asm17-moving-agent/cleany/docs/presentation-design/references/reference-03-blue-ir-layouts.png

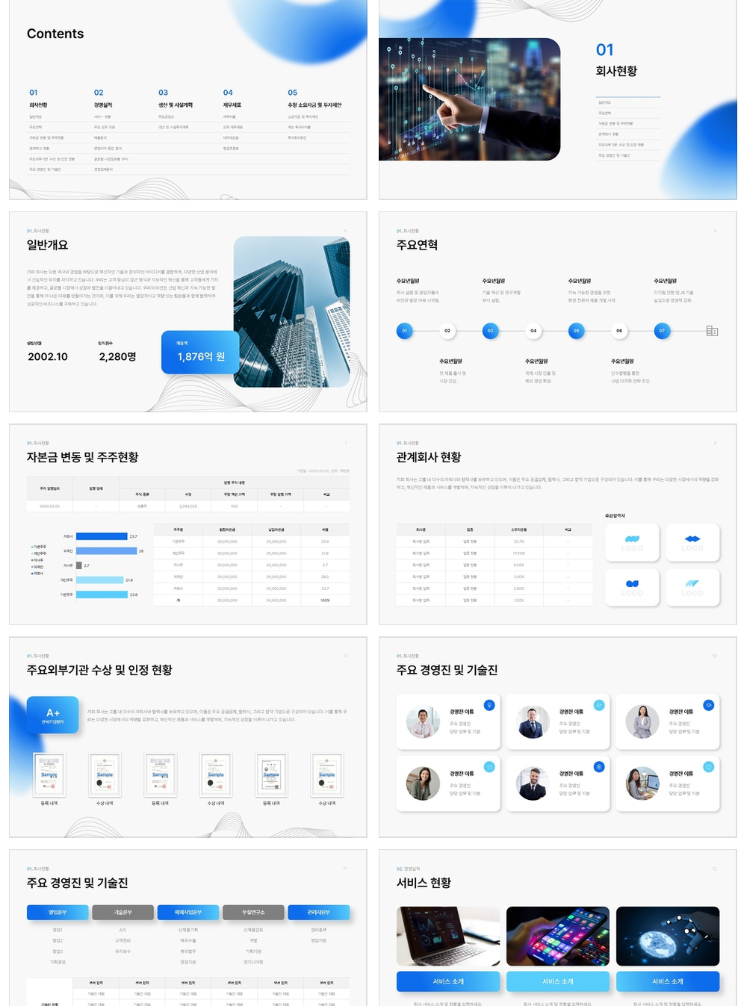
docs/presentation-design/references/reference-03-blue-ir-layouts.png
