asm17-moving-agent/cleany/docs/presentation-design/references/reference-01-blue-editorial.jpg

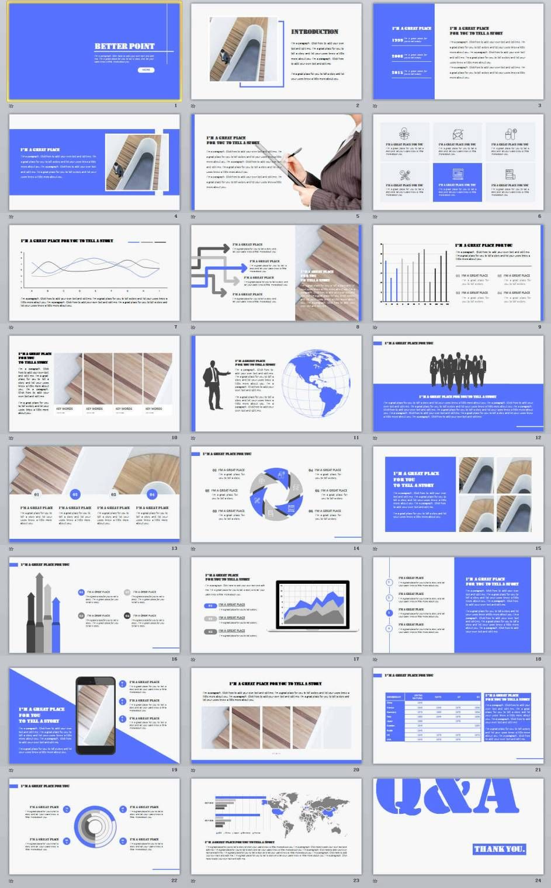
docs/presentation-design/references/reference-01-blue-editorial.jpg
