asm17-moving-agent/cleany/motor_controller/README.md

# ESP32-S3 motor and IMU hardware tests

The normal PlatformIO firmware entry point is `src/main.cpp`. Hardware checks
are independent Unity applications under `test/`, so a test runs only when it
is explicitly selected with `pio test`.

The PlatformIO environment targets the ESP32-S3-DevKitC-1-N32R16V with 32 MB
octal flash and 16 MB octal PSRAM. Firmware and hardware tests use ESP-IDF;
the Arduino framework is not required.

The environment uses PlatformIO's official `esp32-s3-devkitc-1` board
template. `platformio.ini` and `sdkconfig.defaults` supply the N32R16V memory
overrides. The `dout` image-header mode is intentional: the ESP32-S3
bootloader switches the detected octal flash to OPI mode.

## Motor web interface

The normal firmware creates the `Cleany` Wi-Fi access point with password
`ASM_2026`. Connect to it and open `http://192.168.4.1/`. The left side of the
page has press-and-hold controls for forward, backward, left, right, clockwise,
and counterclockwise motion using X-configuration mecanum mixing. It also has
signed PWM controls for each motor. The right side graphs live quadrature
counts from encoders 1–4. The board layout is:

```text
          FRONT
    M1 FL       M2 FR
    M4 RL       M3 RR
```

Motor numbering proceeds clockwise from M1 at front-left. M1 and M4 direction
polarity is inverted in firmware to match the installed wheel orientation;
M2 and M3 use normal polarity. Encoder polarity is calibrated separately so
positive measured velocity matches a positive logical wheel command. Verify
all wheel directions and measured velocity signs with the robot lifted before
driving it. Each active motor must receive the browser's 250 ms heartbeat and
is stopped by the firmware after 750 ms without a command.
Motor commands pass through a 5 ms, 1%-per-tick slew-rate limiter, taking about
500 ms from 0 to 100%. This limiter is applied to the final PI-controlled PWM
output, so feedback correction cannot bypass the motor-protection rate limit.
A direction change ramps to zero and waits until
encoder feedback remains below 0.5 rad/s for 50 ms before changing `DIR`.
Releasing a drive button uses this controlled stop. The `STOP ALL` button,
command watchdog, and Wi-Fi disconnect retain an immediate electrical brake for
fail-safe operation. GPIO assignments come from [`PINMAP.md`](PINMAP.md).

Each ramped percentage command is mapped to a target output-shaft velocity,
where 100% currently means 10 rad/s. A per-wheel feed-forward plus PI loop
uses an 11 rad/s measured no-load feed-forward scale and encoder feedback to
produce the applied PWM percentage. The initial
controller values (`Kp=6`, `Ki=6`) are hardware response-calibrated baseline
gains, not a substitute for loaded-floor validation. Verify encoder polarity
with the robot lifted before loaded driving.

The web debug panel displays a selectable motor's requested, rate-limited, and
measured velocity response over the latest 20 seconds. Its table also shows
encoder counts, tracking error, final PWM, and controller state for every
motor.
The same values are available from `/api/status` as `encoders`, `target`,
`applied`, `target_rad_s`, `commanded_rad_s`, `omega_rad_s`, and
`reverse_waiting`. Velocity conversion uses 3172 quadrature counts per output
revolution (13 PPR, 4x decoding, 61:1 reduction).

## USB serial control and calibration

The USB Serial/JTAG port provides motor control and telemetry without changing
the host's network connection. The COBS-framed, CRC-protected binary Jetson
interface, including wheel telemetry and the reserved MPU6050 frame, is specified in
[`SERIAL_PROTOCOL.md`](SERIAL_PROTOCOL.md). The following newline-terminated
commands remain available for manual commissioning only:

```text
HELP
STATUS
MOTOR <1-4> <-100..100 percent>
VELOCITY <1-4> <-10..10 rad/s>
MOVE <1-4> <-10..10 rad/s> <0.5..6 rad>
MOVE ALL <-10..10 rad/s> <0.5..6 rad>
TRACE <1-4> <20..1000 ms>
TRACE ALL <50..1000 ms>
TRACE STOP
STOP
```

`MOVE` is intended for response calibration. `MOVE ALL` drives all wheels in
the same logical direction to avoid the wheel slip caused by running one wheel
against three stationary wheels. Each wheel commands an immediate electrical
stop at its encoder threshold or after five seconds. Firmware places that
threshold 0.25 rad before the requested limit to reserve room for control-loop
and mechanical stopping latency; physical coasting still depends on load and
surface and is not a position-control guarantee. `TRACE` emits CSV-like
`CLEANY_TRACE` records containing timestamp, motor, encoder count, requested
velocity, rate-limited velocity, measured velocity, PWM, and bounded-move
state. `STOP` remains an immediate stop.

Firmware boots in manual commissioning mode. A binary frame's leading NUL byte
switches the serial receiver into binary mode until reboot, preventing binary
payload bytes from being misinterpreted as manual commands.

Build and upload the non-test firmware with PlatformIO isolated by `uv`:

```bash
uvx --with pip --from platformio pio run -d motor_controller
uvx --with pip --from platformio pio run -d motor_controller --target upload \
  --upload-port /dev/serial/by-id/usb-Espressif_USB_JTAG_serial_debug_unit_90:E5:B1:D5:3F:34-if00
uvx --with pip --from platformio pio device monitor -d motor_controller \
  --port /dev/serial/by-id/usb-Espressif_USB_JTAG_serial_debug_unit_90:E5:B1:D5:3F:34-if00 \
  --baud 115200
```

## Editor tooling

Generate the clangd compilation database after dependencies or build flags
change:

```bash
pio run -e esp32-s3-devkitc-1-n32r16v -t compiledb
```

The project-local `.clangd` configuration and compilation database provide
ESP32-S3 completion and diagnostics without editor-specific configuration.

Run the host-side command-filter check without attached hardware:

```bash
c++ -std=c++17 -Wall -Wextra -Werror -pedantic \
  -Imotor_controller/src \
  motor_controller/tests/motor_command_filter_test.cpp \
  -o /tmp/motor_command_filter_test &&
  /tmp/motor_command_filter_test
```

Run the host-side velocity-controller check:

```bash
c++ -std=c++17 -Wall -Wextra -Werror -pedantic \
  -Imotor_controller/src \
  motor_controller/tests/wheel_velocity_controller_test.cpp \
  -o /tmp/wheel_velocity_controller_test &&
  /tmp/wheel_velocity_controller_test
```

Run the host-side binary protocol codec check:

```bash
c++ -std=c++17 -Wall -Wextra -Werror -pedantic \
  -Imotor_controller/src \
  motor_controller/tests/serial_protocol_test.cpp \
  -o /tmp/serial_protocol_test &&
  /tmp/serial_protocol_test
```

## Hardware tests

Run both suites in sequence with PlatformIO port auto-detection:

```bash
uvx --with pip --from platformio pio test -d motor_controller \
  -e esp32-s3-devkitc-1-n32r16v
```

If the board was left disconnected by an older test build, perform the
BOOT/RESET upload sequence once before running this command. Test builds from
this project keep the USB Serial/JTAG console active between suites, so
subsequent uploads should not require that sequence.

Set the connected board port once:

```bash
CLEANY_ESP_PORT=/dev/serial/by-id/usb-Espressif_USB_JTAG_serial_debug_unit_90:E5:B1:D5:3F:34-if00
```

Run only the motor test:

```bash
uvx --with pip --from platformio pio test -d motor_controller \
  -e esp32-s3-devkitc-1-n32r16v -f test_motor \
  --upload-port "$CLEANY_ESP_PORT" --test-port "$CLEANY_ESP_PORT"
```

The motor test uses encoder A on GPIO4, encoder B on GPIO3, direction on
GPIO10, and PWM on GPIO11. It ramps to 50% duty, runs for at most three
seconds, and ramps down before reporting whether 793 encoder counts were
reached. The motor supply, driver, encoder, and development board must share
ground.

Run only the MPU6050 test:

```bash
uvx --with pip --from platformio pio test -d motor_controller \
  -e esp32-s3-devkitc-1-n32r16v -f test_imu \
  --upload-port "$CLEANY_ESP_PORT" --test-port "$CLEANY_ESP_PORT"
```

Connect MPU6050 VCC to 3V3, GND to GND, SDA to GPIO8, and SCL to GPIO9. The
test accepts address `0x68` or `0x69`, checks `WHO_AM_I`, wakes the device,
and reads a complete accelerometer, temperature, and gyroscope frame.

The project-local `test/unity_config.h` leaves the ESP-IDF USB Serial/JTAG
console active after `UNITY_END()`. This allows PlatformIO to upload the next
test suite without another manual BOOT/RESET sequence.

## KiCad symbol and footprint

The KiCad project is
[`pcb/motor_controller.kicad_pro`](pcb/motor_controller.kicad_pro). Its
project-local library tables register Espressif's official
ESP32-S3-DevKitC symbol and footprint as
`PCM_Espressif:ESP32-S3-DevKitC`. The vendored source revision, mechanical
drawing used for verification, and license are recorded in
[`libraries/README.md`](libraries/README.md).
