asm17-moving-agent/cleany/configs/robot/README.md

# robot configs

로봇, 센서, frame, workspace, safety limit 관련 설정을 둔다.

## 메카넘 base

- `base_hardware.yaml`: 사용자 확인 geometry는 휠 직경 127 mm, 앞뒤 휠 중심 간
  350 mm, 좌우 휠 중심 간 610 mm다. 바퀴를 띄운 초기 시험용으로 x/y 입력 상한
  0.5 m/s, yaw 1 rad/s, 휠 10 rad/s와 `cmd_vel` timeout 0.3초를 사용한다.
  입력 축별 상한과 휠 상한은 각각 지정된 값이다.
  휠 비율 scaling으로 복합 명령에서도 각 휠 상한을 지킨다.
  바닥 주행에는 하중과 정지 성능을 검증한 별도 제한값을 사용한다.
- `base_synthetic.yaml`: 장치 없는 mock 테스트용 합성 profile. `mock:=true`에서만
  사용하며 실물 설정의 기본값으로 복사하지 않는다.

두 profile 원본은 `cleany_base_driver` package share에 설치된다. 같은 geometry를
driver 역기구학과 wheel odometry에 전달한다. 필드, launch와 검증 방법은
[`cleany_base_driver` README](../../ros2_ws/src/cleany_base_driver/README.md)를 따른다.
