asm17-moving-agent/cleany/ros2_ws/src/cleany_moveit_config/README.md

# cleany_moveit_config

MoveIt 2 configuration shared by Cleany's left and right arms. The package
uses the authoritative URDF from `cleany_description`; it does not copy robot
geometry, link names, joint names, or hard limits.

The description now includes the CAD chassis, battery proxy, and wheel
collision geometry. The real-backend expansion disables head and movable
wheel joints (`include_head_camera:=false include_wheel_joints:=false`),
retaining wheel geometry while preserving the 12-joint arm/gripper state
contract. Arm anchors follow the CAD dimensions; named poses and external
collision scenes must be revalidated for the new geometry.

## Planning contract

| Group | Chain | Controller |
|---|---|---|
| `left_arm` | `base_link` -> `left_gripper_frame` | `left_arm_controller` |
| `right_arm` | `base_link` -> `right_gripper_frame` | `right_arm_controller` |
| `left_grasp_arm` | `base_link` -> `left_grasp_tcp` | plan-only |
| `right_grasp_arm` | `base_link` -> `right_grasp_tcp` | plan-only |

Each group contains only its five arm joints. Gripper joints and the mobile
base are not planning-group joints. Both groups use
`kdl_kinematics_plugin/KDLKinematicsPlugin` with `position_only_ik: true`, so
the target position and the complete arm seed determine the resolved joint
configuration; target orientation is not constrained by IK.

Grasp groups share the same five active joints as their corresponding arm
group and extend the chain only through the fixed `*_grasp_tcp_joint`.

The named states `left_home` and `right_home` set all five corresponding arm
joints to `0.0 rad`. The SRDF collision matrix disables only direct
parent/child pairs. Non-adjacent arm/base pairs and all left/right cross-arm
pairs remain collision checked.

The production controller contract is:

```text
/left_arm_controller/follow_joint_trajectory
/right_arm_controller/follow_joint_trajectory
```

Both actions use `control_msgs/action/FollowJointTrajectory`. An active robot
backend must also publish all arm and gripper state on `/joint_states`.

## Fixed hand-eye collision scene

The fixed calibration table, target stand, and ChArUco backing are defined in
`config/handeye_collision_objects.yaml` using the
`cleany.moveit_collision_objects/v1` schema. Every box has a full-extent
dimension and an explicit `primitive_pose` in `base_link`; no unused
top-level `CollisionObject.pose` is assumed.

After `move_group` is running, apply the scene once with:

```bash
ros2 launch cleany_moveit_config handeye_collision_scene.launch.py
```

The applier calls `/apply_planning_scene` and exits only after MoveIt accepts
all three object IDs: `handeye_table`, `handeye_target_stand`, and
`charuco_target`. The generic `move_group.launch.py` does not inject these
hand-eye-only objects automatically.

The RGB-D pick demo table is separately defined in
`config/pick_demo_collision_objects.yaml`, with the same full size and pose as
`rgbd_pick_demo.xml.in`. Box/can targets are registered dynamically by the
reachable-grasp action instead of this fixed scene.

## Launch

Start only `move_group` against an already active robot backend and
`robot_state_publisher`:

```bash
ros2 launch cleany_moveit_config move_group.launch.py use_sim_time:=false
```

Start the self-contained `ros2_control` mock backend, both trajectory
controllers, `robot_state_publisher`, `move_group`, and optionally RViz:

```bash
ros2 launch cleany_moveit_config mock_planning.launch.py use_rviz:=true
```

The mock backend is a planning/configuration test fixture only. It is not the
MuJoCo calibration backend and must not be used as a physical robot driver.

## Verification

Build and run this package's tests in the native ROS 2 Humble environment:

```bash
source /opt/ros/humble/setup.bash
cd ros2_ws
colcon build --symlink-install --packages-up-to cleany_moveit_config
source install/setup.bash
colcon test --packages-select cleany_moveit_config
colcon test-result --verbose
```

The static contract test checks the SRDF chains and homes, conservative
self-collision policy, position-only KDL settings, URDF limit parity, and
controller joint ownership. It also checks collision geometry/message parity.
The runtime smoke tests launch the headless mock
stack, verifies the all-zero state is collision-free, resolves position-only
IK for each side, confirms orientation does not change the same seeded IK
request, plans/executes each resolved joint goal through its side-specific
controller, and query MoveIt after applying the fixed hand-eye world objects.
