asm17-moving-agent/cleany/docs/EVIDENCE.md

# 실행 원본 색인

현행 사용법은 [실행](RUNNING.md), [테스트](TESTING.md), [연동](INTEGRATION.md) 가이드를 따릅니다. 실행 원본의 기본 데이터 루트는 `../cleany-data`이며 `CLEANY_DATA_ROOT`로 변경합니다. Clone에 포함되지 않은 외부 fixture, asset은 별도로 전달받고 hash를 확인합니다.

과거 pass 수, RTF, 결과는 기록 당시 버전의 근거입니다. 현재 버전의 검증 결과는 새 실행으로 확보합니다.

## 운영 UI 제안과 승인 흐름 PR 검증 (2026-11-11)

`aab901be`를 Jetson Ubuntu 22.04 ARM64, ROS 2 Humble의 격리 설치에서 검증했다.
`make test-operator-workflow`는 ROS opt-in을 켠 합성 관측, 가짜 Action과 Service로
228개를 통과했다. 실행기 lifecycle과 런타임 도구 102개도 통과했고 관련 ROS 패키지
6개를 별도 경로에 빌드했다. macOS에서 같은 프런트엔드의 TypeScript 검사와
Vite 빌드, Playwright 운영 흐름 10개가 통과했다.

초기 구형 설치의 메시지 및 native BT 모듈 누락은 새 interfaces와 BT 설치로 해결했다.
추가한 legacy 수동 런타임 helper의 즉시 로딩 때문에 함수만 복사하는 fixture가 실패한
문제는 수동 런타임 종료 시에만 로딩하도록 수정했다. 최종 검사는 위 결과다.
실물 모터와 카메라, Gemini API는 사용하지 않았다. UI 그림은 합성 제안 데이터를
실제 UI에 표시한 화면이며 실물 수거 성공 근거와 구분한다.
원본 로그와 최종 commit은 `/home/cleany/cleany-data/reports/pr-publication-20261111/`에 보관한다.

### PR 78 공통 CI 오류 수정 검증 (2026-11-12)

`9f18b332`에 이 변경의 Pillow 호환 코드와 BT CTest 300초 제한을 적용했다.
CI에서 Pillow 9.0.1의 `Image.Resampling` 부재로 증거 이미지 생성이 실패했고,
BT 전체 수트는 기본 60초 제한에 걸렸다. 개별 Action 응답과 종료 제한은 유지했다.
Jetson Ubuntu 22.04 ARM64, Humble, Python 3.10, pytest 6.2.5와 Pillow 9.0.1에서
관련 7개 패키지의 colcon 검사 3,813 reported tests가 실패 없이 끝났다(skip 46).
BT 785개는 약 94초에 통과했다. 별도 ROS opt-in 운영 흐름 검사는 228개가 통과했다.
macOS의 타입 검사와 웹 빌드, Playwright 46개도 통과했고 외부 서버 검사 3개는 제외했다.
입력은 저장소 설정, 합성 관측과 가짜 ROS 서버다. 실물 구동은 하지 않았다.
로컬 BehaviorTree.CPP 4.10.0과 CI의 4.9.1, ARM64와 amd64 환경 차이는 남아 있다.
환경, 소스 패치, 초기 빌드 실패와 최종 로그, JUnit 원본은
`/home/cleany/cleany-data/reports/pr78-local-validation-20261112/`에 보관한다.
웹 검사 원본은 `/Users/hyeon/.codex/reports/cleany-pr78-local-20261112/`에 있다.

## PR 65 Feetech 패키지 통합 검증 (2026-11-05)

PR 65의 `4427480d`에 Feetech 라이브러리를 `cleany_robot_interface`로 옮긴
패치를 적용했다. Ubuntu 22.04 ARM64 컨테이너에서 ROS 2 Humble,
ros2_control 2.54.3, MoveIt 2.5.10과 Feetech SDK 1.0.0으로 검사했다.

`make build-jetson-control`로 5개 패키지를 빌드했다. 새 설치에서 기존 플러그인
ID 등록, Python 실행 파일 6개, 설정 2개와 launch 인자 조회 3개를 확인했다.
패키지의 C++ 드라이버 검사 11개와 Python 검사 118개, 실물 프로파일과 호스트
도구를 포함한 `make test-jetson-control` 검사 178개가 통과했다. 검사에는
저장소의 합성 프로파일과 가짜 버스를 사용했다.
`make test-jetson-controller`는 설치된 C++ 플러그인과 ROS 컨트롤러를
가상 시리얼에 연결해 21개 검사를 통과했다. 실물 모터는 연결하지 않았다.

초기 환경에서 MoveIt perception, `fuser`와 Pillow가 누락되어 설치했고,
컨테이너의 메모리 한도로 중단된 병렬 빌드는 순차 실행으로 완료했다.
패치, 환경, 로그와 JUnit 원본은
`CLEANY_DATA_ROOT/reports/pr65-feetech-library/`에 보관한다.

## PR 65 main 충돌 해소 검증 (2026-11-02)

기존 #65 `db4ebed`에 main `c50c440`을 병합했다. `.gitignore`와 보정, 개발환경,
실행, ROS 색인 문서 4개의 충돌에서 실물 제어와 디스플레이, ToF 내용을 유지했다.
`/output/` 규칙이 디스플레이 산출물도 포함하므로 중복된 하위 경로 규칙은 제거했다.
main 대비 기능 변경 81개 파일과 Makefile 추가 명령은 기존 #65와 동일하다.

macOS Python 3.12의 별도 venv에서 가짜 버스와 합성 설정으로 제어 및 호스트 도구
107개, 상위 상태와 복구 52개, ToF core 91개 검사가 통과했다. CI 도구 9개도
통과했으며 제어 및 호스트 도구 107개에 포함된 검사다. 최초 누락된 Python 의존성은
검증 venv에 설치했다. SDK 가상 시리얼 1개는 macOS PTY의 1 Mbps ioctl이 지원되지
않아 실패했으며, 해당 검사를 제외한 로컬 재실행 결과를 위에 기록했다. 테스트는 유지했다.
Jetson 이름 해석이 되지 않아 native ROS 빌드, C++와 ROS 연결 검사는 재실행하지 않았다.
충돌 표식, 문서 링크, output 제외와 기능 변경 보존을 별도로 확인했다.
원본 로그와 병합 검사는 `/Users/hyeon/workspace/cleany-data/reports/pr65-main-20261102/`에 보관한다.

### 하드웨어 매핑 병합 후 재검증

main에 #70이 추가된 뒤 `102a63e`에서 main `32d2d9e`를 반영했다. 개발환경,
실행과 ROS 색인 문서 3개의 충돌은 양쪽 절을 모두 유지해 해결했다.

직전 GitHub CI run `41376624141`은 Feetech SDK 1.0.0 설치에는 성공했지만
rosdep이 `feetech-servo-sdk==1.0.0`의 설치 완료를 인식하지 못해 의존성 이미지
단계에서 실패했다. `102a63e`에 이 절과 함께 반영한 수정은 rosdep에 패키지
이름을 지정하고 CI constraints로 버전 1.0.0을 유지한다. macOS Python 3.12,
rosdep 0.27.0과 실제 설치된 SDK로 기존 규칙의 감지 실패와 수정 후 성공을
재현했으며, constraints를 적용한 pip dry-run도 같은 버전을 확인했다.

합성 입력과 가짜 transport를 사용한 매핑과 조종 Python 검사 60개, Node 입력
검사 17개와 `make test-ci-tools` 9개가 통과했다. Make의 login shell이 macOS
시스템 Python을 선택해 pytest를 찾지 못한 뒤, 동일 Python 검사 목록을 venv에서
직접 실행했다. Linux `/proc` 기반 PID 재사용 검사는 macOS에서 실패했으며,
해당 1개를 제외한 재실행 결과가 60개다. 검사 코드는 변경하지 않았다.
Jetson 이름 해석 실패와 로컬 Docker daemon 부재로 native ROS 빌드와 전체
workspace 검사는 재실행하지 않았다. CI 결과와 실물 동작 검증은 별도다.

원본 실패, 재실행 로그와 rosdep 감지 결과는
`/Users/hyeon/workspace/cleany-data/reports/pr65-main-20261102/recheck/`에 보관한다.

## CI snapshot 접속 장애 우회 검증 (2026-11-11)

PR 77, 78, 79의 CI는 Ubuntu snapshot의 DNS 또는 연결 timeout 때문에
의존성 이미지 생성 단계에서 실패했다. PR 77과 78은 재실행도 같은 결과였다.
소스 빌드와 테스트는 시작하지 못했다.

정상 실행 `a6b46068`의 CI run `42764509711`에서 사용한 GHCR 이미지를 digest로
고정하고 현재 설치 설정의 fingerprint와 비교한다. 설치 스크립트, 저장소 snapshot,
Python 버전 및 rosdep 규칙이 같아야 후보로 선택한다. 현재 manifest의 설치 의존성과
현재 버전 검사까지 후보 안에서 통과해야 재사용한다. 후보가 없거나 조건이 다르면
기존 snapshot 기반 이미지 생성을 수행한다. 전체 응용 빌드와 테스트는 생략하지 않는다.

macOS의 `make test-ci-tools` 31개가 통과했다. 가짜 Docker로 동일 key 적중,
검증 후 재사용, 의존성 불일치와 실제 빌드 실패의 전파를 확인했다.
설치 설정 fingerprint는 위 정상 실행 commit과 같음을 별도로 확인했다.
실제 이미지 재사용과 workspace 검사는 수정 commit의 GitHub PR checks에서 확인한다.
로그, 원본 실패와 commit 식별자는
`/Users/hyeon/.codex/reports/cleany-ci-fix-20261111/`에 보관한다.

## 과거 생성 보고서 보관

날짜별 MuJoCo 성능, 수거 시험 보고서와 SCRUM-486 검증 JSON은
`CLEANY_DATA_ROOT/reports/evidence/` 아래 원래 상대 경로로 보관합니다.
새 실행 산출물은 Git에서 제외하고 commit, 환경, 입력, 실패와 원본 위치를 남깁니다.

## 운영 UI와 승인 흐름 E 분리 검증 (2026-10-31)

원격 PR 68 `167292ef`에 원본 `94c0fcd`의 운영 UI, 제안과 승인, 대상 재확인,
상태와 로그 변경을 미커밋 패치로 분리했다. 기존 분류 사유 계약을 재확인 응답에 유지했다.
독립 IO 계측기, TCP와 LeRobot 도구는 포함하지 않았다.

Jetson Ubuntu 22.04 ARM64와 ROS 2 Humble에서 별도 경로로 변경 패키지 4개를
빌드했다. #68의 설치 환경을 underlay로 사용했으며 변경 모듈, FK 재사용 모듈과
설치된 웹 자산의 source hash가 일치했다. 합성 ROS, 가짜 모션 포트와 테스트 프로필로
운영 UI, Logger와 재확인 검사 225개, 기존 인식과 수거 회귀 4,013개가 통과했다.
두 묶음에는 재확인 검사 19개가 겹친다. RealSense 장치 검사 1개는 실행 조건 미지정으로 제외했다.

macOS, Node 26.5.0, pnpm 11.25.0에서 고정 lockfile로 웹을 빌드하고 Playwright
1.63.0 Chromium fixture 검사 45개를 통과했다. 실제 Monitor, 리소스 서버와 Gazebo
연결 검사 3개는 입력 서버를 준비하지 않아 제외했다. 데스크톱, 좁은 화면과 라이트,
다크 화면을 확인했다. 실물 모터, 실제 인식 모델과 전체 workspace 검사는 실행하지 않았다.

첫 검사는 새 RevalidateTarget 빌드 전 import, 합동 pytest의 fixture 검색 경로,
Jetson에 없는 dwb_msgs와 로컬 Chromium 때문에 실패했다. 새 인터페이스를 빌드하고
Make의 fixture 경로를 보완했다. dwb_msgs와 nav_2d_msgs는 ROS 공식 deb를 검증 전용
경로에 풀었고 Playwright browser를 설치한 뒤 다시 통과했다. 시스템 ROS는 변경하지 않았다.

현재 #68 기준 패치와 선행 PR을 포함한 main 기준 패치를 임시 index에 적용해 충돌이
없음을 확인했다. 원본 작업 트리, output 448개와 기존 C, D 작업 트리는 hash와
Git 상태 비교로 보존을 확인했다. 실행 명령, 초기 실패와 최종 JUnit, 소스 패치,
설치 확인, 병합 검사와 화면 근거는
`/home/cleany/cleany-data/reports/pr-e-operator-20261031/`에 보관한다.

## 실물 수거 실행과 복귀와 복구 D 분리 검증 (2026-10-31)

PR 67 `76039e2`에 원본 `94c0fcd`의 수거 실행, 팔 복귀와 복구 변경을
미커밋 패치로 분리했다. Jetson Ubuntu 22.04 ARM64, ROS 2 Humble과 MoveIt 2.5.9에서
별도 build/install/log 경로와 C 검증의 테스트 venv를 사용했다.
입력은 저장소 모델, 테스트 프로필, 합성 ROS 상태와 가짜 모션 포트다.

14개 패키지의 새 빌드, Python 4,091개와 vision 실행 연결 35개 검사가 통과했다.
실제 BehaviorTree.CPP runner와 가짜 ROS Action/Service를 연결해 취소, 종료,
통신 fault, 팔 복귀와 복구 차단을 확인했다. launch 인자 2개와 새 인터페이스 4개의
설치를 확인했고, `collection_pipeline`의 설정 검사에서는 모션을 요청하지 않았다.
RealSense 장치 검사 1개는 실행 조건을 지정하지 않아 제외했다.
실물 모터, 카메라, Gemini API와 전체 수거 시나리오, 전체 workspace 검사는 실행하지 않았다.
GPU 구현은 변경하지 않았고 실제 CUDA 검사를 반복하지 않았다.

첫 빌드에서 BehaviorTree.CPP 경로가 누락되어 실패했다. 이미 설치된 4.10.0의
CMake와 라이브러리 경로를 해당 검증 환경에 지정한 뒤 새 경로에서 다시 빌드했다.
첫 전체 검사에서는 제거한 복귀 보정 설정과 구형 clamp API를 참조하던 9개가 실패했다.
구형 전용 검사를 정리하고 기존 관절 범위와 역재생 회귀 검사를 유지했다.
관련 647개 집중 검사와 전체 검사를 다시 통과했다.

소스 패치, 실행 명령과 환경, 초기 실패와 최종 JUnit, 설치 확인,
#67 및 main 가상 병합과 원본과 output 보존 비교는
`/home/cleany/cleany-data/reports/pr-d-collection-20261031/`에 보관한다.
원본 브랜치와 작업 트리, output 197개 파일과 C 작업 트리는 변경하지 않았다.

### D 미사용 옵션과 중복 검사 정리 검증 (2026-10-31)

동일한 PR 67 `76039e2` 기준의 D 미커밋 패치에서 사용하지 않는 추가 하강 검색
옵션과 상태값을 제거했다. 높이 검색의 전체 궤적 복사를 없애고, 복귀 경로 검증이
동일한 궤적을 반환할 때 시간 계산 결과를 재사용한다. 장면 검증은 생략하지 않는다.
후속 테스트 정리에서는 중복 replay 환경과 설정 조합을 줄이고 공통 fixture를
재사용해 테스트 936줄을 줄였다. 복귀 준비 정리 검사는 기존 복귀 파일로 옮겼다.
실행 코드와 충돌, 취소, 증거 확인, 복귀 실패 및 복구 차단 검사는 유지했다.

같은 Jetson의 ROS 2 Humble 환경에서 `make test-collection-execution`의 관련 검사
1,943개와 `make test-collection-regression`의 전체 모션 및 수거 회귀
3,986개가 통과했다. 두 결과의 검사는 중복되므로 합산하지 않는다.
RealSense 검사 1개는 장치 실행 조건 미지정으로 제외했다. 테스트 통합의 첫 실행에서
보조 함수에 위치와 키워드 인자를 중복 전달한 2개가 실패했고, 호출 계약을 맞춘 뒤
집중 검사와 위 두 검사를 통과했다. 인터페이스와 빌드 설정은 바뀌지 않아 앞 절의
14개 패키지 빌드를 사용했다. 실제 모터, 카메라, Gemini API와 전체 workspace 검사는
실행하지 않았다.

앞선 구현 최적화 검증에서는 합성 복귀 경로의 시간 계산이 3회에서 2회로 줄고,
장면 검증은 1회로 같았다. 높이 검색은 150개 합성 입력에서 기존과 같은 절단 시점을
반환했다. 초기 overlay import 실패와 수정 후 결과는
`/home/cleany/cleany-data/reports/pr-d-cleanup-20261031/`에 보관한다.
후속 테스트 정리의 소스 패치, 제거 항목과 유지 검사 대응표, 실행 환경, 초기 실패,
최종 JUnit과 원본 및 output 보존 비교는
`/home/cleany/cleany-data/reports/pr-d-test-trim-20261031/`에 보관한다.

### D 실측 FK 재사용 검증 (2026-10-31)

PR 68의 `926ef20`에 실측 FK 재사용 변경만 추가했다. Jetson Ubuntu 22.04 ARM64,
ROS 2 Humble에서 별도 작업 트리와 build/install/log 경로를 사용했다.
입력은 합성 관절 상태, 가짜 FK 응답과 기존 수거 실행 fixture다.
새 검사는 파일 하나의 8개 사례로 모았으며 동일 상태의 재사용, 관절과 모델 및 통신 복구에
따른 무효화, 링크 의존관계, 최신 상태 감시와 실패 응답 처리를 확인했다.

집중 검사 8개와 `make test-collection-execution` 1,951개가 통과했다.
집중 검사는 후자에 포함되므로 합산하지 않는다. 기존 D 의존 패키지 설치를 underlay로
사용해 `make build`로 `cleany_skill_executor` 한 패키지만 새로 빌드했고,
설치 환경의 두 변경 모듈이
검증 소스와 같은 hash임을 확인했다. 설치 확인의 첫 경로 검사는 `--symlink-install`의
build 경로를 허용하지 않아 실패했으며, 격리된 build 경로까지 확인하도록 고쳐 통과했다.
코드 검사와 빌드는 첫 실행에 통과했다. 실물 동작, 전체 workspace와 성능 재측정은 하지 않았다.

기준 commit, 소스 패치와 hash, 실행 환경과 명령, JUnit, 설치 확인과 기존 작업 트리 보존
결과는 `/home/cleany/cleany-data/reports/pr68-fk-reuse-20261031/`에 보관한다.

### #67 반영 후 수거 실행 검증 (2026-11-05)

`8436eac6`에서 #67 `8bd3273a`를 반영하고 실행과 ROS 색인 문서의 충돌을
해결했다. 같은 Jetson Ubuntu 22.04 ARM64와 ROS 2 Humble의 격리 경로에서
14개 패키지를 증분 빌드했다. 새로 생성한 ROS 메시지의 계약 검사 18개와
합성 상태, 가짜 모션 포트를 사용한 수거, 복귀, 복구 검사 1,951개가 통과했다.
실패와 제외는 없었다. 실물 모터는 사용하지 않았다. 로그와 JUnit은 데이터
루트의 `reports/pr67-68-sync-20261105.dhC9bX/`에 보관한다.

## 실물 파지 계획과 실행 C 분리 검증 (2026-10-30)

`94c0fcd`의 실물 계획과 실행 기반을 `bfe0f89`에 미커밋 패치로 분리했다.
기준은 PR 66 `504b0c6`과 최신 PR 65 `db4ebed`의 병합이다.
Jetson Ubuntu 22.04 ARM64, ROS 2 Humble, MoveIt 2.5.9와 격리된 빌드 경로를 사용했다.
호스트 기하 검사는 별도 venv의 trimesh 4.5.3, SciPy 1.13.1로 실행했다.

13개 패키지 빌드, Python 2725개, C++ 83개, 기존 MoveIt 회귀 36개,
추가 MoveIt 런타임 7개와 가상 시리얼 controller 24개가 통과했다.
모션 컨테이너의 5개 패키지 준비와 입력 hash 확인, 실제 CUDA 검사 9개도 통과했다.
입력은 저장소 모델, 합성 장면과 가짜 추론 및 시리얼이다.
실물 카메라 검사 1개는 장치 실행 조건을 지정하지 않아 제외했다.
실제 모터, Gemini API와 전체 수거 흐름 및 전체 workspace는 검증하지 않았다.

최초 실행의 누락 의존성과 테스트 import 경로를 보완하고 후속 수거 흐름용 검사를 제외했다.
설정 변경 전의 테스트 기대값을 갱신했으며, ROS 로그 설정과 디버그 backtrace에 영향을
받던 경고 검사를 수정했다. 재시작으로 중단된 실행은 결과에 포함하지 않고 다시 실행했다.
중복 core 검사 18개 사례와 MoveIt 가짜 서비스 구현을 통합했고 기존 충돌 회귀 검사는 유지했다.

소스 패치, 입력 hash, 실행 명령, 초기 실패와 최종 JUnit, 병합 및 보존 비교는
`/home/cleany/cleany-data/reports/pr-c-motion-20261029T235707Z/`에 보관한다.
원본 작업 트리와 output 197개 파일, 기존 PR 66 작업 트리는 보존했다.

### C 미사용 구현 정리 검증 (2026-10-31)

동일한 `bfe0f89` 기준의 C 미커밋 소스에서 호출되지 않는 복귀 준비 캐시,
높이 보정과 역방향 경로 검색, 실험용 GPU 배치 경로 계획을 제거했다.
하이브리드 IK의 이전 비교용 재시도 옵션과 미사용 보조 함수, import도 정리했다.
삭제한 기능의 전용 검사를 제거하고 Cartesian 끝점 검사와 비동기 읽기 정리 검사는
기존 검사 파일로 옮겼다. 현행 파지 방향, 궤적 범위와 속도 검사는 유지했다.

같은 Jetson의 격리된 빌드와 테스트 venv에서 13개 패키지 재빌드,
Python 2,603개와 실제 CUDA 11개가 통과했다. RealSense 장치 검사 1개는 제외했다.
CUDA 검사는 FK/IK, 경로, mast 충돌과 양팔의 grasp/aim 예열 버퍼 재사용을 확인한다.
입력은 저장소 모델과 합성 상태이며 실물 모터와 Gemini API는 실행하지 않았다.
C++ 구현과 ROS 메시지 정의는 이번 정리에서 바뀌지 않았고 해당 검사는 위 분리 검증을 따른다.

최초 집중 검사에서는 제거한 기능의 전용 테스트 누락과 수정한 fixture의 속도 값 때문에
4개가 실패했다. 전용 검사와 fixture를 정리한 후 집중 검사와 전체 검사를 다시 통과했다.
정리 전후 소스 패치, 테스트 명령과 JUnit, 원본과 output 보존 비교는
`/home/cleany/cleany-data/reports/pr-c-cleanup-20261031/`에 보관한다.

### #66 반영 후 모션 기반 검증 (2026-11-05)

`6e0029dc`에서 #66 `e9d15a5e`를 반영하고 중복된 `controller_manager_msgs`
실행 의존성을 일반 의존성 선언 하나로 통합했다. Jetson Ubuntu 22.04 ARM64와
ROS 2 Humble의 별도 빌드 경로에서 13개 패키지를 빌드했다. 합성 입력과 가짜
서비스로 Python 검사 2,623개가 통과했고 RealSense 실물 검사 1개를 제외했다.
충돌과 직접 관련된 검사 45개는 이 수에 포함된다. 네이티브 검사 4개 패키지의
colcon 집계는 94개, 오류와 실패는 0개다. 실물 모터는 사용하지 않았다.
로그와 JUnit은 데이터 루트의 `reports/pr67-68-sync-20261105.dhC9bX/`에 보관한다.

## Jetson 제어 기반 분리 검증

`3dea85d`에 미커밋 정리 패치를 적용한 소스를 Ubuntu 22.04 ARM64,
ROS 2 Humble과 MoveIt 2.5.9에서 별도 빌드 경로로 검사했다.
`make build-jetson-control`은 6개 패키지 빌드, `make test-jetson-control`은
163개 검사를 통과했다. 실패와 skip은 없었다. 입력은 저장소의 고정 보정,
합성 상태와 가상 시리얼이며 실물 장치를 열지 않았다.
환경, 입력 소스를 식별하는 `changes.patch`, 로그와 JUnit 원본은
`/home/cleany/cleany-data/reports/pr-a-trim-20261029T185419Z/`에 보관한다.

### PR 65 미사용 설정 정리 검증 (2026-10-30)

갱신된 PR 64를 병합한 `197de90`에 이 절과 함께 반영한 정리 패치를 적용했다.
TCP와 중복 손목 보정 3개, 기본 Xacro가 사용하지 않는 미리보기 인자와
matplotlib 의존성을 제거했다. 기존 미리보기와 새 미리보기의 URDF hash는 같다.
Jetson Ubuntu 22.04 ARM64, Humble과 MoveIt 2.5.9의 새 경로에 6개 패키지를
빌드했고 삭제한 설정의 부재와 설치된 설정, launch 5개의 소스 일치를 확인했다.

`make test-jetson-control` 163개, `make test-jetson-controller` 21개와 C++ 드라이버
11개가 통과했다. 기존 제어 검사는 모두 유지했으며 실패와 skip은 없다.
가상 시리얼과 합성 입력만 사용했고 실물 모터와 전체 workspace 검사는 실행하지 않았다.
기존 Xacro 경고와 C++ 테스트의 write 반환값 경고는 유지된다.
소스 패치, 환경, 로그, JUnit과 설치 및 URDF 비교 근거는
`/home/cleany/cleany-data/reports/pr64-65-cleanup-20261029T233007Z/pr65/`에 보관한다.

## Nav2 복구 자료의 저장소 외부 보관

PR #73의 복구 자료 `recovered/nav2/`는 구현 코드와 분리해 데이터 루트의
`archives/pr73-recovery-cleanup-20261102-c978e838/recovered/nav2/`로 옮겼다.
이동 전 Git 기준은 `c978e838e9f9cca8afb1bb386fa7c960c47bfdb4`이며, 원본 출처와
검증 기록은 보관 디렉터리의 `README.md`, `INDEX.json`, `provenance/`에 있다.
활성 MPPI 구현과 설정은 `ros2_ws/src/cleany_navigation/`에 유지한다.

## PR #73 snapshot 다운로드 지연

`25b8eca28ad7f493087d68464385414203715a32`의
[CI 41379752233](https://github.com/asm17-moving-agent/cleany/actions/runs/41379752233)은
Ubuntu snapshot의 반복된 HTTP 502와 503으로 이미지 생성에서 33분 이상 경과해 중단했다.
코드 빌드와 테스트는 시작하지 않았다. 의존성 명령 재시도뿐 아니라 APT의 파일별 재시도가 누적됐다.
원본은 데이터 루트의 `reports/ci-dependency-pinning-20261102/pr73-ci-41379752233.log`다.

서명이 검증된 snapshot index의 SHA256과 크기를 유지하면서 동일 pool 파일을 archive 미러에서
먼저 받는 다운로드 도구를 추가했다. SHA256 또는 크기가 다르면 cache에 넣지 않으며 snapshot으로
돌아간다. 미러 index를 읽거나 버전을 변경하지 않는다. 설치 명령 다운로드 5분과 이미지 생성
15분 상한을 추가하고 APT 자체 재시도 1회, 명령 실행 최대 2회로 줄였다.
다운로드 도구와 기존 CI 도구의 자동 검사 24건이 통과했다. 고정 amd64 컨테이너에서
이전 실패 패키지 `libxrandr-dev`, `mesa-vulkan-drivers`, `python3-pip-whl`,
`python3-setuptools-whl`을 미러 다운로드와 SHA256 검증으로 재설치했다.
이후 버전 검사에서 Python 36개와 공통 ROS 311개가 계속 일치했다.
설치 로그는 같은 데이터 루트의 `pr73-combined/pr73-mirror-install.log`다.

## PR #73 통합 빌드의 병렬 제한과 MPPI 계약 검사

2026-11-02에 PR head `25b8eca28ad7f493087d68464385414203715a32`와 아래 수정 내용을
고정 의존성 amd64 이미지 `61625b7ef43b330932899ca41fa455e0570962dbc1549dba6ae221a583b160d0`에서 검증했다.
컨테이너는 CPU 3개 분량과 메모리 8 GiB로 제한했다. 첫 빌드에서는 colcon이
`CMAKE_BUILD_PARALLEL_LEVEL=2`에도 `-j12 -l12`를 주입해 MPPI 컴파일러 5개가 OOM으로 종료됐다.
`MAKEFLAGS=-j2 -l2`를 함께 전달한 뒤 28개 패키지가 빌드됐고 추가 OOM은 없었다.

통합 검사에서 이전 GoalDirectedController와 배포판 MPPI를 기대하던 assertion 6건이 실패했다.
기대 플러그인을 현재 Cleany MPPI로 갱신하고 Omni, 횡이동, footprint 비용과 Smac Lattice 조건을 확인했다.
검사를 제거하거나 제어 설정을 완화하지 않았다. 관련 검사 22건과 전체 2820 reported tests가
통과했다(errors/failures 0, 기존 skip 32). 별도 Nav2 synthetic ROS 실행 검사 3건,
Gazebo 센서/TF 실행 검사 1건과 motor core 검사도 통과했다.
실제 로봇 검증은 수행하지 않았다.

원본 로그는 데이터 루트의 `reports/ci-dependency-pinning-20261102/pr73-combined/`에 보관한다.

## CI 의존성의 Jetson 버전 기준

PR #73의 `20dae9af760e3212fbec8c0b5476ab73ff928d90`에서 실행한
[CI 41377740118](https://github.com/asm17-moving-agent/cleany/actions/runs/41377740118)은
이미지 생성 중 Ubuntu snapshot 서버가 패키지 4개에 HTTP 502를 반환해 실패했다.
`ros-humble-mujoco-ros2-control` 설치 단계에서 중단됐으며 코드 빌드와 테스트에는 도달하지 않았다.
고정 snapshot과 Python constraints를 유지한 채 APT 다운로드 재시도 및 의존성 준비 명령의 제한된 재시도를 추가했다.
원본은 데이터 루트의 `reports/ci-dependency-pinning-20261102/pr73-ci-41377740118-failed.log`다.

2026-11-02에 `jetson-orin`의 Ubuntu 22.04 arm64 system Python과 `dpkg-query -W`를 읽었다.
최종 검증 기준은 `c50c440540a7c5c4c0736635d9d122b4736b2a47`이며 변경은 `feat/ci-dependency-pinning` 작업 트리에서 검증했다.
실물의 패키지 설치와 설정은 변경하지 않았다.

ROS `2026-08-07` snapshot의 amd64와 arm64 package index 모두 Jetson의 ROS 패키지 388개와 upstream 버전이 일치했다.
아키텍처별 Debian 빌드 시각은 비교에서 제외했다. MuJoCo `3.11.0`과 google-genai `2.18.0`의 Python 의존성 36개를 조회해 constraints로 보존했다.
Ubuntu 저장소는 `20260807T000000Z` snapshot으로 고정했다. 이는 Jetson 전체 OS 패키지나 JetPack의 동일성을 뜻하지 않는다.

로컬 arm64 이미지 생성은 해당 ROS snapshot에 `ros-humble-ros-gz-sim`이 없어 실패했다.
같은 snapshot의 amd64에는 `0.244.25-1jammy.20260726.122251`이 있어 실제 CI와 같은 amd64에서 검증한다.
첫 amd64 생성은 베이스에 남은 TF2 `0.25.20` 등과 Jetson의 `0.25.22` 차이를 버전 검사에서 감지해 실패했다.
`rosdep install`이 이미 설치된 패키지를 갱신하지 않아, workspace 설치 전에 베이스 ROS 패키지를 snapshot으로 동기화하도록 수정했다.
재생성은 저장소의 SHA256과 대조한 APT 파일 캐시를 사용하며 workspace 빌드와 테스트 결과는 재사용하지 않는다.
첫 workspace 빌드는 BT.CPP `4.9.1`의 CMake export가 `lib/`에서 라이브러리를 찾지만 실제 파일은 `lib/x86_64-linux-gnu/`에 있어 실패했다.
같은 바이너리에 대한 호환 링크를 추가한 뒤 `cleany_manipulation_bt` 단독 빌드를 통과했다.
최종 검증은 amd64 Ubuntu 22.04, Python 3.10.12 컨테이너에서 새 workspace 빌드 디렉터리와 앞선 시도의 컴파일 캐시를 사용했다. 모든 테스트는 다시 실행했다.

초기 `326c237c` 기준의 24개 패키지 빌드와 2,561개 검사도 통과했다.
검증 도중 병합된 ToF와 Supervisor를 포함하도록 `c50c4405`에 동기화한 뒤 아래 전체 검사를 다시 실행했다.

| 검사 | 결과 |
|---|---|
| 의존성 이미지 생성과 버전 검사 | Python 36개, 공통 ROS 311개 일치 |
| `make test-ci-tools` | 13개 통과 |
| `make test`: 전체 빌드 | 27개 패키지 통과 |
| `make test`: workspace 검사 | 2,720개, 오류와 실패 0개, skip 32개 |
| `make test-motor-core` | 통과 |
| 합성 Navigation runtime | 3개 통과 |
| Gazebo sensor/TF runtime | 1개 통과 |

설치 버전, 이미지 ID와 dependency key는 원본의 `amd64-current/image.json`, `amd64-current/dpkg-packages.txt`, `amd64-current/pip-packages.txt`에 남겼다.

원본 Jetson 환경, package index, 이미지 빌드와 검사 로그는 데이터 루트의
`reports/ci-dependency-pinning-20261102/`에 보관한다.

## Jetson 실물 마운트와 카메라 보정

2026-10-21에 `jetson-orin:/home/cleany/cleany`의
`52e44abe89b7103bd832f3cbf806a121c37cb82c`와 미커밋 작업 내용을 읽어 선별했다.
프로파일은 [jetson_20261009](../ros2_ws/src/cleany_description/config/calibration/jetson_20261009/)
아래에 보존한다. [provenance.json](../ros2_ws/src/cleany_description/config/calibration/jetson_20261009/provenance.json)은
보정 원본, 사용한 내부 보정, 과거 검증 보고서의 경로와 SHA-256을 기록한다.
검증 지표와 실패 또는 미검증 조건은 각 extrinsics YAML과 [캘리브레이션 가이드](CALIBRATION.md)에 있다.
보고서 원본과 이미지 데이터셋은 Jetson의 기록된 위치에 남아 있다.

[mount.png](assets/physical-calibration/mount.png)는 사용자가 제공한 형상 렌더다.
`/Users/hyeon/Downloads/Jetson/mount.png`에서 원본 그대로 복사해 이전 PR 이미지를
교체했다. SHA-256은 `c36c8aff0047bbe3dd34ec6904da879269c4221d2dd68f64d0363cce8d5d9d8b`다.
실물 제어와 calibration 재수행의 증거로 사용하지 않는다.

### 2026-10-21 적용 검증

검증 코드는 `19f3882918f660fe580fe7f7fac0d8869d0a6331`이다.
Jetson Ubuntu 22.04, ROS 2 Humble, Python 3.10.12, MuJoCo 3.11.0의 별도
`/tmp/cleany-calibration-pr-20261021` workspace에서 실행했다.
`cleany_description`의 Git 추적 파일 100개가 해당 commit과 동일한지 hash로 확인했다.
빌드 대상은 description과 인접 MoveIt config 두 패키지이며 전체 workspace 검증은 아니다.

| 검사 | 결과 |
|---|---|
| 루트 `make build`, 별도 `CLEANY_BUILD_ROOT` | 두 패키지 빌드 통과 |
| `colcon test`: description 모델 정합성 | 46개 통과 |
| `colcon test`: 카메라 보정 프로파일 | 10개 통과 |
| MoveIt 설정과 collision 계약 | 18개 통과 |
| 기본 description launch | 명목 헤드 TF, 손목 보정 TF 미발행 확인 |
| `jetson_20261009` description launch | 보정된 헤드와 양손목 TF, RGB alias 5개 확인 |
| MoveIt mock 실행 | Pilz LIN plan-only 결과가 `ABORTED`여서 1개 실패 |

마지막 실패는 수정 전 `main`의 `d5a640a556d473b2a0af59932974b3b3b0aa4732`를
별도 workspace로 빌드해 동일 환경에서 재현했다.
`test_per_arm_position_ik_plan_and_execute`의 `_assert_pilz_lin_is_cartesian`에서
`status == 6`으로 실패하며 기대값은 `STATUS_SUCCEEDED == 4`이다.
이번 변경에서 실행기를 수정하거나 해당 검사를 생략하지 않았다.
Description launch 검사는 localhost 전용 ROS domain 212와 213에서 수행했고
실물 장치 명령은 전송하지 않았다.

원본 로그와 JUnit은 데이터 루트의
`reports/physical-calibration-20261021/`에 보관한다.
Jetson 원본 출력은 `/tmp/cleany-calibration-pr-20261021-output/`,
비교 기준 출력은 `/tmp/cleany-calibration-main-baseline-output/`이다.

### 2026-10-21 시뮬레이터 정합성 재검증

검증 코드는 `e5b26da2e077007003999d1abedb3b67447f6cba`다.
같은 Jetson 환경에서 `make build`로 두 패키지를 다시 빌드하고,
description의 모델 정합성 46개와 보정 프로파일 10개를 통과했다.
검사한 description 추적 파일 100개는 로컬 코드와 SHA-256이 일치한다.
두 URDF 모두 Jetson 모델의 마스트 간격 `0.05`를 유지하며,
`0.08`을 요청하면 오류로 거부하는 회귀 검사를 포함한다.

Gazebo의 `test_cad_frame.py` 6개도 통과했다. SDFormat 12.9.0과 스키마는
공식 ROS APT 패키지를 별도 `/tmp` 경로에 풀어 사용했다.
실제 URDF→SDF 변환 결과에서 RGB와 depth 센서의 위치 및 방향이
변경된 헤드 장착 형상과 TF metadata에 일치하는지 확인했다.
이 검증은 모델 변환 검사이며 Gazebo 동적 실행이나 실물 구동 검증은 아니다.
원본 로그와 JUnit은 데이터 루트의 `reports/pr58-fix-20261021/`에 보관한다.

### 2026-10-21 v8 손목 마운트 반영 검증

검증 코드는 `b6d52578f8e18f9a082cbb43cb2e56f6d8ebd902`다. Jetson의 같은
HEAD와 최신 미커밋 작업에서 v8 마운트만 선별했다. 메시 16개, 형상 JSON,
독립 MJCF와 xacro는 원본 바이트와 일치한다. 실제 보정 YAML 두 개도 이전
수집본과 동일하며, 이번에 hand-eye 보정을 다시 수행하지 않았다.

Ubuntu 22.04 / ROS 2 Humble / Python 3.10.12 / MuJoCo 3.11.0에서 별도
`/tmp/cleany-pr58-wrist-20261021` 사본과 `/tmp/cleany-pr58-wrist-output` 빌드
경로를 사용했다. Description 파일 121개가 로컬 코드와 SHA-256으로 일치한다.
루트 `make build`로 description과 MoveIt config 빌드를 통과했고,
`colcon test`에서 모델 정합성 46개, 보정 프로파일 10개, 마운트 자산 검사 1개,
MoveIt 설정 및 collision 계약 18개가 통과했다. 검사에는 좌우 30개 충돌
primitive의 배치와 크기, m/mm 단위, 실측 기준 치수와 원본 hash를 포함한다.

MoveIt mock 실행 1개는 앞서 `main`에서도 재현한 동일 Pilz LIN 단계에서
`ABORTED`로 실패했다. 이번 검사의 전체 colcon 결과는 이 실패를 포함한다.
새 마운트의 실물 간섭 여유, 카메라 정확도와 로봇 동작은 검증하지 않았다.
원본 로그, JUnit과 파일 manifest는 데이터 루트의
`reports/pr58-wrist-20261021/`에 보관한다.

### PR 58 카메라 수정 후속 검증 (2026-10-22)

기준은 PR 58의 `f8ffd75f741b8da9087de87b01d4ad5ea968ea37`과
`fix/pr58-wrist-camera-pose`의 미커밋 변경이다. MuJoCo의 렌더링 카메라와
optical body/site, sorting 카메라 설정을 v8 마운트 등록 위치·방향에 맞췄다.
Gazebo 레거시 및 팔 포함 CAD 모델도 같은 등록을 사용한다. 손목 마운트의
시야 가림과 좌표계 회귀 검사를 패키지 테스트로 등록했다.

CI 최적화는 PR 61에서 관리하며, 이 변경은 workflow, Makefile과 CI 인프라를
수정하지 않는다. 기존 모델 검사의 xacro 캐시와 Base 검사 등록 변경도 포함하지
않는다. 재촬영은 `tools/validation/capture_cameras.py`를 명시 실행한다.

Ubuntu 22.04 arm64, ROS Humble에서 별도 `builds/pr58-camera-only/` 경로에
관련 6개 패키지를 빌드했다. 최초 선택 빌드는 설치되지 않은 Navigation의
package 환경 파일 때문에 실패했다. Navigation C++ 의존성은 기존과 같이
충족되지 않아 선택 빌드에서 제외하고 촬영에 필요한 Python 소스만 PYTHONPATH로
제공했다. 최초 pytest도 description overlay를 source하지 않아 실패했으며,
새 빌드 overlay를 적용한 최종 description 65개, Gazebo 손목 2개와 도구 9개가
통과했다. 전체 workspace 빌드와 주행 검증을 뜻하지 않는다.

Xvfb/GLX와 software rendering에서 MuJoCo 및 팔 포함 Gazebo CAD의 실제
head/양손목 카메라 촬영을 통과했다. Xvfb는 기존 `pr58-test-cleanup/xvfb-bin`
링크로 추출된 실행 파일을 사용했다. 이 수정은 최신 main `254ffc4`와 함께
임시 worktree에서 충돌 없이 적용됐으며, 원격 CI는 실행하지 않았다.
원본 실패·성공 로그, JUnit, 카메라 PNG와 JSON, 변경 manifest는 데이터 루트의
`reviews/pr58-camera-only/`에 있다. 앞선 전체 backend 검증 원본은
`reviews/pr58-all-backends/`, CI 통합 비교 원본은 `reviews/pr58-pr61-preserved/`에
별도로 보존한다.

| 데이터 루트 아래 경로 | 내용 |
|---|---|
| `fixtures/cad-fortress-command-hold/` | 과거 시나리오 입력 |
| `fixtures/cad-fortress-command-hold-portable/` | local mesh/texture를 고정한 별도 입력 |
| `runs/scenarios/<run-name>/` | 과거 시나리오 결과, journal, 로그 |
| `runs/historical/20261010/artifacts/` | 이전 실행 원본 |
| `reports/legacy-20261010/docs/` | 과거 검증, navigation 분석, ChatGPT 인수인계 사본 |
| `experiments/legacy-20261010/` | 과거 캠페인, SLAM 코드 사본 |
| `experiments/legacy-runtime-cleanup-b3ca816/manifest.json` | 레거시 코드의 commit/hash |
| `migrations/20261010-repository-cleanup/` | 이관 대응표, hash, 검증 로그 |
| `archives/legacy-20261010/scrum-426-scenarios-20261010/worktree.tar.zst` | 이전 scenario worktree |
| `presentation/legacy-20261010/` | 발표 참조, 원본 자료 |
| `builds/<worktree-name>/` | 해당 worktree의 colcon 출력 |
| `builds/ci-optimization-evidence/` | CI 실행 metadata와 원본 로그, 테스트 수집 비교, 종료 경쟁 재현 |
| `reports/documentation-reorganization-20261013/before/` | 이번 문서 개편 전 Markdown 사본 |
| `reports/documentation-reorganization-20261013/manifest.json` | 사본 source commit, dirty 상태, 각 파일 SHA-256 |

Logger 분리와 CLI의 초기 검증은 `CLEANY_DATA_ROOT/reports/evidence/reports/SCRUM-486/validation.json`를 따른다.
`a401f6f`의 Ubuntu 22.04 ARM64/Humble 검증에서는 합성 ROS와 웹 fixture로
Logger 55개, Monitor 80개, Mock 통합 225개(Gazebo 1개 제외), 웹 13개와 CLI 19건을 확인했다.
초기 rosdep 선언과 launch 기본값 누락 오류는 수정 후 재검증했다. 원본은
`ubuntu-vm:/home/ubuntu/Documents/cleany-data/runs/` 아래
`pr62-conflicts-20261023/`와 `pr62-launch-local-review-20261023/`에 보존한다.

`f5e26ab` 기준 Ubuntu 22.04 ARM64/Humble에서 관측 콜백을 300ms 늦춰 Navigation 검사의 기존 실패를 재현했다. 네 속도 토픽을 함께 기다리는 미커밋 수정 후 기본 조건과 지연 조건을 각각 3회 통과했고, 패키지 검사 188개도 오류와 실패 없이 통과했다.
원본과 소스 SHA-256은 `ubuntu-vm:/home/ubuntu/Documents/cleany-data/runs/pr62-navigation-20261024/verification.json`과 같은 경로의 로그에 보존한다.

## 재현, 보존

문서 개편 전 사본의 source commit은 `fbe5854`입니다. Commit, dirty 상태, SHA-256은 보관 manifest, 과거 경로 대응은 `relocation-manifest.json`에서 확인합니다. 원본의 절대 경로와 hash는 보존하고, fixture의 현재 위치와 profile-manifest의 과거 provenance를 구분합니다.

재현할 때는 기록된 commit의 별도 checkout과 해당 환경, 입력을 사용합니다. 다른 브랜치의 자료는 해당 버전의 근거로 취급하며, 제품 결정은 KB 검토, Decision 절차를 따릅니다.

## 인식과 파지 후보 B 분리 검증

A `e780be1`을 기준으로 통합 소스 `94c0fcd`에서 인식과 파지 후보 변경을 분리했다.
Ubuntu 22.04 ARM64, ROS 2 Humble, Python 3.10, pytest 8.4.2 환경에서
`make build-perception-candidates`로 3개 패키지, 기존 소비자 확인을 위한
`make build COLCON_BUILD_ARGS='--packages-up-to cleany_skill_executor --parallel-workers 2'`로
의존성을 포함한 10개 패키지를 별도 경로에 빌드했다. 소비자 빌드는 기존
MoveIt 2.5.9 dependency overlay를 사용했으며 통합 브랜치의 install을 사용하지 않았다.

`make test-perception-candidates`는 493개 통과, 명시 활성화하지 않은 RealSense
실물 검사 1개 skip이다. 기존 수거 소비자 검사 267개도 통과했다. 입력은 합성
RGB-D, 가짜 모델, 저장된 설정이며 실제 Gemini API, TensorRT/AnyGrasp GPU 추론,
카메라, 모터와 전체 수거 시나리오는 실행하지 않았다. launch 두 개의 인자 검사도 통과했다.
초기 분리 검사에서 누락된 의존성, 후속 기능 테스트와 float32 비교를 수정했고,
소비자 노드 생성 검사의 설치 누락은 위 빌드로 해결했다. 최종 검사 실패는 없다.

검증 소스 `changes.patch`, 환경, 실행 명령, 로그와 JUnit 원본은
`/home/cleany/cleany-data/reports/pr-b-perception-20261029T222340Z/`에 보관한다.

### YOLOE 설정 정리 검증 (2026-10-30)

`0830839`에 이 절과 함께 반영한 정리 패치를 적용했다. 이전 34종 설정,
미사용 nano lock과 선택 옵션, 사용되지 않는 IK 예열 설정을 제거했다.
같은 Jetson Humble 환경의 새 빌드 경로에서 `make build-perception-candidates`로
3개 패키지를 빌드하고, 설치된 설정 6개의 hash와 삭제한 설정의 부재를 확인했다.
`make test-perception-candidates`는 492개 통과, RealSense 실물 검사 1개 skip이다.
검사 수가 하나 줄어든 것은 nano 전용 검사를 제거했기 때문이다.
입력은 합성 데이터와 가짜 모델이며 실제 GPU 추론과 실물 장치는 실행하지 않았다.
실패는 없었다. 소스 패치, 환경, 로그, JUnit과 설치 확인 원본은
`/home/cleany/cleany-data/reports/pr-b-yoloe-cleanup-20261029T230830Z/`에 보관한다.

### 최신 제어 기반 반영 검증 (2026-11-05)

`c79ed45b`에서 #65 `4427480d`를 반영했다. TensorRT 엔진의 사전 로딩 결과를
인식 상태 발행에 반영하고, RGB-D 진단 서비스와 양쪽 인터페이스 검사를 유지했다.
Jetson Ubuntu 22.04 ARM64, ROS 2 Humble의 별도 경로에서 3개 패키지를 빌드했다.
합성 RGB-D와 가짜 모델을 사용한 `make test-perception-candidates`는 496개 통과,
실패 0개이며 카메라가 필요한 RealSense 검사 1개는 제외했다. 충돌과 직접 관련된
71개는 이 수에 포함된다. 로그와 JUnit은 데이터 루트의
`reports/pr66-merge-20261105.2aYSk4/`에 보관한다.

## Mission Mock 조작 통합

| 코드와 환경 | 입력과 결과 범위 | 원본 (`cleany-data/runs/` 아래) |
|---|---|---|
| `171ac80`, Ubuntu 22.04 ARM64, Humble/Fortress | 40초 공유 fixture, study-cafe seat-12, wait_for_next. Mission/Mock/Bridge ROS 208, Monitor 41, 웹 27 검사 통과. Gazebo 139.97초, 두 execution ID와 추가 빈 관측. 깨끗한 Nav2 재빌드는 삭제된 임시 dependency export 경로로 실패했으며 실행은 기존 설치 사용 | `code-review-20261020/verification.json`, `execution-evidence.json`, 로그와 DB |
| 위 코드의 문서 정리 | 링크, 명령과 소스 불변 검사. 최신 #54 병합 전 근거 | `docs-review-20261020/` |
| 이전 40초 fixture | 초기 시간 조정과 ExecuteOne 관측 자료 | `manipulation-timing-20261015-XwwCUn/`, `code-verification-20261015-NS9Nqz/` |

이 수치는 서로 겹치는 검사 묶음이며 합산하지 않는다. 현재 코드의 근거와 과거 실행을 구분한다.

### 최신 PR #54 병합 검증

`171ac80`과 PR #54 `65fdf06`의 병합 작업트리를 Ubuntu 22.04 ARM64, Humble/Fortress에서 검사했다. 원본은 `cleany-data/runs/merge-pr54-20261020/`에 보관한다. 최종 commit과 세부 결과는 해당 폴더의 `verification.json`을 기준으로 확인한다.

| 검사 | 입력과 결과 | 원본 |
|---|---|---|
| Mission과 Mock Action | 두 물체 fixture, ROS domain 193. 208 passed, Gazebo 1개는 별도 실행 | `ros-mock.log` |
| Monitor | ROS domain 194. Cartographer ROS 1개를 제외한 99 passed. 전체 실행의 해당 1개는 `cartographer_ros_msgs` 미설치로 import 실패 | `monitor-ros.log`, `monitor-ros-available.log` |
| 웹 fixture | 33 passed, 실제 Monitor가 필요한 3개는 별도 실행. TypeScript와 production build 통과 | `web-all.log`, `web-build.log` |
| Gazebo와 Mock 조작 | 새 통합 install, study-cafe seat-12, domain 195, wait_for_next. 138.51초에 SUCCESS. 서로 다른 execution ID 2개, 각 17개 세부 동작과 추가 빈 관측 확인. 두 DB 무결성 통과 | `gazebo.log`, `gazebo-evidence.json` |
| 실제 Monitor | FSM, 토픽 선택, 기록 재생, host resource와 Gazebo 지도 검사 통과. 실제 조작 화면과 ExecuteOne 상세도 확인 | `web-live.log`, `web-map.log` |
| 새 통합 build | 생성물 정리 후 16개 package와 Monitor 설치 build 통과 | `build-sim-clean.log`, `build-monitor-clean.log` |
| 계약과 문서 | 최신 #54 FSM, 청소 BT, journal과 보고 model 동일. 로컬 문서 링크 146개 확인 | `mission-core-invariants.json`, `docs-check.json` |

로컬 Nav2 cache의 CMake export가 예전 `/tmp` 추출 경로와 누락된 include 경로를 참조했다. 검증에서는 원래 prefix를 현재 cache에 연결하고 `CPLUS_INCLUDE_PATH`로 설치된 header root를 제공했다. 생성된 export 파일은 수정하지 않았다. 이 환경 보정은 새 VM의 의존성 설치를 대체하지 않으며 재부팅 후 임시 prefix를 다시 준비해야 할 수 있다. 상세 경로와 include 목록은 `nav2-environment.json`, `nav2-build-includes.json`에 남겼다.

### 병합 후 코드 검토

`a7317be` 이후 작업트리를 Ubuntu 22.04 ARM64, Humble/Fortress에서 검토했다. 원본은 `cleany-data/runs/quality-review-pr54-20261020-08o9nj4k/`에 보관하며 최종 소스 hash와 집계는 `verification.json`을 따른다.

| 검토 항목 | 반영 내용 |
|---|---|
| Action remap | Humble의 client와 server에서 이름을 명시적으로 해결하고 내부 CancelGoal 경로도 맞춤. 기본 주소와 사용자 주소에서 두 물체 실행 및 취소 검사 |
| 종료 중 DB 쓰기 | callback과 같은 잠금으로 DB를 닫고 종료 후 tick을 차단. 진행 기록을 ACTIVE로 보존하며 종료를 정지 증거로 만들지 않음 |
| 요청 검증 | 문자열이 아닌 ID와 bool 또는 소수 object ID를 core 수락 전에 거절 |
| 중복과 테스트 | 사용되지 않는 저장소 복구 함수와 미사용 import 제거. 복구 정책은 기존 ExecutionJournal에서 수행. 합성 검증 timeout 대기를 5초에서 2초로 축소 |
| 웹 검사 격리 | UI fixture의 기록 API를 명시하여 실제 로컬 Monitor에 의존하지 않도록 수정 |
| 계약과 문서 | 서버 wall 시각과 steady timeout 구분, 조회와 DB 저장 성공의 차이를 명시. FSM, 청소 BT, 보고 model과 ROS 타입 23종 유지. 웹과 서버의 정상 9단계, 17동작 일치 |

초기 `remap-before.log`와 `ids-before.log`에서 기존 실패를 확인했다. 첫 전체 ROS 실행은 종료 중 SQLite 쓰기와 닫기가 겹쳐 segfault로 중단됐고 `ros.log`에 보존했다. 종료 동기화 수정 후 해당 회귀 검사와 서버 검사 34개가 통과했다. 최종 전체 ROS 검사는 **216 passed, 1 skipped**이며 Gazebo 1개는 별도로 통과했다. 원본은 `ros-final.log`다. 문서 링크 146개와 Python 소스 31개의 syntax, Pyflakes를 확인했다.

Monitor는 99개, 웹 fixture는 33개가 통과했으며 변경한 UI fixture 6개도 다시 통과했다. Cartographer ROS 1개는 이전과 같이 `cartographer_ros_msgs`가 없어 제외했다. Gazebo는 142.52초에 두 execution ID의 수거와 각각 17동작, 추가 빈 관측을 확인했고 Mission DB와 서버 DB의 integrity_check가 모두 통과했다. 마지막 종료 잠금 수정은 별도 동시성 회귀 검사로 검증했다. 원본은 `monitor.log`, `web.log`, `ui-final.log`, `gazebo.log`, `gazebo-evidence.json`, `stage-contract.json`, `static-final.log`에 있다.

## System Supervisor와 Mission Runtime 통합

검증 코드는 `ad472e2`(main `d0afd48` 위 리베이스)다. Ubuntu 22.04.5 aarch64 Distrobox, ROS 2 Humble, Python 3.10.12에서 실행했다. 원본 로그, 지연 JSON과 `verification.json`은 데이터 루트의 `runs/supervision/20261023/`에 있다.

| 검사 | 입력과 결과 | 원본 |
|---|---|---|
| `make test-supervision-core` | 50 passed | `test-supervision-core.log` |
| `make test-supervision` | 69 passed. 실제 Supervisor, safety adapter, base driver와 MockMcu, `mission_runtime`(Nav2 backend, supervised), lifecycle 복구 owner. 센서, Nav2 action, lifecycle manager와 안전 하드웨어 Bool은 합성 | `test-supervision.log` |
| 같은 Supervisor 검사, 18개 CPU busy loop | 47 passed | `test-supervisor-under-cpu-load.log` |
| `make test-mission-core`, `test-base`, `test-navigation` | 77 passed와 17 skipped, 109개, 191개 통과 | 각 로그 |
| `make test-mission-mock` | 233 passed, 2 skipped, 1 failed. `test_process_kill_restart_reports_interruption_without_action_result`는 main `d0afd48`에서도 5회 중 3회 실패 | `test-mission-mock.log`, `flaky-process-kill-*.log` |
| Workspace colcon test, `cleany_manipulation_bt` 제외 | 2218개 중 실패 3. 위 flaky 1개와 이 문서의 기존 MoveIt mock planning `status == 6`(ctest와 xunit 두 번 집계) | `workspace-test-skip-bt.log` |
| `make test` | 이 환경에 `behaviortree_cpp` v4가 없어 `cleany_manipulation_bt` build에서 중단 | `make-test.log` |

Lease 승인과 상태 파일 기록 사이에 Supervisor가 종료되면 lease가 사라지는 결함을 부하 실행에서 발견해 승인 응답 전 기록하도록 수정했다. 수정 전 같은 부하에서 재시작 재확인 검사가 8회 중 4회 실패했고 수정 후 8회 모두 통과했다.

LiDAR 무효 scan 발행부터의 지연이며, 같은 host 한 process 안의 DDS loopback과 Runtime tick 10 Hz 기준이다. 실제 Nav2 controller 정지, 모터 감속과 다중 host 지연은 포함하지 않는다.

| 구간 (5회) | 중앙값 / 최대, 무부하 | 중앙값 / 최대, CPU 부하 |
|---|---|---|
| Lease 철회 | 42 / 46 ms | 24 / 53 ms |
| Nav2 goal cancel 수신 | 46 / 50 ms | 28 / 57 ms |
| Supervisor 정지 확인 (`MISSION_STOPPED`) | 96 / 112 ms | 121 / 201 ms |
| Supervisor 종료 → Nav2 cancel | 0.995 s (heartbeat timeout 1 s) | 0.994 s |

E-stop 회로, MCU 통신 차단 시 모터 정지, 실제 Nav2 lifecycle 복구, 실물 팔 controller, Jetson 다중 프로세스와 SROS2는 검증하지 않았다.

## CI 성능 검증 (2026-10-20)

기준은 Ubuntu 22.04 GitHub runner, ROS Humble의 [실행 39417986298](https://github.com/asm17-moving-agent/cleany/actions/runs/39417986298), commit `11d1ba8`입니다. 전체 job은 804초, workspace 의존성 설치 288초, 빌드와 테스트 279초, 별도 Navigation 빌드와 runtime 123초였습니다. 입력은 해당 commit의 전체 workspace 검사와 기존 motor, Navigation, Gazebo runtime 검사입니다.

| 실행 | Commit | Job 전체 | 결과 |
|---|---|---|---|
| 기존 기준 | `11d1ba8` | 13분 24초 | 통과 |
| [이미지 생성, 게시와 compiler cache 최초 준비](https://github.com/asm17-moving-agent/cleany/actions/runs/39426732345) | `d44b065` | 15분 5초 | 통과 |
| [이미지와 compiler cache 재사용](https://github.com/asm17-moving-agent/cleany/actions/runs/39429236181) | `45df20f` | 4분 37초 | 통과 |

재사용 실행은 기준보다 65.5% 짧았습니다. 이미지 pull 84초, cache 복원 2초, 전체 workspace 빌드와 테스트 90초, motor core 1초, Navigation runtime 30초, Gazebo runtime 46초가 포함됩니다. C++ 입력이 같은 상태에서 compiler cache는 264건 모두 적중했고 전체 빌드는 42.7초였습니다. Workspace 검사 집계는 1,882개, 실패 0개, 기존과 같은 skip 24개이며 CI 도구 9개, Navigation runtime 3개와 Gazebo runtime 1개도 통과했습니다. 베이스 검사를 직접 보고하도록 바꾸어 기존 중첩 래퍼가 집계하지 않던 검사도 XML에 포함됩니다.

5분 이내는 위 cache 적중 실행의 실측값입니다. 의존성 변경이나 주차 갱신으로 이미지를 다시 만들거나, C++ 변경으로 cache miss가 생기면 더 오래 걸릴 수 있습니다. 캐시가 없는 최초 실행도 전체 검사를 통과했습니다.

`1ab6d8a`의 [최초 실행](https://github.com/asm17-moving-agent/cleany/actions/runs/39424741384)은 기존 command guard SIGINT 종료 검사에서 메시지 변환 중 RuntimeError로 실패했습니다. `d44b065`에서 콜백 이후에 종료하도록 수정했습니다. 동일한 Humble 의존성 이미지의 Linux arm64 로컬 재현은 수정 전 10회 중 3회 실패, 수정 후 기존 검사 30회 연속 통과였습니다. 베이스 드라이버의 기능 검사 수집 ID 72개는 변경 전후 동일하며, 기존 모델 검사 함수 24개와 runtime 검사 파일을 유지했습니다.

`d5852af`의 [환경 확인 실패](https://github.com/asm17-moving-agent/cleany/actions/runs/39428868069)는 런타임 `ROS_HOME`이 이미지의 rosdep metadata 위치와 달라 발생했습니다. `45df20f`는 의존성 확인 명령에 이미지 생성 시의 `ROS_HOME`을 지정하며, 재설치 없이 실제 manifest의 의존성 충족 여부를 검사합니다.

원본은 데이터 루트의 `builds/ci-optimization-evidence/`에 보존합니다. `timing-comparison.json`, `baseline-39417986298.json`, `cold-*.json`, `cold-*.log`, `warm-*.json`, `warm-*.log`, `coverage-audit.json`, `base-*-collection.txt`, `shutdown-before.log`, `shutdown-after.log`에서 환경, 실패와 검사 범위를 확인합니다. `cold-artifacts/`, `warm-artifacts/`와 CI artifact는 test XML, apt/pip 버전과 compiler cache 통계를 보존합니다. Simulator와 합성 backend 검사이며 실물 로봇 검증을 뜻하지 않습니다.

## 실물 매핑 패키지 통합

기준은 원격 main `eb2c56a190ad9fbb52cb104ff55282e955a56fcb`, 통합 작업은
`feat/hardware-mapping-integration`이다. 변경 소스 hash는 로컬
`artifacts/mapping-probe-11/source-manifest.json`에 보존한다. 환경은 Ubuntu 22.04
Distrobox, ROS 2 Humble, Linux arm64이며 실물 USB는 열지 않았다.

| 검사 | 입력과 확인한 경계 | 원본 |
|---|---|---|
| 설치 빌드 | lockfile UI와 관련 패키지 20개 빌드 | `artifacts/mapping-probe-11/build.log` |
| 패키지 회귀 | 관련 ROS 검사, ordered permission과 odom reset, 기존 navigation/Logger 회귀 | 같은 디렉터리 `packages.log` |
| 순수 core와 JS | 세션 직렬화, 저장 실패, origin yaw, PID 재사용과 지연 저장 세대 분리, 누름/해제/복구 | `core.log` |
| 설치 launch | `/tmp`에서 실행, synthetic MCU와 합성 room scan, 단일 휠 publisher와 STOP 확인 | `verification.json`, `runtime.log` |
| 세션 저장 | 초기화 2회, 서로 다른 generation과 output, 두 지도/pbstream, Logger flush와 정상 종료 | `runtime/maps/`, `runtime/recordings/` |
| CDR 재생 | domain 175에서 원본 bag 재생, raw/filtered scan, 휠 상태/명령, joint state, odom, TF와 map 수신 | `replay-verification.json`, `replay-verification.log` |
| 종료 소유권 | 기록된 PID와 시작 시각을 대조해 남은 owned child 없음 확인 | `ownership-verification.json` |
| HTTP UI | 설치 자산, token/Origin 거절, 경로 이탈 차단과 CSP | `artifacts/integrated-ui/http-verification.json` |

초기 재현은 `mapping-probe-01`부터 `-10`에 보존했다. 같은 ROS domain을 사용한 검사 간섭,
Logger의 동적 구독 제거 중 InvalidHandle, 종료 래퍼의 신호 전달, symlink 설치 자산의
경로 검사, 수신이 없거나 관측용 주기가 적용된 bag 토픽 누락을 구분해 수정했다.
Logger는 구독별 callback group과 단일 executor로 retired handle이 제어 서비스를 막지 않게 하며,
매핑용 원본은 명시적으로 수신마다 기록한다. ROS 패키지 검사는 domain 174에서 순서대로 실행한다.

브라우저 연결 호스트가 없어 실제 화면 렌더링은 이번 실행에서 확인하지 못했다.
실물 장착 TF, 물리 정지 거리, 바닥 주행과 지도 품질은 이 합성 검사의 범위가 아니다.

의존성 점검에서는 Humble rosdep에 `sllidar_ros2`, `micro_ros_agent` 규칙이 없는 것을 확인했다.
실행 의존성은 manifest에 유지하고, 일반 설치/장치 없는 CI에서는 두 외부 source-build 의존성만
명시적으로 제외한다. CI의 조종 UI 빌드는 별도 Node 24 단계로 추가했다. 이 로컬 검사는 GitHub
Actions 실행이나 실물 드라이버 설치를 대신하지 않는다.

## 매핑과 조종 진단 검증 (2026-11-02)

후속 진단 변경의 commit과 파일 hash는
`artifacts/debug-diagnostics-02/source-manifest.json`에 기록한다. 환경은 로컬 Ubuntu 22.04
ROS 2 Humble container이며 synthetic MCU와 합성 room scan을 사용했다.

20개 패키지 빌드, Python core 61개와 조이스틱 17개, 관련 ROS 검사 428개가 통과했다.
RPC 거절, 동기 및 비동기 예외, 빈 응답, 동일 실패 반복 조회, 시작과 정리의 동시 실패,
진단 파일 저장 실패, 이벤트 큐 포화와 파일 회전은 core 검사로 확인했다.
원본 로그는 같은 artifact 디렉터리의 `build.log`, `core.log`, `packages.log`에서 확인한다.

설치 launch의 두 매핑 세션에서 지도와 pbstream, Logger bag 저장과 STOP 후 종료를 확인했다.
관리자 종료 후 ROS 상태 캐시가 unavailable로 전환됐고 조종 사건 JSON Lines가 남았다.
결과와 세션 경로는 `verification.json`, 종료 후 owned PID 확인은
`ownership-verification.json`에 보존한다. 실물 USB, 실제 주행과 화면 렌더링은 검증 범위에
포함하지 않았다. HTTP 자산 제공과 UI TypeScript 빌드는 확인했다.

## 2026-10-26 ToF와 System Supervisor 통합

기반은 `main`의 `eb2c56a1`과 `feat/system-supervisor`의 `e0d5001e`를 합친
`cbe09bed8cc139e86d85f91201458f4a61693df9`다. 검증 당시 ToF 구현은 이 commit 위의 미커밋 변경이었다.
원본과 설정 SHA256은 `CLEANY_DATA_ROOT/runs/tof-integration/source-manifest.sha256`에
보존한다. KB는 Supervisor 브랜치의 gitlink를 사용하며 내부 내용을 수정하지 않았다.

Ubuntu 22.04 arm64 Distrobox, ROS 2 Humble, Python 3.10에서 `make build-tof`,
`make test-tof-core`, `make test-tof`, `make build-navigation`, `make test-navigation`을
실행했다. 마지막 ToF 패키지 재검사를 반영한 colcon 결과는 207 tests, 오류/실패 0,
선택 시나리오 skip 15다. ToF 자체 34 tests에는 합성 ROS와 pseudo-terminal이 포함된다.
Navigation colcon 결과는 194 tests, 오류/실패/skip 0이다. 중복된 core 검사는 합산하지 않는다.

선택 Mission ROS 검사는 별도로 13 passed, WebSocket 의존성 누락 skip 1이었다.
이후 WebSocket 검사도 단독 통과했다. 최초 추가 실행은 Ubuntu의 websockets 9.1에서
handshake reset으로 실패했으며 Python 3.10 호환 버전인 10.4를 별도 `testdeps` 경로에
설치해 통과했다. 제품 Bridge 코드는 수정하지 않았다. 재현 시 이 경로를 PYTHONPATH에
앞세운다. Gazebo 물리 시나리오는 실행하지 않았다.

원본 결과는 `CLEANY_DATA_ROOT/builds/feat-tof-integration/build/*/pytest.xml`,
`build-navigation/cleany_navigation/test_results/`, `log/`와 `log-navigation/`에 있다.
별도 검사 요약은 `CLEANY_DATA_ROOT/runs/tof-integration/validation.json`에 있다.

공급 펌웨어의 `evidence/range-15hz-2min.jsonl`에서 초기 10Hz 28 frames를 제외한
15Hz 1,817 frames를 오프라인 파싱했다. 평균 유효 zone 33.7347, 기본 보호 coverage를
만족한 frame은 0이었다. 마지막 통계 수신 중 추가 frame도 포함하므로 공급 보고서의
120초 집계 1,816과 범위가 다르다. 원본 경로와 결과는 같은 runs 폴더의
`firmware-replay.json`에 남겼다. 이는 신규 장치 통신이나 실물 정지 검증이 아니다.
실물 commissioning과 한계는 [CALIBRATION](CALIBRATION.md#tof-근접-보호-commissioning)과
[ToF 계약](../ros2_ws/src/cleany_tof/docs/interfaces.md)을 따른다.

## 2026-10-26 ToF 미검출과 방향별 관측 근거

아래 결과는 `905f3d7b673f755a7a7bdbe87b731392558e322e` 위의 작업 트리에서 커밋 전에 검증한 기록이다.
센서는 단독 측정만 완료했고 로봇에 미장착이라는 사용자 정정을 반영했다. 원본 firmware와
실제 센서/모터 설정은 변경하지 않았다. 정책 계약은
[ToF reference](../ros2_ws/src/cleany_tof/docs/interfaces.md)를 따른다.

`range-15hz-2min.jsonl`(SHA256
`ec02366ab656431fed101f7bcc50ca5e9b67b045fc144a1ea4f5f8aaacdcb361`)에서
세션 이전 10Hz 28 frames를 제외한 15Hz 1,817 frames, 116,288 Zone samples를 분류했다.
정상 미검출(count=0/status=255)은 53,109, 품질 조건을 통과한 RANGE는 60,868,
UNRELIABLE은 2,311, NOT_UPDATED는 0 samples였다. 1,817 frames 모두 수신된 관측으로
유지되지만 주행 가능 판정은 아니다. 기존 전체 Zone 조건을 만족한 frame은 0이었다.
이 파일의 firmware-valid 거리 최댓값은 3.22m여서 약 3.5m 미검출의 별도 사용자 관찰을
검출 보장 거리나 자유 공간 하한으로 일반화하지 않았다.

원본의 시작 wrap status, 혼합 품질, 최장 valid 거리 frame 3개를
[test fixture](../ros2_ws/src/cleany_tof/test/data/standalone_frames.json)에 측정 필드 그대로
보존했다. 단독 측정에는 RGB-D의 동시 관측이나 실제 장착 coverage가 없다.
재생 도구는 `tools/validation/tof/replay.py`, 결과는
`CLEANY_DATA_ROOT/runs/tof-coverage/standalone-audit.json`이다. offline 도구의 도착 시각은
검사 재현을 위한 device clock이며 신규 USB 지연 측정으로 해석하지 않는다.

Ubuntu 22.04 arm64 Distrobox, ROS 2 Humble, Python 3.10의 기존 개발환경과 build cache에서
다음 검사를 실행했다. 중복 검사는 합산하지 않는다.

| 명령과 범위 | 결과 |
|---|---|
| `make test-tof-core` | 77 passed |
| `make build-tof`, `make test-tof`와 최종 ToF package 재검사 | 9 packages build; colcon 231 tests, errors/failures 0, 선택 Mission/Gazebo skip 15 |
| ToF package 자체 | 58 tests, errors/failures/skips 0 |
| Humble의 `make test-navigation` | 6 packages build; colcon 199 tests, errors/failures/skips 0 |
| `git diff --check` | 통과 |

기존 finite-depth 기하와 실제 depth coverage 발행 노드→ToF 소비자 연결을 합성 RGB-D,
TF와 odometry로 검사했다. 무효 pixel, stale/잘못된 model/명령 근거의 철회, 정상 미검출의
조건부 속도 제한, 품질 불량 정지, firmware event status=255의 sensor_ready 철회와
기존 lease/Action 취소 경계를 검사했다. 초기 연결 검사에서 test TF가 평가 시각보다
미래였던 fixture를 실제 관측 시각과 일치시켰다. observer 설정이 없는 launch 프로파일도
별도로 검사하여 구성 누락 경로를 수정했다. 검사 조건을 완화해 통과시키지 않았다.

원본 XML과 로그는 `CLEANY_DATA_ROOT/builds/feat-tof-integration/{build,build-navigation,log,log-navigation}`에,
이번 변경의 소스 SHA256과 요약은 `CLEANY_DATA_ROOT/runs/tof-coverage/`에 있다.
합성 근거와 임시 sensor/body geometry는 실물 중첩을 입증하지 않는다. 실제 Nav2 전환을
포함한 full-stack 주행, Gazebo 주행 시나리오, 장착 후 제동과 접근 정확도 검사는 수행하지
않았다. `calibrated=false`를 유지하며 장착 후 항목은
[CALIBRATION](CALIBRATION.md#tof-근접-보호-commissioning)에서 확인한다.

## 2026-10-26 ToF ROI 감지와 책상 접근 단순화

기준 commit은 `162f3788a74c3674d4e1bb1f93df0f3efad8666b`이며 아래는 그 위 작업 트리의
검증이다. 사용자 지시에 따라 정상 NO_RETURN을 장애물 미검출로 처리하고, ToF 전용
RGB-D sweep proof와 전체 Zone coverage 요구를 제거했다. 위 절의 proof 정책은 이전
실행 기록이며 현재 계약은 [ToF reference](../ros2_ws/src/cleany_tof/docs/interfaces.md)다.
기존 head-pan observer, Nav2/Collision Monitor, Mission/Supervisor와 모터 watchdog은
유지했다. 센서와 firmware를 새로 구동하거나 모터 명령을 보내지 않았다.

Ubuntu 22.04 arm64 `ros2-humble` Distrobox, ROS 2 Humble, Python 3.10과 기존 build cache에서
다음 명령을 실행했다. 순수 검사와 package 검사는 일부 중복되므로 합산하지 않는다.

| 명령/범위 | 결과 |
|---|---|
| `make test-tof-core` | 91 passed |
| `make test-tof` | 9 packages build, colcon 247 tests, errors/failures 0, 기존 opt-in Mission skip 15 |
| ToF package 자체 | 74 tests, errors/failures/skips 0 |
| Humble에서 `make test-navigation` | 6 packages build, colcon 198 tests, errors/failures/skips 0 |
| `git diff --check` | 통과 |

navigation의 colcon 198 집계에는 CTest 실행 단위 9개도 포함된다. 개별 pytest/gtest
189 cases와 별도의 독립 검사 수로 합산하지 않는다.

합성 입력으로 15Hz 인접/물리 cluster와 시간 확인, flash/고립/비인접 noise, 중복 frame,
입력 공백 reset, ROI 제외, 단일 비상 return, 거리/해제 hysteresis를 검사했다. ROS 검사에서는
실제 ToF 노드에 합성 frame/odom/lease를 넣어 정상 미검출의 proof 없는 주행 허용,
전부 불량/센서 장애/stale 정지, 일부 불량 Zone의 접근 수락, 평면 소실 abort, 기존
cancel/lease/정지 확인 경계를 검사했다. 드라이버 검사는 pseudo-terminal이며 실제 USB가
아니다. graph의 기존 안전 chain은 identity 대역이다. navigation launch 검사는 ToF on/off와
기존 observer on/off의 네 조합을 조립하며 실제 프로세스를 구동하지 않는다. 제거된 proof
전용 검사와 별개로 원래 finite-depth observer 회귀는 유지했다.

첫 순수 검사에서 ROI 제외 검사와 확인 검사에 같은 timestamp를 재사용한 fixture가
실패했다. 필터의 동일 frame 중복 방지를 유지하고 별도 시나리오 사이 fixture를 reset했다.
재검사 결과는 위 표와 같다. 선택 skip은 성공으로 처리하지 않았다.

기존 `range-15hz-2min.jsonl`을 offline audit로 다시 분류했다. 원본 SHA256은
`ec02366ab656431fed101f7bcc50ca5e9b67b045fc144a1ea4f5f8aaacdcb361`이며 10Hz 28 frames를
제외한 1817 frames에서 RANGE 60868, NO_RETURN 53109, UNRELIABLE 2311 samples였다.
이 재생은 새 USB latency 측정이나 로봇의 주행 허용률 검사가 아니다.

원본 XML은 `CLEANY_DATA_ROOT/builds/feat-tof-integration/{build,build-navigation}`에,
이번 audit와 작업 트리 manifest는 `CLEANY_DATA_ROOT/runs/tof-simplification/`에 보존한다.
센서는 아직 미장착이며 `calibrated=false`다. full-stack Nav2/ToF 또는 Gazebo 주행,
실물 검출/제동/접근 정확도 검사는 하지 않았다. 장착 후 ROI와 거리/시간 후보값 튜닝,
오탐/미탐, 실제 지연과 정지는 [CALIBRATION](CALIBRATION.md#tof-근접-보호-commissioning)의
별도 검증 대상이다. ToF와 다른 센서가 같은 장애물을 모두 미검출할 수 있다.

## 2026-11-02 voxel guard 10Hz 평가 설정

기준은 `162f3788a74c3674d4e1bb1f93df0f3efad8666b` 위의 미커밋 작업 트리다.
기존 ToF 단순화 변경을 보존하고, 여러 감지 경로를 함께 사용하는 구성에서 voxel
충돌 검사와 속도 출력의 기본 주기를 0.05초에서 0.10초로 바꿨다. 공통 navigation,
Gazebo YAML과 node fallback에 같은 값을 적용했다. 지도 갱신, Collision Monitor,
ToF 주기, timeout과 제동 궤적의 `step_s`는 그대로다. 개별 robot profile의 명시적
주기 override는 계속 우선한다.

Ubuntu 22.04 arm64 `ros2-humble` Distrobox와 기존 build cache에서 다음을 확인했다.

| 검사 | 결과 |
|---|---|
| Humble `make test-navigation` | 6 packages build, colcon 198 reported tests, errors/failures/skips 0 |
| Gazebo package와 의존성 build | `colcon build --packages-up-to cleany_gazebo_sim`, 8 packages 성공 |
| 실제 ToF selector/guard의 합성 10Hz 명령 입력 | 정상 구간 49개 출력 sample의 사유 CLEAR, 입력 중단 시 COMMAND_STALE와 zero 확인 |
| `git diff --check` | 통과 |

Gazebo package만 먼저 build한 시도는 해당 install tree의 cleany_base_odometry 누락으로
실패했다. packages-up-to로 의존성을 함께 build해 해결했다. navigation의 198 집계는
CTest 실행 단위 9개를 포함하므로 독립 case 수와 합산하지 않는다.

합성 연결은 별도 DDS domain에서 15Hz frame/odom과 10Hz identity 중계로 실행했다.
상류 명령의 관측 간격 평균은 0.1000초, 최대는 0.1049초였다. 실제 voxel 계산이나
Collision Monitor, Nav2 구동은 이 중계에 포함하지 않았다. 임시 script와 result.json은
`CLEANY_DATA_ROOT/runs/voxel-rate-10hz/`, build와 XML은 기존
`CLEANY_DATA_ROOT/builds/feat-tof-integration/{build-navigation,log-navigation}`에 있다.
실제 CPU 절감, 부하 중 worst-case 지연과 물리 정지 거리는 측정하지 않았다.

## 2026-11-02 ToF PR 검증의 상태 전환 동기화

`162f3788a74c3674d4e1bb1f93df0f3efad8666b` 위의 PR 준비 작업 트리에서 순수 검사
91개를 재실행해 통과했다. 첫 `make test-tof`는 정상 미검출 전환 검사에서 이전 속도
출력과 새 OBSTACLE_HOLD 사유를 비교해 실패했다. release_s 동안의 정상 정지 동작은
유지하고, 테스트가 CLEAR와 정상 출력, AVAILABLE 및 실제 64개 NO_RETURN 수신을 함께
기다리도록 수정했다. 기존 출력 임계값과 센서 상태 조건은 유지했다. 실제 하드웨어는
사용하지 않았다. 재검사 XML은 기존 `build/cleany_tof/pytest.xml`에 있다.

수정 후 make test-tof 재실행은 colcon 247 tests, errors/failures 0, 기존 선택 skip 15였으며
ToF package 74 tests는 errors/failures/skips 0이었다. navigation 198 reported tests와
합성 10Hz 연결 검사는 같은 소스의 앞선 실행 결과다.

## 2026-11-02 PR #71 rosdep 초기화 실패 수정

PR head `ea5adf40dad37c80aa5e4d1da98acbbe942f8769`의 CI run `41363593569`는 테스트 실행 전
의존성 이미지 생성에서 실패했다. cleany_safety_adapter, cleany_system_supervisor,
cleany_tof가 ament_python을 buildtool dependency로 선언해 rosdep이 해석하지 못했다.
세 선언만 제거하고 export의 ament_python build type, 실제 runtime/test 의존성과 CI의
의존성 검사는 유지했다. 기존 로컬 overlay의 package 빌드는 이 rosdep 오류를 검출하지 못했다.

Ubuntu 22.04 arm64 Humble Distrobox와 기존 build cache에서 make test-ci-tools 9건,
make test-tof의 9 packages build와 colcon 247 tests가 errors/failures 0으로 통과했다.
기존 opt-in skip은 15건이며 ToF package 74 tests는 errors/failures/skips 0이다.
공식 기본 rosdep source와 저장소의 ros2_ws/rosdep/cleany.yaml을 별도 ROS_HOME에 준비해
전체 workspace의 rosdep install --simulate --ignore-src --rosdistro humble도 통과했다.
로컬 기본 rosdep source가 초기화되지 않아 발생한 메타데이터 누락은 이 격리 설정으로
해결했으며 전역 설정을 바꾸지 않았다. 실제 CI 이미지는 원격 workflow에서 재검증한다.

로컬 rosdep 로그와 재현 script는 CLEANY_DATA_ROOT/runs/ci-pr71-fix/에, package XML은
기존 builds/feat-tof-integration/build에 있다. 실제 센서나 모터를 사용하지 않았다.

## MoveIt 충돌 메시 최적화와 MuJoCo 동등성 검사 (2026-10-24)

`main`의 `eb2c56a190ad9fbb52cb104ff55282e955a56fcb`에서 충돌 메시 최적화만
분리했다. 형상과 기본값은 Jetson에 적용한 로컬 `cffdddb`, 동등성 검사 수정은
`707538d`를 따른다. STL 17종과 manifest, 선택 옵션, 생성 도구와 검사를 포함한다.
MuJoCo 접촉용 MJCF, 관절, 시각 CAD와 MoveIt 자기 충돌 예외는 main을 유지한다.
cuRobo와 GPU 계산 및 미병합 physical launch의 변경은 포함하지 않는다.

Jetson Orin NX, Ubuntu 22.04, ROS 2 Humble, Python 3.10.12와 MuJoCo 3.11.0의
별도 main 사본에서 description 패키지를 빌드하고 설치 자산 18개의 hash를
소스와 비교했다. `make test-description-models`에 description의 나머지 검사와
기존 main의 MoveIt 설정, 시뮬레이션 충돌 예외 및 장면 검사를 추가해
122개가 모두 통과했다. 이때 검사한 26개 core 파일은 분리 변경과 동일하다.
NumPy/SciPy 호환 범위와 deprecated API 경고 2개는 남았다.

공통 URDF 기본값 때문에 Gazebo navigation에도 최적화 메시 10개가 전달된다.
이 변경은 Jetson과 같은 기본값을 유지하며, 별도 검토한 Gazebo 원본 형상 고정은
포함하지 않는다. 앞선 122개 검사는 Gazebo 변환 모듈을 실행하지 않는다.
Gazebo 시뮬레이션 실행과 실물 모터 동작을 검증한 결과는 아니다.

원본은 Jetson의 `/home/cleany/cleany-data/reports/collision-main-review-20261024/`에
있다. `main.tar.gz`, `candidate.json`, `installation.json`, `build.log`와
`models-and-main-contracts.log/.xml`에 입력 main, core 파일 hash, 환경과 결과를
보존했다. 해당 검토의 `candidate.patch`에는 별도로 제안한 Gazebo 원본 고정이
포함되어 있으므로 이 PR의 패치와 구분한다. Jetson 운영 적용 기록은
`/home/cleany/cleany-data/reports/collision-deployment-20261024/`에 있다.

### PR 64 최신 메시와 SolidFCL 검증 (2026-10-29)

기준 commit은 `5db7b12a34d2ba85c965d7d783039a947d456afa`이며, 이 절과 함께
반영한 변경을 Jetson의 별도 workspace에서 검사했다. 최신 STL 17종의 삼각형
합계는 4,686개에서 3,966개로 줄었다. 닫힌 볼록 조각 내부의 장애물을 검출하는
`cleany/SolidFCL`을 독립 패키지로 분리하고, 요청한 detector의 로드 실패 시
계획 서비스를 종료하는 검사를 추가했다. 시간 배정, cuRobo와 GPU 실행 변경은
포함하지 않는다.

환경은 Jetson Orin NX, Ubuntu 22.04, ROS 2 Humble, MoveIt 2.5.9와 해당 버전의
Pilz 및 MoveGroup overlay다. `reviews/pr64-20261029/`의 분리된 build/install을
사용했으며 운영 install은 참조하지 않았다. 검증한 소스 42개와 설치 STL
17종의 SHA-256이 로컬 PR 작업트리와 일치한다. 소스 목록은
`pr-source-hashes.json`, 설치 확인은 `pr-installation.json`에 있다.

| 검사 | 결과 |
|---|---|
| `make build`에 `COLCON_BUILD_ARGS="--packages-up-to cleany_moveit_config"` 지정 | description, collision, scene mapping, MoveIt config 4개 패키지 빌드 성공 |
| `make test-description-models` | 모델 동등성과 메시 형상 85개 통과 |
| SolidFCL gtest | 내부 장애물, 분리된 틈, ACM, 거리, OctoMap, attached object 및 링크 경계 상자 검사 6개 통과 |
| MoveIt 설정, 시뮬레이션 충돌 예외와 장면 계약 | 18개 통과 |
| 기존 Mock 계획/실행과 종료 검사 | 3개 통과 |
| 설치된 MoveIt 서비스 | 3개 통과: 내부 장애물 36개 검출, 같은 입력의 표면 FCL 누락 재현, 잘못된 detector 요청 시 종료 |

표의 최종 결과는 중복 없는 검사 115개이며 CTest 래퍼는 합산하지 않는다.
서비스 입력은 원본 CAD에서 충돌했던 자세와 장애물 36건의 고정 fixture다.
장애물 없는 상태의 유효성과 접촉 링크도 확인한다. Mock 실행은 가상
ros2_control 하드웨어를 사용했으며 실물 드라이버나 모터 명령을 사용하지 않았다.

처음 세 패키지만 선택한 빌드는 기존 scene mapping의 미설치로 실패해
`--packages-up-to cleany_moveit_config`로 의존 패키지를 함께 빌드했다.
전체 `make test`는 내비게이션 의존성 `dwb_msgs`가 없어 빌드 단계에서 중단됐다.
서비스 검사의 환경변수를 이어 붙인 실행은 `ROS_LOCALHOST_ONLY=0:1`이 되어
2개가 통신 대기로 실패했다. CMake의 `ENV`로 값을 지정한 뒤 해당 3개를
재실행해 통과했다. NumPy/SciPy 경고 2개는 유지된다. 전체 workspace,
Gazebo 동적 실행과 새 성능 비교를 완료한 결과로 해석하지 않는다.

운영 Jetson도 별도로 재확인했다. 로컬 `707538d` 및 Jetson `4f92bc0` 이후의
미커밋 작업에서 대상 소스 32개와 설치 메시 17종이 일치했고, 운영 install의
MoveIt 서비스가 내부 장애물 36개를 모두 검출했다. 양팔 계획은 각 5회, 총
10회 성공했다. 운영 라이브러리를 교체하지 않았으며 trajectory execution을
끄고 수행했다. 이 결과와 PR의 독립 패키지 검증을 구분한다.

원본은 `/home/cleany/cleany-data/reports/pr64-update-20261029/`에 보관한다.
`native/hash-verification.json`, `native/services.json`과 MoveIt 로그가 운영 확인,
`pr-build-*.log`, `pr-models.xml`, `pr-tests/`, `pr-service-final.log`가 PR 검증
근거다. 실패 로그는 `pr-build.log`, `pr-package-tests.log`와
`pr-service-env-failure.log/.xml`에 남겼다. 로컬 사본은
`/Users/hyeon/workspace/cleany/output/pr64-update-20261029/`에 있다.

### PR 64 미사용 경로 정리 검증 (2026-10-30)

`a84daa7`에 이 절과 함께 반영한 정리 패치를 Jetson Ubuntu 22.04 ARM64,
Humble과 MoveIt 2.5.9의 별도 경로에서 검사했다. 미사용 표면 단순화와 전용
검사 3개를 제거했다. 내부 장애물 36건의 자세를 공통 3개로 묶고 원본 입력과
기대 결과가 모두 같음을 확인했다. STL 17종의 hash, 삼각형 3,966개와 조각별
형상 검증 수치는 유지했다. 설치된 메시와 manifest 18개도 소스와 일치한다.

4개 패키지 빌드, 형상 82개, 충돌과 계획 설정 및 Mock 검사 30개가 통과했다.
`make test-moveit-collision`과 기존 Mock 계획, 종료 CTest를 실행했으며 실패와
skip은 없다. NumPy/SciPy 경고 2개는 유지된다. 가상 장애물과 Mock 하드웨어를
사용했고 실물 모터, 전체 workspace 및 Gazebo 동적 검사는 실행하지 않았다.
소스 패치, 환경, 로그, JUnit과 자산 보존 근거는
`/home/cleany/cleany-data/reports/pr64-65-cleanup-20261029T233007Z/pr64/`에 보관한다.

CI 수정 중 main의 c8461d66 병합으로 생긴 Makefile과 TESTING/EVIDENCE의 append 충돌은
양쪽 target과 기록을 모두 보존해 해소했다. 병합 후 CI 도구 9건, ToF 순수 91건과
navigation colcon 198 reported tests가 통과했고 전체 rosdep simulate도 재통과했다.
remote CI는 이 통합 tree에서 다시 실행한다.

## 2026-11-02 책상 접근 ROS 검사의 수신 준비 동기화

최신 main 통합 head d82edca4의 CI run 41369304125는 의존성 이미지 생성과 환경 검증을
통과했지만 전체 2720 reported tests 중 부분 품질 책상 접근 검사 1건에서 goal 거부로
실패했다(32 skipped). 같은 제어 코드는 직전 run 41367607054에서 전체 통과했다.
기존 검사는 publisher sequence 증가만 기다려 서버의 실제 입력 수신과 권한 준비를
보장하지 않았다. 검사에서 서버가 수신한 frame/odom의 나이가 source_timeout_s의
1/4 이내이고 해당 Mission lease가 유효한지 확인한 뒤 요청하도록 바꿨다. 부분 품질
시나리오는 실제 수신 관측에 UNRELIABLE 12개가 있는지도 요구한다. goal 수락, 전진,
cancel과 정지 assertion은 유지했고 운용 코드와 freshness/lease 한계는 변경하지 않았다.

Humble Distrobox의 2 CPU affinity에서 ROS graph 11건과 make test-tof의 colcon
247 reported tests가 통과했다(errors/failures 0, 기존 opt-in skip 15). ToF package 자체는
74건, skip 0이다. 실제 로봇을 사용하지 않았다.

다른 ROS graph 검사 종료 후 두 시나리오를 2 CPU affinity에서 순차 20회씩, 총 40회
반복해 통과했다. 재현 script와 로그는 CLEANY_DATA_ROOT/runs/ci-pr71-fix의
repeat_ready.py와 readiness-repeat.log다.

## 2026-11-02 FreeCAD 정적 기준 모델

`707538de9d28291c679fcfd954f5587368d5a460` 기반의 기존 미커밋 작업을 유지하며
`Cleany-final.FCStd`를 별도 정적 기준 모델로 반영했다. 원본은
`~/Downloads/Cleany-final.FCStd`이며 SHA-256은
`91c26ec2eb8d1227fe9a0a18ded1235fcde257d2ef94cf9d345d337511625ff0`이다.
macOS 26.6.2 arm64, Python 3.12.14, OCP 8.0.1.1.0, MuJoCo 3.17.0에서 확인했다.

| 검증 | 결과 |
|---|---|
| 원본 형상 | 308개 입체 부품, 화면 1개, 최종 입체 메시 934,253개 삼각형 |
| 자동 검사 | `make test-freecad-model GEOMETRY_PYTHON=/tmp/cleany-cad-comparison/venv/bin/python`: 16개 통과 |
| 독립 CAD 대조 | 삼각분할을 사용하지 않은 BREP 경계와 308개 부품 대조; 최대 차이 0.1694 mm |
| 재현성 | 별도 출력 디렉터리에서 다시 내보낸 모델·자산·manifest 315개 파일이 바이트 단위로 동일 |
| 파서와 정적 실행 | URDF 파서, Collada 텍스처 로드, MuJoCo 로드와 FK 통과; 구동 관절·actuator·추정 질량 없음 |
| 코드와 범위 | 추가 Python의 Ruff 검사와 `git diff --check` 통과; 기존 제어 URDF와 canonical MJCF 수정 없음 |
| ROS 빌드 | `make build BASE_EXEC= COLCON_BUILD_ARGS='--packages-select cleany_description'` 실패: `/opt/ros/humble/setup.bash` 없음. Docker daemon도 사용 불가 |

초기 변환에서 작은 면의 삼각분할 누락과 헤드 브래킷의 원점으로 튀는 정점을
발견했다. 각 원본 면의 해석적 경계로 확인하고 더 세밀하게 다시 삼각분할하여
수정했다. MuJoCo의 STL당 200,000개 삼각형 제한은 LiDAR 메시를 순서대로
분할하여 해결했으며, 원본 삼각형의 삭제나 단순화는 하지 않았다. 초기 검사에서
발견한 XML 공백 비교 오류도 수정한 뒤 전체 검사를 다시 통과했다.

검증 원본은 `$CLEANY_DATA_ROOT/runs/freecad-model-20261102/`의
`environment.json`, `tests.txt`, `independent-geometry-check.json`,
`reproducibility.json`, `preview.png`에 있다. 저장소의
[형상 manifest](../ros2_ws/src/cleany_description/config/geometry/freecad_final.json)는
입력과 부품 해시를 보존하고, [미확정 항목](../ros2_ws/src/cleany_description/docs/freecad-model.md)은
관절, 집게, TCP, 관성, 센서 보정과 실행 검증을 구분한다. ROS 실시간 launch,
RViz, 동적 파지와 주행, 실물 장착·보정은 검증하지 않았다. 배포, commit과 push는
수행하지 않았다.

## 2026-11-05 손목 카메라 실측 깊이 반영

`2178772352ea293d926b80849d0878c3c0a15ed3` 기반 작업 트리에서 원본
`Cleany-final.FCStd`와 사용자 확인 치수 A–B 9.5mm, A–C 26.7mm를 사용했다.
기준은 앞 유리 끝 A, PCB 뒤면 B, 마운트 최후단 C이며 광축 방향으로 잰다.
PCB와 체결 위치를 기준으로 렌즈 끝을 14.8mm 뒤로 옮기고 마운트 최후단을
1.2mm 뒤로 옮겼다. 양쪽의 렌즈, 유리, 마운트 6개 STL과 그 manifest만
바뀌었다. 다른 부품 레코드와 URDF 및 MJCF XML은 같은 바이트였다.
내보내기 도구가 `freecad_wrist_camera_depth.json`으로 같은 형상을 재생성한다.

비교 입력은 `freecad-head-servo-check-20261105/moveit-head-surfaces/`이며,
실측한 마운트는 틈과 끝면을 유지하는 표면 메시로 읽는다. 최종 MoveIt 메시
삼각형은 135,935개, 충돌 형상은 173개다. 양쪽 STL과 직렬화한 충돌 메시의
광축 치수를 대조했다. Jetson Orin ROS Humble localhost domain 230에서
기존 34개 자세의 엄격 검사 접촉 쌍이 모두 같았다. 엄격 검사 유효 자세는
0/34개이며 조립 접촉을 분리한 임시 시험 scene은 34/34개였다. 같은 scene의
외부 장애물 검사도 통과했다. 제품 접촉 허용 규칙에는 변경이 없다.

34개 자세에서 카메라 형상은 입구 공간을 침범하지 않았고, 접촉 패드 4개의
삼각형과 관절 변환은 동일했다. -25° 비교 자세의 양쪽 개구 폭은 12.0137mm다.
입구 점군 122점과 접촉 62건이 통과했다. 양쪽의 이전 렌즈 앞 위치는 빈 공간,
새 렌즈 앞과 마운트 뒤 표면은 접촉으로 판정해 6개 카메라 외부 장애물 검사가
통과했다. OctoMap 합성 입력의 해시가 같고, Jetson의 격리된 description
빌드와 Python 검사 61개가 통과했다. Python 실행에 VTK 경고 2개가 있었다.

입력, `verification-summary.json`, `assembly-results.json`, `camera-probes.log`,
`aperture.log`와 `wrist-camera-before-after.png`는
`cleany-data/runs/freecad-camera-depth-20261105/`에 있다. 커밋과 푸시는
수행하지 않았다.

## 2026-11-05 손목 카메라의 OctoMap 및 cuRobo 반영 검사

`2178772352ea293d926b80849d0878c3c0a15ed3` 기반 작업 트리에서
`freecad-head-servo-check-20261105/moveit-head-surfaces/`와 실측 A–B 9.5mm,
A–C 26.7mm를 반영한 `freecad-camera-depth-20261105/moveit-cache/`를 대조했다.
Jetson Orin에서 ROS Humble localhost domain 229와 230으로 격리하고
OctoMap 1.9.7, cuRobo 0.7.8과 CUDA 12.6을 사용했다.

OctoMap 10mm 격자에서 양쪽의 이전 렌즈 앞 위치는 실측 반영 후 합성 장애물
점으로 남아 점유됐다. 새 렌즈 앞과 마운트 뒤쪽 4점은 자체 필터가 제거했다.
-25° CAD 비교 자세의 양쪽 입구는 12.0137mm이고 패드 4개의 삼각형이 같다.
전후 모두 입구 점 90개를 유지하고 패드 점 32개를 제거했다. 입구 점만
입력하면 90개 모두 점유 셀에 들어갔다. 패드 점을 함께 입력하면 패드와
같은 셀에 속한 입구 점 24개는 전후 모두 자유 셀로 남았다. MoveIt 입구와
접촉면 장애물 검사 62건도 통과했다.

기존 cuRobo 캐시는 형상 해시 불일치로 거부됐다. 실측 MoveIt 캐시를 입력으로
새 mesh world를 생성했다. 삼각형은 136,959개이며 카메라 6개 부품의 충돌
삼각형과 기존 팁 GLB 8개의 내용이 보존됐다. Jetson GPU에서 카메라 6건,
저장 자세 표면 및 입체 2,572건, 열린 집게 184건이 통과했다.

초기 OctoMap 확인은 메시지 내부 frame을 읽어 실패했다. 외부 frame을 확인하고,
합성 점군 stamp를 TF 이력 안에 두자 변환 누락 없이 전후 검사를 통과했다.
검사 입력, 로그, OctoMap 응답, 캐시와 `verification-summary.json`은
`cleany-data/runs/freecad-camera-depth-octomap-curobo-20261105/`에 있다.
실물 점군, 운영 cuRobo 궤적 계획과 OctoMap 연동은 이 검사 범위에 포함되지 않는다.

## 2026-11-02 FreeCAD 관절축과 변화량 미리보기

동일한 `707538de9d28291c679fcfd954f5587368d5a460` 기반 작업과 원본 FCStd 해시를
사용했다. macOS 26.6.2 arm64, Python 3.12.14, OCP 8.0.1.1.0과 MuJoCo 3.17.0에서
원통면을 직접 읽어 양팔 10축, 헤드 2축, 바퀴 4축을 추출했다. 각 축은 서보와
구동 혼의 공통 중심선이며 지지 혼이 있는 경우 함께 대조했다. 16개 모두 지지되는
후보가 하나였고 최대 중심선 거리는 0.00003375 mm, 최대 축 방향 차이는
0.000003674 rad였다. 이는 CAD 내부 정합성 수치이며 실물 오차가 아니다.

좌우 PincOpen 구동축도 추출했지만 캠·링크의 연동과 개구 곡선은 확정하지 않았다.
미리보기의 `cad_delta_*`는 저장된 자세 대비 변화량이며, 물리 영점과 encoder
대응, 운용 제한은 null로 남겼다. 기존 제어 관절과 actuator는 변경하지 않았다.

`make test-freecad-model GEOMETRY_PYTHON=/tmp/cleany-cad-comparison/venv/bin/python`의
24개 검사를 통과했다. 원본 자세 재현, 6개 임의 변화량 벡터의 독립 URDF FK,
MuJoCo mocap과 실제 메시 배치, 집게의 강체 유지와 모호한 축의 거부를 검사했다.
새 URDF는 별도 파서로 17개 링크와 16개 변화량 관절을 읽었다. 분리된 출력 경로에서
재생성한 manifest, URDF와 MJCF는 바이트 단위로 동일했다. Ruff와
`git diff --check`도 통과했다.

표시용 입력은 양팔 yaw ±15°, head pan +15°, 양팔 elbow ±10°이며 24프레임 GIF를
생성했다. 각도는 검증용 입력이고 실제 가동 범위나 안전한 자세를 뜻하지 않는다.
원본은 `$CLEANY_DATA_ROOT/runs/freecad-kinematics-20261102/`의 `verification.json`,
`tests.txt`, `motion.gif`, `motion.png`, `motion.json`에 보존했다.
[축 근거와 미확정 항목](../ros2_ws/src/cleany_description/docs/freecad-kinematics.md)에
링크 구조, 부품 소유와 사용 제한을 정리했다.

ROS 패키지 빌드는 `/opt/ros/humble/setup.bash`가 없어 시작하지 못했다.
`ros-build.txt`에 실패를 보존했다. ROS launch, RViz, 물리 시뮬레이션과 실물
동작은 미검증이며 모터 명령, 배포, commit과 push는 수행하지 않았다.

## 2026-11-02 FreeCAD 집게 핀 연동

같은 `707538de9d28291c679fcfd954f5587368d5a460` 기반 작업과 FCStd 원본을 사용해
PincOpen 캠·로드의 공통 원통축을 분석했다. 환경은 macOS 26.6.2 arm64,
Python 3.12.14, OCP 8.0.1.1.0, NumPy 2.5.4, MuJoCo 3.17.0이다.
캠-혼의 중앙축과 네 체결 구멍, 편심핀-구동 로드, 로드-내측 링크, 고정판-내·외측
링크, 손끝 운반 링크의 핀을 연결해 양손 각각 두 개의 명목 폐쇄 링크를 만들었다.

내·외측 링크 길이 40 mm, 고정축·손끝 핀 간격 11.5 mm와 구동 로드 약
32.64768 mm를 확인했다. 편심핀 사이 각도 178.68°는 180°로 보정하지 않았다.
저장된 자세의 교점 방향을 유지하며, 해가 없거나 접선으로 합쳐지는 자세는
계산 오류로 처리한다. 기존 팔·헤드·바퀴 16축은 변경하지 않았다.

명목 연동은 캠 입력 2개와 종속 좌표 16개를 추가한다. 전체 34개 좌표 중 독립
입력은 18개다. `make test-freecad-model`의 36개 검사를 통과했다. 양손의
캠 변화량 `[-0.6, -0.3, 0, 0.15]` rad 표본에서 핀 거리의 최대 수치 잔차는
`1.39e-17` m였다. 이는 수학적 폐쇄 검사이며 실물 정밀도가 아니다. URDF와
MuJoCo에서 움직이는 핀 위치도 대조했다. 새 URDF는 별도 파서로 35개 링크와
34개 관절을 읽었으며 재생성한 manifest, URDF, MJCF는 바이트 단위로 동일했다.
Ruff와 `git diff --check`도 통과했다.

오른쪽 캠 변화량 -25°로 24프레임 GIF를 만들었다. 덮개와 서보 일부를 숨기고
링크 종류별 진단 색상을 사용했으며 실제 동작 한계나 안전한 입력값으로 채택하지
않았다. 검증 원본은 `$CLEANY_DATA_ROOT/runs/freecad-gripper-20261102/`의
`verification.json`, `tests.txt`, `gripper.gif`, `gripper.png`, `gripper.json`이다.
[연결 근거와 미확정 항목](../ros2_ws/src/cleany_description/docs/freecad-gripper.md)에
형상 해석과 적용 범위를 기록했다.

물리 영점, encoder 대응, 실물 개구 폭 보정과 접촉·유격·마찰은 미확정이다.
외피·팁·패드는 명목 시각 부품으로 손끝 운반 링크를 따라가지만 체결·수동 회전·탄성
구속은 확정하지 않았다. ROS 빌드는 `/opt/ros/humble/setup.bash` 부재로 시작하지
못했으며 `ros-build.txt`에 보존했다. 실제 제어·구동과 파지는 검증하지 않았고
모터 명령, 배포, commit과 push는 수행하지 않았다.

## 2026-11-02 FreeCAD 팁 체결 자리

동일한 `707538de9d28291c679fcfd954f5587368d5a460` 기반 작업과 원본 FCStd를 사용했다.
macOS 26.6.2 arm64, Python 3.12.14, OCP 8.0.1.1.0에서 네 팁의 원통 구멍과
강체 회전 간섭을 분석했다. 공통축에서 운반 링크의 구멍 2.05 mm, 팁·쉘의
구멍 3.10 mm, 쉘의 추가 자리 5.50 mm를 확인했다. 쉘과 운반 링크의 최소
거리는 약 0.20217 mm다. 원본 위치의 체적 중첩은 없었다.

공통축에 대한 ±0.1°, ±1° 검사에서 네 팁 모두 내부 팁 형상과 운반 링크의
교차 체적이 양수였다. 쉘 하나만의 여유 공간을 팁 전체의 자유 회전으로
해석하지 않았다. 이 근거로 명목 조립 모델에서 네 팁을 운반 링크의 고정
자식으로 분리했다. 새로운 수동 회전 좌표나 운용 제한은 추가하지 않았다.
나사 규격, 체결력, 패드 고정 방법, 실제 탄성과 유격은 null로 남겼다.

`make test-freecad-model`의 43개 검사를 통과했다. 변경된 URDF는 파서로 39개
링크와 38개 관절을 읽었으며 이 중 회전 변화량은 기존 34개, 고정 연결은 4개다.
고정 팁의 상대 배치와 MuJoCo 배치를 대조했고, 재생성한 manifest·URDF·MJCF는
바이트 단위로 같았다. Ruff와 `git diff --check`도 통과했다.

검증 원본은 `$CLEANY_DATA_ROOT/runs/freecad-tips-20261102/`의 `verification.json`,
`reproducibility.json`, `tests.txt`, `gripper.gif`와 `gripper.json`이다.
[팁 분석 근거와 남은 실물 확인](../ros2_ws/src/cleany_description/docs/freecad-tip-mounts.md)에
적용 범위를 기록했다. ROS 빌드는 Humble setup 부재로 시작하지 못했으며
`ros-build.txt`에 보존했다. 실제 팁의 고정력·변형·파지 성능이나 실물 구동은
검증하지 않았고 모터 명령, 배포, commit과 push는 수행하지 않았다.

## 2026-11-04 FreeCAD 메시 중복 제거

`af6cddd9` 기반에서 위와 동일한 FCStd 입력을 Python 3.12와 MuJoCo 3.17.0으로
검증했다. LiDAR의 250,442개 삼각형을 합쳐 기존 STL과 바이트 단위로 대조했고,
나머지 자산과 운동학 manifest도 기존 파일과 일치했다. 자동 검사 50개와 URDF
두 파일의 xacro 처리를 통과했다. 이전 schema 1 출력에서 다시 내보낸 320개
파일이 이번 출력과 바이트 단위로 같았으며 기존 통파일과 분할 디렉터리는
제거됐다. 테스트에서 주입한 출력 실패 후 재시도와 사용자 파일 보존도 확인했다.
헤드 회전 미리보기는 로컬 `/tmp/cleany-freecad-dedup.bOWzos/full-preview.gif`에
생성했다. 원본 검증 기록은 `$CLEANY_DATA_ROOT/runs/freecad-mesh-dedup-20261104/`의
`migration.json`, `verification.json`, `export_freecad_model.txt`,
`extract_freecad_kinematics.txt`에 있다. ROS 빌드는 Humble setup 파일 부재로
시작하지 못했으며 오류를 같은 경로의 `ros-build.txt`에 보존했다.

## 2026-11-04 Jetson FreeCAD 배포와 ROS 확인

`6f915e04`와 namespace/frame prefix 변경을 Jetson Orin의 Ubuntu/Humble에서
검증했다. 소스는 `/home/cleany/cleany-freecad-model-update`에 두고 worktree별
overlay로 `cleany_description`을 빌드했다. 자동 검사 50개를 통과했으며, 기존
system Python의 SciPy가 NumPy 1.26.1에 대해 버전 경고를 냈다.
ROS domain 174의 localhost 검사에서 정적 모델의 고정 TF 24개와 운동학 모델의
고정 TF 4개, 회전 TF 34개를 수신했다. 표시용 head pan 0.05 rad의 quaternion,
namespace 적용과 기본 namespace 실행도 확인했다.

사용자 service `cleany-cad-reference`는 domain 0의 `/cad_reference/` 토픽과
`cad_reference/` TF frame으로 정적 기준 형상을 제공한다. 실물 mapping service와
함께 실행 중인 상태를 확인했다. 검증 원본은 Jetson의
`~/cleany-data/runs/freecad-jetson-20261104/`에 있는 `ros-verification.json`,
`service-verification.json`, 모델별 launch 로그와 `default-launch.txt`다.

실물 mapping 프로파일 `mapping_cad_20261104.yaml`은 CAD +Y를 전방으로 기록하지만
이 모델은 CAD -Y를 전방으로 사용한다. 실물 팔의 11월 2일 영점도 이전 URDF
기준이다. 조립 상태, 전방과 높이 원점의 대응 및 새 CAD 자세의 encoder 대응이
미확정이므로 실물 관절 피드백, MoveIt, 모터 제어로의 연결은 보류 상태다.

## 2026-11-04 실물 전방 확인과 LiDAR 위치 수정

사용자가 실물이 FreeCAD와 같은 구성이고 LiDAR 장착 쪽이 전방이라고 확인했다.
`a2f44d30` 기반 모델의 CAD -Y → ROS +X 규약과 일치한다. LiDAR 회전부의
CAD 입체 경계에서 Y 중심 -139.275mm를 대조하고, Jetson의 기존 mount x=-0.139275m를
`mapping_cad_lidar_front.yaml`의 +0.139275m로 수정했다. 기존 전방 표적 관측의
yaw=180도와 평면 높이 규약 z=0을 사용하며 광학 원점 실측값으로 취급하지 않는다.

변경 전 5초간 바퀴 피드백과 명령의 정지를 확인했다. 처음 저장 요청은 기존 로거의
`get_config` 응답 timeout으로 실패했다. Cartographer WriteState로 33,394,847-byte
pbstream을 별도 보존했고, service 종료 재시도에서 `mapping_saved=true`와
`stop_confirmed=true`를 확인했다. 새 프로필로 재시작한 세션은
`hardware-slam-20261104T203935-41e3aa02`다. 5초 검사에서 raw scan 39개, filtered
scan 35개, wheel state 225개를 받았으며 실제 base_link → lidar_link의
x=0.139275m와 yaw=180도를 확인했다. 바퀴 명령과 속도는 정지 상태였다.

검증 원본은 Jetson의 `~/cleany-data/runs/freecad-front-20261104/`에 있는
`readiness.json`, `mapping-save.json`, `manual-map-save.json`,
`shutdown-before-restart.json`, `mapping-reset.json`, `live-verification.json`이다.
로컬의 같은 run 경로에 CAD 입체 경계와 변경 전 프로필도 보존했다.
실물 팔의 새 CAD 기준 영점과 집게 encoder 대응은 여전히 별도 확인이 필요하다.

## 2026-11-04 FreeCAD MoveIt, OctoMap과 cuRobo 검사

`21787723` 기반의 로컬 변경을 Jetson Orin의 Humble과 기존 cuRobo CUDA 환경에서
검사했다. `cleany_moveit_config`를 별도 overlay에 빌드했다. 기본 Humble의
PointCloudOctomapUpdater 2.5.10이 occupancy map monitor 2.5.10을 찾지 못해
실패했다. 설치된 2.5.9 호환 `moveit-scene-runtime`과
`moveit-octomap-lock` overlay로 다시 실행했다.

localhost ROS domain 177에서 MoveIt은 CAD 저장 자세의 관절 34개를 읽었다.
OctoMap은 로봇 자체 필터에 메시 309개를 등록하고 CAD `base_link`의 합성
점군 64점으로 점유 지도를 만들었다. 조회한 지도는 3,190 bytes였으며,
계획, IK와 궤적 실행 인터페이스는 없었다. cuRobo는 정적 저장 자세의 충돌
링크 24개와 삼각형 934,253개를 CUDA mesh world로 읽었다. LiDAR 표면의
시험 구는 충돌했고 외부 시험 구는 충돌하지 않았다.

원본은 Jetson의 `~/cleany-data/runs/freecad-planning-20261104/`에 있는
`moveit-octomap.log`, `moveit-octomap-isolated.log`,
`scene-result-isolated.json`, `curobo-result-final.log`다. 운영 프로필을
전환하려면 [필요한 확인](../ros2_ws/src/cleany_moveit_config/docs/planning.md#freecad-형상-검사)을
완료해야 한다.

## 2026-11-04 FreeCAD 충돌 메시 인덱싱

`21787723` 기반의 미커밋 FreeCAD 검사 구성에서 STL 충돌 메시 309개를
GLB 캐시로 인덱싱했다. 934,253개 삼각형의 순서와 꼭짓점 좌표를 대조했고,
URDF는 충돌 메시 경로만 달라졌다. 충돌 메시 입력은 46,738,606 bytes에서
17,028,876 bytes로 줄었다. 손상된 캐시와 다른 형상 manifest를 거부하는
검사 1개와 FreeCAD 관련 검사 50개가 통과했다.

Jetson Orin의 Humble 2.5.9 호환 overlay에서 MoveIt과 OctoMap은 각 형식을
두 번 검사했다. 프로세스 시작부터 점유 지도를 조회하기까지 평균 시간이
STL 36.838초에서 GLB 29.056초로 줄었다. 네 번 모두 같은 64점 입력의
3,190-byte OctoMap 해시가 일치했다. 초기 PLY 후보는 Jetson의 Assimp 5.2
후처리에서 종료되어 GLB로 바꿨다.

CUDA를 초기화한 뒤 cuRobo mesh world 준비와 두 시험 구 검사에 걸린 시간은
형식당 세 번 측정한 중앙값으로 6.836초에서 4.433초로 줄었다. 모든 표본에서
LiDAR 표면 구는 충돌했고 차체 밖 구는 충돌하지 않았다.

원본 측정은 Jetson의 `~/cleany-data/runs/freecad-optimization-20261104/`에
있는 `scene-benchmark.json`, `curobo-benchmark.json`, `scene-*.log`와
`moveit-2-indexed.log`다. 로컬의 같은 run 경로에 `geometry-verification-glb.json`을
보존했다.

## 2026-11-04 FreeCAD 표면 감면과 cuRobo 링크 캐시

`21787723` 기반 미커밋 변경에서 VTK 9.6.2로 충돌 메시 감면 후보를 만들고,
원본과 결과의 양방향 표면 거리 상한을 0.1mm로 검사했다. 경계와 비다양체
edge 및 Euler characteristic을 보존하고 원본 꼭짓점만 사용했다. 최종 캐시는
265개 메시를 감면해 삼각형 934,253개를 760,943개로 줄였다. 309개 GLB 입력의
크기는 17,028,876 bytes에서 13,908,916 bytes로 줄었다. 관절, 링크 변환과
시각 모델 XML은 그대로였다. cuRobo용 24개 링크 파일은 같은 삼각형 배열을
미리 합친 것으로, 입력 배열과 저장 후 배열의 일치를 확인했다.

첫 감면본의 GPU 대조에서는 3,740개 시험 구 중 왼팔 카메라 묶음에서 1개의
내부와 외부 판정이 달랐다. 해당 위치의 최근접 표면과 거리는 같았으며,
표면 거리 상한만으로 GPU 부호 판정의 동일성을 보증할 수 없었다.
`--preserve-link cad_snapshot_LeftCameraComponents`로 그 묶음의 원본 삼각형을
보존한 최종본은 3,740개 판정이 모두 일치했다. 이것은 저장 자세의 회귀 검사이며
실물 또는 모든 자세의 충돌 안전성을 입증한 결과가 아니다. Jetson trimesh 4.5.3의
GLB 로더가 Scene을 반환하던 실패는 `load(..., force="mesh")`와 단일 재질 내보내기로
처리했다.

Jetson Orin의 CUDA 초기화 뒤 mesh world 준비와 두 시험 구 검사 시간을
각 방식 세 번 측정했다. 기존 인덱스 캐시는 중앙값 4.792초, 개별 감면 캐시는
4.765초, 링크를 미리 합친 최종 캐시는 2.479초였다. 궤적 계획이나 반복 충돌
질의 속도를 측정한 값은 아니다. MoveIt과 OctoMap은 Humble 호환 overlay와
localhost domain 199에서 최종본을 읽었고, 34개 관절과 309개 자체 필터 메시를
확인했다. 합성 점군 64점의 3,190-byte 지도 해시는 기존 결과와 같았다.
초기 감면본의 교차 측정에서는 MoveIt 시작 시간의 뚜렷한 개선을 확인하지 못했다.

오프라인 관련 검사 60개와 별도 overlay 빌드가 통과했다. 검사 프로세스는
종료했고 운영 mapping과 CAD reference 서비스는 계속 실행 중이었다.
원본은 로컬과 Jetson의 `cleany-data/runs/freecad-reduction-20261104/`에 있는
`surface-cache-verified/manifest.json`, `world-cache-verified/manifest.json`,
`geometry-final-verification.json`, `curobo-final-benchmark.json`,
`curobo-final-probes.npz` 및 `scene-final-result.json`이다. 초기 실패와 후보의
측정도 같은 run에 보존했다. 커밋, 푸시와 운영 모델 전환은 수행하지 않았다.

## 2026-11-05 FreeCAD MoveIt 하부 단순 형상

`2178772352ea293d926b80849d0878c3c0a15ed3` 기반 미커밋 변경에서
`surface-cache-verified`의 하부 메시 137개를 박스 49개와 바퀴 원통 4개로
대체했다. 원본 STL의 꼭짓점 181,468개가 직렬화된 형상 안에 들어가는지
확인했다. 바퀴는 추출한 관절축을 유지하며 0, 0.4, 1.2, π rad의 수치
회전에서도 포함 관계를 검사했다. 회전 계산의 최대 음수 잔차는
5.21e-17 m 이내였다. 이 각도들은 검사 입력이며 운용 한계가 아니다.
유지한 메시 172개의 파일 해시와 collision origin, 모든 비충돌 XML은
입력과 같았다. 하부의 작은 구멍과 홈을 채우는 보수적 근사이므로 이전의
0.1mm 표면 거리 상한은 대체한 부품에 적용하지 않는다.

| 항목 | 표면 감면 캐시 | MoveIt 하부 단순 형상 |
|---|---:|---:|
| 충돌 형상 수 | 메시 309개 | 메시 172개, 박스 49개, 원통 4개 |
| 메시 삼각형 | 760,943 | 449,649 |
| GLB 입력 bytes | 13,908,916 | 8,208,276 |
| 시작부터 첫 OctoMap 조회까지 평균 | 14.148초 | 9.941초 |
| 자체 필터 형상 준비 평균 | 5.061초 | 3.393초 |

시간은 Jetson Orin의 Humble 호환 overlay에서 localhost domain 205~208로
각 구성을 두 번씩 교차 측정했다. 반복 충돌 질의나 궤적 계획 성능은 측정하지
않았다. 모든 실행에서 관절 34개, 계획과 실행 인터페이스 비활성화를 확인했고,
기존 합성 점군 64점의 3,190-byte OctoMap 해시가 같았다.
추가 165점 중 하부 내부의 137점은 자체 필터에서 제거되고 외부 24점과
40mm 패널 틈의 4점은 유지됐다. 차체, 라이다, 바퀴 등의 표면 7곳은
2mm 시험 박스와 접촉했고, 패널 틈과 외부 5곳은 접촉하지 않았다.
기존 자기 접촉은 시험 장애물과의 접촉으로 세지 않았다.

오프라인 관련 검사 65개, Ruff와 별도 overlay 패키지 빌드가 통과했다.
최초 runtime 검사에서는 JSON의 정수 0을 ROS float 필드에 넣어 실패했으며
명시적인 float 변환 후 네 번 모두 통과했다. 검사 프로세스는 종료했다.
재개 시점과 종료 시점 모두 CAD reference 서비스는 active, hardware mapping
서비스는 inactive였으며 이 작업에서 서비스를 시작하거나 중지하지 않았다.
cuRobo 캐시, 실물 보정과 운영 모델은 변경하지 않았고 커밋이나 푸시도 하지 않았다.

원본은 로컬과 Jetson의 `cleany-data/runs/freecad-moveit-primitives-20261104/`에
보존했다. `moveit-cache/manifest.json`은 생성 근거와 해시,
`geometry-verification.json`은 포함 관계와 보존 검사,
`scene-benchmark.json`과 `scene-*.log`는 네 번의 실행 결과다.
`lower-body-probes.json`과 `make_probes.py`는 입력과 생성 스크립트이며,
`failed-integer-probe/`는 초기 실패다. 전후 렌더링은
`moveit-lower-body-optimization.png`, 미커밋 소스의 식별자는
`verification-summary.json`에 있다.

## 2026-11-05 FreeCAD 투입구 보존과 상부 추가 감면

사용자가 몸통 내부를 채우되 팔 뒤의 상판 투입구와 아래 공간을 남기고,
마스트와 헤드 마운트 내부를 채우도록 확인했다. `2178772352ea293d926b80849d0878c3c0a15ed3`
기반 미커밋 변경에서 두 상판 메시의 수평 윗면 경계를 추출했다. 공통 투입구는
base frame의 x=-0.180~-0.010m, y=-0.230~0.230m인 170×460mm 사각형이다.
몸통은 박스 5개의 합집합으로 채우고, 이 투입구부터 기존 내부 횡대 윗면
z=-0.1445m까지 비웠다. 이전 단순 박스가 막았던 투입구를 복원한 것이다.
실물 통의 바닥이나 사용 가능 깊이를 결정한 것은 아니다. 몸통 측면 틈은
채웠으며 그 근처 라이다 TF나 시각 메시를 바꾸지 않았다. 바닥 부근에서
투입구 안쪽으로 돌출한 IMU 부품은 몸통에서 제외하고 별도 충돌 형상으로 유지했다.

마스트, 고정 지지대와 관절별 헤드 마운트를 박스로 바꾸고 바퀴 원통은 유지했다.
몸통의 원본 삼각형 342,574개가 빈 공간을 가로지르지 않는지 clipping으로
검사했으며, 별도 표면 표본 2,398,018개도 다섯 박스 안에 있었다. 개별 단순
형상 26개와 비충돌 XML 보존을 확인했다. 팔 본체와 헤드 하우징은 원본 STL에서
0.5mm 양방향 표면 거리 상한으로 다시 감면했다. 83개 메시가 더 줄었고,
집게, 팁, 손목 카메라 묶음과 헤드 광학창을 포함한 81개 메시의 해시는 이전과
같았다. 해당 허용치는 검사 메시 근사치이며 실물 보정값이나 충돌 padding이 아니다.

| 항목 | 앞선 하부 캐시 | 이번 캐시 |
|---|---:|---:|
| MoveIt 메시 삼각형 | 449,649 | 294,780 |
| 충돌 형상 | 메시 172, 박스 49, 원통 4 | 메시 164, 박스 22, 원통 4 |
| GLB 입력 bytes | 8,208,276 | 5,418,108 |
| 팔 베이스 하우징 삼각형 | 10,053 | 4,519 |
| 헤드 카메라 하우징 삼각형 | 18,774 | 8,936 |
| 시작부터 첫 OctoMap 조회까지 평균 | 9.957초 | 7.491초 |
| 자체 필터 형상 준비 평균 | 3.407초 | 1.902초 |

Jetson Orin의 기존 Humble 호환 overlay에서 localhost domain 211~214로 각
구성을 두 번씩 교차 실행했다. 모든 실행의 기존 64점 OctoMap 해시가 같았다.
추가 점군 129점에서 단순 입체 내부 30점은 제거되고 투입구와 외부의 99점은
유지됐다. 시험 박스 접촉 49곳도 두 번 모두 예상과 일치했다. 계획과 실행
인터페이스는 없었으며 준비 시간은 궤적 계획 성능을 뜻하지 않는다.

cuRobo는 같은 CAD 저장 자세를 객체 61개, 삼각형 296,068개로 읽었다.
박스는 독립 객체, 원통은 외접 64각 기둥으로 변환했다. 바퀴의 반지름 확장은
약 0.077mm이며 저장 좌표는 float32다. 초기 GPU 검사에서는 기본 0.1m 거리
탐색 범위 때문에 큰 몸통 중앙 한 점을 놓쳤다. 객체 경계 상자의 최대 대각선
0.73246m를 검색 범위로 적용한 뒤 몸통 내부, 투입구 경계와 메시 표면을 포함한
1,181개 시험 구가 모두 예상과 일치했다. GPU 표면 분류를 모든 관절 자세의
실물 안전 검증으로 확대하지 않는다.

오프라인 관련 검사 69개와 Ruff가 통과했다. 이번 변경은 오프라인 캐시 도구와
설정이며 native 검사는 앞서 빌드한 별도 overlay를 사용했다. 커밋, 푸시,
운영 모델 전환과 실물 보정값 추가는 수행하지 않았다.
원본은 로컬과 Jetson의 `cleany-data/runs/freecad-body-arm-20261105/`에 있는
`moveit-cache/manifest.json`, `world-cache-verified/manifest.json`,
`geometry-verification.json`, `scene-benchmark.json`, `body-probes.json`,
`curobo-probes.json`, `curobo-probes.npz`, `curobo-result-verified.log`다.
초기 GPU 실패는 `failed-default-query-distance/`에 보존했다.
0.1mm 한도에서 감면 방법을 비교한 실험과 0.25/0.5/1mm 후보 결과도 같은
run의 `*-experiment.*`에 있다. 전후 그림은 `body-head-optimization.png`와
`curved-mesh-comparison.png`, 소스 해시와 명령은 `verification-summary.json`에 있다.

## 2026-11-05 FreeCAD 기둥 상세화와 팔 분할 외피

사용자 요청에 따라 `2178772352ea293d926b80849d0878c3c0a15ed3` 기반 미커밋
변경에서 마스트의 단일 박스를 높이별 8개 닫힌 외피로 교체했다. 내부는
채우면서 좁은 허리와 넓은 밑부분을 보존했다. 삼각형은 원본 8,316개에서
672개가 됐다. 다른 헤드 마운트와 몸통 투입구는 직전 캐시와 같다.

팔은 기존 `optimize_arm_collision_meshes.py`의 분할과 supporting-plane 외피
알고리즘을 재사용했다. 예전 관절 좌표나 메시를 복사하지 않고 새 FreeCAD
부품에서 분할 평면을 선택했다. 어깨와 손목의 큰 포크 틈은 나눠 유지하며
작은 구멍은 채운다. 팔의 조각별 볼록 외피 확장 상한은 1mm, 마스트는
0.25mm다. 이는 오목한 CAD 표면과의 거리 상한이나 실물 보정값이 아니다.
71개 부품의 외피 198개에서 원본 삼각형 분할 면적의 합, 직렬화한 GLB의
닫힘과 원본 조각 포함을 확인했다. 최대 외피 확장은 0.9871mm다. 유지한
94개 메시의 해시, 몸통 투입구 명세와 비충돌 XML은 직전 캐시와 같았다.

| 항목 | 직전 캐시 | 이번 캐시 |
|---|---:|---:|
| 팔 본체 메시 삼각형 | 142,676 | 8,568 |
| 전체 MoveIt 메시 삼각형 | 294,780 | 161,344 |
| 충돌 형상 | 메시 164, 박스 22, 원통 4 | 메시 292, 박스 21, 원통 4 |
| GLB 입력 bytes | 5,418,108 | 3,124,352 |
| 시작부터 첫 OctoMap 조회까지 평균 | 7.417초 | 7.022초 |
| 자체 필터 형상 준비 평균 | 1.918초 | 1.022초 |

검사 전용 `cleany/CADInspectionFCL`은 명시한 닫힌 외피만 FCL 입체로 읽고
나머지 CAD 메시의 표면 검사를 유지한다. Jetson Orin의 ROS Humble에서
`cleany_moveit_collision`과 `cleany_moveit_config`를 별도 workspace로 빌드했다.
native 단위 검사 8개와 로컬 Python 검사 22개, Ruff가 통과했다. Python 검사
초기에는 용접되지 않은 STL fixture를 닫힌 GLB처럼 사용해 한 검사가 실패했다.
실제 캐시와 같은 인덱스 GLB fixture로 고친 후 통과했다.

localhost domain 215~218에서 전후 구성을 두 번씩 교차 실행했다. 새 detector의
로드 확인 로그가 있었고 궤적 계획과 실행 인터페이스는 없었다. 기존 64점
OctoMap 해시는 네 번 모두 같았다. 추가 점군 335개 중 내부 228개는 제거되고
투입구, 외부와 기둥 허리 바깥 107개는 유지됐다. 외피 내부를 포함한 장애물
접촉 255곳은 두 번 모두 예상과 일치했다. cuRobo는 동일 저장 자세의 독립 객체
250개, 삼각형 162,620개를 읽었다. 표면과 깊은 내부, 투입구 및 기둥 주변의
GPU 구 쿼리 4,607개가 모두 통과했다. 검사 범위는 CAD 저장 자세이며 실제
로봇 동작이나 모든 관절 자세의 안전을 검증한 결과가 아니다.

원본은 로컬과 Jetson의 `cleany-data/runs/freecad-enclosures-20261105/`에 있다.
`moveit-cache/manifest.json`, `world-cache/manifest.json`은 생성 근거와 해시,
`geometry-verification.json`은 외피 포함과 보존 검사,
`scene-benchmark.json`, `scene-*.log`, `lower-body-*-after.txt`는 native 결과다.
`body-probes.json`, `prepare_probes.py`, `curobo-probes.json`과 `.npz`는 입력과
GPU 결과다. 분할 후보는 `partition-candidates.json`, 렌더링은
`mast-refinement.png`, `arm-enclosure-comparison.png`, `planning-models.png`다.
빌드와 native 단위 검사 원본, 소스 해시와 실행 환경은 같은 run에 보존했다.
커밋, 푸시, 운영 모델 전환이나 미확인 보정값 추가는 수행하지 않았다.

## 2026-11-05 집게 입구 보존과 cuRobo 기본 박스 최적화

`2178772352ea293d926b80849d0878c3c0a15ed3` 기반 미커밋 변경에서 사용자 요청
순서대로 집게 고정 외장, 헤드와 손목 카메라 하우징, 고정 조각 묶음과 cuRobo
native cuboid를 적용했다. 캠, 가동 링크, 팁과 광학부 등 보호 메시 39개는
직전 캐시와 같은 해시다. 비충돌 XML, 상세화한 마스트와 뒤쪽 상판 투입구도
유지했다. 고정 외피는 저장 자세의 팁 영역보다 뒤쪽에 약 35.89mm 떨어져 있다.
이 값은 CAD 분리 거리이며 새 여유나 실물 보정값이 아니다.

| 단계 | MoveIt 메시 삼각형 | 전체 충돌 형상 |
|---|---:|---:|
| 직전 모델 | 161,344 | 317 |
| 집게 고정 외장 | 112,852 | 389 |
| 카메라 하우징 | 79,012 | 415 |
| 각 강체 부품 안의 조각 통합 | 76,196 | 275 |
| 같은 링크의 서보와 보드 부품 묶음 | 74,556 | 227 |

초기 후보는 삼각형 감소에도 GPU 4,096개 쿼리 배치가 중앙값 46.63ms에서
51.19ms로 느려졌다. 따라서 같은 링크와 메시 좌표계에 고정된 65개 원본
부품을 17개 묶음으로 통합했다. 모든 원본 해시를 기록하고, 다른 관절 링크의
병합을 거부한다. 최종 외피 163개에서 분할 면적 합, 원본 삼각형 포함과 GLB의
닫힘을 확인했다. 최종 MoveIt 입력은 메시 202개, 박스 21개, 원통 4개이며
GLB 크기는 3,124,352 bytes에서 1,494,952 bytes로 줄었다.

cuRobo는 최종 메시 192개와 기본 박스 21개를 독립 객체로 읽는다. 메시
삼각형은 162,620개에서 75,580개, GLB 크기는 3,116,184 bytes에서
1,505,976 bytes로 줄었다. 같은 박스를 메시로 만든 대조 캐시와 표시용
삼각형 배열 213개가 완전히 같았고, GPU 쿼리 4,096개의 충돌 판정도 같았다.
원통은 외접 64각 기둥 메시를 유지한다. 기본 박스에는 float32 GPU 연산 외의
물리적 여유를 추가하지 않았다.

Jetson Orin에서 동일한 4,096개 입력을 CUDA graph로 50번씩 재생하고 세 구성을
교차 순서로 7회 측정했다. 쿼리 배치 중앙값은 이전 46.863ms, 최종 형상의
메시 박스 45.506ms, native cuboid 44.454ms다. 이전 대비 약 5.1% 개선이며
삼각형 감소율과 같지 않다. 고정 자세의 합성 구 쿼리 결과로, 궤적 solver의
실행 시간이나 실물 움직임 성능을 측정한 것은 아니다.

ROS Humble의 별도 overlay에서 localhost domain 223~226으로 전후 구성을
두 번씩 교차 실행했다. 동일한 64점 OctoMap 해시와 계획·실행 인터페이스의
부재를 확인했다. 자체 필터 형상 준비 평균은 1.040초에서 0.494초가 됐다.
시작부터 첫 OctoMap 조회까지는 7.069초에서 7.257초로, 시작 전체 시간의
개선은 확인되지 않았다. 최종 캐시에서 점군 430점 중 내부 323점은 제거되고
107점은 유지됐으며, 시험 장애물 접촉 350곳도 두 번 모두 예상과 일치했다.

기존 명목 링크 해석기로 양쪽 캠에 표시용 -25° 변화를 주고 종속 관절까지
계산했다. 이 입력은 실제 영점이나 가동 범위가 아니다. 양쪽 집게 입구는
전후 모두 약 12.0137mm이며 팁 삼각형의 변환 결과가 완전히 같았다.
열린 자세의 점군 122개에서 입구의 90개는 유지되고 접촉부 내부 32개는
제거됐다. 접촉 검사 62곳도 전후 각각 두 번 모두 통과했다. GPU는 저장 자세
4,275개와 열린 자세 184개 쿼리가 모두 통과했다. Python 검사 18개와 Ruff가
통과했으며, 변경한 도구와 검사 노드는 직접 실행했다. native 검사에는 기존
`cleany/CADInspectionFCL` 빌드 overlay를 사용했다.

원본은 로컬과 Jetson의 `cleany-data/runs/freecad-tool-camera-20261105/`에 있다.
최종 입력은 `moveit-cache-final/`, `world-cache-final/`이며, 같은 박스를
메시로 읽는 대조 입력은 `world-cache-mesh-boxes-final/`이다.
`moveit-cache-final-geometry.json`, `native-box-geometry.json`,
`body-probes-final.json`, `open-probes-final.json`, `aperture-geometry-final.json`,
`final-scene-benchmark.json`, `final-gpu-saved.json`, `final-gpu-open.json`,
`final-gpu-benchmark.json`과 `.npz`에 입력과 결과가 있다. `final-*.log`와
`final-*.txt`는 native 실행 원본이다. 느렸던 후보는 `moveit-cache/`,
`world-cache/`, `gpu-benchmark.json`으로 보존했다. 전후 그림은
`moveit-before-after.png`, `curobo-before-after.png`, `gripper-preserved.png`다.
소스 해시와 환경은 `verification-summary.json`에 기록했다. 커밋, 푸시,
운영 모델 전환과 미확인 보정값 추가는 수행하지 않았다.

## 2026-11-05 그리퍼 캠과 링크 추가 단순화

`2178772352ea293d926b80849d0878c3c0a15ed3` 기반 미커밋 변경에서 집게 입구와
접촉면을 유지하며 캠, 가동 링크와 비접촉 팁을 추가 감면했다. 비교 입력은
직전 `freecad-tool-camera-20261105/moveit-cache-final/`이며 재생성 입력은
`freecad-reduction-20261104/surface-cache-verified/`와 원본 CAD STL이다.
원본 30개를 닫힌 외피 24개로 바꿨다. 캠과 혼, 팁 쉘과 삽입부는 각각 같은
관절 링크 안에서 묶었다. 캠과 링크의 볼록 외피 확장 상한은 기존 팔과 같은
1mm, 팁 뒤쪽은 0.25mm다. 이는 원본 볼록 외피 기준의 메시 근사 상한이며,
오목한 표면과의 거리 상한이나 물리적 보정값이 아니다. 나사 구멍과 내부
빈 공간은 채워졌다. 0.25mm 후보는 전체 36,580개 삼각형으로 별도 보존했다.

| 항목 | 직전 모델 | 최종 모델 |
|---|---:|---:|
| 양쪽 그리퍼와 구동부 삼각형 | 61,744 | 20,560 |
| 전체 MoveIt 메시 삼각형 | 74,556 | 33,372 |
| MoveIt 충돌 형상 | 227 | 221 |
| cuRobo 메시 삼각형 | 75,580 | 34,396 |
| cuRobo 메시 객체와 기본 박스 | 192 + 21 | 198 + 21 |
| 자체 필터 형상 준비 평균 | 0.5092초 | 0.2367초 |
| 시작부터 첫 OctoMap 조회 평균 | 7.3665초 | 7.4325초 |
| GPU 4,096개 쿼리 배치 중앙값 | 44.6933ms | 38.1804ms |

접촉 패드 4개와 광학 부품 5개는 직전 캐시와 같은 해시다. 그리퍼 외 자산,
단순 입체, 비충돌 XML, 관절축과 링크 관계도 유지했다. CAD 캠 변화량 0°부터
-25°까지 11개 비교 자세에서 패드 삼각형과 관절 변환이 일치했고, 패드 사이
입구 직육면체와 새 외피의 교차가 없었다. -25°에서 양쪽 입구 폭은 전후 모두
12.0137mm다. 이 자세 범위는 실물 영점이나 허용 동작 범위가 아니다.
전체 외피 187개의 직렬화된 닫힘, 원본 삼각형 포함과 근사 상한을 확인했다.

로컬 Python 검사 26개가 통과했다. NumPy 2.5 관련 VTK deprecation 경고 2개가
있었다. 생성 알고리즘과 native 코드는 바꾸지 않고 기존 검사 overlay를
사용했다. Jetson Orin ROS Humble의 localhost domain 227~230에서 전후를
두 번씩 교차 실행했다. 64점 OctoMap 해시는 네 번 모두 같고 계획과 실행
인터페이스는 없었다. 최종 저장 자세에서 점군 454개 중 347개를 제거하고
107개를 유지했으며, 장애물 접촉 374곳이 두 번 모두 예상과 일치했다.
열린 자세의 점군 122개 중 입구 90개를 유지하고 접촉부 내부 32개를 제거했다.
접촉 62곳도 전후 각각 두 번 모두 통과했다. GPU 저장 자세 4,419개와 열린
자세 184개 쿼리가 통과했다. 동일한 난수 입력 4,096개를 CUDA graph로 50회씩
재생하여 교차 순서 7회 측정한 배치 시간은 약 14.6% 줄었고, 이 입력의 충돌
판정 변경은 없었다. 궤적 계획 시간이나 전체 시작 시간의 개선은 확인하지 않았다.

자기 접촉은 별도 localhost domain 231에서 저장 자세와 열린 자세를 전후
대조했다. 두 자세 모두 distal–external, distal–internal, driving–internal
결합부에서 양손 합계 12쌍이 추가 검출됐다. 원본부터 자기 접촉이 있었으며
전후 모두 유효한 무충돌 계획 상태로 판정되지 않았다. 접촉 허용 규칙은
임의 추가하지 않았다. 이 결과는 검사 캐시의 감면과 외부 장애물 판정에 대한
근거이며, 실제 계획에 연결하기 전 결합부 형상 또는 허용 접촉 정책의 검토가
필요하다. 실물 동작, 영점이나 집게 구동 보정값은 검증하거나 변경하지 않았다.

원본은 로컬과 Jetson의 `cleany-data/runs/freecad-gripper-simple-20261105/`에
있다. `config-before.json`, `config-after.json`, `moveit-cache-final/`과
`world-cache-final/`이 전후 설정과 최종 형상이다. `moveit-cache-final-geometry.json`,
`aperture-sweep.json`, `final-scene-benchmark.json`, `final-gpu-*.json`과 `.npz`,
`self-contacts.json`, `added-self-contacts.json`에 입력과 결과를 보존했다.
`gripper-before-after.png`와 `moveit-curobo-before-after.png`는 실제 캐시의
전후 렌더링이다. 환경과 소스 해시는 `verification-summary.json`에 있다.
커밋, 푸시와 운영 모델 전환은 하지 않았다.

## 2026-11-05 그리퍼 결합부 형상 복원과 자기 접촉 회귀 검사

`2178772352ea293d926b80849d0878c3c0a15ed3` 기반 미커밋 변경에서 직전 그리퍼
감면으로 추가된 자기 접촉 12쌍을 형상 변경으로 제거했다. 비교 대상은 감면 전
`freecad-tool-camera-20261105/moveit-cache-final/`, 문제 외피를 가진
`freecad-gripper-simple-20261105/moveit-cache-final/`과 이번 최종 캐시다.
단일 볼록 외피가 운반 링크와 내측 링크의 포크 틈과 축 구멍을 채운 것이
원인이었다. 축 구멍까지 유지하기 위해 해당 8개 부품을 기존 표면 감면 메시로
복원했다. 단순 평면 분할로 구멍을 보존했다고 주장하거나 새 여유를 추정하지
않았다. 복원 메시의 해시는 감면 전 캐시와 같고, 입력의 양방향 표면 거리
상한은 0.1mm다. 캠, 구동 로드, 외측 링크와 비접촉 팁의 단순화는 유지했다.

| 항목 | 수정 전 | 수정 후 |
|---|---:|---:|
| 추가 자기 접촉 쌍 | 12 | 0 |
| 양쪽 그리퍼와 구동부 삼각형 | 20,560 | 32,854 |
| 전체 MoveIt 메시 삼각형 | 33,372 | 45,666 |
| 전체 cuRobo 메시 삼각형 | 34,396 | 46,690 |
| GPU 4,096개 쿼리 배치 중앙값 | 38.2349ms | 41.1975ms |

결합부 상세 형상을 유지하면서 메시와 쿼리 비용이 늘었다. 그리퍼 감면 전
기준은 MoveIt 74,556개, cuRobo 75,580개 삼각형이며 같은 실행에서 측정한
GPU 배치 중앙값은 44.6468ms다. 수정 후에도 이 기준보다 작고 빠르지만,
직전의 틈을 채운 모델보다 빠르다고 해석하지 않는다. GPU 측정은 같은 난수
입력 4,096개를 CUDA graph로 50회씩 재생하고 세 모델을 교차 순서로 7회
측정했다. 이 입력에서는 수정 전후 충돌 분류가 같았다.

Jetson Orin ROS Humble의 localhost domain 232에서 세 모델을 각각 28개
자세로 조회했다. 양쪽 CAD 캠 변화량을 0°부터 -25°까지 1° 간격으로 준 26개
자세와 한쪽만 -25°인 두 자세다. 종속 관절은 기존 명목 해석기로 계산했다.
각 자세에서 수정 전에는 감면 전 기준보다 12쌍이 많았고, 수정 후에는 전체
자기 접촉 쌍 집합이 기준과 완전히 일치했다. 실제 MoveIt 충돌 허용 행렬은
세 모델 모두 빈 행렬이며 해시도 같았다. 로컬 python-fcl 0.7.0.11로 수행한
28 × 12개 링크 거리 검사도 모두 양수였고 최소 CAD 간격은
0.3373784517mm였다. 이는 실물 유격이나 허용 가동 범위의 측정값이 아니다.
감면 전부터 있던 CAD 자기 접촉을 제거하거나 실물 계획을 승인한 결과는 아니다.

28개 자세에서 접촉 패드의 삼각형과 관절 변환은 수정 전과 같았다. 복원한
부품의 경계상자와 집게 입구 영역은 겹치지 않았다. -25° 자세의 양쪽 개구 폭은
12.0137mm를 유지했다. 변경 자산은 해당 8개 메시뿐이며, 다른 메시와 단순
입체, 비충돌 XML은 같았다. 나머지 닫힌 외피 179개의 원본 포함과 근사 상한,
보호 메시 17개의 감면 전 해시 일치를 확인했다.

localhost domain 227~230에서 전후 MoveIt과 OctoMap을 두 번씩 교차 검사했다.
64점 OctoMap 해시는 네 번 모두 같았고 계획과 실행 인터페이스는 없었다.
수정 후 저장 자세의 점군 446개 중 339개를 제거하고 107개를 유지했으며,
장애물 접촉 366곳도 두 번 모두 예상과 일치했다. 열린 자세에서는 점군
122개 중 입구의 90개를 유지하고 접촉부 내부 32개를 제거했다. 장애물 접촉
62곳도 전후 각각 두 번 모두 통과했다. GPU 저장 자세 4,411개와 열린 자세
184개 쿼리가 통과했다. 캐시 관련 Python 검사 18개가 통과했다. 생성 도구와
native 코드는 수정하지 않아 기존 검사 overlay를 사용했다. 로컬 자세 검사
스크립트에서 종속 좌표를 독립 입력 API로 다시 전달한 초기 오류가 있었으며,
독립 캠 좌표만 전달하도록 고친 뒤 전체 28개 자세 검사를 통과했다.

원본은 로컬과 Jetson의 `cleany-data/runs/freecad-gripper-joints-20261105/`에
있다. `config-before.json`, `config-after.json`, `moveit-cache-final/`과
`world-cache-final/`이 입력과 최종 형상이다. `self-sweep.json`에는 모든 접촉과
실제 충돌 허용 행렬, `self-sweep-summary.json`에는 세 모델 대조 결과가 있다.
`pair-clearance.json`, `scope-aperture-verification.json`,
`moveit-cache-final-geometry.json`, `final-scene-benchmark.json`, `final-gpu-*.json`과
`.npz`에 형상, 점군, 접촉과 성능 검사 근거를 보존했다.
`gripper-joints-before-after.png`와 `moveit-curobo-before-after.png`는 실제
캐시 렌더링이며, `verification-summary.json`에는 환경과 소스 해시가 있다.
커밋, 푸시, 충돌 허용 규칙 변경, 운영 모델 전환과 보정값 추가는 하지 않았다.

## 2026-11-05 손목 외피 접촉 수정과 원본 솔리드 대조

`2178772352ea293d926b80849d0878c3c0a15ed3` 기반 작업 트리의 충돌 설정을
수정했다. 입력은 `Cleany-final.FCStd`와 `surface-cache-verified`이며,
비교 기준은 `freecad-gripper-joints-20261105/moveit-cache-final/`이다.
원본 BREP의 배치와 자세별 링크 변환을 적용한 뒤 최소 거리와 교집합 부피를
계산했다. 저장 자세에서 검출된 26쌍 중 원본 체적 겹침이 9쌍, 부피 겹침
없는 조립 접촉이 5쌍, 원본에 0.212~0.800mm 틈이 있는 메시 근사 접촉이
12쌍이었다. 원본 겹침에는 헤드 고정 브래킷과 팬 지지 혼의 343.81mm³
겹침, 양팔의 서보와 혼 결합부가 포함된다. 원본 서보 솔리드 8개에 OCCT
유효성 경고가 있었으며, 각 체적 겹침 판정은 같은 링크 쌍의 유효한
솔리드 조합으로도 확인했다. 실물에서의 조립 의도와 공차는 별도 항목이다.

양쪽 손목 본체, 서보, 집게 상하판과 캠 조립부 22개를 틈이 있는 표면
메시로 바꿨다. 입력 표면을 그대로 복원한 후보는 138,896개 삼각형이었다.
양방향 표면 거리 상한 0.15mm, 0.25mm, 0.5mm 후보는 각각 119,262개,
114,926개, 98,444개였다. 네 후보의 30개 MoveIt 자세별 접촉 쌍이 같아
0.5mm 후보를 적용했다. 이전의 45,666개보다 삼각형은 늘었으며, 충돌
형상은 221개에서 177개로 줄었다. cuRobo 메시 객체는 198개에서 136개로
줄었다. Jetson의 동일한 4,096개 CUDA graph 쿼리 배치에서 중앙값은
41.2331ms에서 38.0825ms로 줄었으며 판정 변경은 없었다.

Jetson Orin ROS Humble의 localhost domain 232에서 30개 비교 자세의 최종
MoveIt 접촉 쌍이 원본 BREP의 체적 겹침과 조립 접촉 쌍에 일치했다. 추가
손목 회전 4개 자세도 원본 메시와 최종 모델의 쌍이 같았고, 남은 쌍의 상대
변환은 저장 자세와 같았다. 전체 34개 자세에는 원본 접촉이 남아 MoveIt
유효 자세가 0개였다. 충돌 허용 행렬은 빈 상태였다. 접촉 패드 삼각형,
관절 변환, 몸통과 단순 입체를 보존했고, 바꾼 형상은 검증 자세의 입구
공간을 침범하지 않았다. -25° 비교 자세의 개구 폭은 양쪽 12.0137mm였다.

외부 장애물 336건, OctoMap 점군 476점, cuRobo 구 쿼리 3,263건과 자동 검사
53개가 통과했다. 변경한 외피의 내부점 92개는 이전 채움 형상에 대한 검사
입력이므로 새 표면 검사에서 제외했다. 로그에 VTK deprecation 경고가
2개 있다. 검증 원본은 로컬 및 Jetson의
`cleany-data/runs/freecad-wrist-contact-fix-20261105/`에 보존했다.
`brep-contacts.json`에는 솔리드별 거리와 부피, `verification-summary.json`에는
자세별 판정과 재검사 결과, `moveit-coarse/`와 `world-cache-final/`에는 최종
형상이 있다. 운영 모델이나 충돌 허용 정책은 변경하지 않았다.

## 2026-11-05 헤드 팬 소유 수정과 서보 조립 접촉 분리

`2178772352ea293d926b80849d0878c3c0a15ed3` 기반 작업 트리에서 원본
`Cleany-final.FCStd`의 솔리드와 회전축을 대조했다. 팬 아래 지지 혼은 고정
브래킷 안에 343.81mm³ 들어가고 고정 서보 케이스에 닿는다. 저장 자세에서
팬 구동 혼과는 29.4mm, 회전 브래킷과는 33.36mm 떨어진다. CAD 검사용
URDF와 MJCF에서는 이 증거에 따라 지지 혼을 고정 링크로 옮겼다. 실물
체결은 별도 확인 항목이다. 팬 축은 기존 중심선을 사용한다.

소유만 바꾼 후보에는 헤드 브래킷 박스와 서보 외피 접촉이 남았다. 고정 및
회전 브래킷, 팬 서보 3부품과 구동 혼을 틈이 있는 표면 메시로 복원했다.
원본 고정 부품과 팬 회전 부품의 저장 자세 최소 간격은 0.250mm다.
MoveIt 캐시는 삼각형 127,139개와 충돌 형상 179개를 사용한다.
초기 캐시 재연결은 시각 XML 불일치로 거부됐다. 새 URDF에 같은 입력 메시
파일을 연결한 뒤 생성 검사를 통과했다. 이전 시험 노드가 같은 ROS domain에
남아 있던 실행은 폐기하고, 해당 프로세스를 종료한 뒤 별도 domain으로
재검증했다.

양팔 서보와 혼 8개 링크 쌍의 원본 겹침은 동축 결합부에 국한됐다. 구동과
지지 접합에서 축 방향 중첩은 0.15~0.50mm이며 CAD ±15° 비교에서 교집합
부피가 유지됐다. 조립면 접촉은 부피가 0인 별도 범주로 기록했다. 실물
조립 공차와 가동 범위는 이 CAD 비교로 확인되지 않는다.

Jetson ROS Humble localhost domain 231의 최종 캐시로 34개 자세를 검증했다.
엄격 검사에서는 조립 접촉 13~14쌍이 남아 유효 자세가 0개였다. 해당 자세에
대해 CAD로 분류한 조립 접촉만 임시 행렬에 넣은 별도 scene은 34개 모두
유효했다. 같은 scene에 외부 장애물을 넣자 무효로 판정했다. 이 임시 행렬은
제품 설정에 포함하지 않았다. 접촉 패드 4개는 같은 메시를 사용했고 열린
자세의 점군 122점과 접촉 62건이 통과했다. 기존 합성 OctoMap 해시가
일치했다. 격리된 `cleany_description` 빌드와 Python 검사 53개가 통과했다.

양쪽 손목 카메라의 광축 투영에서 렌즈 앞 유리 끝부터 PCB 앞면은 22.7mm,
PCB 뒤면은 24.3mm, 마운트 최후단은 40.3mm다. 사용자 실측은 카메라
돌출부부터 보드까지 9.5mm, 마운트를 포함하면 26.7mm다. 비교값은 보드
뒤면과 마운트 최후단을 실측 기준으로 해석했을 때 각각 14.8mm와 13.6mm
차이가 난다. 카메라 장착점과 광학 보정은 이 비교에서 변경하지 않았다.

원본은 `cleany-data/runs/freecad-head-servo-check-20261105/`에 있다.
`measurements.json`과 `interface-solids.log`는 치수와 원본 솔리드 근거,
`head-after-exact.json`은 고정과 회전 부품 간 간격, `assembly-results.json`은
자세별 대조, `verification-summary.json`은 최종 결과다. 커밋과 푸시는
수행하지 않았다.

## 2026-11 Jetson 보정 근거

2026-11-09 머리 모터 13번과 14번의 허용 범위 측정과 적용 검증은
`/home/cleany/cleany-data/reports/head-motor-14-live-20261109.a9jadfz7/`에 있다.

2026-11-08 카메라와 관절 프로파일의 입력 해시 및 설치 확인은
`/home/cleany/cleany-data/reports/calibration-sync-20261108.sk5ejqmt/`에 있다.

2026-11-10 손목 영상 기반 기구학 보정 후보는
`CLEANY_DATA_ROOT/kinematics_calibration/20261110-calibration/`에 있다. 입력,
학습 표본 내부 교차 검증과 동결 검증 결과는 각 결과 JSON에 기록한다.
이 후보는 review_only이며 독립 실물 검증과 운영 모델 반영은 미완료다.

## CAD와 Jetson 보정 PR 검증 (2026-11-11)

`3fca97bb`를 Jetson Ubuntu 22.04 ARM64, ROS 2 Humble에서 검증했다.
`make test-freecad-model`의 51개와 운동학 보정 및 로봇 인터페이스 관련 57개 검사가
통과했고 `cleany_description` 한 패키지를 별도 경로에 빌드했다. 새 그리퍼 보정값을
현재 `test_hardware_execution.py`에 반영한 뒤 실행기 보정 연동 450개도 통과했다.
입력은 저장소 CAD,
보정 프로필과 합성 관절 및 카메라 데이터이며 실물 구동은 수행하지 않았다.
초기 import 및 ament 환경 누락은 ROS underlay와 격리 설치 경로를 지정해 해결했다.
FreeCAD 모델은 reference-only이며 운동학 후보 보정은 review-only다.
원본 로그와 최종 commit 식별자는
`/home/cleany/cleany-data/reports/pr-publication-20261111/`에 보관한다.

### PR 77 CI 실패의 로컬 재검증 (2026-11-12)

`14eeaf68`에 미커밋 패치를 적용해 Pillow 호환성, 보정 테스트 입력과 BT 수트 제한을
수정했다. Jetson Ubuntu 22.04 ARM64와 ROS 2 Humble의 격리 작업트리에서 CI와 같은
Pillow 9.0.1, pytest 6.2.5, NumPy 1.26.1과 SciPy 1.13.1을 사용했다.
입력은 합성 RGB와 관절 피드백, 가짜 Action 및 Service이며 실물 구동은 하지 않았다.

수정 전 집중 검사에서 기존 실패 34개를 재현했다. 수정 후 집중 검사 126개,
macOS Python 3.12의 순수 검사 98개, Pillow 11.3.0의 이미지 및 결과 검사 25개가 통과했다.
검사 묶음은 서로 겹친다. 중간 검사에서 남은 요약 이미지의 구형 API 참조도 수정했다.

선택한 두 패키지를 `make test`로 재빌드하고 검사했다. 실행기 pytest는 2,421개 통과와
CUDA 및 명시 runtime 조건 미지정 26개 제외, BT pytest는 785개 모두 통과했다.
BT의 CTest 실행은 300초 제한에서 86.10초에 완료됐고 개별 응답 및 종료 대기 제한은 유지했다.
colcon 집계는 CTest 항목을 포함해 3,233개, 오류 0개와 실패 0개다.
Jetson의 BT.CPP는 4.10.0이며 amd64 CI의 4.9.1 환경은 재실행하지 않았다.

기준 commit, 최종 패치와 hash, 환경, 초기 실패 및 최종 원본은
`/Users/hyeon/.codex/reports/cleany-pr77-local-20261112/`에 보관한다.
Jetson 원본은 `/home/cleany/cleany-data/reports/pr77-local-fix-20261112/`에 있다.
해당 결과는 커밋과 푸시 전의 로컬 검증이며 GitHub CI 결과와 구분한다.
