asm17-moving-agent/cleany/docs/RUNNING.md

# 실행 가이드

명령은 저장소 루트의 Ubuntu 22.04 / Humble 터미널에서 실행합니다. [환경과 출력 경로](DEVELOPMENT_SETUP.md), [연동 계약](INTEGRATION.md)을 확인한 뒤, 각 터미널에 같은 DDS domain과 같은 worktree overlay를 적용합니다.

```bash
source /opt/ros/humble/setup.bash
source "$(make -s print-install-base)/setup.bash"
```

Navigation 전용 빌드는 `print-navigation-install-base`로 overlay를 조회합니다. 빌드 때 바꾼 Make 변수는 경로 조회 때도 동일하게 전달합니다.

## FreeCAD 형상 미리보기

`model_variant:=freecad_final`은 새 FreeCAD 파일에 저장된 정적 조립 형상입니다.
관절이나 모터를 명령하지 않으며, RViz의 Fixed Frame은 `base_link`로 지정합니다.
기존 동작 모델과 [미확정 값의 범위](../ros2_ws/src/cleany_description/docs/freecad-model.md)를
구분합니다. 실행 중인 로봇의 `/robot_description`과 섞이지 않도록 별도 터미널과
DDS domain에서 확인합니다.

```bash
make build COLCON_BUILD_ARGS='--packages-select cleany_description'
source "$(make -s print-install-base)/setup.bash"
ROS_DOMAIN_ID=173 ros2 launch cleany_description description.launch.py model_variant:=freecad_final use_sim_time:=false
```

실물 ROS graph와 함께 형상을 확인하려면 `namespace:=cad_reference`와
`frame_prefix:=cad_reference/`를 지정합니다. 모델과 관절 상태, TF 토픽은
`/cad_reference/` 아래에 생성됩니다. RViz도 `/tf`와 `/tf_static`을 각각
`/cad_reference/tf`, `/cad_reference/tf_static`으로 remap하고 Fixed Frame을
`cad_reference/base_link`로 설정합니다. 실물 base와의 위치 관계는 별도 보정이
필요하며, `freecad_final`의 팔 자세는 CAD에 저장된 기준 자세입니다.

```bash
ros2 launch cleany_description description.launch.py use_sim_time:=false \
  model_variant:=freecad_final namespace:=cad_reference frame_prefix:=cad_reference/
```

기존 관절 모델을 표시하려면 `model_variant:=legacy_runtime`을 지정합니다.
기존 카메라 보정 비교에는 이 선택과 `calibration_profile:=jetson_20261009`를
함께 사용합니다. `freecad_final`에는 이전 조립체의 보정 프로파일을 적용할 수
없습니다. 별도 MuJoCo 뷰어의 정적 기준 모델은 다음 경로입니다.

```bash
python3 -m mujoco.viewer --mjcf=ros2_ws/src/cleany_description/mjcf/cleany_freecad_final.xml
```

관절축을 확인하려면 `model_variant:=freecad_kinematic`을 선택합니다. 관절 상태의
이름은 `cad_delta_*`이며 값은 저장된 자세에서의 변화량입니다. 별도 터미널의
`joint_state_publisher`로 초기 변화량 0 상태를 표시할 수 있습니다.

```bash
ROS_DOMAIN_ID=173 ros2 launch cleany_description description.launch.py model_variant:=freecad_kinematic use_sim_time:=false
ROS_DOMAIN_ID=173 ros2 run joint_state_publisher joint_state_publisher
```

ROS와 모터 없이 동작을 확인하는 예시는 아래와 같습니다. 지정한 각도는 표시용
입력이며 가동 한계나 실제 안전한 동작 각도가 아닙니다. Python 환경에는 기존
CAD 도구의 NumPy, VTK와 Pillow가 필요합니다.

```bash
python3 tools/validation/preview_freecad_kinematics.py \
  --delta cad_delta_right_shoulder_yaw=-15 \
  --delta cad_delta_left_shoulder_yaw=15 \
  --delta cad_delta_head_pan=15 \
  --output /tmp/cleany-cad-motion.gif
```

GIF, 최대 변화량의 PNG와 입력·출처 JSON을 생성합니다.
집게의 명목 연동은 `--delta cad_delta_right_gripper_cam=-25 --focus-gripper right`로
확인할 수 있습니다. 집게 종속 관절은 해석기가 계산하며 개별 입력을 받지 않습니다.
실물 보정과 접촉은 [집게 미확정 항목](../ros2_ws/src/cleany_description/docs/freecad-gripper.md)에
따라 별도로 연결합니다. MuJoCo의 운동학 미리보기는 `cleany_freecad_kinematic.xml`의
mocap body를 같은 FK로 배치하며 물리 actuator를 사용하지 않습니다.

## FreeCAD MoveIt와 OctoMap 검사

Humble 환경에서 `cleany_description`과 `cleany_moveit_config`를 빌드한 overlay를
사용합니다. Jetson 기본 MoveIt의 OctoMap 플러그인과 라이브러리 버전이 다르면
Jetson에 설치된 `moveit-scene-runtime`과 `moveit-octomap-lock`의
`local_setup.bash`를 overlay 뒤에 읽습니다.

```bash
export ROS_LOCALHOST_ONLY=1 ROS_DOMAIN_ID=177
ros2 launch cleany_moveit_config freecad_inspection.launch.py
```

같은 환경의 별도 터미널에서 [검사 명령](TESTING.md#freecad-moveit와-octomap-curobo-검사)을
실행합니다. 실물 운영 전 필요한 값은
[FreeCAD 형상 검사 계약](../ros2_ws/src/cleany_moveit_config/docs/planning.md#freecad-형상-검사)에 둡니다.

인덱싱한 충돌 메시를 쓰려면 NumPy, SciPy와 trimesh가 있는 Python으로
저장소 밖의 새 디렉터리에 캐시를 생성합니다. Jetson의 cuRobo 환경도 사용할
수 있습니다. 생성한 디렉터리를 검사 launch의 `collision_cache`에 지정합니다.

```bash
collision_cache="$HOME/cleany-data/freecad-collision-indexed"
"$HOME/cleany/runtime/curobo-venv/bin/python" tools/prepare_freecad_collision_cache.py \
  ros2_ws/src/cleany_description "$collision_cache"
ros2 launch cleany_moveit_config freecad_inspection.launch.py collision_cache:="$collision_cache"
```

삼각형도 줄이려면 VTK가 있는 오프라인 도구 환경에서 허용할 표면 차이를
명시합니다. 아래 값은 검사 캐시의 수치 오차 한도이며 실물 보정값이나
충돌 여유가 아닙니다. 경계와 비다양체 edge, Euler characteristic을 보존하고,
원본과 결과 표면의 양방향 거리 상한을 검사합니다. 실패한 후보는 더 엄격하게
다시 만들며, 끝까지 확인되지 않으면 해당 원본 메시를 유지합니다.

```bash
python3 tools/prepare_freecad_collision_cache.py ros2_ws/src/cleany_description \
  "$HOME/cleany-data/freecad-collision-reduced" --max-surface-error-m 0.0001 \
  --preserve-link cad_snapshot_LeftCameraComponents --jobs 4
```

GPU 대조에서 내부와 외부 판정이 달라지는 링크는 `--preserve-link`로 원본을
유지합니다. 위 예시는 왼팔 카메라 묶음을 보존하며 두 URDF에 함께 적용됩니다.

MoveIt 검사에서 몸통, 마스트와 마운트를 단순 입체로 바꾸고 팔과 헤드 메시를
추가 감면하려면 기존 캐시로부터 새 캐시를 만듭니다. 생성 Python에는 NumPy,
SciPy, trimesh와 VTK가 필요합니다. 부품 선택과 표면 상한은
`configs/robot/freecad_moveit_collision.json`으로 관리합니다. 몸통은 채우되
뒤쪽 상판 투입구와 그 아래 공간을 남깁니다. 원본 시각 모델과 관절 좌표는
입력과 같으며, MoveIt에서는 `freecad_kinematic`으로 읽습니다.
팔은 기존 분할 외피 방식으로, 마스트는 높이별 8개 외피로 생성합니다.
카메라 하우징, 집게 구동 로드와 외측 링크도 닫힌 외피로 줄이고, 팁의
쉘과 삽입부는 같은 링크 안에서 묶습니다. 손목 본체, 서보, 집게 상하판과
캠 조립부는 구멍과 틈을 유지하는 표면 감면 대상으로 지정합니다.
`preserve_collision_parts`의 접촉 패드, 운반 링크, 내측 링크와 광학 부품은
입력 캐시 메시를 유지합니다. 결합부의 구멍과 포크 틈을 채우지 않습니다.
외피 상한과 입구 보존 조건은
[형상 검사 계약](../ros2_ws/src/cleany_moveit_config/docs/planning.md#freecad-형상-검사)을 따릅니다.
검사 launch는 이 외피를 내부가 찬 형상으로 읽기 위해
`cleany/CADInspectionFCL`과 detector 확인 capability를 자동 선택합니다.
변경된 `cleany_moveit_collision`, `cleany_moveit_config`를 빌드한 overlay를
읽은 뒤 실행합니다.

```bash
moveit_cache="$HOME/cleany-data/freecad-moveit-primitives"
PYTHONPATH=ros2_ws/src/cleany_moveit_config python3 tools/prepare_freecad_moveit_cache.py \
  ros2_ws/src/cleany_description "$HOME/cleany-data/freecad-collision-reduced" "$moveit_cache" --jobs 4
ros2 launch cleany_moveit_config freecad_inspection.launch.py collision_cache:="$moveit_cache"
```

cuRobo의 정적 mesh world는 링크별 합치기를 미리 수행할 수 있습니다.
같은 overlay를 읽고 cuRobo 환경에서 아래 명령으로 별도 캐시를 만듭니다.
이 캐시에는 현재 CAD 저장 자세가 들어가며 관절 움직임을 표현하지 않습니다.
단순 입체와 추가 감면을 함께 반영하려면 위에서 만든 `moveit_cache`를 입력합니다.
박스는 기본 cuboid로 저장합니다. 박스를 삼각형으로 변환한 성능 대조 캐시가
필요하면 `--write-world-cache`와 함께 `--mesh-boxes`를 지정합니다.

```bash
python3 tools/validation/check_freecad_curobo.py ros2_ws/src/cleany_description \
  --collision-cache "$moveit_cache" \
  --write-world-cache "$HOME/cleany-data/freecad-curobo-world"
python3 tools/validation/check_freecad_curobo.py ros2_ws/src/cleany_description \
  --world-cache "$HOME/cleany-data/freecad-curobo-world"
```

cuRobo 검사 도구는 캐시 형상에서 거리 검색 범위를 계산합니다. 외부 solver에
연결할 때도 manifest의 `required_mesh_query_distance_m`을 적용하는
[검사 계약](../ros2_ws/src/cleany_moveit_config/docs/planning.md#freecad-형상-검사)을 따릅니다.

## 인식과 파지 후보 실행

[인식 모델 설정](../configs/models/README.md)에서 모델 경로와 프로파일을 확인하고
[비전 컨테이너 실행 절차](../containers/vision/README.md)를 따릅니다.
`make perception-run`은 YOLOE 인스턴스 검출과 Gemini 분류를,
`make anygrasp-run`은 선택 객체 점군의 파지 후보 생성을 실행합니다.
후보 생성 성공은 로봇 도달성이나 실제 파지 성공을 의미하지 않습니다.

`perception/check_rgbd`는 새 RGB-D 입력의 시각과 기하 유효성을 확인합니다.
[인식 인터페이스](../ros2_ws/src/cleany_perception/docs/interfaces.md)와
[파지 요청 좌표계 계약](../ros2_ws/src/cleany_interfaces/docs/scene-and-grasp.md)을 따릅니다.

## 실행 선택과 준비 순서

```mermaid
flowchart TB
    Env["Humble 환경 + worktree별 build"] --> Mode{"실행 목적"}
    Mode -->|"주행 / Mission"| Sensors["Gazebo 또는 실물 sensor / odom / TF"]
    Sensors --> Nav["지도 + Nav2 + 안전 경로 준비"]
    Nav --> Mission["Mission Runtime + Gateway bridge"]
    Mode -->|"조작 / calibration"| Mujoco["MuJoCo backend 하나 선택"]
    Mujoco --> MoveIt["MoveIt / controller 준비"]
    MoveIt --> Task["데모 또는 calibration 실행"]
    Mode -->|"base 단독 검사"| Base["mock 또는 실물 Agent + driver"]
    Mission -. "관측" .-> Monitor["Monitor / 동일 domain과 overlay"]
    Task -. "관측" .-> Monitor
    Base -. "관측" .-> Monitor
```

`mission_sim.launch.py`는 주행과 Mission 구성을 함께 띄웁니다. Sensor와 Nav2가 이미 준비돼 있다면 `mission_runtime.launch.py`만 붙입니다. 아래에서 실행 목적에 맞는 절차를 선택합니다.

## Jetson USB 카메라 회전

[호스트 설정](DEVELOPMENT_SETUP.md#jetson-orin-usb-카메라-회전)을 설치하면
DECXIN `0bda:5844` 연결마다 카메라의 UVC Roll을 `3`으로 설정합니다. 이 모듈에서 `3`은
180도 회전이며 각도가 아닙니다. 영상 변환 프로세스를 상시 실행하지 않습니다.

초기화는 USB 부모 장치의 연결 이벤트로 실행합니다. helper가 `uvcvideo`를 잠시
분리하고 복구하면서 생기는 video node 이벤트는 다시 초기화를 요청하지 않습니다.
`/dev/video0` 같은 번호 대신 해당 연결의 USB 장치를 지정하므로 다른 카메라로
대체하지 않습니다.

1. 캡처 프로그램을 닫고 카메라를 연결합니다.
2. 초기화 결과를 확인한 뒤 ROS 카메라 노드나 캡처 프로그램을 시작합니다.

```bash
journalctl -b -u 'cleany-camera-orientation@*.service' --no-pager
```

정상 완료된 oneshot unit은 `inactive (dead)`로 돌아갑니다. 상시 `active` 상태인지를
성공 조건으로 사용하지 않습니다. 장치 준비는 최대 10초 기다리고 USB 요청에도
timeout을 적용합니다. 실패한 unit은 자동 반복하지 않습니다. 원인을 해결한 뒤 수동으로
다시 시작하거나 USB를 재연결합니다. 잦은 재연결이 start-rate 제한에 걸리지 않도록
unit의 시작 횟수 제한은 사용하지 않습니다.

연결된 모듈의 USB 이름을 조회할 수 있습니다.

```bash
for device in /sys/bus/usb/devices/*; do
  if grep -qx 0bda "$device/idVendor" 2>/dev/null &&
     grep -qx 5844 "$device/idProduct" 2>/dev/null; then
    printf '%s\n' "${device##*/}"
  fi
done
```

캡처를 닫은 상태에서 위 출력 중 대상 이름을 지정해 조회하거나 다시 적용합니다.
예시의 `1-2.3`은 실제 출력으로 바꿉니다.

```bash
USB_DEVICE=1-2.3
sudo /usr/bin/python3 -I /usr/local/libexec/cleany/camera-orientation.py \
  --usb-device "$USB_DEVICE"
sudo systemctl reset-failed "cleany-camera-orientation@${USB_DEVICE}.service"
sudo systemctl start "cleany-camera-orientation@${USB_DEVICE}.service"
```

helper는 이미 사용 중인 video node를 발견하면 드라이버를 분리하지 않고 일시 실패로
종료합니다. 수동 조회도 USB 인터페이스 확보가 필요하므로 캡처를 먼저 닫습니다.
초기화 중 카메라를 여는 경쟁을 피하도록 캡처 시작을 초기화 완료 뒤로 배치합니다.
자동 시작하는 캡처 서비스에는 실제 USB 이름에 대한 다음 의존성을 함께 둡니다.

```ini
[Unit]
Requires=cleany-camera-orientation@1-2.3.service
After=cleany-camera-orientation@1-2.3.service
```

| 실패 | 확인과 조치 |
|---|---|
| 장치 준비 timeout | USB 연결과 `uvcvideo` probe 로그 확인 후 재시도 |
| 사용 중인 video node 또는 접근 확인 실패 | 캡처 종료와 native host 실행 여부 확인 후 재시도 |
| 지원하지 않는 Roll 범위 또는 장치 ID | 다른 기종에 적용하지 말고 해당 카메라의 제어 규약 확인 |
| USB 분리 또는 readback 실패 | 연결을 확인하고 journal의 드라이버 복구 결과 확인 |

## Gazebo

1. 의존성과 실행 환경을 확인합니다.
2. Headless base, study-cafe GUI, 전체 시설 GUI 중 하나를 실행합니다.

```bash
make deps-gazebo
make check-gazebo-env
make sim-gazebo                 # headless base
make sim-gazebo-study-cafe      # study-cafe GUI; 위 실행과 별도로 사용
make sim-gazebo-facility        # 전체 시설 GUI; 위 실행과 별도로 사용
```

GUI renderer는 `GAZEBO_GUI_RENDER_ENGINE=ogre|ogre2`로 선택합니다. 센서 서버는 OGRE2를 사용하므로 GPU LiDAR와 camera는 headless에서도 OpenGL context가 필요합니다. 지원 환경은 Fortress/Humble입니다.

3. 같은 overlay/domain의 별도 터미널에서 sensor와 odometry를 확인합니다.

```bash
ros2 topic hz /clock
ros2 topic hz /scan
ros2 topic echo /odom --once
ros2 run tf2_ros tf2_echo odom base_link
```

Topic 등록 이후 실제 발행, 이동, 정지를 각각 확인합니다. 실행별 sensor와 odometry 소유권은 [연동 가이드](INTEGRATION.md)를 따릅니다.

## Mission Runtime과 Backend

### 주행 구성을 함께 실행

빌드와 overlay 적용 후 Gazebo, Nav2, Runtime, Gateway를 함께 실행합니다.

```bash
make build-mission-sim
source "$(make -s print-install-base)/setup.bash"
ros2 launch cleany_bringup mission_sim.launch.py \
  gateway_url:=ws://127.0.0.1:8080/api/robots/cleany-01/gateway/ws \
  post_mission:=wait_for_next
```

Backend는 별도 `cleany-control-plane` 저장소에서 실행합니다. 같은 robot에 Runtime, bridge, canonical odometry producer를 중복 실행하지 않습니다. 책상 작업은 기본 mock이며 관측 ID에는 실제 사진이 포함되지 않습니다.

### 기존 주행 구성에 Runtime 연결

AMCL/Nav2가 이미 실행 중이면 아래 명령으로 Runtime을 연결합니다.

```bash
make build-mission-runtime
source "$(make -s print-install-base)/setup.bash"
ros2 launch cleany_mission_manager mission_runtime.launch.py \
  gateway_url:=ws://127.0.0.1:8080/api/robots/cleany-01/gateway/ws \
  post_mission:=wait_for_next
```

`mission_runtime.launch.py`의 기본 `supervision_mode:=required`는 아래 System Supervisor 감독 stack이 함께 실행 중이어야 미션을 받습니다. 감독 없이 실행하면 `SUPERVISOR_UNAVAILABLE` 사유로 거절합니다.

| 실행 조건 | 설정과 동작 |
|---|---|
| 감독 없이 단독 실험 | `supervision_mode:=disabled`; snapshot의 `supervision`에 기록. 시스템 Fault와 E-stop 증거를 확인하지 않음 |
| Nav2 없이 구조 확인 | `navigation_backend:=mock` 추가 |
| 완료 후 동작 선택 | `post_mission:=return_home\|wait_for_next`; 제품 복귀 정책은 별도 결정 |
| 독립 실험 | 별도 `journal_path`, `bridge_journal_path` 사용 |
| 동일 미션 복구 | 기존 journal DB 유지 |

재연결, 중복, 취소, 재시작 동작은 [Mission 계약](../ros2_ws/src/cleany_interfaces/docs/mission.md)을 따릅니다.

### System Supervisor 감독 stack

Supervisor, safety adapter, Nav2 lifecycle 복구 owner를 Runtime 옆에 실행합니다. 센서, Nav2와 Runtime은 각자의 launch가 소유합니다.

```bash
make build-supervision
source "$(make -s print-navigation-install-base)/setup.bash"
source "$(make -s print-install-base)/setup.bash"
ros2 launch cleany_system_supervisor supervision.launch.py \
  estop_released_topic:=<하드웨어 해제 Bool> protection_ready_topic:=<보호 계층 Bool>
ros2 run cleany_system_supervisor supervisor_operator            # 활성 Fault 확인
ros2 run cleany_system_supervisor supervisor_operator ESTOP --operator <name>
```

| 실행 조건 | 설정과 동작 |
|---|---|
| 안전 증거 topic 미지정 | 의도된 `FAULT_LOCKED`; Runtime은 `SYSTEM_FAULT_LOCKED`로 거절 |
| 팔 controller가 있는 구성 | `arm_health:=true`로 `arm_health_monitor` 추가 |
| Gazebo 통합 실행 | `mission_sim.launch.py supervision:=true`; 시뮬레이션에는 안전 하드웨어가 없어 evidence topic을 주지 않으면 잠김 |
| 상태 파일 | 기본 `~/.ros/cleany/system_supervisor_state.json`; latched Fault가 재시작 뒤에도 유지 |

Fault, 복구와 운영자 절차는 [System Supervisor](../ros2_ws/src/cleany_system_supervisor/docs/supervision.md)를 따릅니다. 영구 기록이 필요하면 `cleany_logger` 기록 대상에 `/system/events`, `/system/state`, `/system/faults`, `/safety/status`를 추가합니다.

### Gazebo 주행과 Mock 조작

베이스 주행은 Gazebo/Nav2, 인식과 계획 및 팔 조작은 Mock이다. 모든 터미널에 같은 overlay와 DDS domain을 적용한다. 기본 로컬 Mock 실행과 별도로 사용한다.

1. 통합 package를 빌드하고 환경을 적용한다.

```bash
make build-mission-sim
source "$(make -s print-install-base)/setup.bash"
export ROS_DOMAIN_ID=186
```

2. Gateway 없이 시작한다. 세 DB 경로는 분리하고 재시작 시험에서는 보존한다.

```bash
ros2 launch cleany_bringup mission_sim.launch.py \
  profile:=fortress headless:=true \
  runtime_config:=$PWD/ros2_ws/src/cleany_mission_manager/config/runtime_gazebo_manipulation_mock.yaml \
  start_manipulation_mock:=true manipulation_scenario:=success \
  post_mission:=wait_for_next enable_bridge:=false enable_telemetry:=false \
  journal_path:=$HOME/.local/state/cleany/mission-mock/missions.db \
  bridge_journal_path:=$HOME/.local/state/cleany/mission-mock/bridge.db \
  manipulation_database_path:=$HOME/.local/state/cleany/mission-mock/manipulation.sqlite3
```

3. 별도 터미널에서 `ros2 topic echo /mission/status`로 `ready: true`를 확인한 뒤 요청한다. 새 미션에는 새 ID를 사용한다. `NAV2_NOT_READY`이면 Nav2 lifecycle, odom과 TF를 먼저 확인한다.

```bash
ros2 service call /mission/offer cleany_interfaces/srv/OfferMission \
  "{mission_id: gazebo-mock-demo-001, mission_type: clean_desk, target_kind: SEAT, target_id: seat-12, requested_by: manual-test}"
ros2 topic echo /mission/result
```

수락 응답은 완료 결과가 아니다. 정상 실행은 두 물체를 서로 다른 execution ID로 처리한 뒤 추가 빈 관측을 확인한다. 물체당 정상 조작 시간은 약 40초다. [개발 Monitor](#개발-monitor)의 실행 → BT에서 ExecuteOne을 선택하거나 매니퓰레이션 화면을 연다. 같은 domain과 overlay를 사용한다.

Backend 조합과 주행 설정은 [Mock 연결 reference](../ros2_ws/src/cleany_mission_manager/docs/manipulation_mock_integration.md)를 따른다. 기본 종료 정책은 `return_home`이며 위 명령의 첫 시험은 `wait_for_next`를 명시한다.

### 주행도 Mock으로 Action 연결 확인

두 터미널에서 같은 overlay와 `ROS_DOMAIN_ID=186`을 사용한다. 첫 터미널에서 서버를 시작한다.

```bash
make build-mission-mock
source "$(make -s print-install-base)/setup.bash"
export ROS_DOMAIN_ID=186
ros2 launch cleany_skill_executor manipulation_mock.launch.py \
  mock_config:=$PWD/ros2_ws/src/cleany_mission_manager/config/manipulation_server_fixture.yaml \
  database_path:=$HOME/.local/state/cleany/mission-mock/manipulation.sqlite3
```

두 번째 터미널에서 Runtime을 시작한 뒤 위의 준비 확인과 미션 요청을 수행한다. 이 구성의 주행 성공은 Gazebo 주행 증거가 아니다.

```bash
ros2 run cleany_mission_manager mission_runtime --ros-args \
  --params-file ros2_ws/src/cleany_mission_manager/config/runtime_manipulation_mock.yaml \
  -p targets_file:=$PWD/ros2_ws/src/cleany_mission_manager/config/study_cafe_targets.yaml \
  -p post_mission:=wait_for_next \
  -p journal_path:=$HOME/.local/state/cleany/mission-mock/missions.db
```

## 저장 지도 Navigation

```bash
make build-navigation
source "$(make -s print-navigation-install-base)/setup.bash"
ros2 launch cleany_navigation navigation.launch.py --show-args
```

[Launch](../ros2_ws/src/cleany_navigation/launch/navigation.launch.py)에서 지도, backend, sensor 옵션을 확인합니다. `map → odom`의 소유자는 하나만 선택하므로 Mapping과 AMCL을 함께 실행하지 않습니다.

주행 명령은 Mission의 Navigator/Nav2가 생성합니다. Runtime은 `/cmd_vel`을 직접 만들지 않으며, 안전 경로와 sensor 만료 규칙은 [Navigation reference](../ros2_ws/src/cleany_navigation/docs/safety.md)를 따릅니다.

## MuJoCo와 조작 데모

```bash
make sim
# viewer가 필요하면 build와 overlay source 후:
ros2 launch cleany_mujoco_sim mujoco_sim.launch.py headless:=false
ros2 launch cleany_mujoco_sim rgbd_pick_demo.launch.py
```

위 두 실행과 `handeye_backend.launch.py` 중 backend 하나만 실행합니다. RGB-D scene 출력은 grasp/skill 입력으로 사용하며, 수거 완료는 별도로 확인해야 합니다.

### 단일 물체 Manipulation Action

Mock 서버의 요청, 취소, 조회와 모니터 사용은
[Mock 실행 안내](../ros2_ws/src/cleany_skill_executor/docs/manipulation_mock_usage.md)를 따릅니다.
실제 인식과 MoveIt을 사용하는 MuJoCo BT 스택은 다음 명령으로 실행합니다.

```bash
make sim-mujoco-manipulation
```

이 스택은 승인된 물체 하나를 실행하며, 기존 sorting coordinator와 별도 구성입니다.
입력, 세부 옵션과 검증 범위는 [MuJoCo BT 서버](../ros2_ws/src/cleany_manipulation_bt/README.md)를 따릅니다.

### Plan-only 후보 선택

MoveIt을 준비한 뒤 같은 overlay의 별도 터미널에서 후보 선택을 실행합니다.

```bash
ros2 launch cleany_moveit_config mock_planning.launch.py
# 같은 overlay의 별도 터미널
ros2 launch cleany_skill_executor grasp_selection.launch.py
```

### MuJoCo 접근 데모

아래 데모는 MuJoCo controller까지 연결합니다. 두 launch는 각각 별도로 실행합니다.

```bash
ros2 launch cleany_skill_executor grasp_execution_demo.launch.py
ros2 launch cleany_skill_executor can_grasp_execution_demo.launch.py
```

| 데모 | 확인 범위 | 실행 조건 |
|---|---|---|
| 기본 grasp | 후보 선택, 두 trajectory 실행, 최종 joint 수렴 | MuJoCo controller 연결 |
| can grasp | RGB-D 검출, 후보 생성, 충돌 검사, 그리퍼 개방, 방향 보정 pre-grasp 접근 | Viewer/OpenGL 필요; `headless:=true` 미지원 |

두 데모 모두 gripper close, attach, lift와 실제 수거는 검증하지 않습니다. Plan-only action과 데모의 차이는 [Manipulation 계약](../ros2_ws/src/cleany_interfaces/docs/manipulation.md)을 따릅니다.

## 개발 Monitor

```bash
make build-dev-monitor
make run-dev-monitor
```

브라우저에서 `http://127.0.0.1:8768`을 엽니다. Monitor는 기본 관측 전용이며, 관측 대상과 같은 DDS domain과 메시지 overlay가 필요합니다. Frontend 준비는 [개발환경](DEVELOPMENT_SETUP.md)을 따릅니다.

실시간 입력과 logger 연결은 [monitor.yaml](../ros2_ws/src/cleany_dev_monitor/config/monitor.yaml)에서
설정합니다. `make build-dev-monitor`는 logger도 빌드하지만 Monitor 실행은 logger를
자동 시작하지 않습니다. 기록은 아래 절차로 별도 실행합니다. 웹 자산 갱신 후에는
`make build-dev-monitor-ros`로 설치 자산도 갱신합니다.

### Jetson 운영 UI와 작업 승인

1. `make build-dev-monitor`로 웹과 ROS 패키지를 빌드한다. 처음 구성할 때는
   [개발환경](DEVELOPMENT_SETUP.md)의 의존성과 실물 런타임 빌드를 먼저 준비한다.
2. `make dev-monitor-start`로 사용자 systemd 서비스를 시작한다.
   `http://<Jetson 주소>:8768/#manipulation`에서 관측한다.
   `make dev-monitor-status`, `make dev-monitor-stop`으로 상태 조회와 종료를 수행한다.
   로그는 `journalctl --user -u cleany-dev-monitor.service`에서 확인한다.
   시작만으로 로봇 런타임이나 조작 Goal을 실행하지 않는다.
3. 실물 동작을 사용할 때는 실행 중인 작업이 없는 상태에서 로봇별
   `CLEANY_MANIPULATION_COLLECTION_CONFIG`, `CLEANY_FEETECH_CONTROL_CONFIG`,
   `CLEANY_HARDWARE_MONITOR_CONFIG`를 지정하고 웹 제어를 켠다.

   ```bash
   make dev-monitor-control-on
   make dev-monitor-control-key
   ```

4. 웹에서 운영자 이름과 조작키로 연결한다. `로봇 준비`의 토크 활성화를 확인한 뒤
   `다음 작업 제안받기`를 선택한다. 이미지, 대상과 행동을 검토하고
   `승인하여 1회 실행` 또는 `이 물체 건너뛰기`를 선택한다.
   다음 제안도 승인 전에는 실행하지 않는다. `물체 1개 실행`은 기존
   `make manipulation-run`의 자동 대상 선택과 즉시 실행을 호출한다.
5. 중단 요청 후에는 실행 기록의 실제 정지와 물체 상태를 확인한다.
   복귀 시 그리퍼가 먼저 열리는 점을 확인하고, 차단 해제는 정지, 빈 그리퍼와
   검토한 실행 기록의 revision을 확인한 뒤 요청한다.
6. 유휴 상태에서 `make dev-monitor-control-off`로 관측 전용으로 되돌린다.
   전환은 모니터만 재시작하며 로봇을 종료하거나 작업을 자동 재개하지 않는다.
   로봇 종료는 웹의 `로봇 종료·토크 해제` 또는 기존 CLI에서 별도로 요청한다.

기본 ROS domain은 `CLEANY_COLLECTION_ROS_DOMAIN_ID=0`이다. Loopback 접속은
`ssh -N -L 8768:127.0.0.1:8768 cleany@<Jetson 주소>`로 터널을 연결한다.
포그라운드 Jetson 실행은 `tools/dev-monitor run`을 사용한다.

제어 활성화 시 허용된 터미널 옵션을 0600 `runtime-settings.json`에 저장한다.
다시 활성화하면 명시한 옵션만 덮어쓰고 나머지 저장값을 유지한다. 저장값을 제거하려면
유휴 상태에서 해당 항목을 삭제한다. 저장 경로, 인증, 중복 실행 방지와 결과 해석은
[운영 제어 계약](../ros2_ws/src/cleany_dev_monitor/docs/interfaces.md#운영-제어와-상태)을 따른다.

### 독립 Logger

1. 웹 없이 logger만 빌드하려면 `make build-logger`를 실행합니다.
2. 빌드 overlay를 source한 별도 터미널에서 logger를 시작합니다.
   CLI에서 토픽을 먼저 설정하려면 녹화 대기 상태로 실행합니다.

   ```bash
   ros2 launch cleany_logger logger.launch.py record_on_start:=false
   ```

   기본값인 `record_on_start:=true`는 즉시 녹화하며, 시뮬레이션에서는
   `use_sim_time:=true`를 지정합니다. `make run-logger LOGGER_LAUNCH_ARGS='record_on_start:=true'`도
   사용할 수 있습니다.
3. 같은 DDS domain과 빌드 overlay를 사용하는 다른 터미널에서 CLI로 설정하고
   녹화합니다. 설정을 먼저 바꾸려면 logger를 `record_on_start:=false`로 실행합니다.
   이미 녹화 중이면 `stop` 후 설정합니다.

   ```bash
   ros2 run cleany_logger logger status
   ros2 run cleany_logger logger topics
   ros2 run cleany_logger logger topics set camera --topic /camera/head/color/image_raw --hz 2 --enable
   ros2 run cleany_logger logger topics set path_topic --topic /plan --hz 1 --enable
   ros2 run cleany_logger logger start
   ros2 run cleany_logger logger stop
   ```

   `topics set <ID> --disable`은 해당 항목을 끕니다. ID는 `topics` 출력에서 확인합니다.
   속도 체인은 `topics set velocity_topics --topic /first --topic /second`로 전체를
   지정하거나 `velocity_topics:0`처럼 특정 항목만 변경합니다. 출처별 `--hz all`은
   수신마다 기록하며 카메라 등 센서 원본은 숫자 Hz가 필요합니다. 카메라와 점군
   원본은 대용량이므로 필요한 토픽과 주기를 선택합니다.

   루트에서 `make logger LOGGER_ARGS='status'`로도 호출할 수 있습니다.
   다른 노드는 `--node /robot/logger`, 대기 시간은 `--timeout 3`, 자동화 출력은
   `--json`으로 지정합니다. 이 옵션은 하위 명령 앞이나 뒤에 쓸 수 있습니다.
   CLI는 한 번 요청하고 종료하며 logger 프로세스와 녹화는 계속됩니다.
4. 대시보드를 사용하려면 별도 터미널에서 `make run-dev-monitor`를 실행합니다.
   기본 저장 위치는 두 프로세스 모두 `~/.local/state/cleany/recordings`입니다.
   다른 경로는 logger YAML의 `state_directory`와 Monitor의
   `MONITOR_ROS_ARGS='-p state_directory:=/absolute/path'`에 동일하게 지정합니다.
   이전 기록은 기존 디렉터리를 명시해 조회합니다. 대시보드나 브라우저를 종료해도
   logger는 같은 세션을 녹화합니다.

`mission_sim.launch.py`는 `enable_logger:=true record_on_start:=true`로 logger를
함께 실행할 수 있습니다. 기본은 비활성이며 `logger_config:=/absolute/logger.yaml`로
설정을 지정합니다. 이 launch 구성은 시뮬레이션 시계를 logger에 전달합니다.

기록 구조는 [Logger 데이터 계약](../ros2_ws/src/cleany_logger/docs/data.md),
HTTP와 stale 처리는 [Monitor 계약](../ros2_ws/src/cleany_dev_monitor/docs/data.md)을 따릅니다.

상세 SLAM, LiDAR, 점군과 costmap은 같은 domain의 RViz에서 확인합니다. 완료된 원본 bag ZIP을 내려받아 압축을 푼 뒤 다음과 같이 재생합니다. Bag에 기록된 토픽, TF와 CameraInfo만 사용할 수 있으며 SQLite 가공 기록은 RViz 입력이 아닙니다.

```bash
ros2 bag info <bag-directory>
ros2 bag play <bag-directory> --clock
rviz2 --ros-args -p use_sim_time:=true
```

Fixed Frame은 `map_frame`에 맞추고 Cartographer Submaps display에는 해당 plugin을 설치합니다.

## Base와 plot

### 장치 없는 mock

별도 domain에서 빌드한 mock를 실행합니다.

```bash
make build-base
export ROS_DOMAIN_ID=173
source "$(make -s print-install-base)/setup.bash"
ros2 launch cleany_base_driver base_driver.launch.py mock:=true
```

Mock domain에는 실물 MCU/Agent를 연결하지 않습니다. 고장 주입 service는 mock node와 테스트가 관리합니다.

### 실물 base와 관측 GUI

Agent와 driver 양쪽에 domain 0을 적용하고 검토한 hardware config를 선택합니다.

```bash
export ROS_DOMAIN_ID=0
ros2 launch cleany_base_driver base_driver.launch.py \
  mock:=false config:="$(ros2 pkg prefix --share cleany_base_driver)/config/base_hardware.yaml"
# 같은 overlay/domain의 별도 터미널에서 관측 GUI:
ros2 launch cleany_base_driver base_monitor.launch.py preset:=true
```

초기 hardware config는 바퀴를 띄운 시험용입니다. Launch 이후 구동 허가는 별도 절차로 수행하며, mock domain과 실제 MCU domain을 혼용하지 않습니다. 실물 시험은 [ESP32 가이드](../esp32/README.md)와 [base 계약](../ros2_ws/src/cleany_base_driver/docs/command-and-odometry.md)을 따릅니다.

Plot은 목표, slew/reversal 이후 목표, encoder 속도(rad/s), PWM(%), diagnostics를 표시합니다. `preset:=false wheel:=fl|fr|rl|rr|all`로 관측 범위를 바꿀 수 있습니다. GUI를 종료해도 별도로 실행한 driver/Agent는 계속 실행됩니다.

## 시설 생성 도구와 종료

`ros2 run cleany_gazebo_sim <스크립트명> --help`로 각 도구의 입력을 확인합니다.

| CLI | 출력 |
|---|---|
| `generate_mission_targets.py` | 접근 목표 YAML과 검증 JSON |
| `render_layout_overlay.py` | 명시한 layout, reference image로 배치 SVG |
| `generate_felt_texture.py` | 명시한 PNG 경로에 펠트 질감 |
| `generate_roly_textures.py` | 명시한 폴더에 seat/back PNG |

시설 reference 이미지와 입력 fixture는 clone에 포함되지 않을 수 있으므로 [근거 색인](EVIDENCE.md)에서 위치를 확인합니다. 목표 생성은 정적 footprint 여유를 검사하며, 전체 경로와 팔 도달성은 별도 검증이 필요합니다.

Launch는 `Ctrl-C`로 종료한 뒤 센서와 명령의 발행 중단과 해당 실행의 자식 종료를 확인합니다. 시나리오 runner의 실패, cleanup 판정은 [테스트 가이드](TESTING.md)를 따릅니다.

## 실물 IMU

MCU 부팅 보정과 gyro 수신 실행은 [IMU 안내](../ros2_ws/src/cleany_base_driver/docs/imu.md)를 따른다.

## Jetson 실물 실행 경로

`cleany_robot_interface`는 로봇 상태 조회와 Feetech 컨트롤러 실행을 제공합니다.
로봇별 시리얼 포트, 엔코더 보정과 운영 한계는 실행 전에 확인한 외부 프로파일로 지정합니다.
패키지의 `test/data` 파일은 합성 검사 입력이며 운영 기본값으로 사용하지 않습니다.
관절 미리보기 `arm_preview.launch.py`는 모델 경로, 상태 설정, RViz, 헤드 포함 여부와
마스트 간격을 받습니다. 기본 모델은 명목 형상이며, 저장된 보정을 적용한 실물
모델은 아래 상태 프로파일 실행 절차를 따릅니다.

1. [개발환경](DEVELOPMENT_SETUP.md#jetson-실물-제어-패키지)에 따라 빌드하고 같은 install을 적용합니다.

   ```bash
   source /opt/ros/humble/setup.bash
   source "$(make -s print-install-base)/setup.bash"
   ```

2. 실물 상태와 제어기는 동일 시리얼 포트를 단독 점유합니다. 다른 상태 조회기를 종료한 뒤 읽기 전용으로 시작합니다.

   ```bash
   ros2 launch cleany_robot_interface real_control.launch.py \
     repository_root:="$PWD" \
     profile_file:=/absolute/path/to/state-profile.json \
     control_file:=/absolute/path/to/control-limits.yaml \
     read_only:=true with_moveit:=false
   ```

3. MoveIt 연결이 필요하면 `with_moveit:=true`를 사용합니다. 읽기 전용에서는 궤적 실행도 차단합니다.
   제어를 허용하는 별도 실행은 확인한 운영 한계와 프로파일을 사용해 `read_only:=false`로 시작합니다.
   외부 실행기가 궤적을 소유하는 경우에는 `allow_trajectory_execution:=false`로 MoveIt 실행 권한을 분리합니다.

상태 가드는 결측되거나 오래된 관절 상태를 차단합니다. 정지 요청은 `/real_control/stop`
서비스를 사용합니다. 토픽, 상태와 카메라 제어는 [패키지 인터페이스](../ros2_ws/src/cleany_robot_interface/docs/interfaces.md)를 따릅니다.

## 실물 파지 계획과 준비 자세

1. [환경 설정](DEVELOPMENT_SETUP.md#실물-모션-기반)의 MoveIt overlay를 준비하고 빌드한다.

   ```bash
   make build-motion-foundation
   source tools/scene-mapping-env
   source "$(make -s print-install-base)/setup.bash"
   ```

2. 실물 상태 조회, MoveGroup과 인식을 실행한 환경에서 계획 전용 선택기를 시작한다.
   인식의 `inspect_scene.launch.py`에는 `enable_reference_observation:=true`를 지정한다.

   ```bash
   ros2 launch cleany_skill_executor physical_grasp_selection.launch.py \
     repository_root:="$PWD" motion_backend:=moveit
   ros2 launch cleany_skill_executor validate_pick.launch.py --show-args
   ```

3. 기존 실물 controller에 센서와 계획 서비스를 연결하는 설정은
   `pregrasp_hardware_support.launch.py --show-args`로 확인한다. 이 launch는
   RGB-D 카메라와 장면 처리도 시작하며 기본 후보 생성은 `geometric`이다.
   같은 카메라를 별도로 중복 실행하지 않는다. 모터 실행은 요청하지 않는다.
   `hardware_pregrasp`는 별도로 실행하는 물리 동작 도구이며 준비 자세 도달과 재관찰까지만 수행한다.
   전체 수거와 복귀는 이 경로의 기능이 아니다.

[계획과 실행 조건](../ros2_ws/src/cleany_skill_executor/docs/physical-pregrasp.md),
[선택적 GPU 환경](../containers/motion/README.md)을 함께 확인한다.

## 실물 휠 odometry와 2D LiDAR 매핑

1. [개발환경](DEVELOPMENT_SETUP.md#실물-매핑-의존성)의 외부 Agent와 LiDAR 드라이버를 준비하고 `make build-hardware-mapping`을 실행한다.
2. 저장소 루트에서 `make run-hardware-mapping`으로 실행할 수 있다. 기존 base, Nav2, 조종기와 중복 실행하지 않는다.
   별도 터미널에서 직접 launch하려면 빌드한 overlay를 먼저 source한다.
3. 현재 센서 장착과 일치하는 [프로필](../ros2_ws/src/cleany_bringup/docs/hardware-mapping.md)을 선택한다.

   FreeCAD와 같은 조립체이고 LiDAR 쪽이 전방이면 `mapping_cad_lidar_front.yaml`을
   선택한다. 센서 변환 변경 전 기존 지도를 저장하고 새 매핑 세션에서 실행한다.

   ```bash
   ros2 launch cleany_bringup hardware_mapping.launch.py \
     profile:="$(ros2 pkg prefix --share cleany_bringup)/config/mapping_legacy.yaml"
   ```

4. 로그의 조종 주소와 state_root/web-token 키로 접속한다. 주소의 127.0.0.1만 노트북 LAN 주소로 바꾼다.
   연결 후 지도 초기화를 누르고 running 상태를 확인한 뒤 휴대폰으로 조종한다. 초기화 접수는 완료를 뜻하지 않는다.
5. Ctrl+C로 종료하면 입력을 막고 STOP, 지도/pbstream 저장과 Logger flush를 확인한 뒤 장치를 종료한다.
   지도는 기본 `~/.local/state/cleany/hardware/maps/`, 녹화는 `recordings/`에 보존한다.

`state_root`, `host`, `phone_port`, `mock`은 launch 인자다. 모의 모드는 별도 ROS domain에서 사용하며
실물 장치 대신 main의 mock MCU를 실행한다. 모의 LiDAR 입력은 런타임 검사 도구가 제공한다.
새 SLAM은 IMU를 사용하지 않으며 raw scan 원본, 전방 180도와 0.30m 마스킹을 유지한다.
기존 Dev Monitor는 별도로 실행해 지도와 센서를 관측할 수 있다.

휴대폰만 독립 실행할 때는 같은 geometry의 base driver가 먼저 실행돼 있어야 한다.

```bash
ros2 launch cleany_teleop teleop.launch.py \
  base_config:="$(ros2 pkg prefix --share cleany_base_driver)/config/base_hardware.yaml"
```

문제가 발생하면 조종 상태 API의 `last_permission_error`, `event_log`와 매핑 상태 API의
`status_age_ms`, `error_code`, `error_file`을 먼저 확인한다. 기본 실행의 조종 사건은
`~/.local/state/cleany/hardware/teleop-events.jsonl`, 매핑 오류 JSON은
`~/.local/state/cleany/hardware/maps/errors/`에 남는다. `state_root`를 바꿨다면 해당 경로를
따른다. 오류 JSON을 쓰지 못한 경우 `state_root/mapping.log`에서 traceback을 확인한다.

## ToF 근접 보호와 책상 접근

[ToF 계약](../ros2_ws/src/cleany_tof/docs/interfaces.md)의 명령 경로와 보정 항목을 먼저
확인한다. 기본 프로파일은 주행을 차단한다. 이 절차는 물리 시험 통과를 의미하지 않는다.

1. `make build-tof`를 실행한다. 공통 navigation은 Ubuntu/Humble 환경에서
   `make build-navigation`으로 빌드한다. 호스트에서는 `distrobox enter --name ros2-humble
   --no-tty --clean-path -- make build-navigation`을 사용할 수 있다.
2. navigation overlay와 `make print-install-base`의 overlay를 순서대로 source한다.
   기존 로봇 센서, localization, base와 독립 safety evidence를 구성한다.
3. 공통 `cleany_navigation navigation.launch.py`에 기존 map/robot profile 인자와 함께
   `tof_enabled:=true tof_params_file:=/absolute/path/to/commissioned-tof.yaml`을 전달한다.
4. `cleany_system_supervisor supervision.launch.py`는 `tof_required:=true`로 실행한다.
   실제 estop/protection evidence 인자는 기존 절차를 따른다. ToF 가용성만으로 하드웨어
   estop 해제나 arm 가용성을 만들어내지 않는다.
5. Mission launch에 `desk_approach_enabled:=true desk_distance_m:=0.75`를 전달한다.
   목표는 base 원점 기준 거리이며 현장 좌석과 guard envelope에 맞게 조정한다.
   Mission, 두 ToF 제어 노드와 기존 안전 경로가 동일한 canonical odom을 보도록 remap한다.
6. 좌석 pose는 책상 전면을 바라보는 staging pose로 설정한다. Mission이 Nav2 도착과
   정지를 확인한 뒤 접근을 요청하며, home 복귀에는 접근을 수행하지 않는다.

`tof_driver`의 serial port는 기본적으로 공급 펌웨어 보드의 by-id 경로다. 다른 보드는
해당 노드의 `port`를 별도 설정한다. 재연결 시 64 zone, 15Hz로 재설정한다. 별도
teleop도 `nav2/cmd_vel` 입력을 사용하며 ToF 활성 상태에서 `cmd_vel`에 직접 발행하지 않는다.

정상 NO_RETURN은 장애물 미검출로 처리하며 RGB-D proof 없이 주행 입력을 허용한다.
ToF 전용 coverage observer 설정과 no_return_max_*, min_valid/required_zones는 제거한다.
기존 head-pan depth coverage는 기존 설정에 따른다. 감시 ROI, 인접 검출 수, 확인/해제
시간과 비상 거리는 ToF YAML의 조정 가능한 후보다. sensor_ready=false나 오래된 frame은
계속 정지하며, 정상 미검출을 센서 fault로 보고하지 않는다. 미검출이 빈 공간을 보장하지
않으므로 기존 독립 안전 계층을 활성 상태로 유지한다.

voxel guard의 충돌 검사와 속도 출력 기본은 `update_period_s: 0.10`(10Hz)다.
이 값은 voxel 지도 갱신 주기와 별개이며 명시적 robot profile override가 있으면 그 값을
사용한다. 주기를 조정할 때 상류 출력과 ToF의 command_timeout_s를 함께 확인한다.

## Jetson 얼굴 디스플레이

전용 앱은 `/home/cleany/cleany-display`에 독립 설치한다. 자동 로그인 후 로컬 Chromium 키오스크를 실행하고 ROS 상태를 구독한다. 설치, 서비스 재시작과 자동 시작 해제는 [디스플레이 운영](../ros2_ws/src/cleany_display/README.md)을 따른다. 기존 `/home/cleany/cleany` checkout과 그 실행 프로세스를 변경하지 않는다.

## 실물 수거와 팔 복귀

실물 준비 자세 실행 이후 수거, 복귀와 복구 명령은
[실물 수거 안내](../ros2_ws/src/cleany_skill_executor/docs/physical-collection.md)를 따른다.
실물 프로필을 명시적으로 입력하며 `make collection-plan`과 실제 실행 명령을 구분한다.
