asm17-moving-agent/cleany/ros2_ws/src/cleany_skill_executor/docs/manipulation.md

# cleany_skill_executor

## 단일 물체 Action 실행

승인된 물체 하나의 실행은 Mock 서버와 native MuJoCo BT 서버가 같은
`ExecuteManipulationSkill` 계약을 사용합니다. Mock의 요청, 취소, 조회와 모니터는
[실행 안내](manipulation_mock_usage.md), 물리 시뮬레이션의 인식·MoveIt 연동은
[MuJoCo BT 서버](../../cleany_manipulation_bt/README.md)를 따릅니다.
세부 진행, 취소 정책과 실행 기록 필드는
[공통 Action 계약](../../cleany_interfaces/docs/observation-contracts.md#단일-물체-manipulation-action)에 정리합니다.
Mission Manager의 `action_mock` 어댑터는 `/mock/manipulation`의 계약을 호출합니다.
기본 Mission runtime의 조작 backend 선택은 Mission 설정으로 유지합니다.
아래 nearest-pregrasp와 sorting coordinator는 별도 실행 경로입니다.

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

- [Python Mock 조작 서버](#python-mock-manipulation-서버)
- [분류 실행](#시뮬레이션-분리-수거-통합-검증-진행-중)
- [분류·운반 실행 계약](#분류운반-실행-계약)
- [설정 및 검증](#설정-및-검증)

## Python Mock Manipulation 서버

`manipulation_server`는 진행과 결과를 모의 생성한다. Backend는 `mock`만 허용하며 clock, TF, odom, 카메라와 joint_states를 발행하지 않는다. Steady clock으로 timeout과 취소를 처리한다. [Endpoint 표](interfaces.md#manipulation_server)와 [실행 절차](../../../../docs/RUNNING.md#주행도-mock으로-action-연결-확인)를 따른다.

| 설정 | 용도 | 정상 시간 |
|---|---|---|
| [기본 fixture](../config/manipulation_mock.yaml) | 빠른 서버 계약 검사 | 단계당 기본 0.5초 |
| [Mission 공유 fixture](../../cleany_mission_manager/config/manipulation_server_fixture.yaml) | 두 물체와 네 관측 | 물체당 합계 40초 |

시간 우선순위는 scenario의 `stage_durations_sec`, 전역 `stage_durations_sec`, `stage_duration_sec` 순서다. 정지 단계 기본값은 `stop_duration_sec`다. [공유 시간표와 timeout](../../cleany_mission_manager/docs/manipulation_mock_integration.md#mock-조작의-관찰-시간)을 따른다.

Execution ID는 중복 수락하지 않는다. 재시작 시 ACTIVE를 INTERRUPTED로 보존하고 자동 재개하지 않는다. 과거 JSON의 추가 필드는 기본값으로 읽으며 손상된 DB는 시작 오류다. 서버 DB와 Mission DB는 분리해 유지한다. [결과, 취소와 보고 계약](../../cleany_interfaces/docs/manipulation.md)을 함께 확인한다.

조회는 메모리에 유지 중인 최신 상태를 포함한다. 실행 중 서버 DB 쓰기가 실패하면 경고를 남기고 모의 동작 결과는 보존한다. Mission의 전송 전 journal 저장과 결과 저장은 별도 계약이며, 조회 응답만으로 서버 DB 쓰기 성공을 판단하지 않는다.

## 작업자 관찰 모드와 파지 깊이

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

## 선택형 시뮬레이션 최적화와 원복

수거 launch에 `sim_performance_profile:=tabletop_fast`를 추가하면 먼 정적
배경 충돌을 비활성화하고 그림자 맵만 2048로 낮춘다. 기본값 `baseline`으로
재시작하면 기존 설정으로 돌아온다. 그림자 4096을 유지하는
`tabletop_collision`도 제공한다. 파지 깊이·물체 물리·관절 속도·YOLOE-seg·
MoveIt 충돌 검사와 완료 판정은 바꾸지 않는다.
적용 범위, 실행 예제와 비교 측정은
[MuJoCo scenes](../../cleany_mujoco_sim/docs/scenes.md#되돌릴-수-있는-고정-책상-최적화)를 따른다.

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

### 파지 후 Depth 최신성

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

## Sorting 속도 설정 (2026-09-08 변경)

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

## 상태

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

## Reachable grasp action

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

## 제공 계약

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

## 설정 및 검증

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

```bash
ros2 launch cleany_moveit_config mock_planning.launch.py
ros2 launch cleany_skill_executor grasp_selection.launch.py
pytest -q ros2_ws/src/cleany_skill_executor/test
```

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

## 가까운 객체 자동 pre-grasp

`nearest_pregrasp_coordinator`는 다음 순서로 한 번의 작업을 수행한다.

```text
InspectScene 1차 detection
→ distance_valid 후보를 base_link 거리순 정렬
→ selected-object inspection
→ PlanGrasp
→ SelectReachableGrasp
→ target OBB를 충돌물로 유지하며 pre-grasp 실행
→ (execute_grasp_and_lift=true) 새 RGB-D 재인식과 동일 arm 재선택
→ Pilz LIN 접근 → gripper 접촉 → LIN 역접근 → LIN 수직 상승
```

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

```bash
ros2 launch cleany_skill_executor nearest_pregrasp.launch.py
```

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

Study-cafe의 네 물체를 대상으로 인식부터 접촉 집기와 후퇴까지 실행하려면 다음 launch를
사용한다.

```bash
ros2 launch cleany_skill_executor study_cafe_nearest_grasp_demo.launch.py
```

기본값은 YOLOE-seg instance mask + Gemini 3.1 Flash-Lite 상세 분류 설정이다. 기존 color adapter는
과거 머그컵/휴대폰/지우개 fixture 전용이며 현재 종이컵/레고/휴지에 대응하지 않는다.
이 study-cafe MuJoCo launch의 YOLOE 기본 체크포인트는
`~/models/yoloe/study_cafe_sim_yoloe26s_seg.pt`다. 현재 시뮬레이션 head 영상으로
fine-tune한 파일이며, 생성·학습·평가 절차는
[`cleany_perception/README.md`](../../cleany_perception/docs/runtime.md#스터디카페-mujoco-전용-yoloe-seg-학습)에 있다.
손목 HANDOFF는 별도 `~/models/yoloe/study_cafe_sim_all_views_yoloe26s_seg.pt`를
`wrist_yoloe_model_path`로 로드한다. 오른손목 HANDOFF는 head 체크포인트를
`wrist_right_yoloe_model_path`로 재사용한다. 실제 컵 pregrasp 오른손목 프레임에서
head 모델은 컵을 confidence 0.726으로 검출했고, 양손목 바닥 학습 모델은 검출하지
못했다. 파지 후 CHECK는
`~/models/yoloe/study_cafe_sim_held_yoloe26s_seg.pt`를
`wrist_check_yoloe_model_path`로 로드한다. Head 모델은 기존 학습본을 유지한다. 왼손목
시점 holdout의 마스크 IoU 0.5 일치율은 52/80→68/80으로 개선됐지만, 새 모델을
head에 쓸 때는 71/80→64/80으로 하락했기 때문이다. 오른손목에서 실제 라벨이
있는 컵·휴지의 일치율은 38/40→36/40이었다. 이 수치는 고정 시뮬레이션 자세와
별도 생성 영상의 평가이며 실제 집기 성공률을 뜻하지 않는다. 학습 결과의 `best.pt`를
각 손목 경로로 복사해 사용한다. 파지 후 레고 holdout은 CHECK 모델에서 18/20으로
개선됐으나, 같은 모델의 파지 후 컵·마우스·휴지 검출은 아직 0/10이다. 실제 카메라 영상에 대한 성능은
검증하지 않았으며, 실물 실행에는 별도 검증된 checkpoint를 `yoloe_model_path`로 지정한다.
스터디카페 기본 실행은 왼손목 마우스 CHECK에
`wrist_mouse_check_yoloe_model_path`의 전용 모델을 쓴다. 실제 MuJoCo 실패
프레임에서 기존 모델은 마우스 검출 0건, 전용 모델은 신뢰도 0.25였고, 마우스
단독 및 전체 실행에서 파지 후 CHECK를 통과했다. 오른손목 CHECK의 컵 전용
모델이 물체를 놓치면 기존 파지 후 통합 모델로 같은 RGB를 재검사한다. 실제
MuJoCo 휴지 CHECK 프레임에서 컵 전용 모델은 검출 0건, 통합 모델은 휴지를
신뢰도 0.364로 검출했다. 두 추가 검사 모두 예상 물체의 투영 위치와 mask
검증을 통과해야 한다.
YOLOE 추론의 최소 confidence는 0.08이고, 클래스별로 컵·마우스·휴지는 0.25,
레고는 0.08을 적용한다. 다른 클래스 목록이나 모델로 바꿀 때는
`yoloe_class_confidence_thresholds`도 같은 순서로 조정해야 한다.
시뮬레이션 수거 정책 `table_sorting_policy.yaml`의 최종 최소 confidence도 0.08로
맞췄다. 레고 외 물체는 YOLOE 단계에서 먼저 0.25 미만을 제거한다.
다른 YOLOE checkpoint는 `yoloe_model_path`로 지정할 수 있다.
전체 파이프라인은 아래 스터디카페 검증 명령으로 실행한다.

## 센서 전용 study-cafe 검증

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

```bash
make sim-mujoco-pipeline
make sim-mujoco-sorting
```

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

```bash
make sim-mujoco-pipeline PIPELINE_ARGS='headless:=true use_rviz:=false use_image_view:=false'
make sim-mujoco-pipeline PIPELINE_ARGS='headless:=false use_rviz:=false use_image_view:=false'
make sim-mujoco-pipeline PIPELINE_ARGS='headless:=false sim_viewer:=native'
```

## 시뮬레이션 분리 수거 (통합 검증 진행 중)

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

```bash
make sim-mujoco-sorting

# 기본 sorting 실행은 headless이며 RViz/image_view를 시작하지 않는다.

# 수거 완료/실패 후에도 시뮬레이터와 GUI 유지 (수거 동작을 자동 재시도하지 않음)
make sim-mujoco-sorting SORTING_ARGS='headless:=false use_rviz:=true use_image_view:=true shutdown_on_sorting_exit:=false'
# 같은 실행에서 GUI 창만 생략 (vendor 카메라 렌더링에는 DISPLAY 필요)
make sim-mujoco-sorting SORTING_ARGS='headless:=true use_rviz:=false use_image_view:=false'
```

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

현재 장면은 종이컵·마우스·휴지뭉치·확대한 레고를 사용한다. YOLOE의 명시 클래스는
`cup`, `computer mouse`, `crumpled tissue`, `lego brick`이며 Gemini는 고정 목록 없이
외형에 따른 자유 라벨을 생성한다. 모델 출력 category/reason으로 분류하고 위험·저신뢰
결과는 review로 남긴다. 장면의 형상·크기와 평가용 body mapping은
[MuJoCo README](../../cleany_mujoco_sim/docs/scenes.md)를 따른다.

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

## 분류·운반 실행 계약

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

## 분류된 수거함으로 직접 이동 / 손목 유지 (기본 모드)

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

- `sorting_fixed_release_lost_items_left_m`: `[-0.075, 0.105, 0.50]`
- `sorting_fixed_release_trash_right_m`: `[-0.075, -0.105, 0.50]`

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

## 파지 후 후퇴/들어 올리기의 손목 제약

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

예전 라벨 allowlist 정책, 테이블 배치 구역, 경유점/영역 탐색 운반은 제거했다.
