asm17-moving-agent/cleany/docs/presentation-design/references/reference-02-blue-ir-data.png

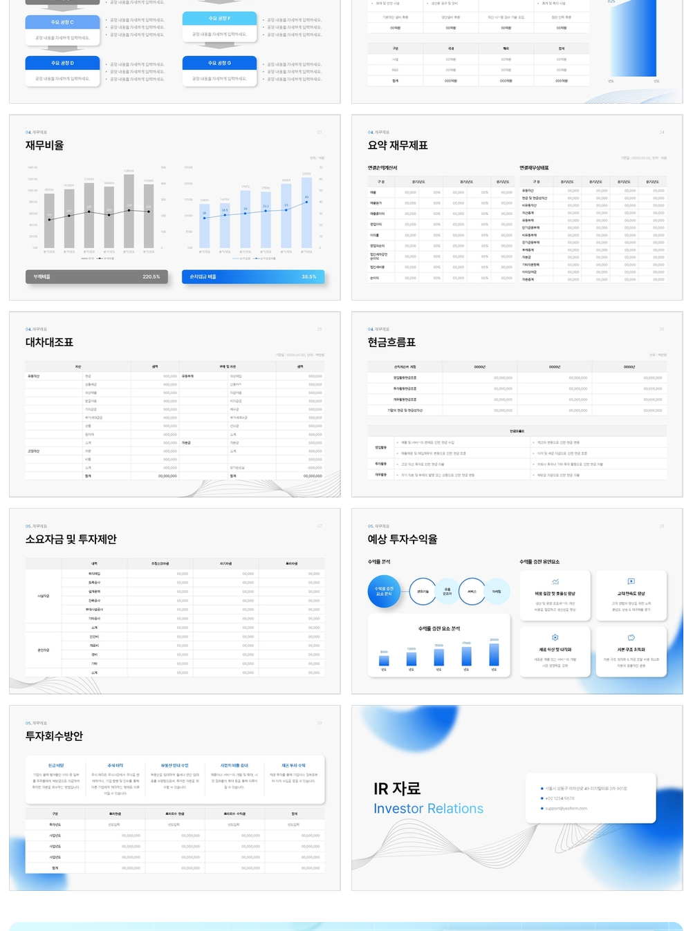
docs/presentation-design/references/reference-02-blue-ir-data.png
