asm17-moving-agent/cleany/ros2_ws/src/cleany_description/docs/assets/cad-gripper-before-after.png

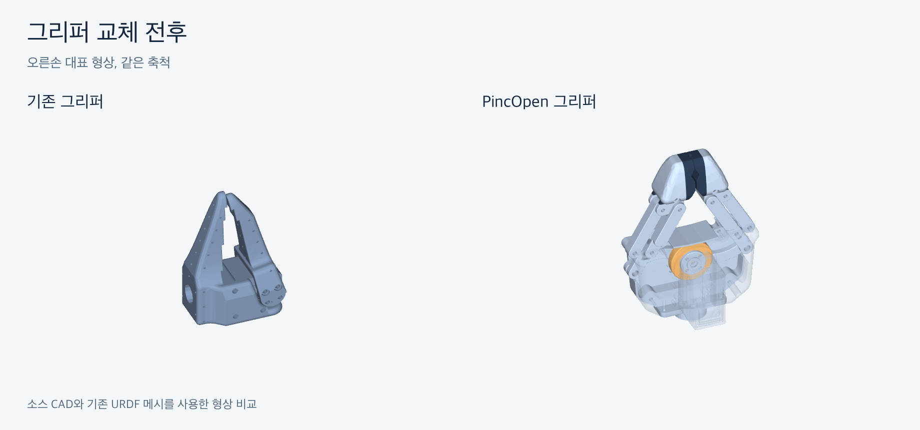
ros2_ws/src/cleany_description/docs/assets/cad-gripper-before-after.png
