asm17-moving-agent/cleany/ros2_ws/src/cleany_description/meshes/freecad_final/Aligned_AssembledLowerTube.stl

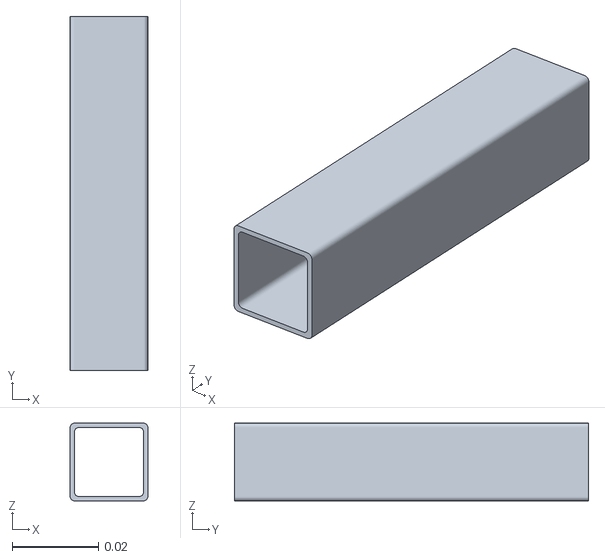
[picture p5: CAD file, 2026-11-13]
ros2_ws/src/cleany_description/meshes/freecad_final/Aligned_AssembledLowerTube.stl
0.018 x 0.082 x 0.018
