asm17-moving-agent/cleany/ros2_ws/src/cleany_description/meshes/freecad_final/AssembledShoulderSocket001.stl

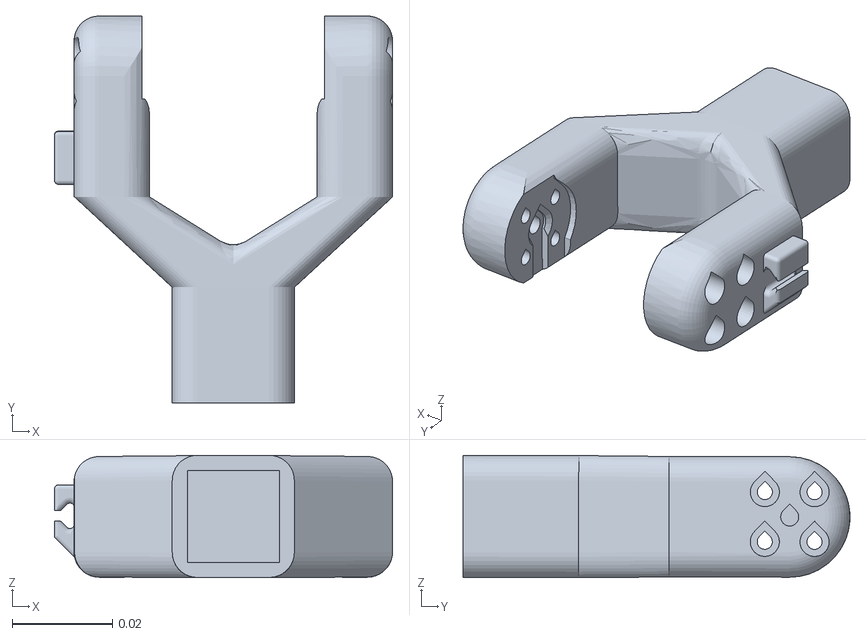
[picture p6: CAD file, 2026-11-13]
ros2_ws/src/cleany_description/meshes/freecad_final/AssembledShoulderSocket001.stl
0.0673 x 0.077 x 0.0243
