asm17-moving-agent/cleany/ros2_ws/src/cleany_description/meshes/freecad_final/Aligned_AssembledElbowBSocket001.stl

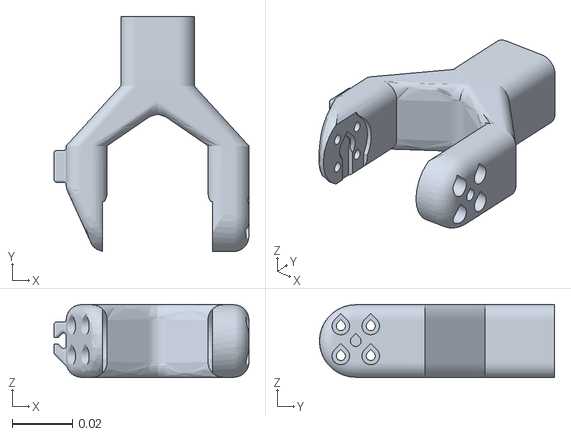
[picture p7: CAD file, 2026-11-13]
ros2_ws/src/cleany_description/meshes/freecad_final/Aligned_AssembledElbowBSocket001.stl
0.0644 x 0.0777 x 0.0243
