asm17-moving-agent/cleany/ros2_ws/src/cleany_description/meshes/freecad_final/AssembledUpperTube.stl

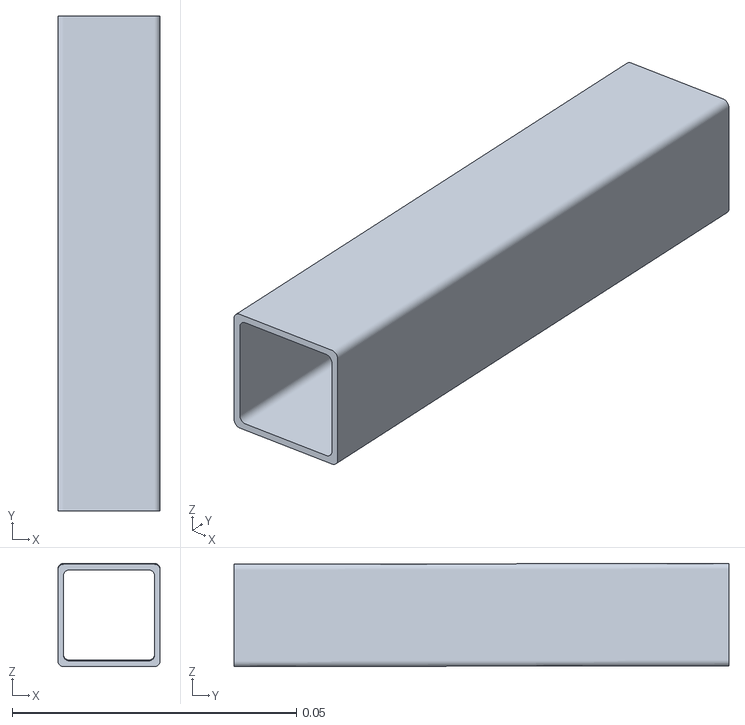
[picture p8: CAD file, 2026-11-13]
ros2_ws/src/cleany_description/meshes/freecad_final/AssembledUpperTube.stl
0.018 x 0.087 x 0.0182
