asm17-moving-agent/cleany/ros2_ws/src/cleany_description/meshes/freecad_final/Aligned_AssembledWristSocket.stl

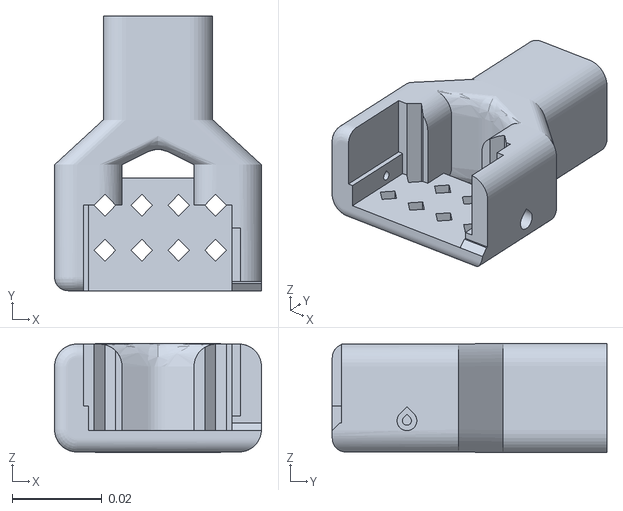
[picture p9: CAD file, 2026-11-13]
ros2_ws/src/cleany_description/meshes/freecad_final/Aligned_AssembledWristSocket.stl
0.046 x 0.061 x 0.0243
