asm17-moving-agent/cleany/ros2_ws/src/cleany_description/meshes/cad_frame/lower_left_side_rail.stl

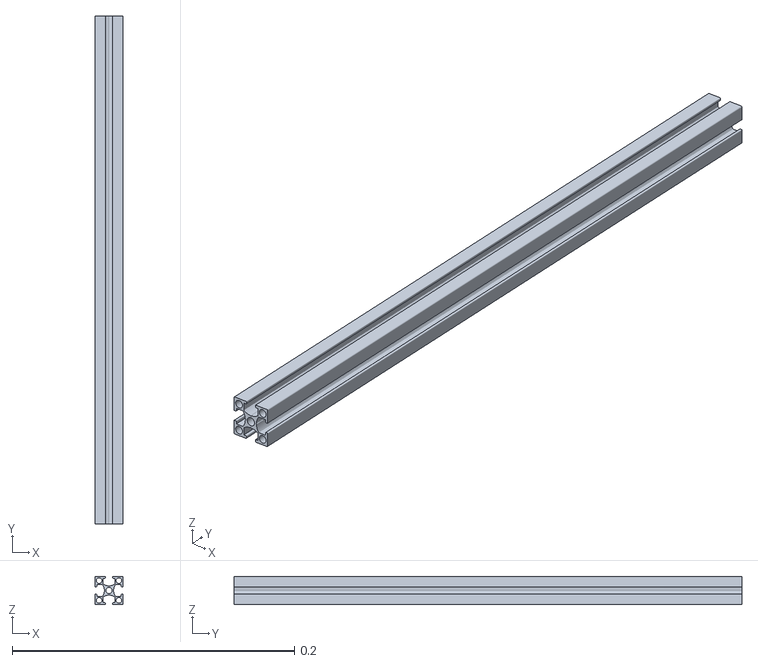
[picture p11: CAD file, 2026-09-28]
ros2_ws/src/cleany_description/meshes/cad_frame/lower_left_side_rail.stl
0.02 x 0.36 x 0.02
