asm17-moving-agent/cleany/ros2_ws/src/cleany_description/meshes/collision/tophead4.stl

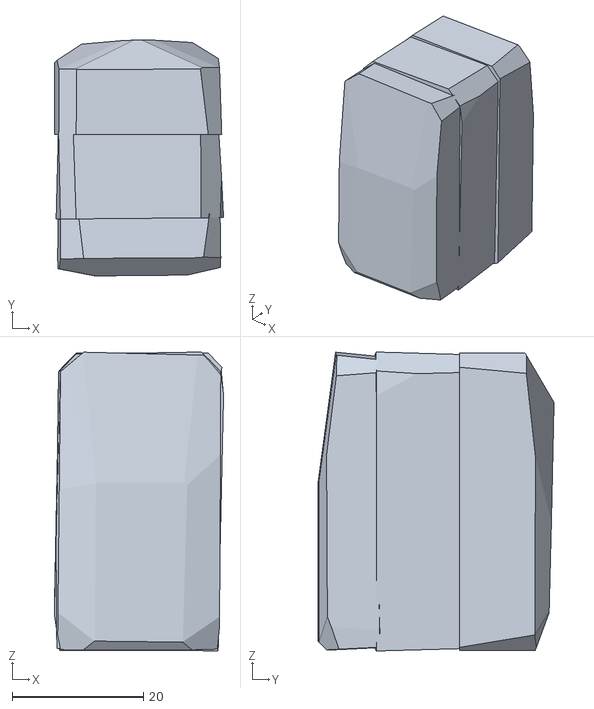
[picture p12: CAD file, 2026-11-02]
ros2_ws/src/cleany_description/meshes/collision/tophead4.stl
25.8 x 35.9 x 45.5
