asm17-moving-agent/cleany/ros2_ws/src/cleany_description/meshes/freecad_final/HeadPanBracket.stl

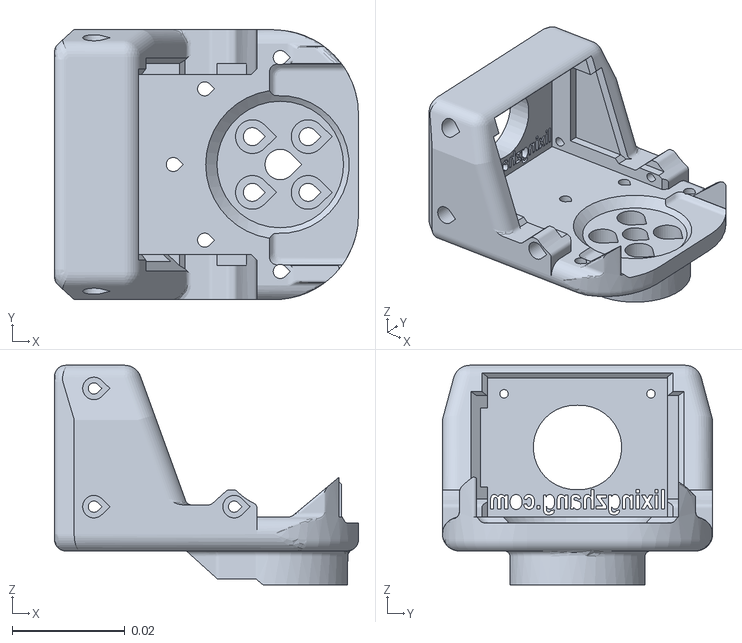
[picture p13: CAD file, 2026-11-13]
ros2_ws/src/cleany_description/meshes/freecad_final/HeadPanBracket.stl
0.054 x 0.048 x 0.039
