asm17-moving-agent/cleany/ros2_ws/src/cleany_description/meshes/wrist_mount_v8/components/foot.stl

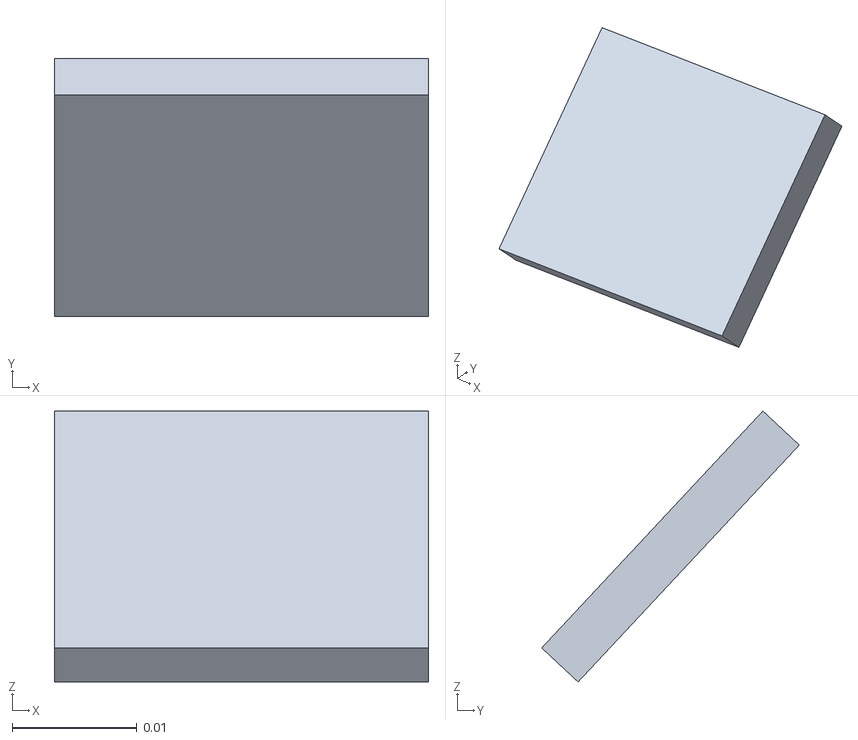
[picture p14: CAD file, 2026-10-21]
ros2_ws/src/cleany_description/meshes/wrist_mount_v8/components/foot.stl
0.03 x 0.0207 x 0.0217
