asm17-moving-agent/cleany/ros2_ws/src/cleany_description/meshes/cad_frame/fl_upright.stl

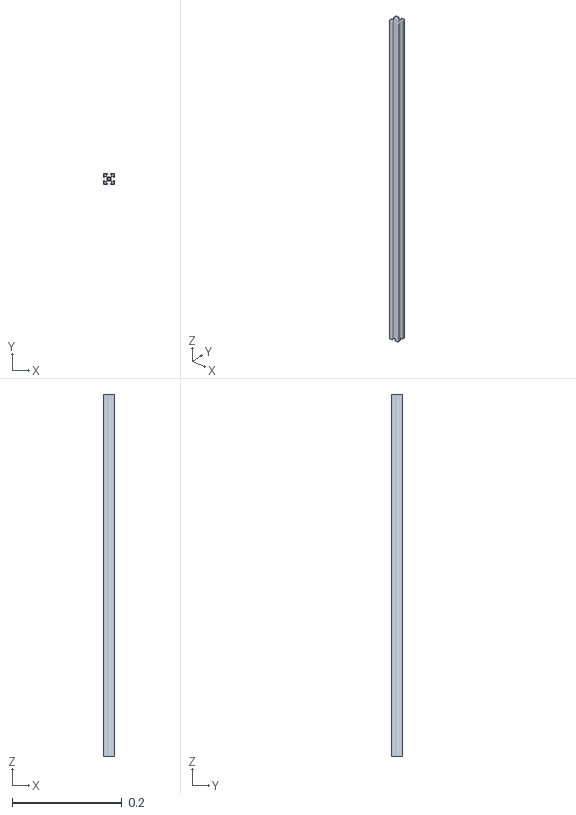
[picture p15: CAD file, 2026-09-28]
ros2_ws/src/cleany_description/meshes/cad_frame/fl_upright.stl
0.02 x 0.02 x 0.66
