asm17-moving-agent/cleany/ros2_ws/src/cleany_description/meshes/collision/Rotation_Pitch_Motor.stl

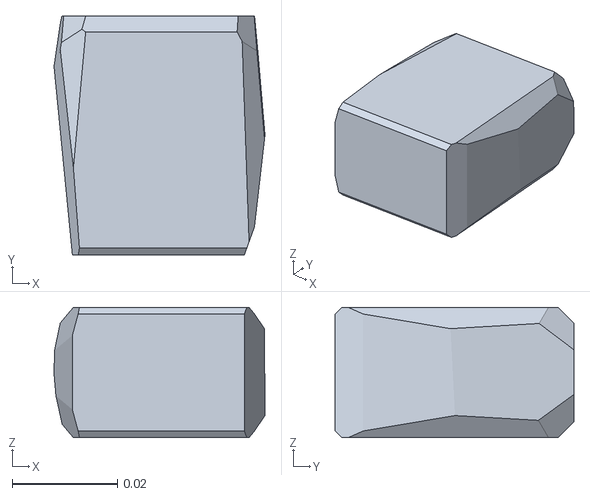
[picture p16: CAD file, 2026-11-02]
ros2_ws/src/cleany_description/meshes/collision/Rotation_Pitch_Motor.stl
0.0401 x 0.0454 x 0.0248
