asm17-moving-agent/cleany/ros2_ws/src/cleany_description/meshes/wrist_mount_v8/components/rear_clip_left.stl

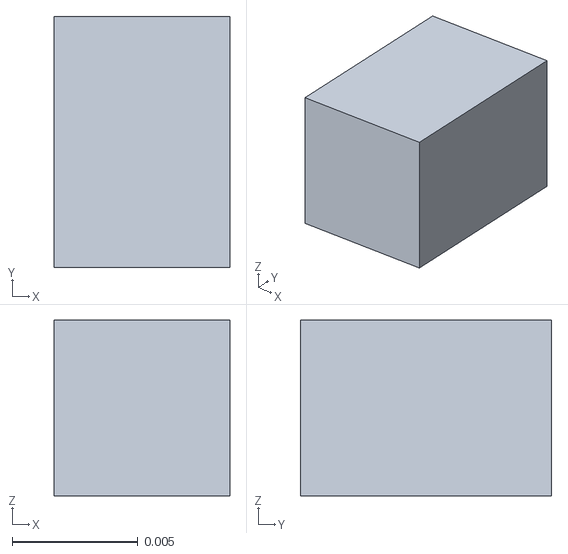
[picture p17: CAD file, 2026-10-21]
ros2_ws/src/cleany_description/meshes/wrist_mount_v8/components/rear_clip_left.stl
0.007 x 0.01 x 0.007
