asm17-moving-agent/cleany/ros2_ws/src/cleany_description/meshes/freecad_final/WristPrint001.stl

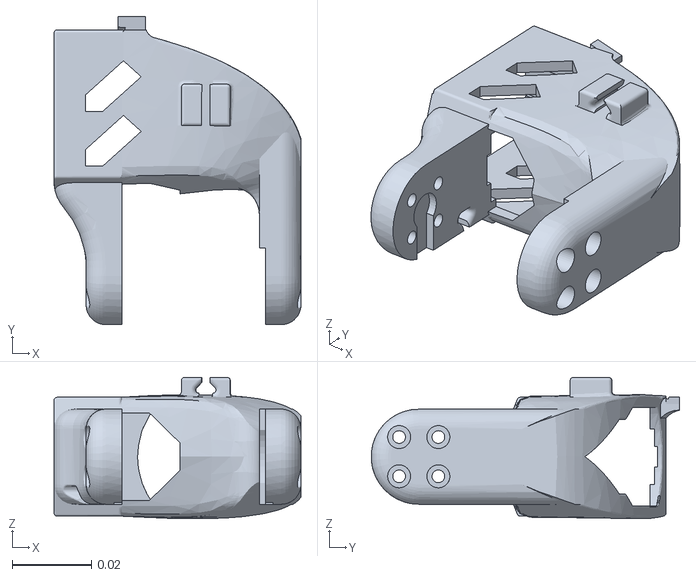
[picture p18: CAD file, 2026-11-13]
ros2_ws/src/cleany_description/meshes/freecad_final/WristPrint001.stl
0.0623 x 0.0778 x 0.0356
