asm17-moving-agent/cleany/ros2_ws/src/cleany_description/meshes/Moving_Jaw_part2.ply.convex.stl

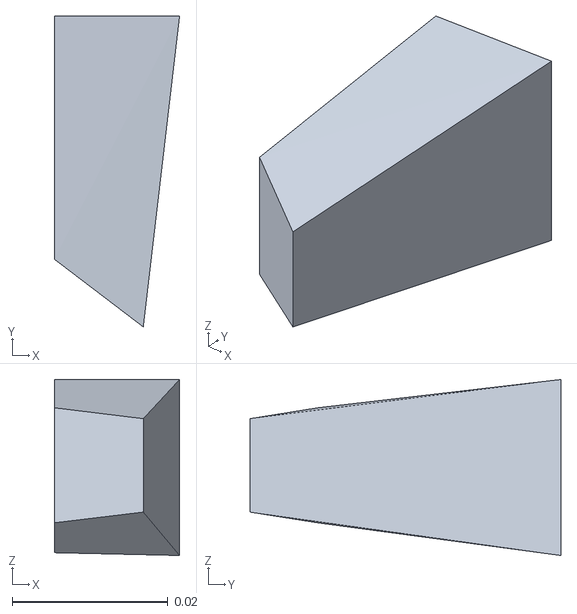
[picture p19: CAD file, 2026-07-31]
ros2_ws/src/cleany_description/meshes/Moving_Jaw_part2.ply.convex.stl
0.0161 x 0.0399 x 0.0226
