asm17-moving-agent/cleany/ros2_ws/src/cleany_description/meshes/wrist_mount_v8/components/case_back.stl

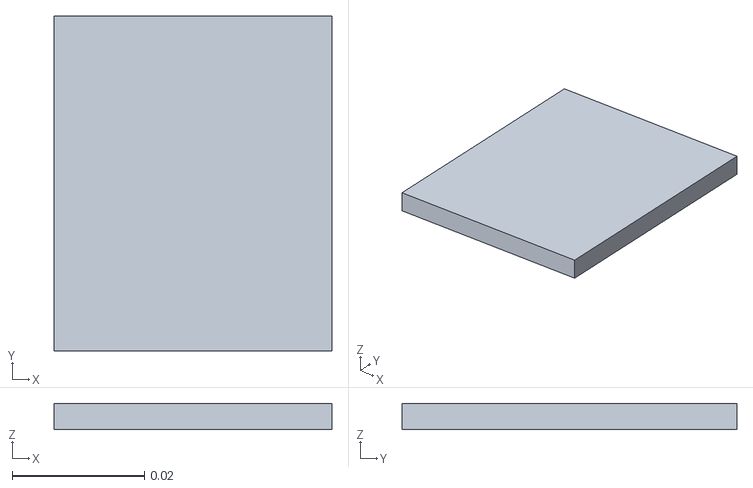
[picture p20: CAD file, 2026-10-21]
ros2_ws/src/cleany_description/meshes/wrist_mount_v8/components/case_back.stl
0.0421 x 0.0507 x 0.004
