asm17-moving-agent/cleany/ros2_ws/src/cleany_description/meshes/freecad_final/LeftKinematic_CameraTool180_Pinc_Driving_Rod_R.stl

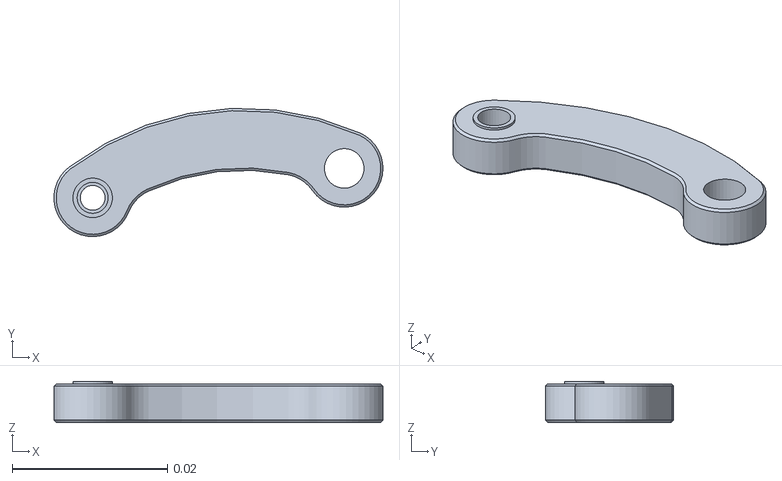
[picture p21: CAD file, 2026-11-13]
ros2_ws/src/cleany_description/meshes/freecad_final/LeftKinematic_CameraTool180_Pinc_Driving_Rod_R.stl
0.0424 x 0.0165 x 0.0053
