asm17-moving-agent/cleany/ros2_ws/src/cleany_description/meshes/cad_frame/topbase1.stl

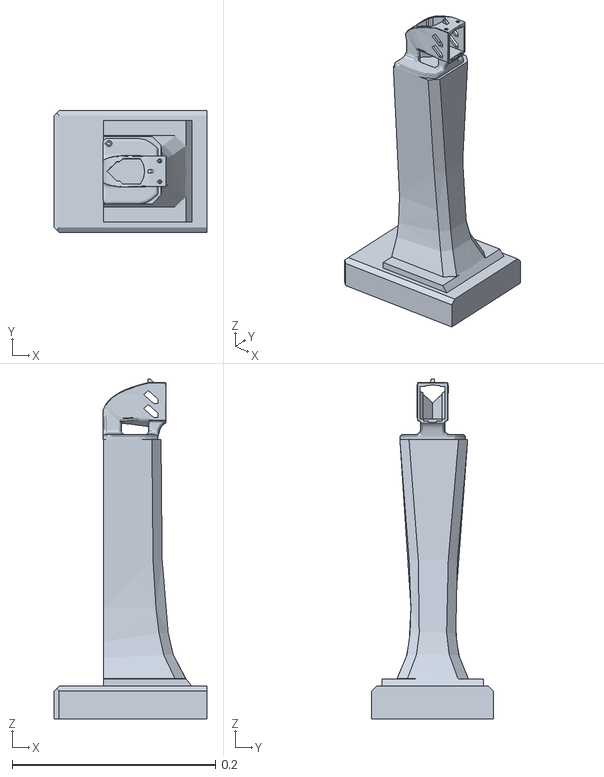
[picture p22: CAD file, 2026-09-28]
ros2_ws/src/cleany_description/meshes/cad_frame/topbase1.stl
0.15 x 0.12 x 0.335
