asm17-moving-agent/cleany/ros2_ws/src/cleany_description/meshes/Fixed_Jaw_Motor.stl.convex.stl

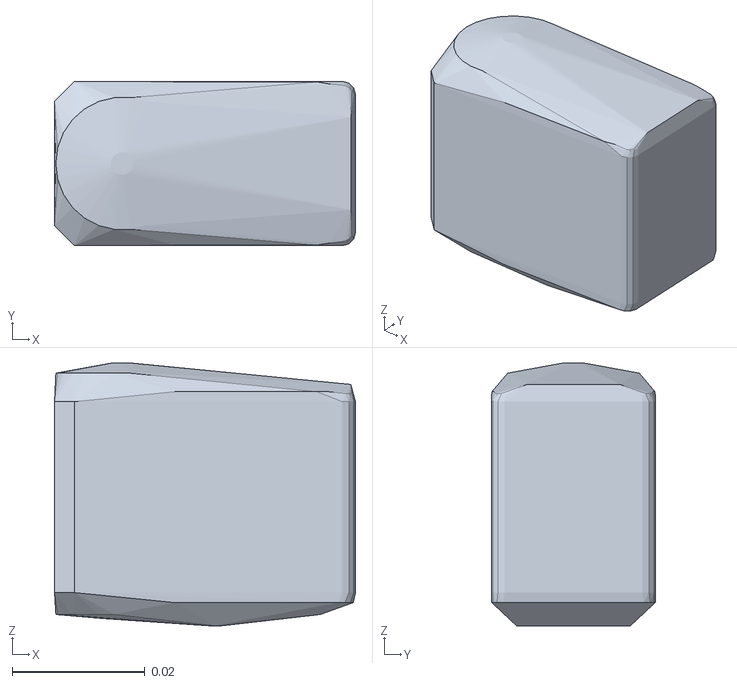
[picture p23: CAD file, 2026-07-31]
ros2_ws/src/cleany_description/meshes/Fixed_Jaw_Motor.stl.convex.stl
0.0454 x 0.0248 x 0.0396
