asm17-moving-agent/cleany/ros2_ws/src/cleany_description/meshes/cad_frame/upper_front_cross_rail.stl

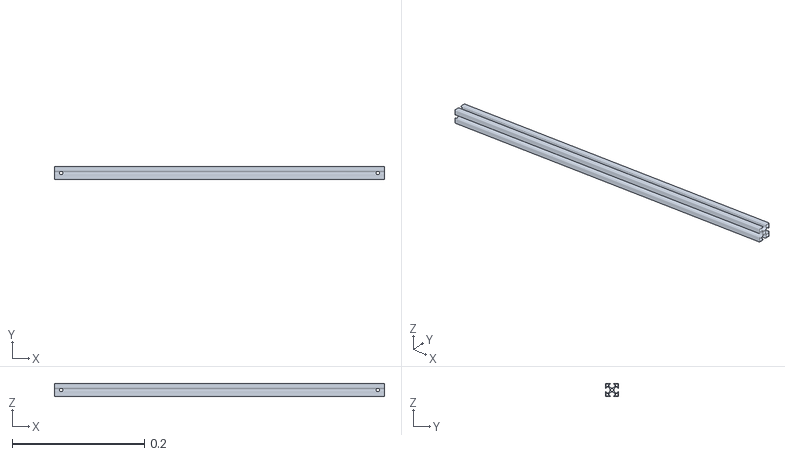
[picture p25: CAD file, 2026-09-28]
ros2_ws/src/cleany_description/meshes/cad_frame/upper_front_cross_rail.stl
0.5 x 0.02 x 0.02
