asm17-moving-agent/cleany/ros2_ws/src/cleany_description/meshes/freecad_final/RightKinematic_CameraTool180_Pinc_External_Rod_L.stl

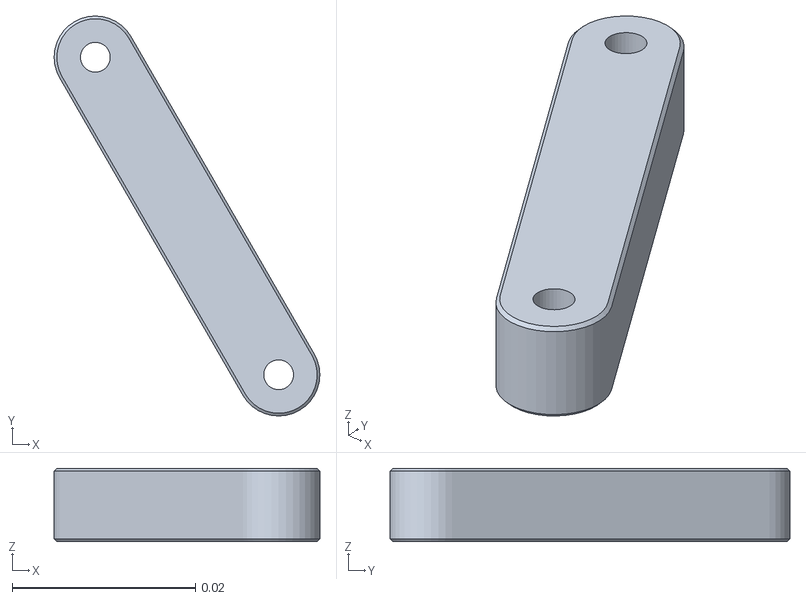
[picture p26: CAD file, 2026-11-13]
ros2_ws/src/cleany_description/meshes/freecad_final/RightKinematic_CameraTool180_Pinc_External_Rod_L.stl
0.029 x 0.0436 x 0.008
