asm17-moving-agent/cleany/ros2_ws/src/cleany_description/meshes/freecad_final/WristDriveHorn001.stl

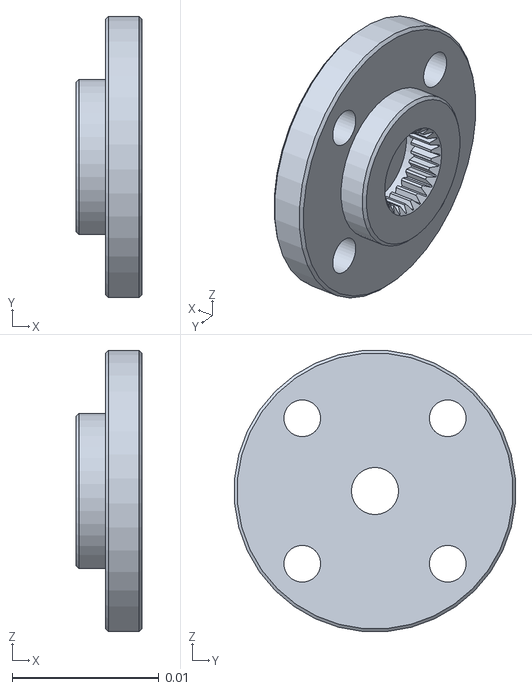
[picture p27: CAD file, 2026-11-13]
ros2_ws/src/cleany_description/meshes/freecad_final/WristDriveHorn001.stl
0.0045 x 0.0191 x 0.0191
