asm17-moving-agent/cleany/ros2_ws/src/cleany_description/meshes/cad_frame/front_inner_lower_cross_rail.stl

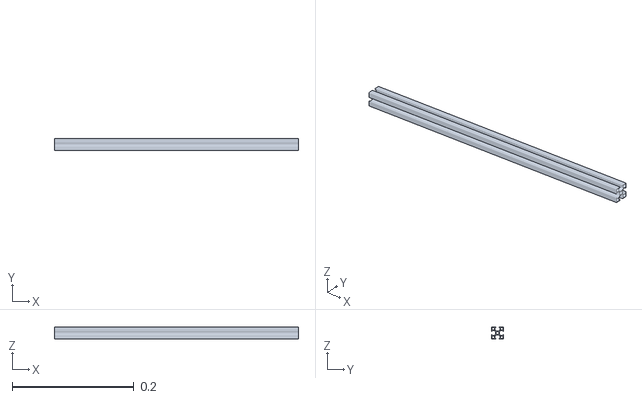
[picture p29: CAD file, 2026-09-28]
ros2_ws/src/cleany_description/meshes/cad_frame/front_inner_lower_cross_rail.stl
0.4 x 0.02 x 0.02
