asm17-moving-agent/cleany/ros2_ws/src/cleany_description/meshes/cad_frame/part_1__2.stl

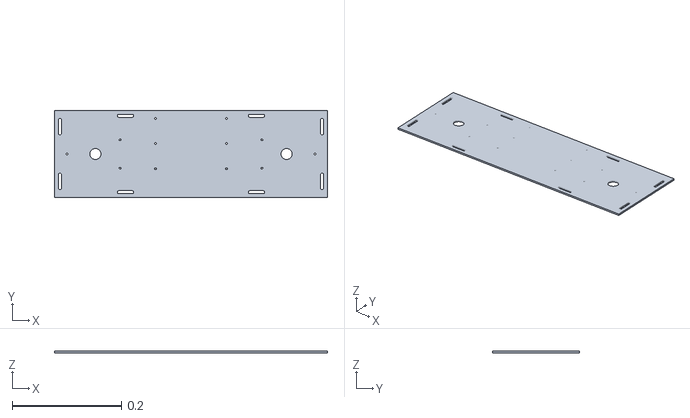
[picture p30: CAD file, 2026-09-28]
ros2_ws/src/cleany_description/meshes/cad_frame/part_1__2.stl
0.5 x 0.16 x 0.003
