asm17-moving-agent/cleany/ros2_ws/src/cleany_description/meshes/freecad_final/FomexTopRearBacking.stl

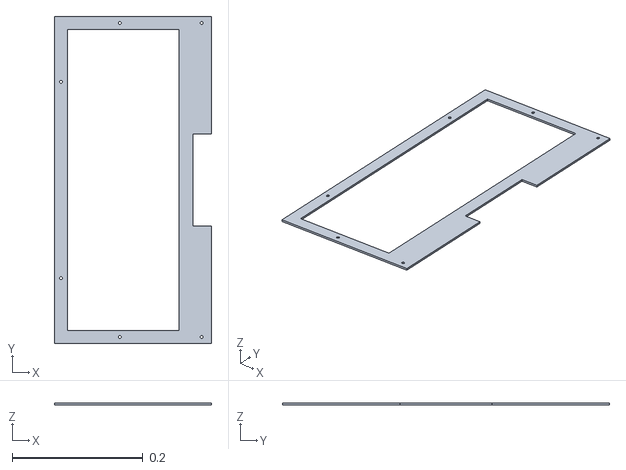
[picture p31: CAD file, 2026-11-13]
ros2_ws/src/cleany_description/meshes/freecad_final/FomexTopRearBacking.stl
0.24 x 0.5 x 0.003
