asm17-moving-agent/cleany/ros2_ws/src/cleany_description/meshes/cad_frame/pg42_motor_bracket.stl

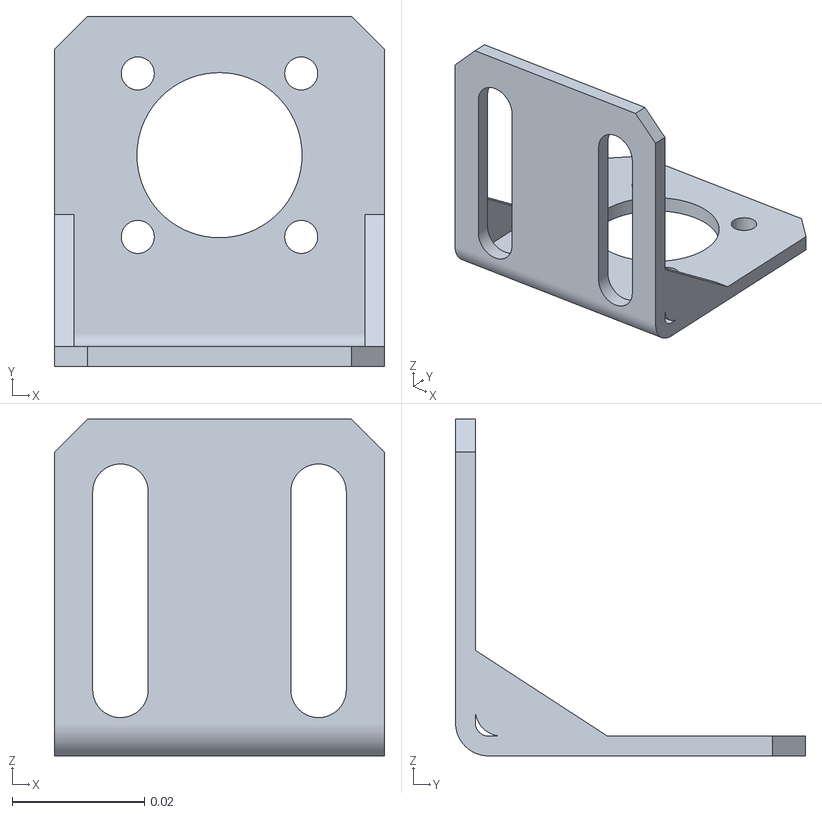
[picture p33: CAD file, 2026-09-28]
ros2_ws/src/cleany_description/meshes/cad_frame/pg42_motor_bracket.stl
0.05 x 0.053 x 0.051
