asm17-moving-agent/cleany/ros2_ws/src/cleany_description/meshes/Wrist_Pitch_Roll_Motor.stl

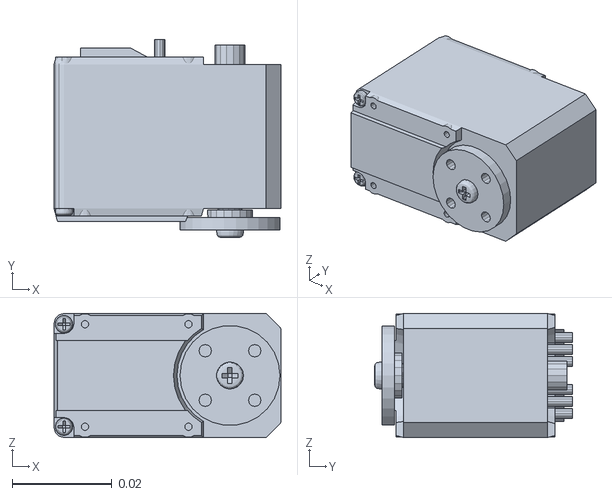
[picture p34: CAD file, 2026-07-31]
ros2_ws/src/cleany_description/meshes/Wrist_Pitch_Roll_Motor.stl
0.0454 x 0.0396 x 0.0248
