asm17-moving-agent/cleany/ros2_ws/src/cleany_description/meshes/cad_frame/pg42_4266_1270ne___1_61.stl

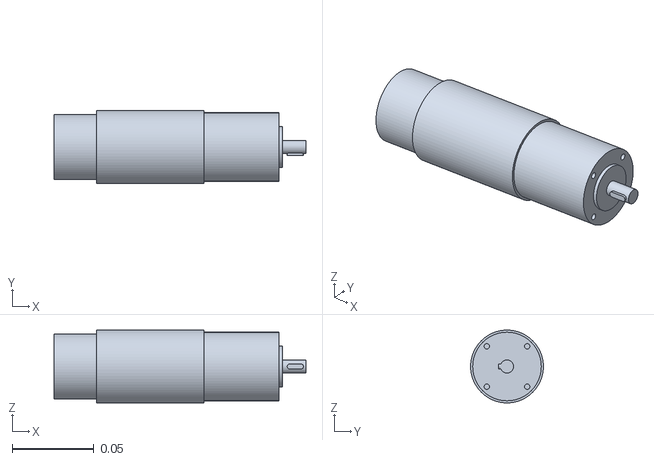
[picture p36: CAD file, 2026-09-28]
ros2_ws/src/cleany_description/meshes/cad_frame/pg42_4266_1270ne___1_61.stl
0.154 x 0.0446 x 0.0446
