asm17-moving-agent/cleany/ros2_ws/src/cleany_description/meshes/freecad_final/InstalledProfile18.stl

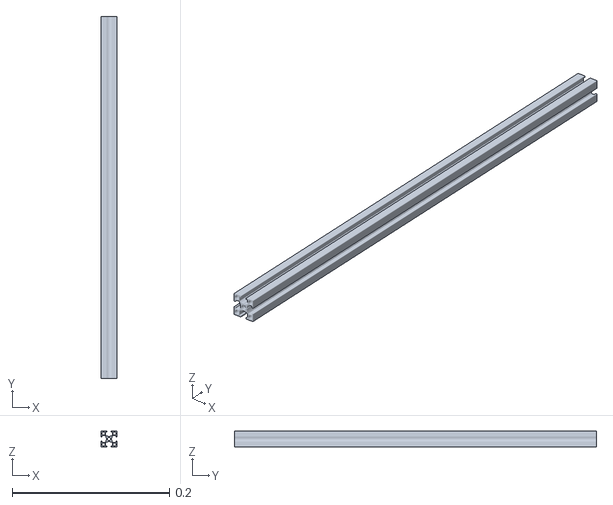
[picture p37: CAD file, 2026-11-13]
ros2_ws/src/cleany_description/meshes/freecad_final/InstalledProfile18.stl
0.02 x 0.46 x 0.02
