asm17-moving-agent/cleany/ros2_ws/src/cleany_description/meshes/topbase1.stl

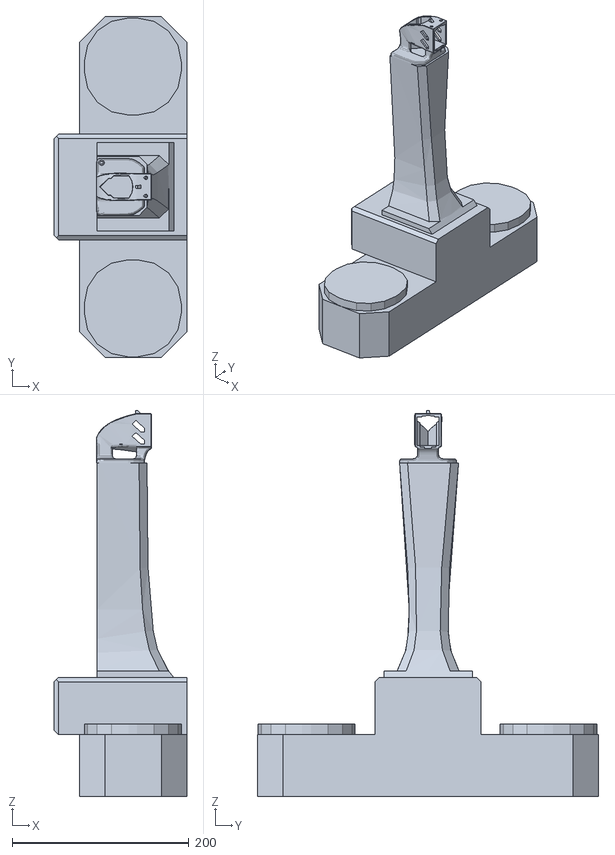
[picture p38: CAD file, 2026-07-31]
ros2_ws/src/cleany_description/meshes/topbase1.stl
150.4 x 386.3 x 437.4
