asm17-moving-agent/cleany/ros2_ws/src/cleany_description/meshes/cad_frame/035armbase_step__êäèë4.stl

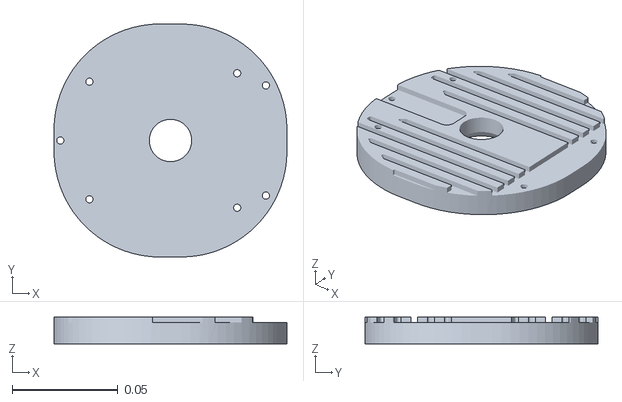
[picture p39: CAD file, 2026-09-28]
ros2_ws/src/cleany_description/meshes/cad_frame/035armbase_step__êäèë4.stl
0.11 x 0.11 x 0.0126
