asm17-moving-agent/cleany/ros2_ws/src/cleany_description/meshes/freecad_final/Drive_front_right_wheel.stl

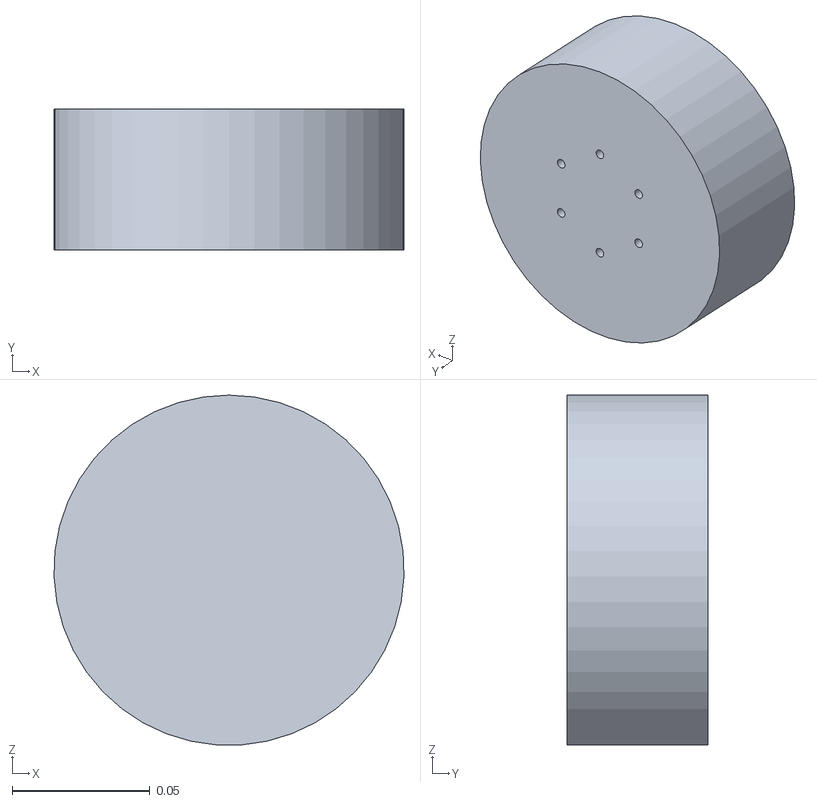
[picture p40: CAD file, 2026-11-13]
ros2_ws/src/cleany_description/meshes/freecad_final/Drive_front_right_wheel.stl
0.127 x 0.051 x 0.127
