asm17-moving-agent/cleany/ros2_ws/src/cleany_description/meshes/Upper_Arm_5cm_Carbon.stl

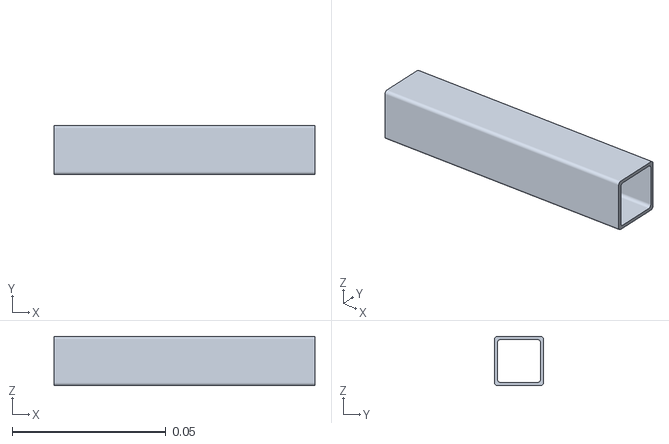
[picture p41: CAD file, 2026-07-31]
ros2_ws/src/cleany_description/meshes/Upper_Arm_5cm_Carbon.stl
0.085 x 0.016 x 0.016
