asm17-moving-agent/cleany/ros2_ws/src/cleany_description/meshes/Fixed_Jaw.stl.convex.stl

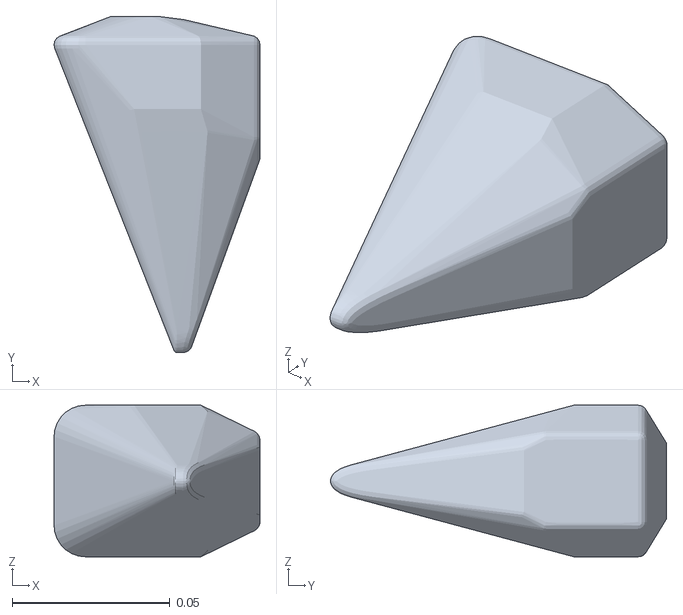
[picture p42: CAD file, 2026-07-31]
ros2_ws/src/cleany_description/meshes/Fixed_Jaw.stl.convex.stl
0.0652 x 0.106 x 0.048
