asm17-moving-agent/cleany/ros2_ws/src/cleany_description/meshes/freecad_final/RightKinematic_CameraTool180_Pinc_servo_other.stl

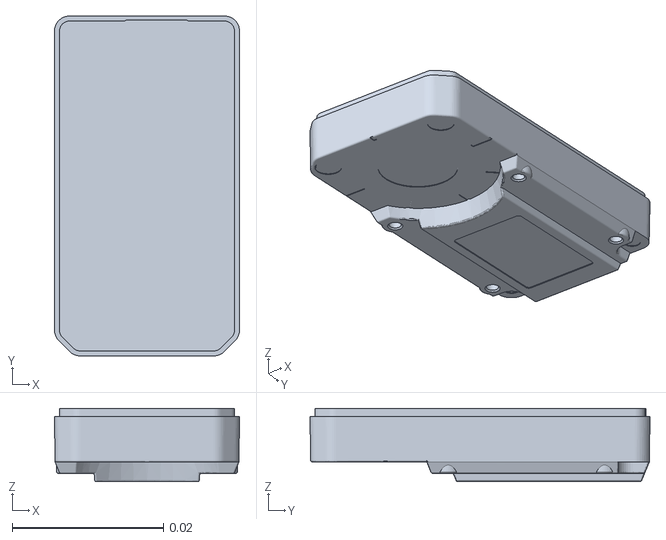
[picture p43: CAD file, 2026-11-13]
ros2_ws/src/cleany_description/meshes/freecad_final/RightKinematic_CameraTool180_Pinc_servo_other.stl
0.0245 x 0.045 x 0.0097
