asm17-moving-agent/cleany/ros2_ws/src/cleany_description/meshes/raskogwheel2.stl

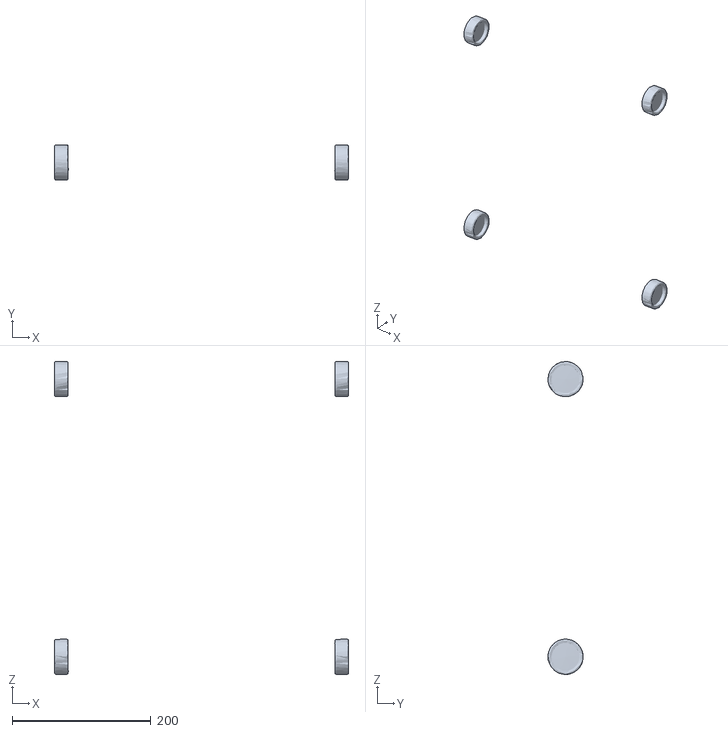
[picture p44: CAD file, 2026-07-31]
ros2_ws/src/cleany_description/meshes/raskogwheel2.stl
424.1 x 50.9 x 450.9
