asm17-moving-agent/cleany/ros2_ws/src/cleany_description/meshes/XLeRobot_camera2.stl

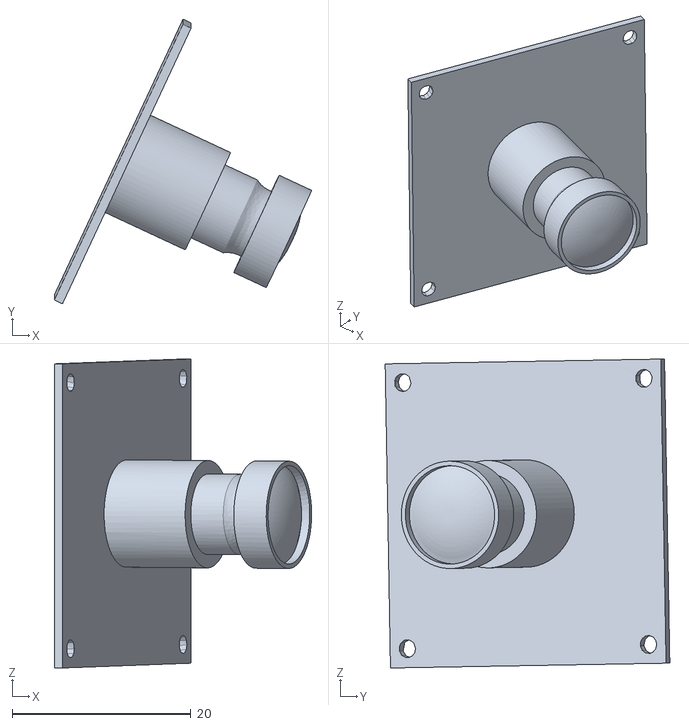
[picture p45: CAD file, 2026-07-31]
ros2_ws/src/cleany_description/meshes/XLeRobot_camera2.stl
28.8 x 31.8 x 34.5
