asm17-moving-agent/cleany/ros2_ws/src/cleany_description/meshes/Moving_Jaw.stl

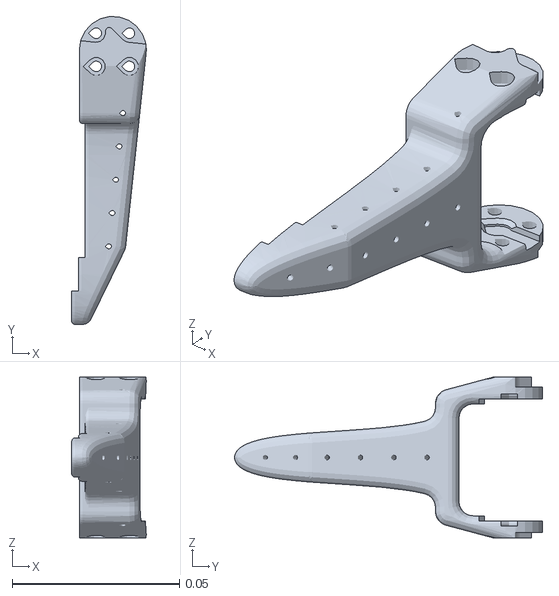
[picture p46: CAD file, 2026-07-31]
ros2_ws/src/cleany_description/meshes/Moving_Jaw.stl
0.0223 x 0.092 x 0.048
