asm17-moving-agent/cleany/ros2_ws/src/cleany_description/meshes/freecad_final/RightKinematic_CameraTool180_Pinc_Tip_Support_R.stl

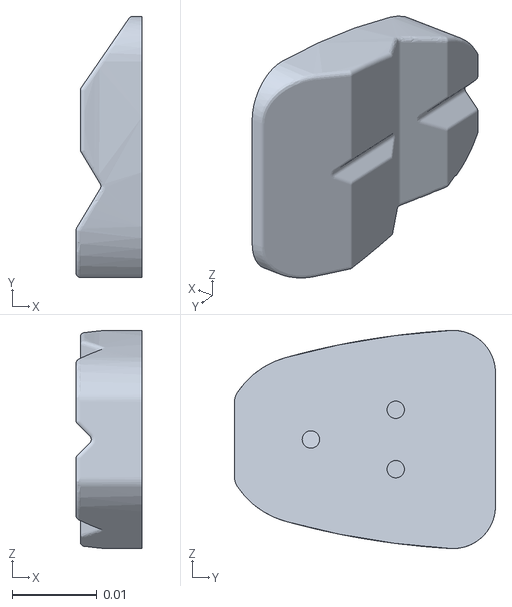
[picture p47: CAD file, 2026-11-13]
ros2_ws/src/cleany_description/meshes/freecad_final/RightKinematic_CameraTool180_Pinc_Tip_Support_R.stl
0.00775 x 0.0308 x 0.0257
