asm17-moving-agent/cleany/ros2_ws/src/cleany_description/meshes/tophead3.stl

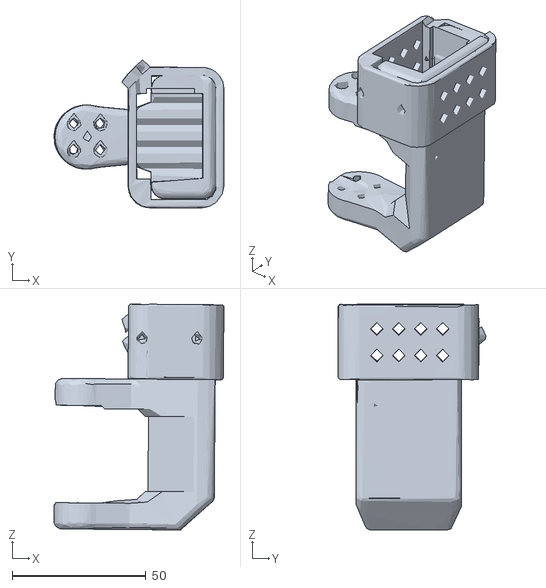
[picture p48: CAD file, 2026-07-31]
ros2_ws/src/cleany_description/meshes/tophead3.stl
63.5 x 55.2 x 84.4
