asm17-moving-agent/cleany/ros2_ws/src/cleany_description/meshes/freecad_final/Upper_servo_middle001.stl

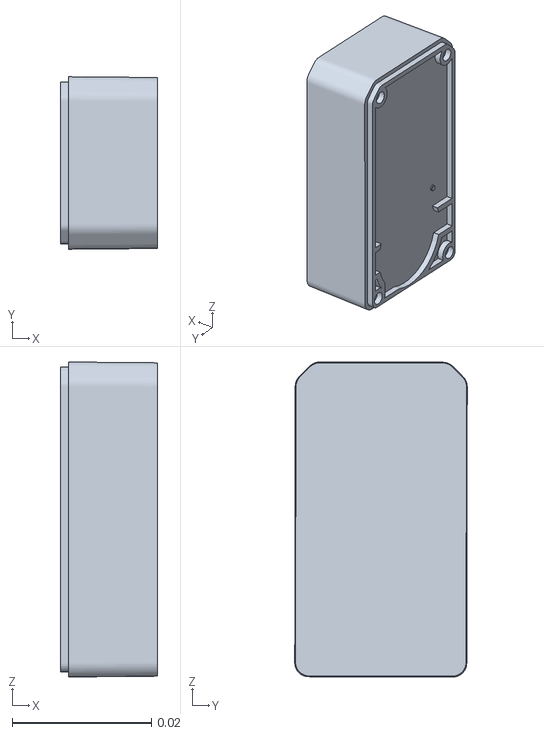
[picture p49: CAD file, 2026-11-13]
ros2_ws/src/cleany_description/meshes/freecad_final/Upper_servo_middle001.stl
0.0139 x 0.0248 x 0.0453
