asm17-moving-agent/cleany/ros2_ws/src/cleany_description/meshes/Moving_Jaw_part1.ply.convex.stl

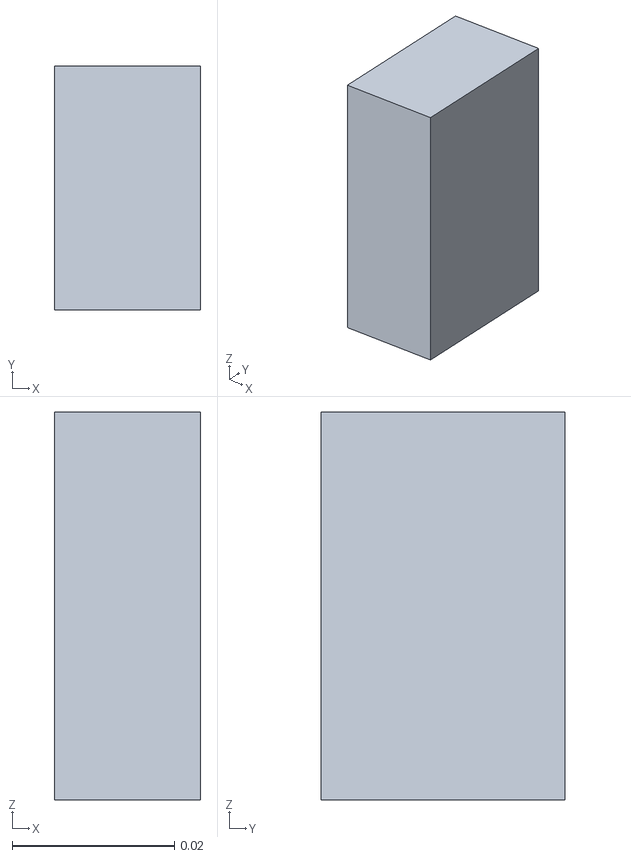
[picture p50: CAD file, 2026-07-31]
ros2_ws/src/cleany_description/meshes/Moving_Jaw_part1.ply.convex.stl
0.018 x 0.03 x 0.0478
