asm17-moving-agent/cleany/ros2_ws/src/cleany_description/meshes/Fixed_Jaw_part2.ply.convex.stl

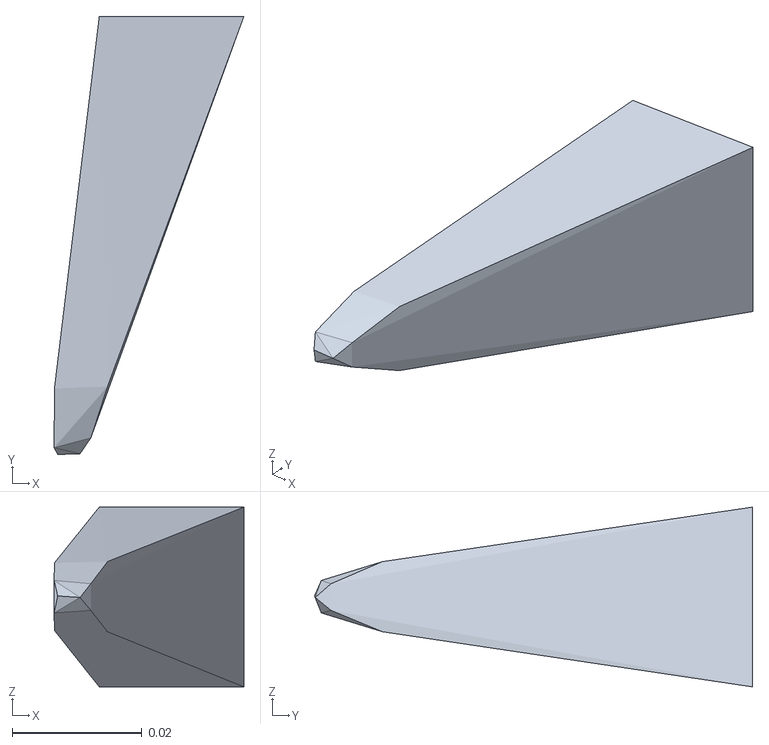
[picture p51: CAD file, 2026-07-31]
ros2_ws/src/cleany_description/meshes/Fixed_Jaw_part2.ply.convex.stl
0.0292 x 0.0675 x 0.0277
