asm17-moving-agent/cleany/ros2_ws/src/cleany_description/meshes/freecad_final/FomexFrontUpperMountCut.stl

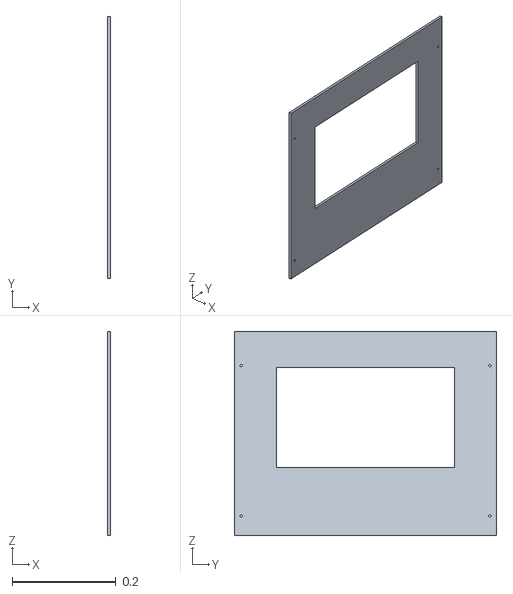
[picture p52: CAD file, 2026-11-13]
ros2_ws/src/cleany_description/meshes/freecad_final/FomexFrontUpperMountCut.stl
0.005 x 0.506 x 0.394
