asm17-moving-agent/cleany/ros2_ws/src/cleany_description/meshes/Lower_Arm.stl.convex.stl

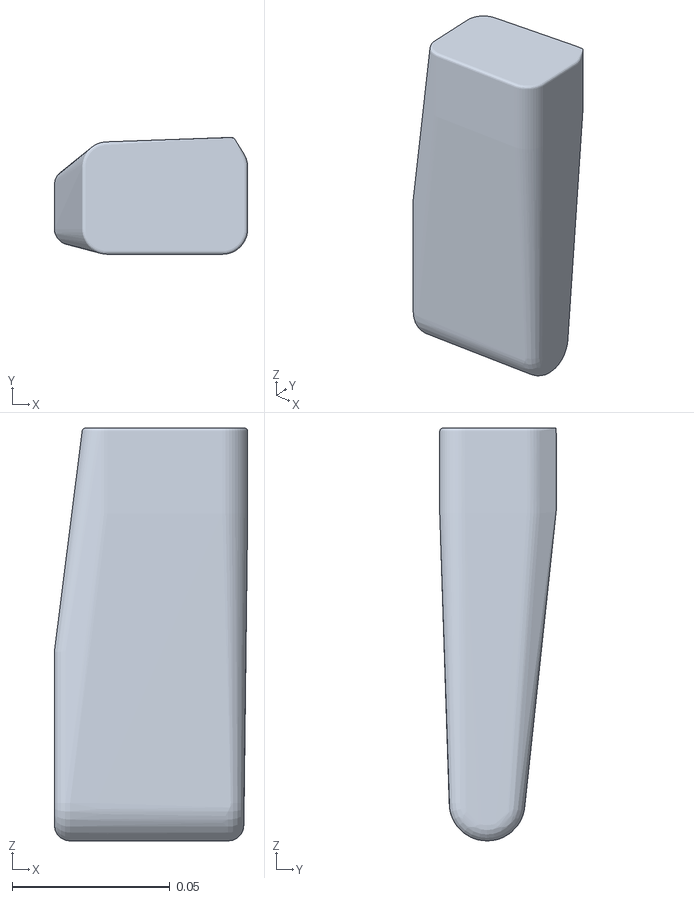
[picture p53: CAD file, 2026-07-31]
ros2_ws/src/cleany_description/meshes/Lower_Arm.stl.convex.stl
0.0612 x 0.0369 x 0.131
