asm17-moving-agent/cleany/ros2_ws/src/cleany_description/meshes/XLeRobot_camera1.stl

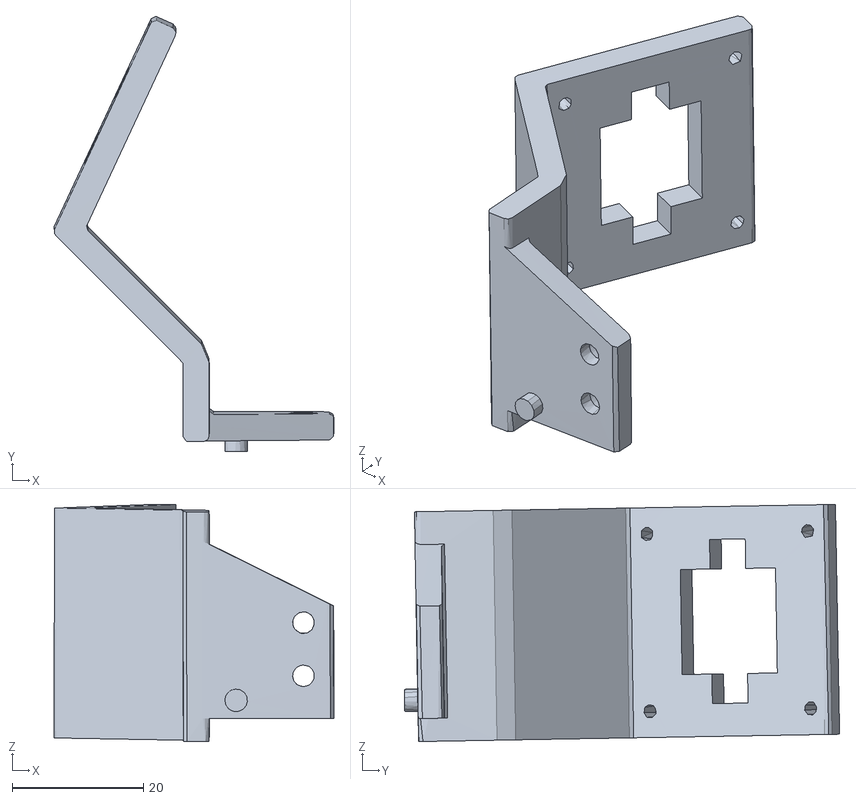
[picture p54: CAD file, 2026-07-31]
ros2_ws/src/cleany_description/meshes/XLeRobot_camera1.stl
42.6 x 66.3 x 36.1
