asm17-moving-agent/cleany/ros2_ws/src/cleany_description/meshes/Base.stl

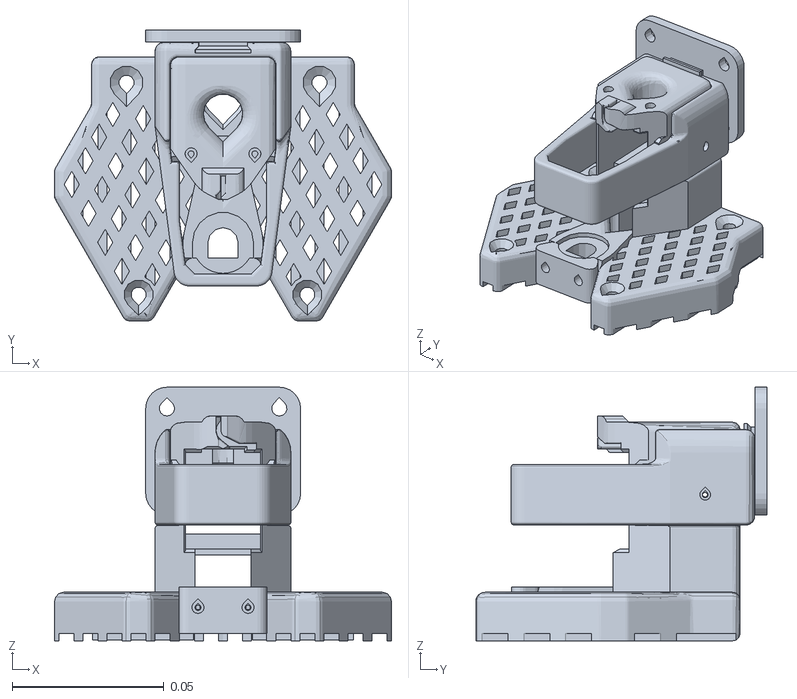
[picture p56: CAD file, 2026-07-31]
ros2_ws/src/cleany_description/meshes/Base.stl
0.111 x 0.0959 x 0.0835
