asm17-moving-agent/cleany/ros2_ws/src/cleany_description/meshes/freecad_final/FomexLeftUpperMountCut.stl

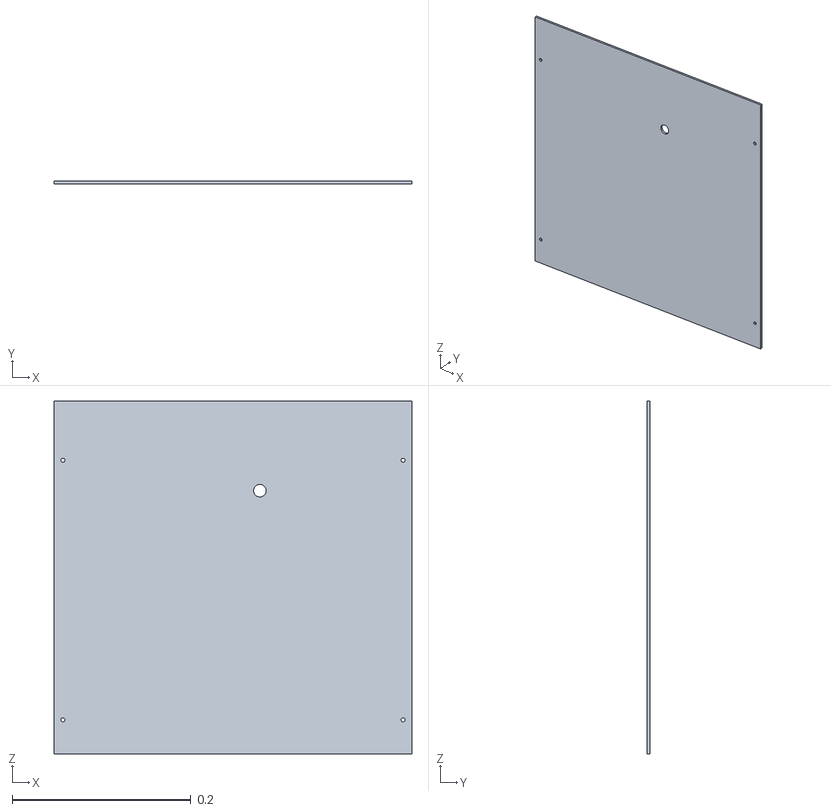
[picture p57: CAD file, 2026-11-13]
ros2_ws/src/cleany_description/meshes/freecad_final/FomexLeftUpperMountCut.stl
0.4 x 0.003 x 0.394
