asm17-moving-agent/cleany/ros2_ws/src/cleany_description/meshes/freecad_final/IMUHeader.stl

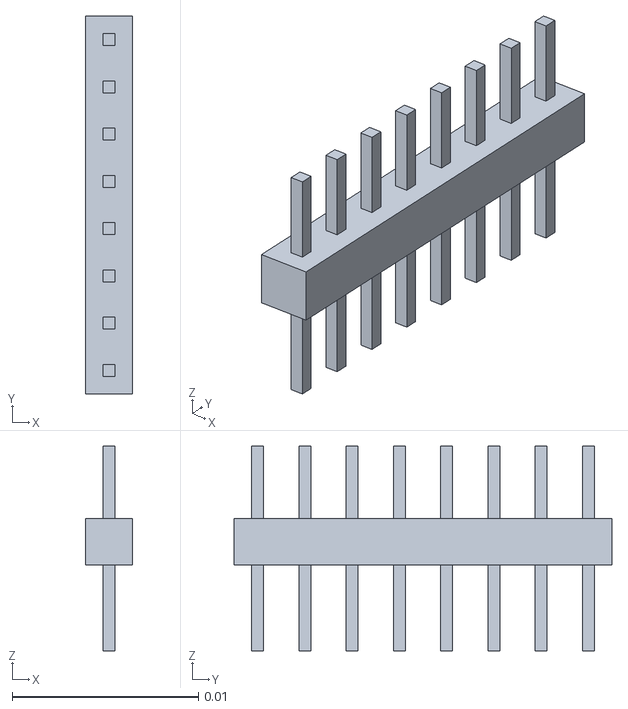
[picture p59: CAD file, 2026-11-13]
ros2_ws/src/cleany_description/meshes/freecad_final/IMUHeader.stl
0.00254 x 0.0203 x 0.011
