asm17-moving-agent/cleany/ros2_ws/src/cleany_description/meshes/tophead6.stl

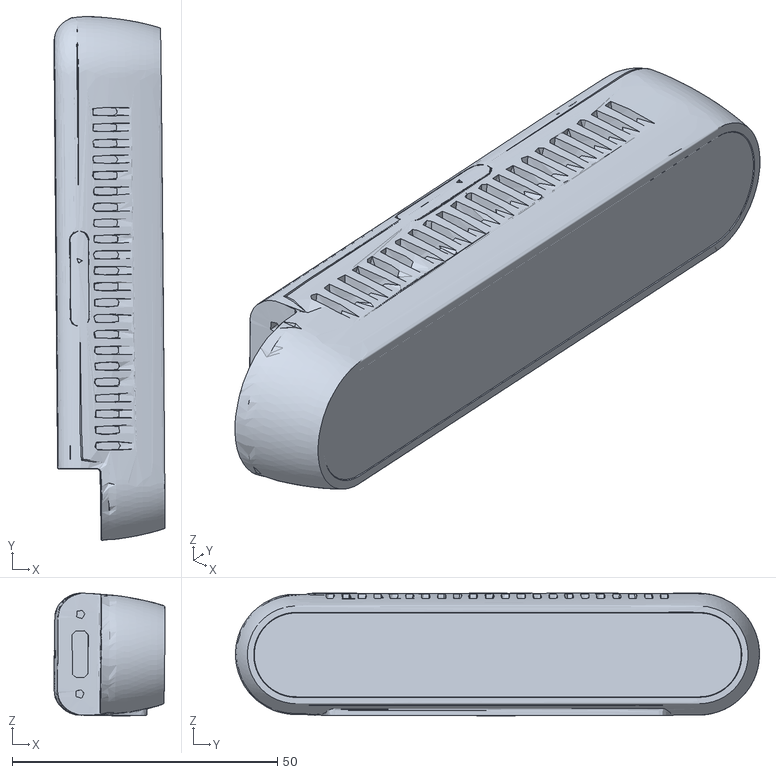
[picture p60: CAD file, 2026-07-31]
ros2_ws/src/cleany_description/meshes/tophead6.stl
20.9 x 98.8 x 23.1
