asm17-moving-agent/cleany/ros2_ws/src/cleany_description/meshes/Upper_Arm_5cm_Sockets.stl

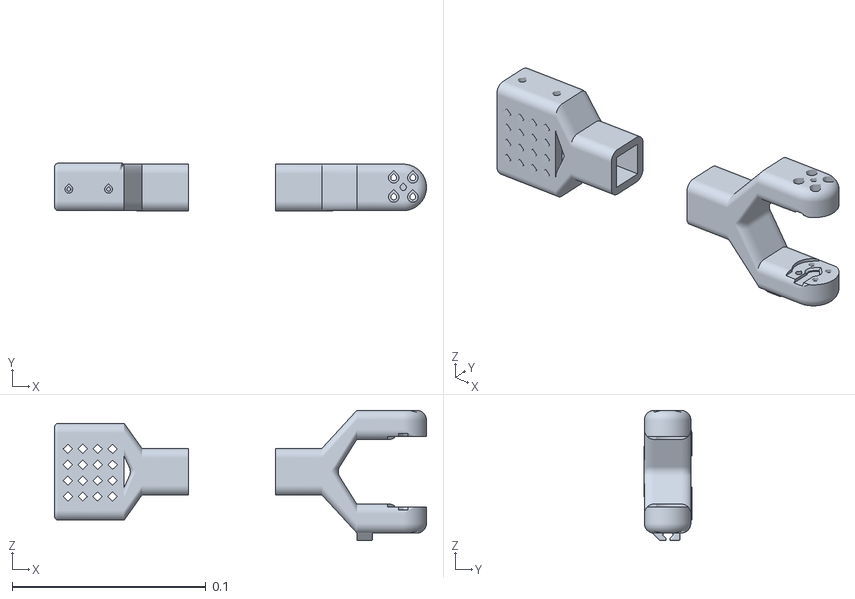
[picture p61: CAD file, 2026-07-31]
ros2_ws/src/cleany_description/meshes/Upper_Arm_5cm_Sockets.stl
0.192 x 0.0246 x 0.0673
