asm17-moving-agent/cleany/ros2_ws/src/cleany_description/meshes/Fixed_Jaw_part1.ply.convex.stl

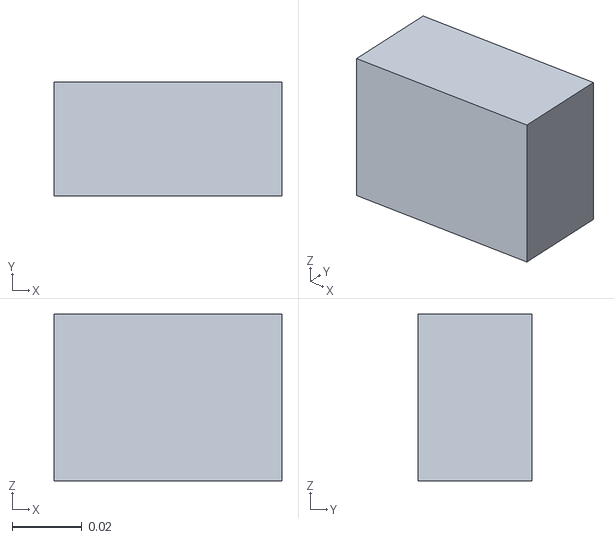
[picture p62: CAD file, 2026-07-31]
ros2_ws/src/cleany_description/meshes/Fixed_Jaw_part1.ply.convex.stl
0.0656 x 0.0328 x 0.048
