asm17-moving-agent/cleany/ros2_ws/src/cleany_description/meshes/raskogbody.stl

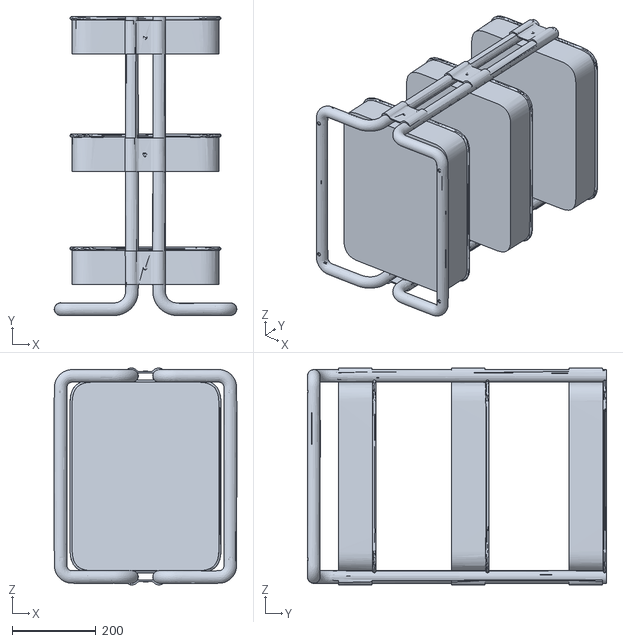
[picture p65: CAD file, 2026-07-31]
ros2_ws/src/cleany_description/meshes/raskogbody.stl
435.9 x 713.7 x 517.9
