asm17-moving-agent/cleany/ros2_ws/src/cleany_description/meshes/raskogwheel1.stl

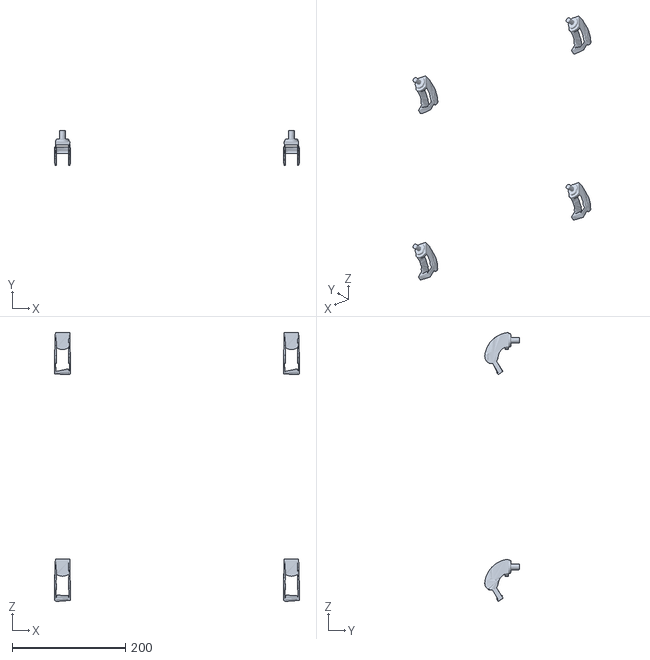
[picture p66: CAD file, 2026-07-31]
ros2_ws/src/cleany_description/meshes/raskogwheel1.stl
432.7 x 61.2 x 474.6
