asm17-moving-agent/cleany/ros2_ws/src/cleany_description/meshes/freecad_final/RightKinematic_CameraTool180_Pinc_Driving_Rod_L.stl

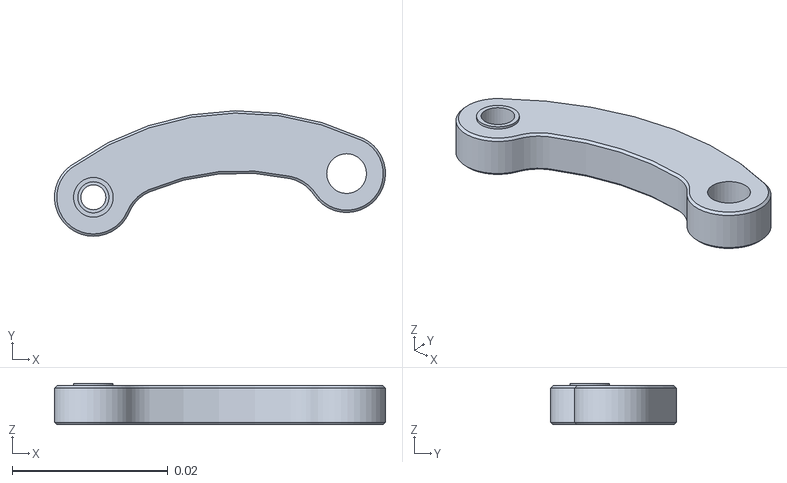
[picture p67: CAD file, 2026-11-13]
ros2_ws/src/cleany_description/meshes/freecad_final/RightKinematic_CameraTool180_Pinc_Driving_Rod_L.stl
0.0425 x 0.0161 x 0.0053
