asm17-moving-agent/cleany/ros2_ws/src/cleany_description/meshes/tophead1.stl

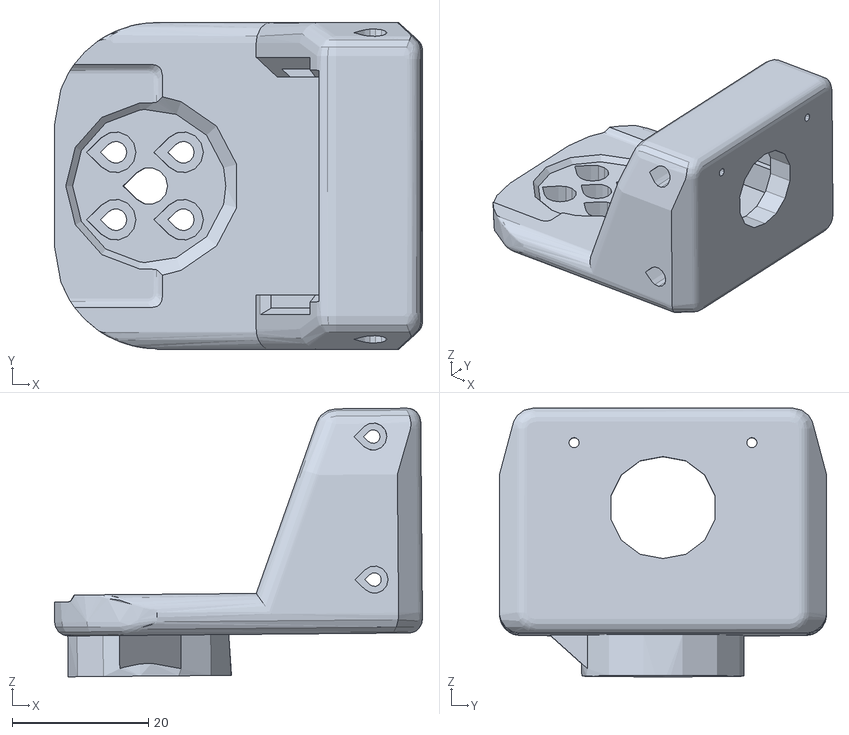
[picture p68: CAD file, 2026-07-31]
ros2_ws/src/cleany_description/meshes/tophead1.stl
54.0 x 48.0 x 39.4
