asm17-moving-agent/cleany/ros2_ws/src/cleany_description/meshes/Moving_Jaw.stl.convex.stl

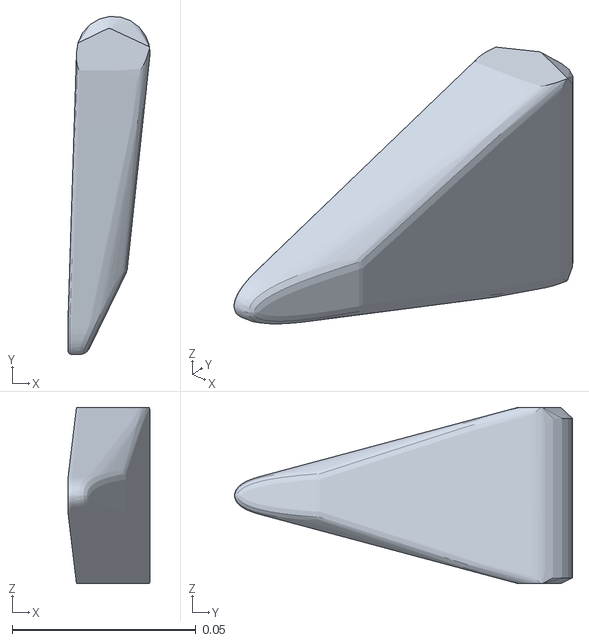
[picture p69: CAD file, 2026-07-31]
ros2_ws/src/cleany_description/meshes/Moving_Jaw.stl.convex.stl
0.0223 x 0.092 x 0.048
