asm17-moving-agent/cleany/ros2_ws/src/cleany_description/meshes/tophead5.stl

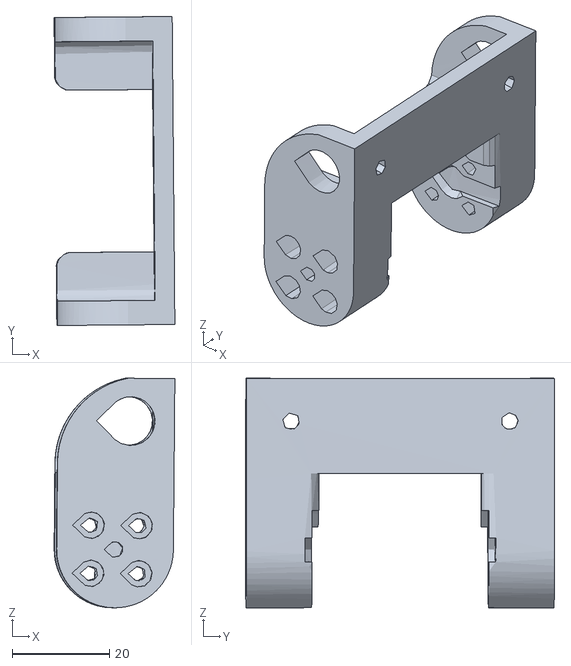
[picture p70: CAD file, 2026-07-31]
ros2_ws/src/cleany_description/meshes/tophead5.stl
24.9 x 63.6 x 47.3
