asm17-moving-agent/cleany/ros2_ws/src/cleany_description/meshes/freecad_final/LeftKinematic_CameraTool180_Pinc_Cam.stl

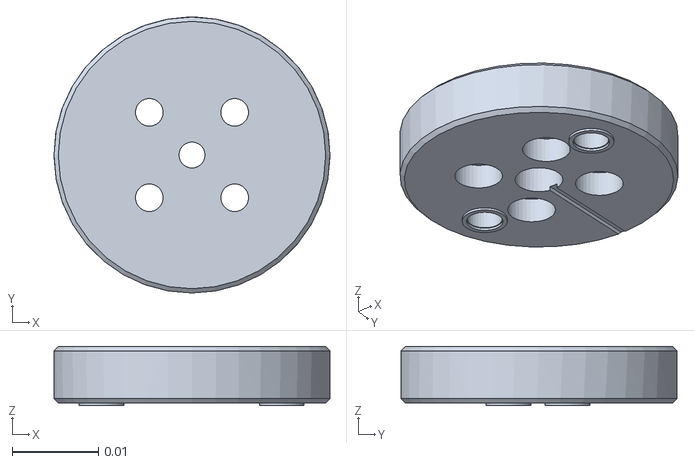
[picture p71: CAD file, 2026-11-13]
ros2_ws/src/cleany_description/meshes/freecad_final/LeftKinematic_CameraTool180_Pinc_Cam.stl
0.032 x 0.032 x 0.00685
