asm17-moving-agent/cleany/ros2_ws/src/cleany_description/meshes/Moving_Jaw_part3.ply.convex.stl

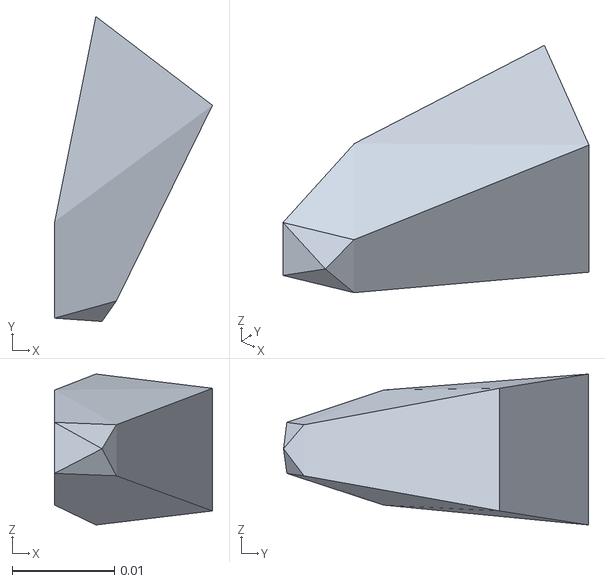
[picture p72: CAD file, 2026-07-31]
ros2_ws/src/cleany_description/meshes/Moving_Jaw_part3.ply.convex.stl
0.0155 x 0.0298 x 0.0148
