asm17-moving-agent/cleany/ros2_ws/src/cleany_description/meshes/Upper_Arm.stl.convex.stl

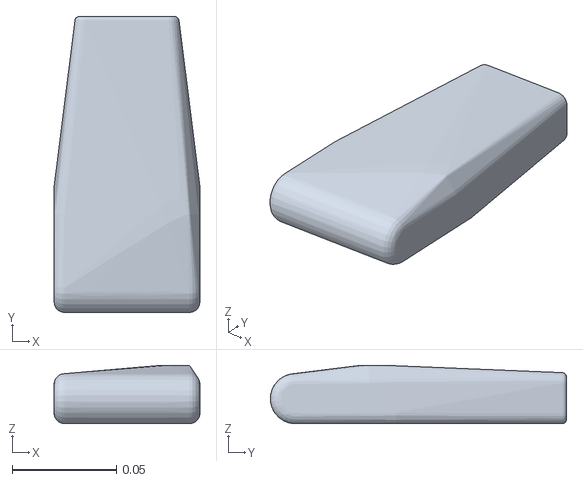
[picture p73: CAD file, 2026-07-31]
ros2_ws/src/cleany_description/meshes/Upper_Arm.stl.convex.stl
0.07 x 0.142 x 0.028
