asm17-moving-agent/cleany/ros2_ws/src/cleany_description/meshes/freecad_final/Yaw_servo.stl

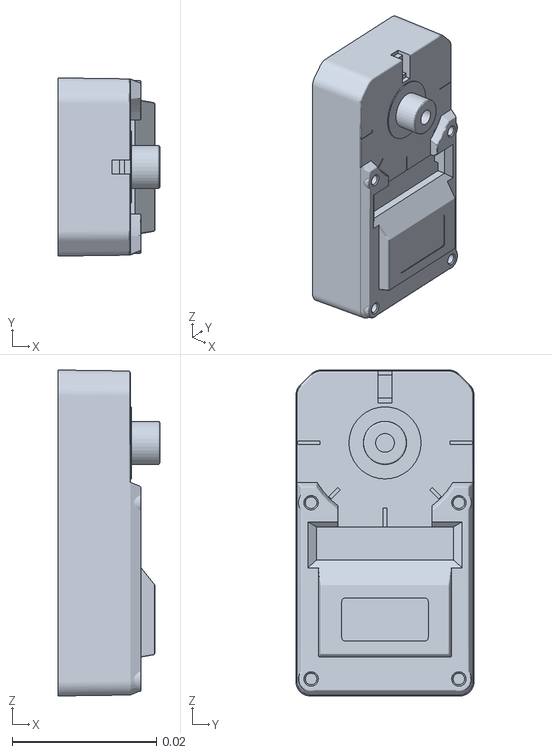
[picture p74: CAD file, 2026-11-13]
ros2_ws/src/cleany_description/meshes/freecad_final/Yaw_servo.stl
0.0141 x 0.0247 x 0.0452
