asm17-moving-agent/cleany/ros2_ws/src/cleany_description/meshes/freecad_final/RightKinematic_CameraTool180_Pinc_Distal_Shell_R.stl

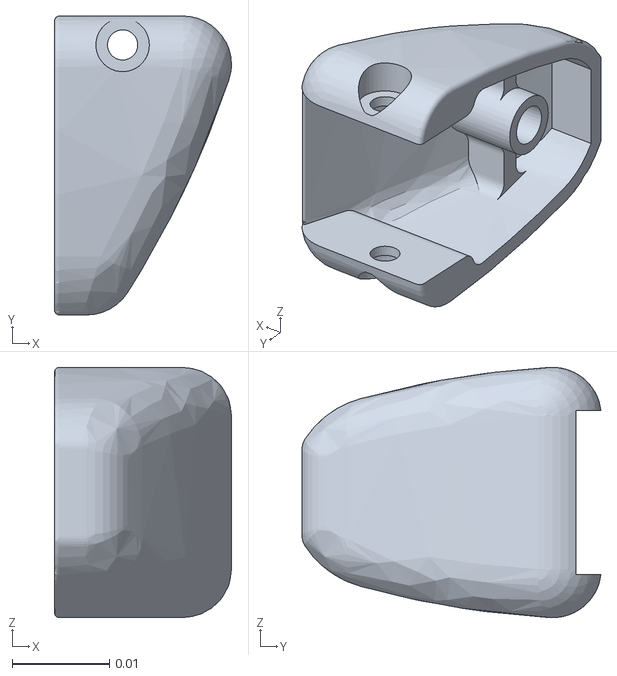
[picture p75: CAD file, 2026-11-13]
ros2_ws/src/cleany_description/meshes/freecad_final/RightKinematic_CameraTool180_Pinc_Distal_Shell_R.stl
0.0182 x 0.0307 x 0.0257
