asm17-moving-agent/cleany/ros2_ws/src/cleany_description/meshes/Rotation_Pitch.stl

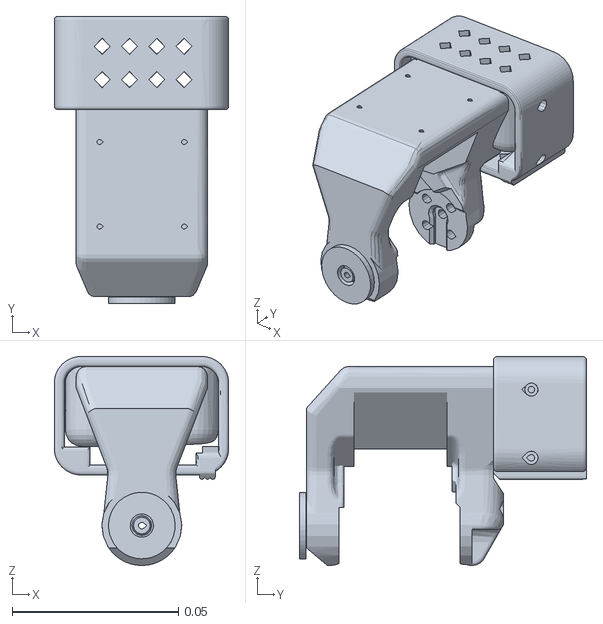
[picture p76: CAD file, 2026-07-31]
ros2_ws/src/cleany_description/meshes/Rotation_Pitch.stl
0.0524 x 0.0863 x 0.0628
