asm17-moving-agent/cleany/ros2_ws/src/cleany_description/meshes/freecad_final/RightCamera_PCBNut2.stl

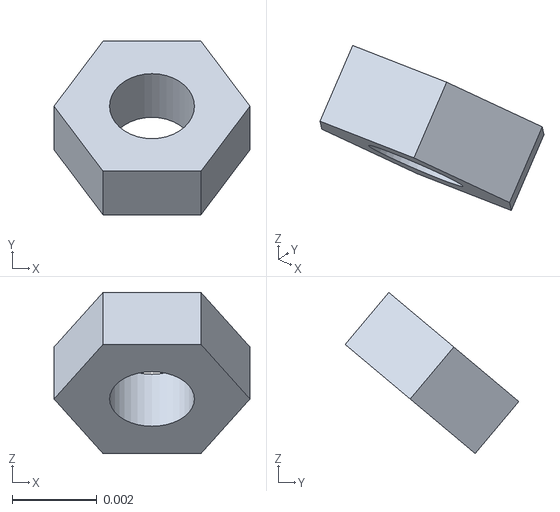
[picture p78: CAD file, 2026-11-13]
ros2_ws/src/cleany_description/meshes/freecad_final/RightCamera_PCBNut2.stl
0.00462 x 0.00409 x 0.0038
