asm17-moving-agent/cleany/ros2_ws/src/cleany_description/meshes/Wrist_Pitch_Roll.stl

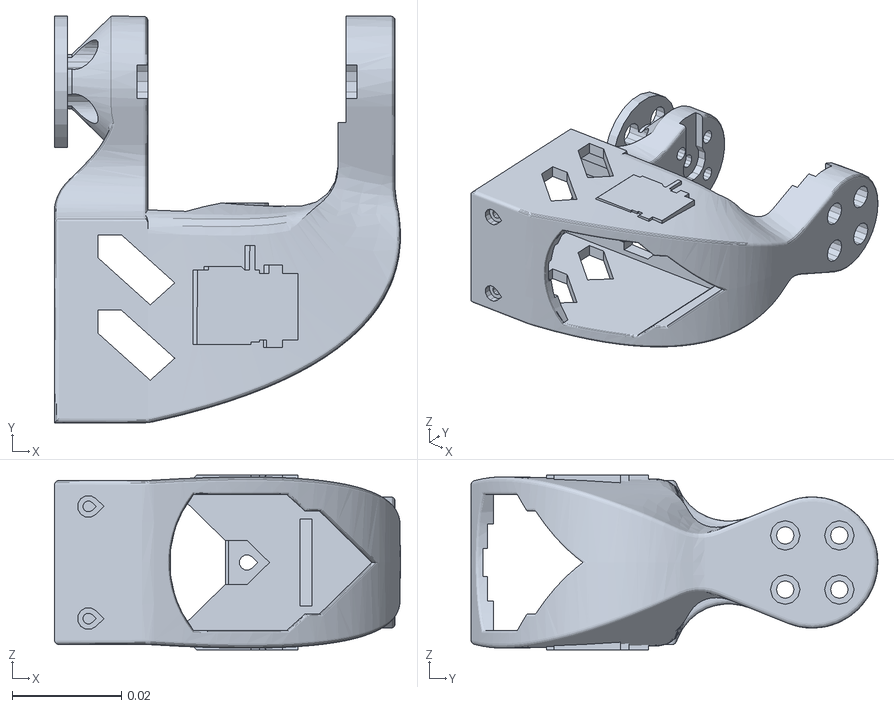
[picture p80: CAD file, 2026-07-31]
ros2_ws/src/cleany_description/meshes/Wrist_Pitch_Roll.stl
0.0633 x 0.0744 x 0.032
