asm17-moving-agent/cleany/ros2_ws/src/cleany_description/meshes/topbase2.stl

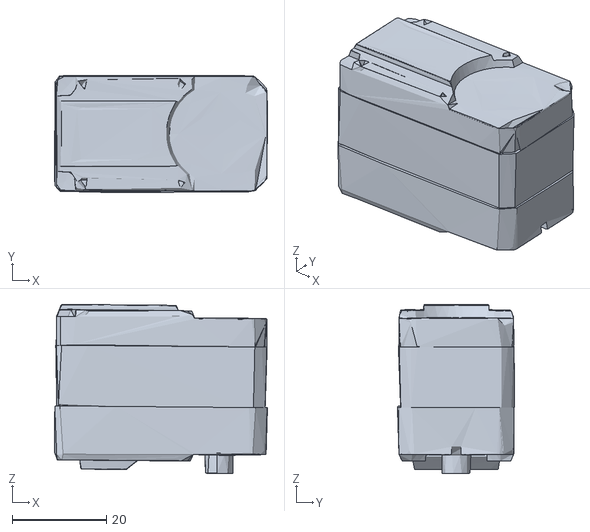
[picture p81: CAD file, 2026-07-31]
ros2_ws/src/cleany_description/meshes/topbase2.stl
45.3 x 24.9 x 36.0
