asm17-moving-agent/cleany/ros2_ws/src/cleany_description/meshes/freecad_final/Aligned_Lower_servo_other.stl

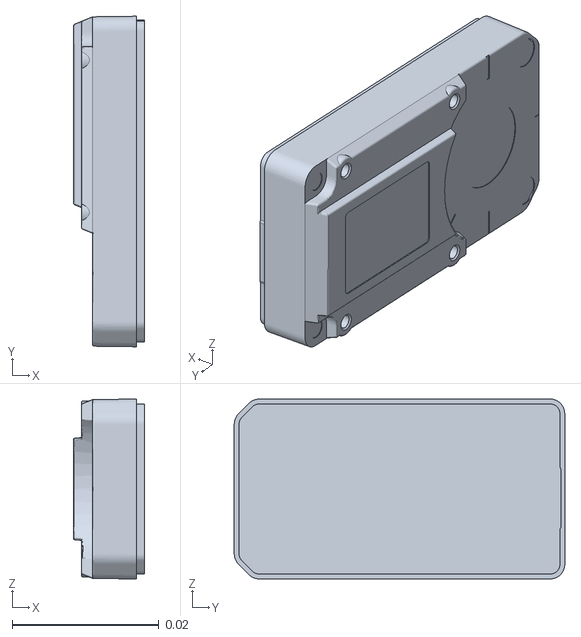
[picture p83: CAD file, 2026-11-13]
ros2_ws/src/cleany_description/meshes/freecad_final/Aligned_Lower_servo_other.stl
0.0097 x 0.045 x 0.0245
