asm17-moving-agent/cleany/ros2_ws/src/cleany_description/meshes/freecad_final/BaseCover001.stl

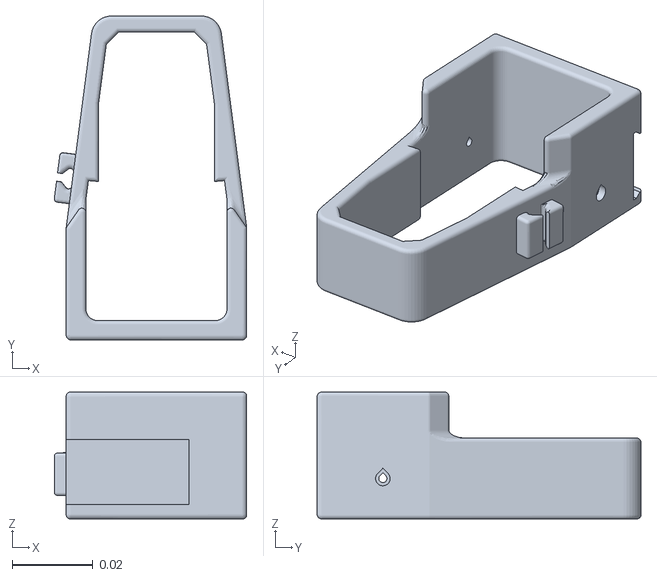
[picture p84: CAD file, 2026-11-13]
ros2_ws/src/cleany_description/meshes/freecad_final/BaseCover001.stl
0.0476 x 0.0802 x 0.0314
