asm17-moving-agent/cleany/ros2_ws/src/cleany_description/meshes/freecad_final/LidarPlate.stl

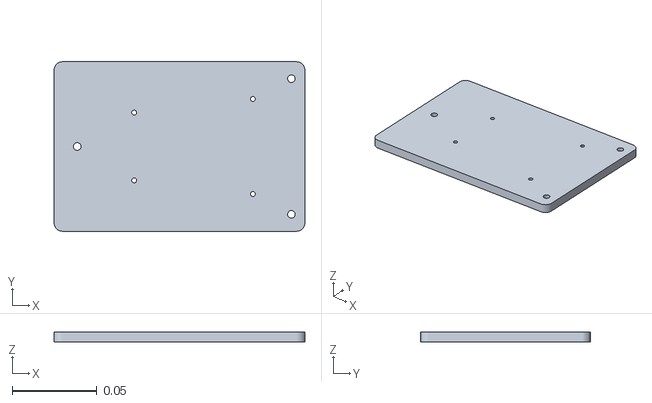
[picture p85: CAD file, 2026-11-13]
ros2_ws/src/cleany_description/meshes/freecad_final/LidarPlate.stl
0.148 x 0.1 x 0.006
