asm17-moving-agent/cleany/ros2_ws/src/cleany_description/meshes/freecad_final/FomexFrontLowerMountCut.stl

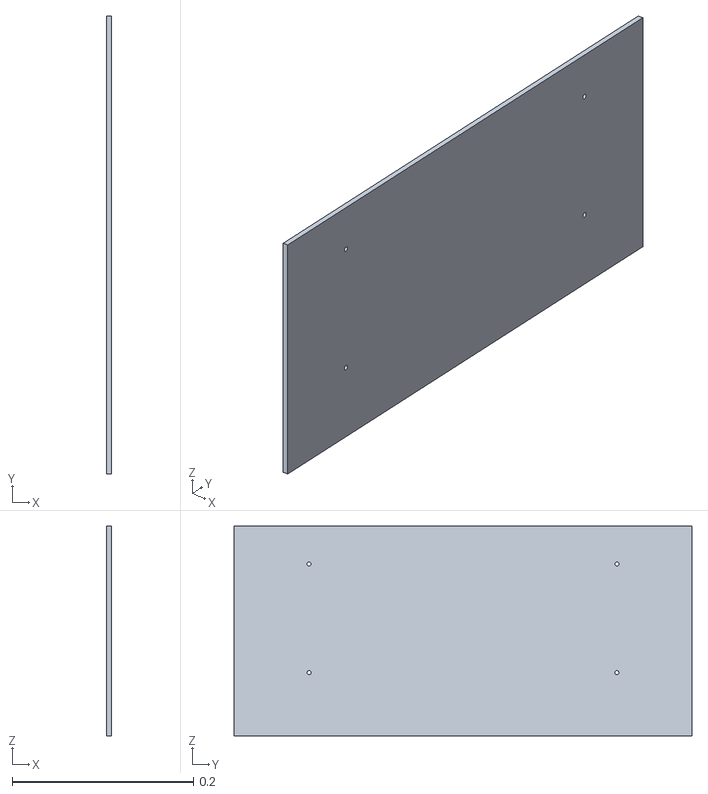
[picture p86: CAD file, 2026-11-13]
ros2_ws/src/cleany_description/meshes/freecad_final/FomexFrontLowerMountCut.stl
0.005 x 0.506 x 0.232
