asm17-moving-agent/cleany/ros2_ws/src/cleany_description/meshes/freecad_final/FomexBackLowerMountCut.stl

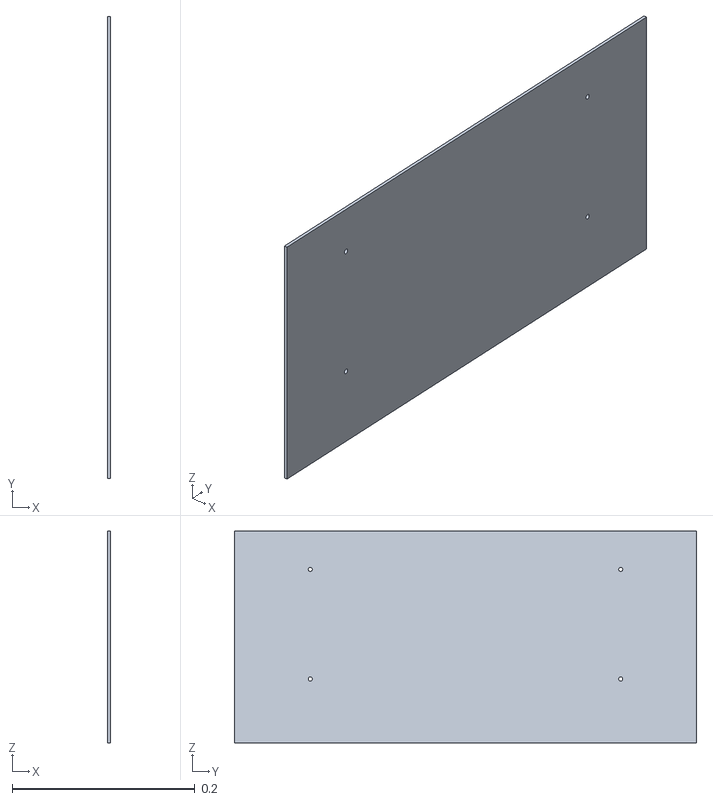
[picture p87: CAD file, 2026-11-13]
ros2_ws/src/cleany_description/meshes/freecad_final/FomexBackLowerMountCut.stl
0.003 x 0.506 x 0.232
