asm17-moving-agent/cleany/ros2_ws/src/cleany_description/meshes/freecad_final/RightCamera_Connector.stl

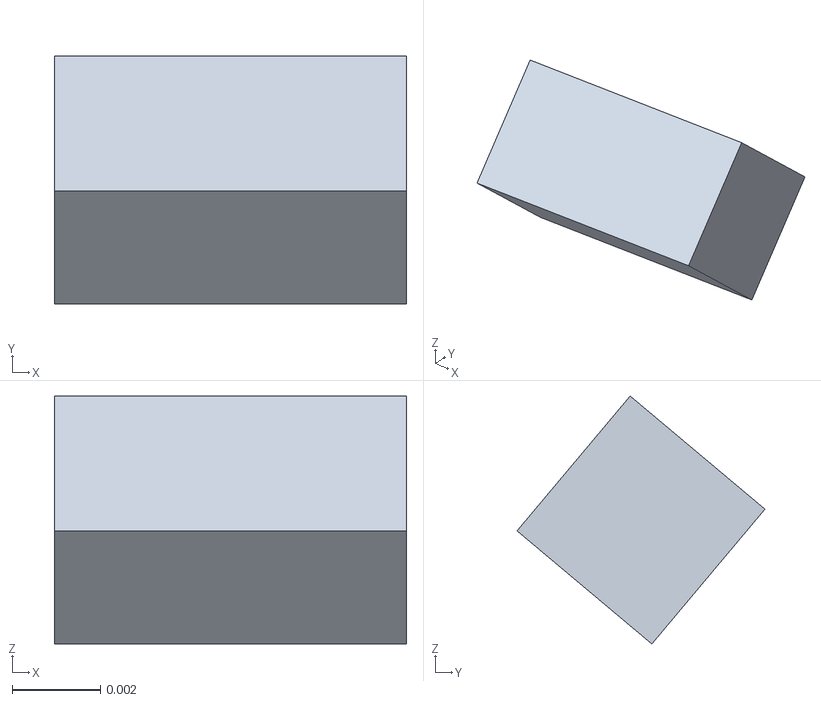
[picture p88: CAD file, 2026-11-13]
ros2_ws/src/cleany_description/meshes/freecad_final/RightCamera_Connector.stl
0.008 x 0.00564 x 0.00564
