asm17-moving-agent/cleany/ros2_ws/src/cleany_description/meshes/freecad_final/FrontCleanyLogo.stl

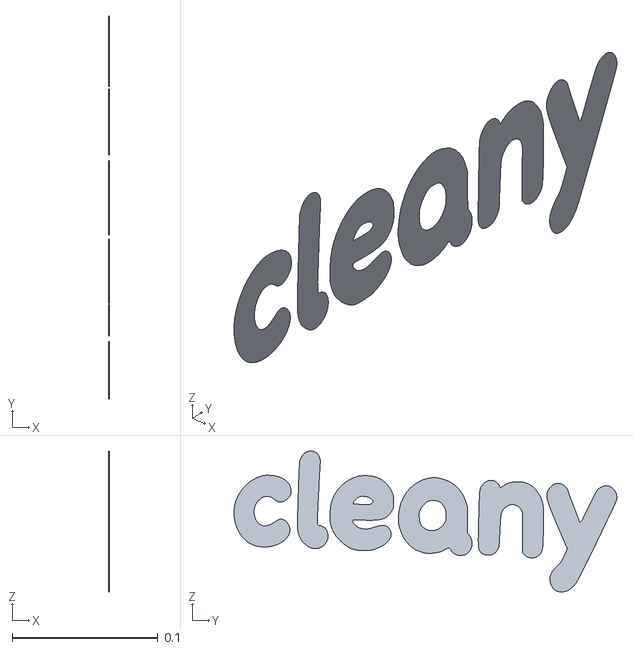
[picture p89: CAD file, 2026-11-13]
ros2_ws/src/cleany_description/meshes/freecad_final/FrontCleanyLogo.stl
0.0002 x 0.263 x 0.0969
