asm17-moving-agent/cleany/ros2_ws/src/cleany_description/meshes/freecad_final/ShoulderMotorHolder.stl

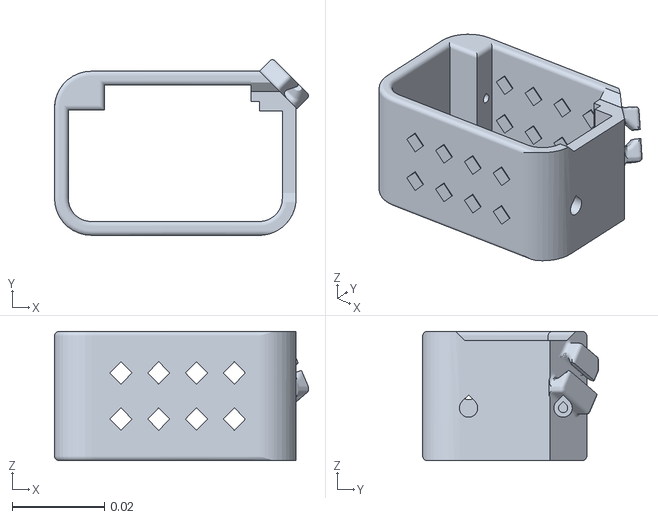
[picture p90: CAD file, 2026-11-13]
ros2_ws/src/cleany_description/meshes/freecad_final/ShoulderMotorHolder.stl
0.0551 x 0.0381 x 0.028
