asm17-moving-agent/cleany/ros2_ws/src/cleany_description/meshes/freecad_final/UpperIdlerHorn001.stl

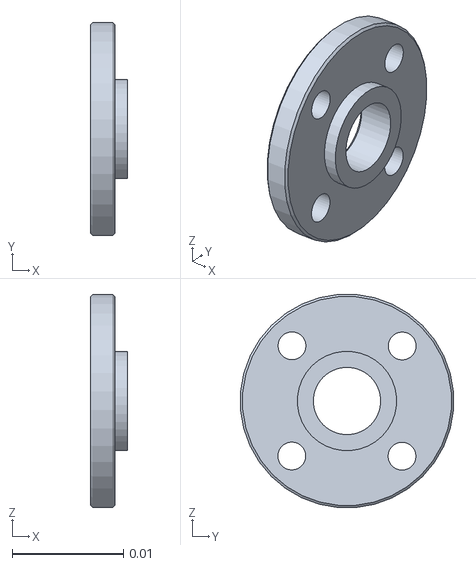
[picture p91: CAD file, 2026-11-13]
ros2_ws/src/cleany_description/meshes/freecad_final/UpperIdlerHorn001.stl
0.00335 x 0.0191 x 0.0191
