asm17-moving-agent/cleany/ros2_ws/src/cleany_description/meshes/freecad_final/HeadTiltBracket.stl

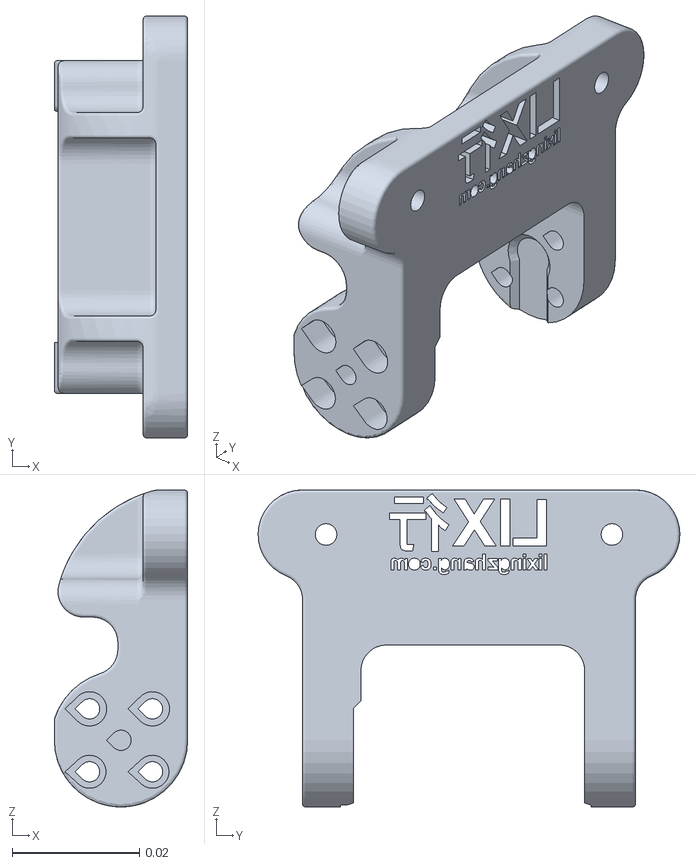
[picture p92: CAD file, 2026-11-13]
ros2_ws/src/cleany_description/meshes/freecad_final/HeadTiltBracket.stl
0.021 x 0.0664 x 0.0499
