asm17-moving-agent/cleany/ros2_ws/src/cleany_description/meshes/freecad_final/LeftCamera_Glass.stl

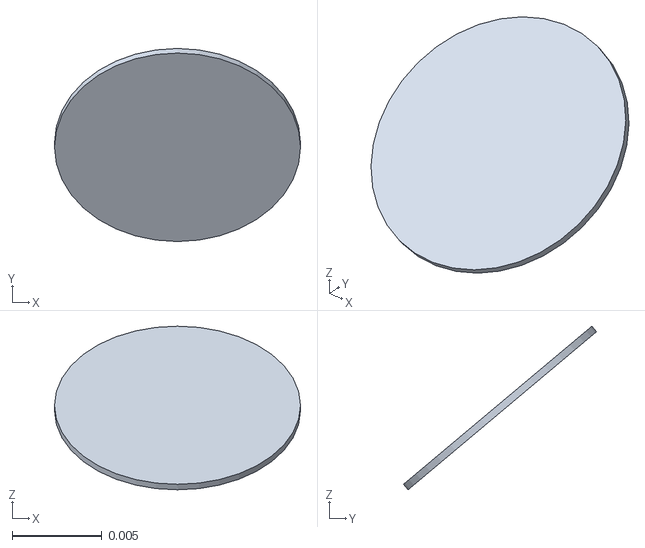
[picture p93: CAD file, 2026-11-13]
ros2_ws/src/cleany_description/meshes/freecad_final/LeftCamera_Glass.stl
0.0137 x 0.0107 x 0.0091
