asm17-moving-agent/cleany/ros2_ws/src/cleany_description/meshes/freecad_final/LeftKinematic_CameraTool180_Pinc_Distal_Rod_R.stl

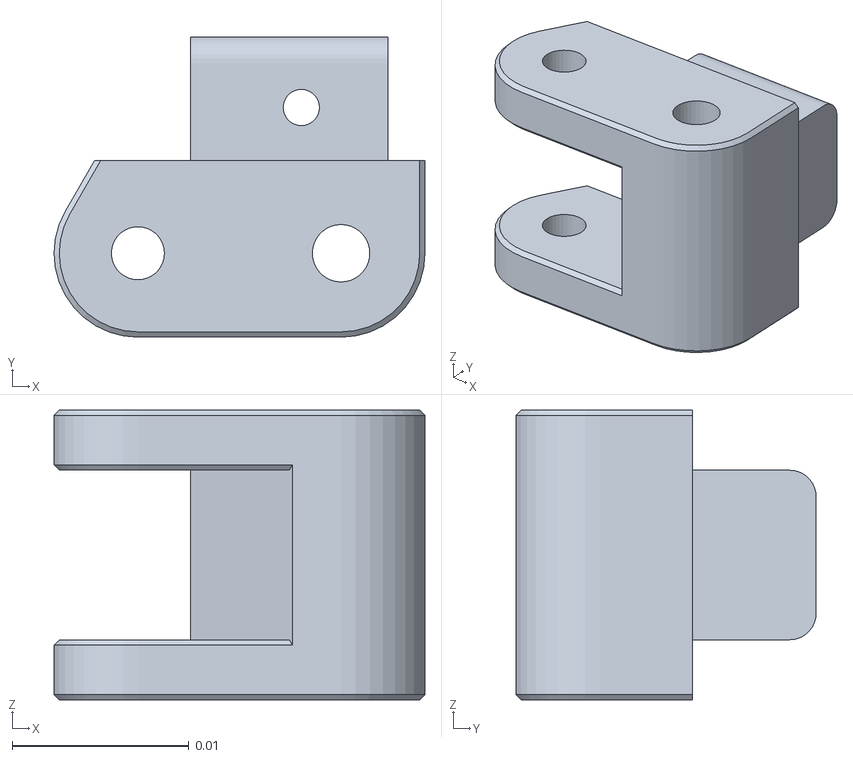
[picture p94: CAD file, 2026-11-13]
ros2_ws/src/cleany_description/meshes/freecad_final/LeftKinematic_CameraTool180_Pinc_Distal_Rod_R.stl
0.021 x 0.017 x 0.0164
