asm17-moving-agent/cleany/ros2_ws/src/cleany_description/meshes/freecad_final/LeftCamera_PCB.stl

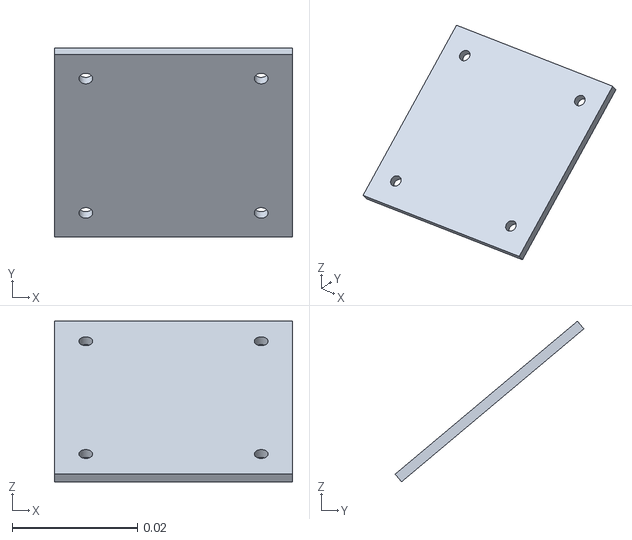
[picture p95: CAD file, 2026-11-13]
ros2_ws/src/cleany_description/meshes/freecad_final/LeftCamera_PCB.stl
0.038 x 0.0301 x 0.0257
