asm17-moving-agent/cleany/ros2_ws/src/cleany_description/meshes/freecad_final/LeftKinematic_CameraTool180_Pinc_Internal_Rod_L.stl

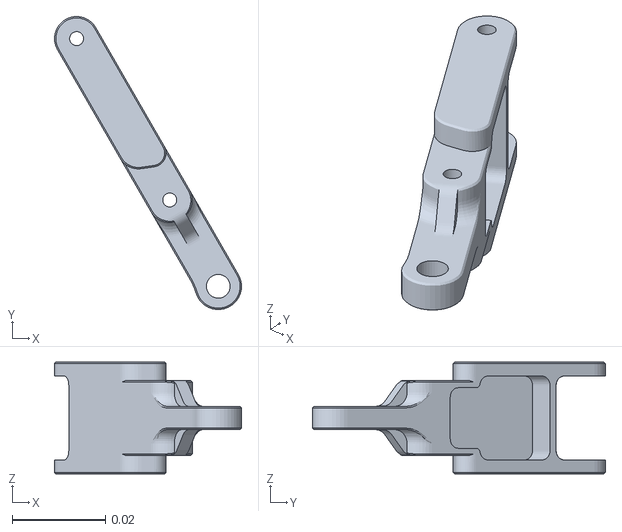
[picture p96: CAD file, 2026-11-13]
ros2_ws/src/cleany_description/meshes/freecad_final/LeftKinematic_CameraTool180_Pinc_Internal_Rod_L.stl
0.0402 x 0.0629 x 0.024
