asm17-moving-agent/cleany/ros2_ws/src/cleany_description/meshes/freecad_final/YawIdlerHorn.stl

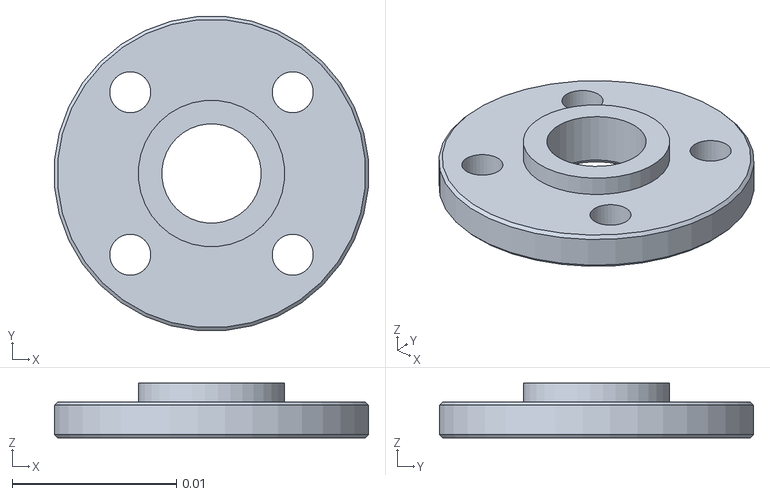
[picture p97: CAD file, 2026-11-13]
ros2_ws/src/cleany_description/meshes/freecad_final/YawIdlerHorn.stl
0.0191 x 0.0191 x 0.00335
