asm17-moving-agent/cleany/ros2_ws/src/cleany_description/meshes/freecad_final/RightCamera_FixedMount.stl

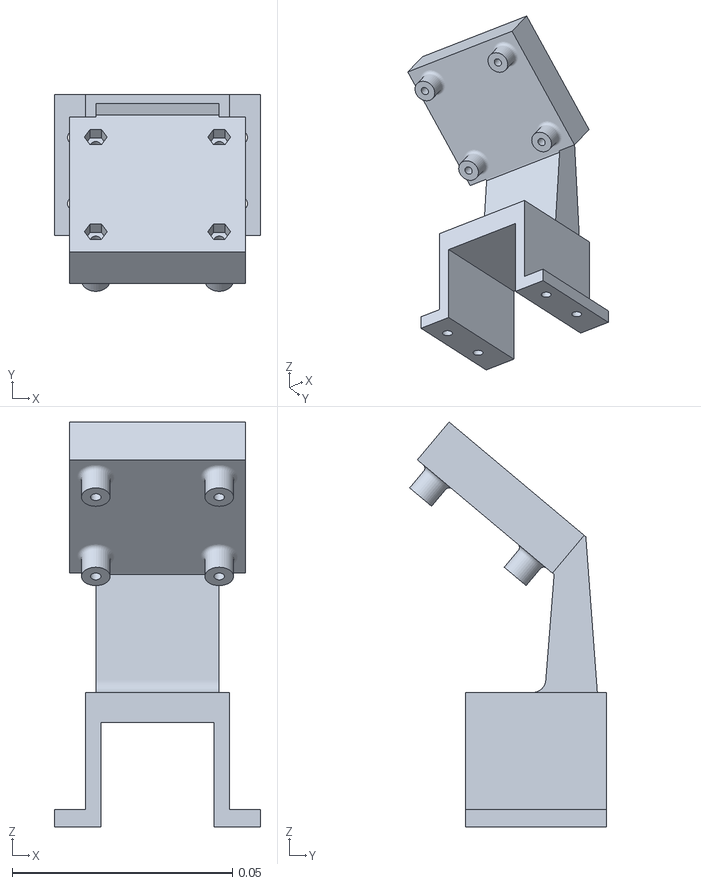
[picture p98: CAD file, 2026-11-13]
ros2_ws/src/cleany_description/meshes/freecad_final/RightCamera_FixedMount.stl
0.0468 x 0.0446 x 0.0919
