asm17-moving-agent/cleany/(list of files, cad)

Other CAD files:
ros2_ws/src/cleany_description/meshes/freecad_final/AssembledShoulderSocket.stl
ros2_ws/src/cleany_description/meshes/freecad_final/Aligned_AssembledWristSocket001.stl
ros2_ws/src/cleany_description/meshes/Rotation_Pitch_Motor.stl
ros2_ws/src/cleany_description/meshes/cad_frame/rr_upright.stl
ros2_ws/src/cleany_description/meshes/cad_frame/upper_right_side_rail.stl
ros2_ws/src/cleany_description/meshes/Lower_Arm_Motor.stl
ros2_ws/src/cleany_description/meshes/cad_frame/right_inner_lower_rail.stl
ros2_ws/src/cleany_description/meshes/cad_frame/rl_upright.stl
ros2_ws/src/cleany_description/meshes/Upper_Arm_Motor.stl
ros2_ws/src/cleany_description/meshes/Lower_Arm_Motor.stl.convex.stl
ros2_ws/src/cleany_description/meshes/cad_frame/rear_inner_lower_cross_rail.stl
ros2_ws/src/cleany_description/meshes/Upper_Arm_Motor.stl.convex.stl
ros2_ws/src/cleany_description/meshes/cad_frame/lower_front_cross_rail.stl
ros2_ws/src/cleany_description/meshes/cad_frame/lower_rear_cross_rail.stl
ros2_ws/src/cleany_description/meshes/freecad_final/LeftKinematic_CameraTool180_ToolDriveHorn.stl
ros2_ws/src/cleany_description/meshes/cad_frame/fr_upright.stl
ros2_ws/src/cleany_description/meshes/cad_frame/lower_right_side_rail.stl
ros2_ws/src/cleany_description/meshes/cad_frame/upper_left_side_rail.stl
ros2_ws/src/cleany_description/meshes/cad_frame/upper_rear_cross_rail.stl
ros2_ws/src/cleany_description/meshes/cad_frame/left_inner_lower_rail.stl
ros2_ws/src/cleany_description/meshes/freecad_final/Wrist_servo_middle.stl
ros2_ws/src/cleany_description/meshes/freecad_final/InstalledProfile19.stl
ros2_ws/src/cleany_description/meshes/freecad_final/Aligned_LowerDriveHorn001.stl
ros2_ws/src/cleany_description/meshes/freecad_final/YawDriveHorn001.stl
ros2_ws/src/cleany_description/meshes/freecad_final/Aligned_Lower_servo_middle001.stl
ros2_ws/src/cleany_description/meshes/freecad_final/RightKinematic_CameraTool180_Pinc_Cam.stl
ros2_ws/src/cleany_description/meshes/Rotation_Pitch_Motor.stl.convex.stl
ros2_ws/src/cleany_description/meshes/Fixed_Jaw_Motor.stl
ros2_ws/src/cleany_description/meshes/Base_Motor.stl.convex.stl
ros2_ws/src/cleany_description/meshes/freecad_final/InstalledProfile04.stl
ros2_ws/src/cleany_description/meshes/tophead4.stl
ros2_ws/src/cleany_description/meshes/freecad_final/Upper_servo.stl
ros2_ws/src/cleany_description/meshes/freecad_final/YawDriveHorn.stl
ros2_ws/src/cleany_description/meshes/freecad_final/Drive_front_right_motor.stl
ros2_ws/src/cleany_description/meshes/freecad_final/RightKinematic_CameraTool180_Pinc_servo.stl
ros2_ws/src/cleany_description/meshes/freecad_final/InstalledProfile07.stl
ros2_ws/src/cleany_description/meshes/freecad_final/InstalledProfile09.stl
ros2_ws/src/cleany_description/meshes/freecad_final/Base_servo_middle001.stl
ros2_ws/src/cleany_description/meshes/freecad_final/Wrist_servo_other001.stl
ros2_ws/src/cleany_description/meshes/freecad_final/RightCamera_PCBNut0.stl
ros2_ws/src/cleany_description/meshes/freecad_final/Drive_front_right_bracket.stl
ros2_ws/src/cleany_description/meshes/freecad_final/InstalledArmMountPanel.stl
ros2_ws/src/cleany_description/meshes/freecad_final/HeadPanServoFront.stl
ros2_ws/src/cleany_description/meshes/freecad_final/FomexRightUpperMountCut.stl
ros2_ws/src/cleany_description/meshes/freecad_final/Aligned_Lower_servo001.stl
ros2_ws/src/cleany_description/meshes/freecad_final/Drive_rear_left_bracket.stl
ros2_ws/src/cleany_description/meshes/freecad_final/Drive_rear_right_wheel.stl
ros2_ws/src/cleany_description/meshes/freecad_final/HeadPanServoMiddle.stl
ros2_ws/src/cleany_description/meshes/freecad_final/LeftKinematic_CameraTool180_Pinc_Distal_Rod_L.stl
ros2_ws/src/cleany_description/meshes/freecad_final/Upper_servo001.stl
ros2_ws/src/cleany_description/meshes/freecad_final/RightKinematic_CameraTool180_Pinc_Internal_Rod_L.stl
ros2_ws/src/cleany_description/meshes/freecad_final/Upper_servo_other.stl
ros2_ws/src/cleany_description/meshes/freecad_final/Drive_rear_left_wheel.stl
ros2_ws/src/cleany_description/meshes/freecad_final/UpperDriveHorn.stl
ros2_ws/src/cleany_description/meshes/freecad_final/HeadTiltIdlerHorn.stl
ros2_ws/src/cleany_description/meshes/freecad_final/InstalledProfile14.stl
ros2_ws/src/cleany_description/meshes/freecad_final/Aligned_LowerIdlerHorn.stl
ros2_ws/src/cleany_description/meshes/freecad_final/Aligned_LowerIdlerHorn001.stl
ros2_ws/src/cleany_description/meshes/freecad_final/BaseCover.stl
ros2_ws/src/cleany_description/meshes/freecad_final/Base_servo001.stl
ros2_ws/src/cleany_description/meshes/freecad_final/Drive_rear_left_motor.stl
ros2_ws/src/cleany_description/meshes/freecad_final/FomexBackLowerM4Tool02Screw.stl
ros2_ws/src/cleany_description/meshes/freecad_final/FomexBackLowerM4Tool04Washer.stl
ros2_ws/src/cleany_description/meshes/freecad_final/FomexBackUpperM4Tool01Washer.stl
ros2_ws/src/cleany_description/meshes/freecad_final/FomexBackUpperM4Tool02Screw.stl
ros2_ws/src/cleany_description/meshes/freecad_final/FomexBackUpperM4Tool03Screw.stl
ros2_ws/src/cleany_description/meshes/freecad_final/FomexBackUpperM4Tool04Washer.stl
ros2_ws/src/cleany_description/meshes/freecad_final/FomexFrontLowerM4Tool02Washer.stl
ros2_ws/src/cleany_description/meshes/freecad_final/FomexFrontLowerM4Tool04Screw.stl
ros2_ws/src/cleany_description/meshes/freecad_final/FomexFrontUpperM4Tool01Screw.stl
ros2_ws/src/cleany_description/meshes/freecad_final/FomexFrontUpperM4Tool01Washer.stl
ros2_ws/src/cleany_description/meshes/freecad_final/FomexFrontUpperM4Tool02Screw.stl
ros2_ws/src/cleany_description/meshes/freecad_final/FomexLeftLowerM4Tool01Screw.stl
ros2_ws/src/cleany_description/meshes/freecad_final/FomexLeftLowerM4Tool01Washer.stl
ros2_ws/src/cleany_description/meshes/freecad_final/FomexLeftLowerM4Tool02Screw.stl
ros2_ws/src/cleany_description/meshes/freecad_final/FomexLeftLowerM4Tool02Washer.stl
ros2_ws/src/cleany_description/meshes/freecad_final/FomexLeftLowerM4Tool03Screw.stl
ros2_ws/src/cleany_description/meshes/freecad_final/FomexLeftLowerM4Tool03Washer.stl
ros2_ws/src/cleany_description/meshes/freecad_final/FomexLeftLowerM4Tool04Washer.stl
ros2_ws/src/cleany_description/meshes/freecad_final/FomexLeftUpperM4Tool01Screw.stl
ros2_ws/src/cleany_description/meshes/freecad_final/FomexLeftUpperM4Tool01Washer.stl
ros2_ws/src/cleany_description/meshes/freecad_final/FomexLeftUpperM4Tool04Screw.stl
ros2_ws/src/cleany_description/meshes/freecad_final/FomexRightLowerM4Tool01Washer.stl
ros2_ws/src/cleany_description/meshes/freecad_final/FomexRightLowerM4Tool02Screw.stl
ros2_ws/src/cleany_description/meshes/freecad_final/FomexRightLowerM4Tool02Washer.stl
ros2_ws/src/cleany_description/meshes/freecad_final/FomexRightUpperM4Tool01Screw.stl
ros2_ws/src/cleany_description/meshes/freecad_final/FomexRightUpperM4Tool01Washer.stl
ros2_ws/src/cleany_description/meshes/freecad_final/FomexRightUpperM4Tool02Screw.stl
ros2_ws/src/cleany_description/meshes/freecad_final/FomexRightUpperM4Tool02Washer.stl
ros2_ws/src/cleany_description/meshes/freecad_final/FomexRightUpperM4Tool04Screw.stl
ros2_ws/src/cleany_description/meshes/freecad_final/FomexTopFrontM4Tool01Washer.stl
ros2_ws/src/cleany_description/meshes/freecad_final/FomexTopFrontM4Tool02Screw.stl
ros2_ws/src/cleany_description/meshes/freecad_final/FomexTopFrontM4Tool03Screw.stl
ros2_ws/src/cleany_description/meshes/freecad_final/FomexTopFrontM4Tool04Screw.stl
ros2_ws/src/cleany_description/meshes/freecad_final/FomexTopFrontM4Tool05Screw.stl
ros2_ws/src/cleany_description/meshes/freecad_final/FomexTopFrontM4Tool05Washer.stl
ros2_ws/src/cleany_description/meshes/freecad_final/FomexTopFrontM4Tool06Screw.stl
ros2_ws/src/cleany_description/meshes/freecad_final/FomexTopFrontM4Tool06Washer.stl
ros2_ws/src/cleany_description/meshes/freecad_final/FomexTopFrontMountCut.stl
ros2_ws/src/cleany_description/meshes/freecad_final/HeadCamera.stl
ros2_ws/src/cleany_description/meshes/freecad_final/HeadCameraScrewRight.stl
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
