asm17-moving-agent/cleany/docs/CALIBRATION.md

# 캘리브레이션 작업 가이드

## Jetson 실물 모델과 2026-10-09 보정 프로파일

`cleany_description/config/calibration/jetson_20261009/`는 Jetson에서 사용한
헤드와 양손목 카메라 외부 보정, 해당 RGB 내부 보정, 팔과 헤드의 관절 기준을
보존한다. 카메라 외부 보정은 각각 20개 학습 뷰와 별도 5개 검증 뷰로 평가한
`provisional_20plus5_manual_stationary` 결과다.

| 변환 | 적용 내용 |
|---|---|
| `head_camera_rgb_frame` → `head_camera_rgb_optical_frame` | 헤드 RGB 외부 보정 |
| `left_gripper_frame` → `left_wrist_camera_optical_frame` | 왼손목 외부 보정 |
| `right_gripper_frame` → `right_wrist_camera_optical_frame` | 오른손목 외부 보정 |
| 각 `*_wrist_camera_optical_frame` → `*_wrist_rgb_optical_frame` | 항등 변환 alias |

`xyz`는 parent frame 기준 m, `rpy`는 고정축 XYZ의 rad이며,
`parent_T_child`는 child 좌표를 parent 좌표로 변환한다. 보정은 광학 좌표계에
적용하며 카메라 케이스 mesh의 CAD 배치를 옮기지 않는다. 헤드 depth frame은
명목값을 유지한다.

v8 손목 마운트 형상 반영 시 Jetson의 양손목 외부 보정 파일은 이전 수집본과
바이트 단위로 같았다. 형상에서 추정한 광학 좌표로 이 보정값을 대체하지 않는다.
이번 변경은 새로운 hand-eye 보정이나 v8 장착 상태에서의 정확도 검증을 포함하지
않는다. 실제 카메라 장착 위치가 보정 당시와 달라졌다면 재검증이 필요하다.

빌드한 workspace의 `setup.bash`를 읽은 뒤 모델을 실행한다.

```bash
ros2 launch cleany_description description.launch.py \
  use_sim_time:=false calibration_profile:=jetson_20261009
```

이 launch는 `robot_state_publisher`만 실행한다. 관절 상태는 별도 `/joint_states`
입력이 필요하며, 저장된 encoder 영점으로 tick을 변환하거나 모터를 제어하지 않는다.
`calibration_profile`의 기본값은 빈 문자열이다. 기본 실행은 명목 헤드 TF를
유지하고 손목 보정 optical frame을 추가하지 않는다.

노드를 실행하지 않고 보정된 URDF만 확인하려면 다음 명령을 사용한다.

```bash
xacro "$(ros2 pkg prefix --share cleany_description)/urdf/cleany.urdf.xacro" \
  calibration_profile:=jetson_20261009 > /tmp/cleany-calibrated.urdf
```

`arm_joint_calibration.yaml`에는 좌우 12개 모터의 현재 영점, 방향과 rad 오프셋을
담았다. `q = direction × (Present_Position - zero_tick) × 2π/4096 + offset_rad`로
해석한다. Present_Position에 이미 반영된 EEPROM homing offset을 다시 더하지 않는다.
`motors/`의 원본 JSON과 `reference/`의 과거 자세 기록은 측정 근거이며 자동 적용하지
않는다. 현재 매핑은 `arm_joint_calibration.yaml`이 기준이다. 오른쪽 elbow 영점처럼
과거 자세 기록 이후 보완된 값이 있다. 절대 관절 각도 정확도는 검증되지 않았다.

`head_joint_calibration.json`의 pan/tilt 기준 tick은 각각 2009와 2067,
방향은 -1과 +1이다. 이는 수동 영점과 회전 방향 확인이며 회전축 추정 결과가 아니다.
내부 보정 JSON은 외부 보정 입력을 보존하기 위한 자료로, 이 launch에서
`CameraInfo`를 발행하거나 카메라 드라이버 설정을 바꾸지 않는다.

| 카메라 | 검증 보드 위치 RMS | 검증 보드 회전 RMS |
|---|---:|---:|
| 헤드 RGB | 1.246 mm | 0.247° |
| 왼손목 | 8.525 mm | 1.540° |
| 오른손목 | 8.895 mm | 1.739° |

이 수치는 고정 보드 가정에 대한 일관성이다. 절대 위치 ground truth와 하드웨어
노출 동기화는 검증되지 않았다. 오른손목 학습 뷰 3개에는 manual torque hold
기록이 없으며, k3=0 모델은 held-out 평가 전에 선택했다. 각 YAML의 원본 검증
조건과 `absolute_calibration_verified: false`를 유지한다.
원본 보고서 경로와 SHA-256은 프로파일의 `provenance.json`에 기록하며,
절대 경로는 과거 근거 위치로만 사용한다.

## 기존 hand-eye 수집과 평가 도구

현재 패키지는 calibration core, ROS 수집 adapter와 오프라인 평가를 유지합니다. MuJoCo calibration 장면과 전용 launch는 제거됐습니다. 현행 기능은 [패키지 안내](../ros2_ws/src/cleany_handeye_calibration/docs/offline-tools.md)를 따릅니다. 아래 MuJoCo 전용 절차는 이전 구현의 참고 기록이며 현재 실행 절차가 아닙니다. 결과 transform은 검토용 artifact로 저장하며 TF에 자동 적용하지 않습니다. 실물 calibration과 grasp 성공은 별도로 검증합니다.

## 작업 흐름

```mermaid
flowchart TB
    Setup["의존성 준비 + build / test"] --> Generate["새 profile / 후보 생성"]
    Generate --> Gate{"IK / collision / 렌더링 / PnP 통과?"}
    Gate -->|"예"| Freeze["20 calibration + 5 held-out 고정"]
    Gate -->|"아니오 / 후보 한도 초과"| Fail["실패와 근거 보존"]
    Freeze --> Collect["viewer 관찰 + settle 이후 수집"]
    Collect --> Data["image + journal + JSONL + hash"]
    Data --> Validate["PnP 재현 + solver별 평가"]
    Validate --> Review["dataset_validation.json 검토"]
    Review -. "별도 검토와 명시적 적용" .-> TF["실물 TF 적용"]
```

실선은 현재 MuJoCo 수집, 평가 흐름입니다. 실패 표본을 새 pose로 대체하지 않으며, TF 적용에는 별도 검토가 필요합니다.

## 1. 준비

[개발환경](DEVELOPMENT_SETUP.md)에 따라 MoveIt, ros2_control, OpenCV 의존성을 준비하고 아래 검사까지 실행합니다. 좌표, camera, 동기화, dataset 계약은 [frames-and-data](../ros2_ws/src/cleany_handeye_calibration/docs/frames-and-data.md)를 따릅니다.

이전 `pose_generation.mujoco.yaml`은 시뮬레이션 전용입니다. `*.template.*`의 null/미승인 값은 실제 장치 값으로 사용하지 않습니다.

```bash
source /opt/ros/humble/setup.bash
make build-handeye
make test-handeye
```

## 2. 새 pose set 생성

저장소 루트에서 새 이름과 출력 경로를 정합니다. 기존 profile은 덮어쓰지 않습니다.

```bash
export CLEANY_DATA_ROOT="$(dirname "$PWD")/cleany-data"
profile="$CLEANY_DATA_ROOT/fixtures/handeye/my-run"
artifacts="$CLEANY_DATA_ROOT/runs/handeye"
make handeye-generate-mujoco \
  HANDEYE_PROFILE_DIR="$profile" HANDEYE_ARTIFACT_ROOT="$artifacts" \
  HANDEYE_RUN_ID=my-run
```

후보 생성은 headless로 실행합니다. 후보 cap을 넘기면 실패하며, runtime에서 새 pose로 빈 항목을 채우지 않습니다. 생성 후 `materialized_poses.yaml`, `materialized_runtime.json`, materialized URDF와 분석을 확인합니다.

## 3. 수집

```bash
make handeye-mujoco \
  HANDEYE_PROFILE_DIR="$profile" HANDEYE_ARTIFACT_ROOT="$artifacts" \
  HANDEYE_RUN_ID=my-run \
  HANDEYE_POSE_MANIFEST="$profile/materialized_poses.yaml" \
  HANDEYE_RUNTIME_CONFIG="$profile/materialized_runtime.json"
```

Make target은 `headless:=false`로 실행합니다. Viewer/RViz에서 동작과 target visibility를 확인하고, 생성한 profile의 허용 motion, timeout, settle, collision 설정을 검토합니다. 다른 arm/controller/backend는 동시에 실행하지 않습니다.

| 수집 실패 조건 | 처리 |
|---|---|
| Joint feedback, camera 단절 | 실패를 보존하고 다음 표본으로 대체하지 않음 |
| PnP, settle 실패 | 실패를 보존하고 다음 표본으로 대체하지 않음 |

## 4. Dataset 확인

```bash
make handeye-validate-mujoco \
  HANDEYE_PROFILE_DIR="$profile" HANDEYE_ARTIFACT_ROOT="$artifacts" \
  HANDEYE_RUN_ID=my-run \
  HANDEYE_POSE_MANIFEST="$profile/materialized_poses.yaml" \
  HANDEYE_RUNTIME_CONFIG="$profile/materialized_runtime.json"
```

실제 robot-specific offset envelope를 검토한 경우 `HANDEYE_MAX_TRANSLATION_NORM_M`를 함께 지정합니다. 유효성 상한은 검토한 기준을 유지하며, 결과에 맞춰 늘려 실패를 숨기지 않습니다.

### 출력 확인

- run manifest의 code, 환경, URDF/MJCF, profile, camera, board provenance
- 25개 row와 image, row/image/camera hash 및 calibration/held-out split
- 원본 ChArUco 대응점에서 재계산한 PnP와 solver별 유효성, 실패 이유
- `dataset_validation.json`의 누락, 불일치, 평가 결과

표본 저장 완료, solver 성능, 물리 타당성은 각각 확인합니다. 한 solver의 실패는 다른 solver의 성공과 별도로 보존합니다. 실물 적용은 frame 방향, 장착 치수, offset, held-out 결과를 검토한 뒤 명시적으로 수행합니다.

## 실패와 재현

부분 쓰기는 journal로 복구하며 이미 저장한 표본은 재수집으로 덮어쓰지 않습니다. 재현에는 manifest가 기록한 동일 버전, profile, camera 계약이 필요합니다. Container Git이 host worktree 형식을 지원하지 않으면 provenance 수집 문제를 먼저 해결합니다.

과거 실행 결과는 [근거 색인](EVIDENCE.md), 수학, 저장 계약은 [reference](../ros2_ws/src/cleany_handeye_calibration/docs/frames-and-data.md)에서 확인합니다.

## 실물 상태 프로파일

`cleany_robot_interface`의 상태 프로파일은 기존 엔코더 보정과 카메라 외부 보정을
읽어 실물 모델을 생성합니다.
기록된 보정의 적용 범위와 정확도는 원본 metadata를 따릅니다.

손목 외부 보정은 `cleany_description/config/calibration/jetson_20261009/`에서
관리합니다. 실물 모델에는 `calibration_profile:=jetson_20261009`로 적용합니다.

## ToF 근접 보호 commissioning

[ToF 설정](../ros2_ws/src/cleany_tof/config/tof.yaml)은 실측하지 않은 후보값이다.
모터를 분리하거나 바퀴를 띄운 상태에서 다음 항목을 확인한 뒤 별도 로봇 프로파일을 만든다.

- 각 native zone에 작은 표적을 움직여 flip, 장착 roll/pitch/yaw, 위치와 유효 FOV를 측정한다.
- 알려진 거리와 기울기의 넓은 평판으로 radial range, 거리 오차, sigma, fit residual,
  접근 거리와 yaw 오차를 확인한다. 선택 행이 책상 앞면을 실제로 관측해야 한다.
  약 3.5m 미검출 관찰은 검출 보장 거리나 자유 공간 하한으로 사용하지 않는다.
- 빈 공간, 검정 표면, 유리, 금속, 햇빛, 책상 다리와 얇은 물체에서 zone 유효율과 사각을
  기록한다. NO_RETURN과 불신뢰 분류, ROI의 보호 높이, 얇은 물체와 다른 센서도 놓치는 경우를 검증한다.
- USB 부하, read 지연, 끊김과 재연결에서 acquisition 추정, 실제 정지 지연과 watchdog을
  측정한다. first-frame 시간 offset의 불확실성도 reaction budget에 포함한다.
- 감독자와 독립 e-stop이 있는 통제 공간에서 payload, 바닥, 배터리 조건별 전후진,
  횡이동, 회전의 최악 제동 거리와 감속도 하한을 측정한다. `deceleration`,
  `reaction_s`, footprint와 margin을 이에 맞추며 software 정지와 실제 정지를 구분한다.
- 저속 접근, 비스듬한 평판, 전면 가림, Nav2 동시 goal, cancel, Mission/Supervisor/가드
  재시작, lease 회수와 완료 후 정지 유지가 실제 구동에서 성립하는지 확인한다.
- 정지 상태에서 ROI와 검출 점을 기록하고 바닥/몸체 return을 구분한다. 15Hz 기준 인접
  검출 수, cluster 거리, confirm_s, release_s와 거리 hysteresis를 실제 물체와 순간 노이즈로
  튜닝한다. 비상 단일 return과 일반 검출의 지연/오탐/미탐을 각각 측정한다.
- 책상 ROI의 분산된 유효 column/row, 최소 폭, residual를 확인한다. 일부 품질 불량에서
  평면을 유지하는 경우와 평면 소실 시 zero/abort를 구분하고 접근 거리/yaw 오차를 측정한다.

위 근거와 사용한 설정을 보존한 뒤에만 `calibrated=true`를 적용한다. 평면의 좌우 중심은
ToF만으로 관측되지 않으므로 staging 위치와 팔 도달성은 별도 검증한다.
