asm17-moving-agent/cleany/ros2_ws/src/cleany_dev_monitor/docs/assets/03-same-target-revalidation.png

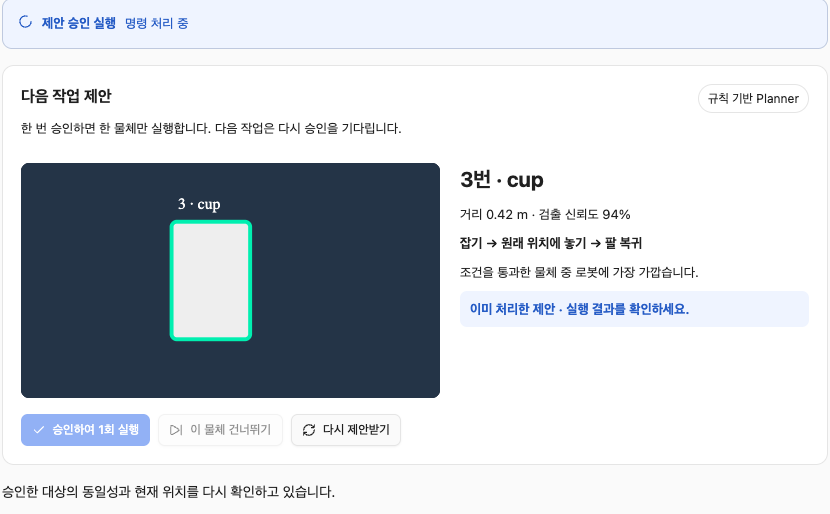
ros2_ws/src/cleany_dev_monitor/docs/assets/03-same-target-revalidation.png
