asm17-moving-agent/cleany/ros2_ws/src/cleany_description/mjcf/cleany.xml

<mujoco model="cleany">
  <compiler angle="radian" meshdir="../meshes/" autolimits="true" />
  <asset>
    <material name="white" rgba="0.3 0.3 0.3 1" specular="0.1" shininess="0.1" />
    <material name="grey" rgba="0.5 0.5 0.5 1" specular="0.1" shininess="0.1" />
    <material name="blue" rgba="0.15 0.25 0.5 1" specular="0.1" shininess="0.1" />
    <material name="motor" rgba="0.1 0.1 0.1 1" specular="0.1" shininess="0.1" />
    <material name="carbon" rgba="0.015 0.018 0.02 1" specular="0.3" shininess="0.6" />
    <material name="wheel_plate" rgba="0.62 0.64 0.68 1" specular="0.35" shininess="0.45" />
    <material name="wheel_roller" rgba="0.06 0.06 0.07 1" specular="0.05" shininess="0.1" />
    <mesh name="urdf_mesh_023" file="cad_frame/035armbase_step__êäèë4.stl" />
    <mesh name="urdf_mesh_025" file="cad_frame/fl_upright.stl" />
    <mesh name="urdf_mesh_026" file="cad_frame/fr_upright.stl" />
    <mesh name="urdf_mesh_027" file="cad_frame/front_inner_lower_cross_rail.stl" />
    <mesh name="urdf_mesh_028" file="cad_frame/left_inner_lower_rail.stl" />
    <mesh name="urdf_mesh_029" file="cad_frame/lower_front_cross_rail.stl" />
    <mesh name="urdf_mesh_030" file="cad_frame/lower_left_side_rail.stl" />
    <mesh name="urdf_mesh_031" file="cad_frame/lower_rear_cross_rail.stl" />
    <mesh name="urdf_mesh_032" file="cad_frame/lower_right_side_rail.stl" />
    <mesh name="urdf_mesh_034" file="cad_frame/part_1__2.stl" />
    <mesh name="urdf_mesh_035" file="cad_frame/pg42_4266_1270ne___1_61.stl" />
    <mesh name="urdf_mesh_036" file="cad_frame/pg42_motor_bracket.stl" />
    <mesh name="urdf_mesh_037" file="cad_frame/rear_inner_lower_cross_rail.stl" />
    <mesh name="urdf_mesh_038" file="cad_frame/right_inner_lower_rail.stl" />
    <mesh name="urdf_mesh_039" file="cad_frame/rl_upright.stl" />
    <mesh name="urdf_mesh_040" file="cad_frame/rr_upright.stl" />
    <mesh name="urdf_mesh_041" file="cad_frame/upper_front_cross_rail.stl" />
    <mesh name="urdf_mesh_042" file="cad_frame/upper_left_side_rail.stl" />
    <mesh name="urdf_mesh_043" file="cad_frame/upper_rear_cross_rail.stl" />
    <mesh name="urdf_mesh_044" file="cad_frame/upper_right_side_rail.stl" />
    <mesh name="urdf_mesh_046" file="cad_frame/topbase1.stl" />
    <mesh name="canonical_Base" file="Base.stl" />
    <mesh name="canonical_Base_Motor" file="Base_Motor.stl" />
    <mesh name="canonical_Rotation_Pitch" file="Rotation_Pitch.stl" />
    <mesh name="canonical_Rotation_Pitch_Motor" file="Rotation_Pitch_Motor.stl" />
    <mesh name="canonical_Upper_Arm_Sockets" file="Upper_Arm_5cm_Sockets.stl" />
    <mesh name="canonical_Upper_Arm_Carbon" file="Upper_Arm_5cm_Carbon.stl" />
    <mesh name="canonical_Upper_Arm_Motor" file="Upper_Arm_Motor.stl" />
    <mesh name="canonical_Upper_Arm" file="Upper_Arm_5cm.stl" />
    <mesh name="canonical_Lower_Arm_Sockets" file="Lower_Arm_5cm_Sockets.stl" />
    <mesh name="canonical_Lower_Arm_Carbon" file="Lower_Arm_5cm_Carbon.stl" />
    <mesh name="canonical_Lower_Arm_Motor" file="Lower_Arm_Motor.stl" />
    <mesh name="canonical_Lower_Arm" file="Lower_Arm_5cm.stl" />
    <mesh name="canonical_Wrist_Pitch_Roll" file="Wrist_Pitch_Roll.stl" />
    <mesh name="canonical_Wrist_Pitch_Roll_Motor" file="Wrist_Pitch_Roll_Motor.stl" />
    <mesh name="canonical_Fixed_Jaw" file="Fixed_Jaw.stl" />
    <mesh name="canonical_Fixed_Jaw_Motor" file="Fixed_Jaw_Motor.stl" />
    <mesh name="canonical_Fixed_Jaw_part1" file="Fixed_Jaw_part1.ply.convex.stl" />
    <mesh name="canonical_Fixed_Jaw_part2" file="Fixed_Jaw_part2.ply.convex.stl" />
    <mesh name="canonical_Moving_Jaw" file="Moving_Jaw.stl" />
    <mesh name="canonical_Moving_Jaw_part1" file="Moving_Jaw_part1.ply.convex.stl" />
    <mesh name="canonical_Moving_Jaw_part2" file="Moving_Jaw_part2.ply.convex.stl" />
    <mesh name="canonical_Moving_Jaw_part3" file="Moving_Jaw_part3.ply.convex.stl" />
    <mesh name="canonical_XLeRobot_camera1" file="XLeRobot_camera1.stl" scale="0.001 0.001 0.001" />
    <mesh name="canonical_XLeRobot_camera2" file="XLeRobot_camera2.stl" scale="0.001 0.001 0.001" />
    <mesh name="canonical_topbase2" file="topbase2.stl" scale="0.001 0.001 0.001" />
    <mesh name="canonical_tophead1" file="tophead1.stl" scale="0.001 0.001 0.001" />
    <mesh name="canonical_tophead4" file="tophead4.stl" scale="0.001 0.001 0.001" />
    <mesh name="canonical_tophead5" file="tophead5.stl" scale="0.001 0.001 0.001" />
    <mesh name="canonical_tophead6" file="tophead6.stl" scale="0.001 0.001 0.001" />
  </asset>
  <default>
    <geom contype="0" conaffinity="0" condim="1" solref="0.005 1" />
    <default class="wheel">
      <joint type="hinge" axis="0 0 1" damping="0" actuatorfrcrange="-2.646 2.646" />
    </default>
    <default class="pg42_drive">
      <dcmotor gear="1" nominal="12 28.702929 12.017021" saturation="2.646 0 0" ctrlrange="-10.8 10.8" />
    </default>
    <default class="mecanum_roller">
      <joint type="hinge" axis="0 0 1" limited="false" damping="0.00002" frictionloss="0.0001" armature="0.000001" group="3" />
      <geom type="capsule" size="0.008 0.015" mass="0.01" material="wheel_roller" group="2" contype="2" conaffinity="1" priority="1" condim="6" friction="1.2 0.002 0.0002" solref="0.003 1" solimp="0.95 0.99 0.001" />
    </default>
    <default class="caster">
      <geom type="sphere" group="3" size="0.02" rgba="0.7 0.7 0.7 1" contype="1" conaffinity="1" condim="1" priority="1" />
    </default>
    <default class="sts3215">
      <geom contype="0" conaffinity="0" />
      <joint damping="0.611437854" frictionloss="0.052" armature="0.028" actuatorfrcrange="-2.6477955 2.6477955" />
      <position kp="998.22" kv="2.731" forcerange="-2.6477955 2.6477955" />
      <!-- Deferred until the MuJoCo/ros2_control upgrade. Also remove legacy
           damping and change the servo actuator tags when enabling this.
      <dcmotor gear="1" nominal="12 2.941995 4.71710608647" saturation="2.6477955 0 0" input="position" controller="4071.60447248 0 11.1393799106 0 0 10.8" />
      -->
    </default>
    <default class="sts3250">
      <geom contype="0" conaffinity="0" />
      <joint damping="0.615411848" frictionloss="0.052" armature="0.028" actuatorfrcrange="-4.4129925 4.4129925" />
      <position kp="998.22" kv="2.731" forcerange="-4.4129925 4.4129925" />
      <!-- Deferred position-input motor; see the sts3215 upgrade note.
      <dcmotor gear="1" nominal="12 4.903325 7.87366579847" saturation="4.4129925 0 0" input="position" controller="2442.96268349 0 6.68362794634 0 0 10.8" />
      -->
    </default>
    <default class="visual">
      <geom type="mesh" contype="0" conaffinity="0" density="0" group="2" />
    </default>
    <default class="collision">
      <geom contype="1" conaffinity="1" group="3" type="mesh" condim="4" solref="0.002 1.0" solimp="0.95 0.99 0.001" density="0" />
    </default>
  </default>
  <worldbody>
    <light directional="true" pos="-0.5 0.5 3" dir="0 0 -1" />
    <body name="chassis" pos="0 0 0.38">
      <inertial mass="12.0573377764" pos="0.0037644026035 2.68894573649e-05 -0.156152325094" fullinertia="0.815948844889 0.751017904557 0.477130117256 -4.42409688039e-07 -0.026277087779 6.32623503865e-08" />
      <freejoint />
      <geom name="base_link_visual_1" class="visual" type="mesh" mesh="urdf_mesh_023" rgba="0.231373 0.380392 0.705882 1" pos="-0.0154995 -0.0745144 -0.317538" quat="0.707105482511 -1.70334544385e-08 -2.22222760961e-08 0.707108079859" />
      <geom name="base_link_visual_2" class="visual" type="mesh" mesh="urdf_mesh_034" rgba="0.615686 0.811765 0.929412 1" pos="0.1162 2.68346e-05 0.415503" quat="0.707105482511 -1.70334544385e-08 -2.22222760961e-08 0.707108079859" />
      <geom name="base_link_visual_3" class="visual" type="mesh" mesh="urdf_mesh_023" rgba="0.231373 0.380392 0.705882 1" pos="0.2479 0.0745681 -0.317538" quat="0.707105482511 2.22222135286e-08 -1.70335360654e-08 -0.707108079859" />
      <geom name="base_link_visual_4" class="visual" type="mesh" mesh="urdf_mesh_044" rgba="0.647059 0.647059 0.647059 1" pos="-2.45311e-05 2.6839e-05 -0.274497" quat="0.707105482511 -1.70334544385e-08 -2.22222760961e-08 0.707108079859" />
      <geom name="base_link_visual_5" class="visual" type="mesh" mesh="urdf_mesh_031" rgba="0.647059 0.647059 0.647059 1" pos="-2.45311e-05 2.6839e-05 -0.274497" quat="0.707105482511 -1.70334544385e-08 -2.22222760961e-08 0.707108079859" />
      <geom name="base_link_visual_6" class="visual" type="mesh" mesh="urdf_mesh_041" rgba="0.647059 0.647059 0.647059 1" pos="-2.45311e-05 2.6839e-05 -0.274497" quat="0.707105482511 -1.70334544385e-08 -2.22222760961e-08 0.707108079859" />
      <geom name="base_link_visual_7" class="visual" type="mesh" mesh="urdf_mesh_037" rgba="0.768627 0.886275 0.952941 1" pos="-2.45311e-05 2.6839e-05 -0.274497" quat="0.707105482511 -1.70334544385e-08 -2.22222760961e-08 0.707108079859" />
      <geom name="base_link_visual_8" class="visual" type="mesh" mesh="urdf_mesh_030" rgba="0.647059 0.647059 0.647059 1" pos="-2.45311e-05 2.6839e-05 -0.274497" quat="0.707105482511 -1.70334544385e-08 -2.22222760961e-08 0.707108079859" />
      <geom name="base_link_visual_9" class="visual" type="mesh" mesh="urdf_mesh_029" rgba="0.647059 0.647059 0.647059 1" pos="-2.45311e-05 2.6839e-05 -0.274497" quat="0.707105482511 -1.70334544385e-08 -2.22222760961e-08 0.707108079859" />
      <geom name="base_link_visual_10" class="visual" type="mesh" mesh="urdf_mesh_038" rgba="0.917647 0.917647 0.917647 1" pos="-2.45311e-05 2.6839e-05 -0.274497" quat="0.707105482511 -1.70334544385e-08 -2.22222760961e-08 0.707108079859" />
      <geom name="base_link_visual_11" class="visual" type="mesh" mesh="urdf_mesh_027" rgba="0.768627 0.886275 0.952941 1" pos="-2.45311e-05 2.6839e-05 -0.274497" quat="0.707105482511 -1.70334544385e-08 -2.22222760961e-08 0.707108079859" />
      <geom name="base_link_visual_12" class="visual" type="mesh" mesh="urdf_mesh_039" rgba="0.231373 0.380392 0.705882 1" pos="-2.45311e-05 2.6839e-05 -0.274497" quat="0.707105482511 -1.70334544385e-08 -2.22222760961e-08 0.707108079859" />
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
      <geom name="base_link_collision_5" class="collision" type="box" size="0.01 0.25 0.01" pos="-0.19 0 -0.274" />
      <geom name="base_link_collision_6" class="collision" type="box" size="0.01 0.2 0.01" pos="0.063 0 -0.274" />
      <geom name="base_link_collision_7" class="collision" type="box" size="0.01 0.2 0.01" pos="-0.063 0 -0.274" />
      <geom name="base_link_collision_8" class="collision" type="box" size="0.01 0.01 0.33" pos="0.19 0.24 0.066" />
      <geom name="base_link_collision_9" class="collision" type="box" size="0.01 0.01 0.33" pos="0.19 -0.24 0.066" />
      <geom name="base_link_collision_10" class="collision" type="box" size="0.01 0.01 0.33" pos="-0.19 0.24 0.066" />
      <geom name="base_link_collision_11" class="collision" type="box" size="0.01 0.01 0.33" pos="-0.19 -0.24 0.066" />
      <geom name="base_link_collision_12" class="collision" type="box" size="0.18 0.01 0.01" pos="0 0.24 0.406" />
      <geom name="base_link_collision_13" class="collision" type="box" size="0.18 0.01 0.01" pos="0 -0.24 0.406" />
      <geom name="base_link_collision_14" class="collision" type="box" size="0.01 0.25 0.01" pos="0.19 0 0.406" />
      <geom name="base_link_collision_15" class="collision" type="box" size="0.01 0.25 0.01" pos="-0.19 0 0.406" />
      <geom name="base_link_collision_17" class="collision" type="box" size="0.08 0.25 0.0015" pos="0.116 0 0.4175" />
      <geom name="base_link_collision_18" class="collision" type="box" size="0.055 0.055 0.006" pos="0.116 0.175 0.425" />
      <geom name="base_link_collision_19" class="collision" type="box" size="0.055 0.055 0.006" pos="0.116 -0.175 0.425" />
      <body name="upper_structure" pos="0 0 0" quat="0 0 0 1">
        <body name="Base" pos="-0.1163 -0.139917 0.431297">
          <inertial pos="0.0137179 -5.19711e-05 0.0334843" mass="0.147" fullinertia="0.000114686 0.000136117 0.000130364 -4.59787e-07 4.97151e-06 9.75275e-08" />
          <body name="Rotation_Pitch" pos="0 -0.0452 0.0165" quat="0.707105482511 0.707108079859 0 0">
            <inertial pos="-0.0307604 -1.66727e-05 -0.0252713" mass="0.100006" fullinertia="8.3759e-05 8.10403e-05 2.39783e-05 7.55525e-08 -1.16342e-06 1.54663e-07" />
            <joint name="left_shoulder_yaw_joint" type="hinge" axis="0 1 0" range="-2.16 2.16" class="sts3215" />
            <body name="Upper_Arm" pos="0 0.1025 0.0306" quat="0.707105482511 0.707108079859 0 0">
              <inertial pos="0.00011909447145 0.13366336448 0.00941424883693" mass="0.1185" fullinertia="0.000344882383932 3.90640385918e-05 0.000341356582549 1.26253142805e-08 -1.8457009038e-09 -3.22497618493e-05" />
              <joint name="left_shoulder_pitch_joint" type="hinge" axis="-1 0 0" range="-0.22 3.37" class="sts3250" />
              <body name="Lower_Arm" pos="0 0.16257 0.028" quat="0.707105482511 -0.707108079859 0 0">
                <inertial pos="-0.000705377693495 0.003222361186 0.133834080359" mass="0.093" fullinertia="0.000317919847018 0.000326130407587 1.82344857592e-05 -2.45304506082e-07 -4.42747241607e-06 -1.1286233547e-05" />
                <joint name="left_elbow_pitch_joint" type="hinge" axis="1 0 0" range="-0.22 3.14" class="sts3250" />
                <body name="Wrist_Pitch_Roll" pos="0 0.0052 0.1849" quat="0.707105482511 -0.707108079859 0 0">
                  <inertial pos="-0.000103312 -0.0386143 0.0281156" mass="0.079" fullinertia="3.68263e-05 2.5391e-05 2.1e-05 1.7893e-08 -5.28128e-08 3.6412e-06" />
                  <joint name="left_wrist_pitch_joint" type="hinge" axis="1 0 0" range="-1.6580628494556928 1.6580627293335335" class="sts3215" />
                  <body name="Fixed_Jaw" pos="0 -0.0601 0" quat="0.707105482511 0 0.707108079859 0">
                    <inertial pos="0.000213627 0.000245138 -0.025187" mass="0.087" fullinertia="2.75087e-05 4.33657e-05 3.45059e-05 -3.35241e-07 -5.7352e-06 -5.17847e-08" />
                    <joint name="left_wrist_roll_joint" type="hinge" axis="0 -1 0" range="-2.7438472969992493 2.841206309382605" class="sts3215" />
                    <body name="Moving_Jaw" pos="-0.0202 -0.0244 0" quat="3.45517843564e-07 -0.0940644025695 -0.995566114407 -3.65691853218e-06">
                      <inertial pos="-0.00157495 -0.0300244 0.0192755" mass="0.012" fullinertia="6.61427e-06 1.89032e-06 5.28738e-06 -3.19807e-07 -5.90717e-09 -1.09945e-07" />
                      <joint name="left_gripper_joint" type="hinge" axis="0 0 1" range="-0.37453297762778586 1.7453291995659765" class="sts3215" />
                      <geom type="mesh" mesh="canonical_Moving_Jaw" material="white" class="visual" />
                      <geom type="mesh" mesh="canonical_Moving_Jaw_part1" class="collision" friction="3 0.2 0.1" condim="6" />
                      <geom type="mesh" mesh="canonical_Moving_Jaw_part2" class="collision" friction="3 0.2 0.1" condim="6" />
                      <geom type="mesh" mesh="canonical_Moving_Jaw_part3" class="collision" friction="3 0.2 0.1" condim="6" />
                    </body>
                    <body name="left_grasp_tcp" pos="0 -0.1 0">
                      <inertial mass="1e-09" fullinertia="1e-09 1e-09 1e-09 -4.23522244606e-31 -4.25331005726e-30 1.57772168441e-30" pos="-5.24560504311e-12 1.89459559191e-12 1.428082923e-06" />
                      <body name="left_pregrasp_aim_tip" pos="0 -0.14 -0">
                        <inertial mass="1e-09" fullinertia="1e-09 1e-09 1e-09 -4.23522244606e-31 -4.25331005726e-30 1.57772168441e-30" pos="-6.61021018312e-12 2.38753461484e-12 1.79958549407e-06" />
                      </body>
                    </body>
                    <body name="left_wrist_rgb_optical_frame" pos="-0.00387202 -0.01367 0.06494" quat="0.382116765679 0.594970780241 0.597856496624 -0.377576690873">
                      <inertial mass="1e-09" fullinertia="1e-09 1e-09 1e-09 -3.37370805697e-27 6.03357851998e-25 -1.04115093529e-27" pos="-1.01365842617e-06 5.04782112276e-09 -6.63147172246e-07" />
                    </body>
                    <body name="Left_Arm_Camera" pos="0 -0.022 0.05" euler="1.5708 -1.5708 0">
                      <site name="left_wrist_rgb_optical_frame" pos="-0.00833 0.01494 0.003872" xyaxes="-0.42286 -0.90620 0.0 -0.00690 0.00322 -0.99997" size="0.005" rgba="1 0 0 0" />
                      <camera name="left_wrist_rgb" pos="-0.00833 0.01494 0.003872" xyaxes="-0.42286 -0.90620 0.0 0.00690 -0.00322 0.99997" fovy="93" />
                      <geom type="mesh" mesh="canonical_XLeRobot_camera1" pos="-0.015 -0.026 0" material="white" class="visual" />
                      <geom type="mesh" mesh="canonical_XLeRobot_camera2" pos="-0.015 -0.026 0" material="motor" class="visual" />
                    </body>
                    <site name="left_grasp_tcp" pos="0 -0.100 0" size="0.005" rgba="0 0.8 1 0.4" />
                    <geom type="mesh" mesh="canonical_Fixed_Jaw" material="white" class="visual" />
                    <geom type="mesh" mesh="canonical_Fixed_Jaw_Motor" material="motor" class="visual" />
                    <geom type="mesh" mesh="canonical_Fixed_Jaw_part1" class="collision" friction="3 0.2 0.1" condim="6" />
                    <geom type="mesh" mesh="canonical_Fixed_Jaw_part2" class="collision" friction="3 0.2 0.1" condim="6" />
                  </body>
                  <geom type="mesh" mesh="canonical_Wrist_Pitch_Roll" material="white" class="visual" />
                  <geom type="mesh" mesh="canonical_Wrist_Pitch_Roll_Motor" material="motor" class="visual" />
                  <geom type="mesh" mesh="canonical_Wrist_Pitch_Roll" class="collision" />
                  <geom type="mesh" mesh="canonical_Wrist_Pitch_Roll_Motor" class="collision" />
                </body>
                <geom type="mesh" mesh="canonical_Lower_Arm_Sockets" pos="-0.0025 0.032 0.065" quat="0.707106781187 0 0.707106781187 0" material="white" class="visual" />
                <geom type="mesh" mesh="canonical_Lower_Arm_Carbon" pos="-0.0025 0.032 0.065" quat="0.707106781187 0 0.707106781187 0" material="carbon" class="visual" />
                <geom type="mesh" mesh="canonical_Lower_Arm_Motor" pos="0 0 0.05" material="motor" class="visual" />
                <geom type="mesh" mesh="canonical_Lower_Arm" pos="-0.0025 0.032 0.065" quat="0.707106781187 0 0.707106781187 0" class="collision" />
                <geom type="mesh" mesh="canonical_Lower_Arm_Motor" pos="0 0 0.05" class="collision" />
              </body>
              <geom type="mesh" mesh="canonical_Upper_Arm_Sockets" pos="-0.0001 0.0651 -0.012" quat="0.5 0.5 -0.5 -0.5" material="white" class="visual" />
              <geom type="mesh" mesh="canonical_Upper_Arm_Carbon" pos="-0.0001 0.0651 -0.012" quat="0.5 0.5 -0.5 -0.5" material="carbon" class="visual" />
              <geom type="mesh" mesh="canonical_Upper_Arm_Motor" pos="0 0.05 0" material="motor" class="visual" />
              <geom type="mesh" mesh="canonical_Upper_Arm" pos="-0.0001 0.0651 -0.012" quat="0.5 0.5 -0.5 -0.5" class="collision" />
              <geom type="mesh" mesh="canonical_Upper_Arm_Motor" pos="0 0.05 0" class="collision" />
            </body>
            <geom type="mesh" mesh="canonical_Rotation_Pitch" material="white" class="visual" />
            <geom type="mesh" mesh="canonical_Rotation_Pitch_Motor" material="motor" class="visual" />
            <geom type="mesh" mesh="canonical_Rotation_Pitch" class="collision" />
            <geom type="mesh" mesh="canonical_Rotation_Pitch_Motor" class="collision" />
          </body>
          <geom type="mesh" mesh="canonical_Base" material="white" class="visual" />
          <geom type="mesh" mesh="canonical_Base_Motor" material="motor" class="visual" />
          <geom type="mesh" mesh="canonical_Base" class="collision" />
          <geom type="mesh" mesh="canonical_Base_Motor" class="collision" />
        </body>
        <body name="Base_2" pos="-0.116101000162 0.139863 0.431297" quat="1.79489651492e-09 0 0 1">
          <inertial pos="0.0137179 -5.19711e-05 0.0334843" mass="0.147" fullinertia="0.000114686 0.000136117 0.000130364 -4.59787e-07 4.97151e-06 9.75275e-08" />
          <body name="Rotation_Pitch_2" pos="0 -0.0452 0.0165" quat="0.707105482511 0.707108079859 0 0">
            <inertial pos="-0.0307604 -1.66727e-05 -0.0252713" mass="0.100006" fullinertia="8.3759e-05 8.10403e-05 2.39783e-05 7.55525e-08 -1.16342e-06 1.54663e-07" />
            <joint name="right_shoulder_yaw_joint" type="hinge" axis="0 1 0" range="-2.16 2.16" class="sts3215" />
            <body name="Upper_Arm_2" pos="0 0.1025 0.0306" quat="0.707105482511 0.707108079859 0 0">
              <inertial pos="0.00011909447145 0.13366336448 0.00941424883693" mass="0.1185" fullinertia="0.000344882383932 3.90640385918e-05 0.000341356582549 1.26253142805e-08 -1.8457009038e-09 -3.22497618493e-05" />
              <joint name="right_shoulder_pitch_joint" type="hinge" axis="-1 0 0" range="-0.22 3.37" class="sts3250" />
              <body name="Lower_Arm_2" pos="0 0.16257 0.028" quat="0.707105482511 -0.707108079859 0 0">
                <inertial pos="-0.000705377693495 0.003222361186 0.133834080359" mass="0.093" fullinertia="0.000317919847018 0.000326130407587 1.82344857592e-05 -2.45304506082e-07 -4.42747241607e-06 -1.1286233547e-05" />
                <joint name="right_elbow_pitch_joint" type="hinge" axis="1 0 0" range="-0.22 3.14" class="sts3250" />
                <body name="Wrist_Pitch_Roll_2" pos="0 0.0052 0.1849" quat="0.707105482511 -0.707108079859 0 0">
                  <inertial pos="-0.000103312 -0.0386143 0.0281156" mass="0.079" fullinertia="3.68263e-05 2.5391e-05 2.1e-05 1.7893e-08 -5.28128e-08 3.6412e-06" />
                  <joint name="right_wrist_pitch_joint" type="hinge" axis="1 0 0" range="-1.6580628494556928 1.6580627293335335" class="sts3215" />
                  <body name="Fixed_Jaw_2" pos="0 -0.0601 0" quat="0.707105482511 0 0.707108079859 0">
                    <inertial pos="0.000213627 0.000245138 -0.025187" mass="0.087" fullinertia="2.75087e-05 4.33657e-05 3.45059e-05 -3.35241e-07 -5.7352e-06 -5.17847e-08" />
                    <joint name="right_wrist_roll_joint" type="hinge" axis="0 -1 0" range="-2.7438472969992493 2.841206309382605" class="sts3215" />
                    <body name="Moving_Jaw_2" pos="-0.0202 -0.0244 0" quat="3.45517843564e-07 -0.0940644025695 -0.995566114407 -3.65691853218e-06">
                      <inertial pos="-0.00157495 -0.0300244 0.0192755" mass="0.012" fullinertia="6.61427e-06 1.89032e-06 5.28738e-06 -3.19807e-07 -5.90717e-09 -1.09945e-07" />
                      <joint name="right_gripper_joint" type="hinge" axis="0 0 1" range="-0.37453297762778586 1.7453291995659765" class="sts3215" />
                      <geom type="mesh" mesh="canonical_Moving_Jaw" material="white" class="visual" />
                      <geom type="mesh" mesh="canonical_Moving_Jaw_part1" class="collision" friction="3 0.2 0.1" condim="6" />
                      <geom type="mesh" mesh="canonical_Moving_Jaw_part2" class="collision" friction="3 0.2 0.1" condim="6" />
                      <geom type="mesh" mesh="canonical_Moving_Jaw_part3" class="collision" friction="3 0.2 0.1" condim="6" />
                    </body>
                    <body name="right_grasp_tcp" pos="0 -0.1 0">
                      <inertial mass="1e-09" fullinertia="1e-09 1e-09 1e-09 -6.13231448667e-39 -4.28249991409e-30 1.54074395554e-33" pos="-7.04575654835e-15 5.9957624125e-17 1.93191960234e-09" />
                      <body name="right_pregrasp_aim_tip" pos="0 -0.14 0">
                        <inertial mass="1e-09" fullinertia="1e-09 1e-09 1e-09 -6.13231448667e-39 -4.28249991409e-30 1.54074395554e-33" pos="-8.89180305844e-15 5.9957624125e-17 2.43449062652e-09" />
                      </body>
                    </body>
                    <body name="right_wrist_rgb_optical_frame" pos="-0.00387202 -0.01267 0.06494" quat="0.382116765679 0.594970780241 0.597856496624 -0.377576690873">
                      <inertial mass="1e-09" fullinertia="1e-09 1e-09 1e-09 -3.7862833647e-27 7.14569423757e-25 3.35665116041e-28" pos="-1.36803160262e-09 6.81718570483e-12 -8.95590072589e-10" />
                    </body>
                    <body name="Right_Arm_Camera" pos="0 -0.021 0.05" euler="1.5708 -1.5708 0">
                      <site name="right_wrist_rgb_optical_frame" pos="-0.00833 0.01494 0.003872" xyaxes="-0.42286 -0.90620 0.0 -0.00690 0.00322 -0.99997" size="0.005" rgba="1 0 0 0" />
                      <camera name="right_wrist_rgb" pos="-0.00833 0.01494 0.003872" xyaxes="-0.42286 -0.90620 0.0 0.00690 -0.00322 0.99997" fovy="93" />
                      <geom type="mesh" mesh="canonical_XLeRobot_camera1" pos="-0.015 -0.026 0" material="white" class="visual" />
                      <geom type="mesh" mesh="canonical_XLeRobot_camera2" pos="-0.015 -0.026 0" material="motor" class="visual" />
                    </body>
                    <site name="right_grasp_tcp" pos="0 -0.100 0" size="0.005" rgba="0 0.8 1 0.4" />
                    <geom type="mesh" mesh="canonical_Fixed_Jaw" material="white" class="visual" />
                    <geom type="mesh" mesh="canonical_Fixed_Jaw_Motor" material="motor" class="visual" />
                    <geom type="mesh" mesh="canonical_Fixed_Jaw_part1" class="collision" friction="3 0.2 0.1" condim="6" />
                    <geom type="mesh" mesh="canonical_Fixed_Jaw_part2" class="collision" friction="3 0.2 0.1" condim="6" />
                  </body>
                  <geom type="mesh" mesh="canonical_Wrist_Pitch_Roll" material="white" class="visual" />
                  <geom type="mesh" mesh="canonical_Wrist_Pitch_Roll_Motor" material="motor" class="visual" />
                  <geom type="mesh" mesh="canonical_Wrist_Pitch_Roll" class="collision" />
                  <geom type="mesh" mesh="canonical_Wrist_Pitch_Roll_Motor" class="collision" />
                </body>
                <geom type="mesh" mesh="canonical_Lower_Arm_Sockets" pos="-0.0025 0.032 0.065" quat="0.707106781187 0 0.707106781187 0" material="white" class="visual" />
                <geom type="mesh" mesh="canonical_Lower_Arm_Carbon" pos="-0.0025 0.032 0.065" quat="0.707106781187 0 0.707106781187 0" material="carbon" class="visual" />
                <geom type="mesh" mesh="canonical_Lower_Arm_Motor" pos="0 0 0.05" material="motor" class="visual" />
                <geom type="mesh" mesh="canonical_Lower_Arm" pos="-0.0025 0.032 0.065" quat="0.707106781187 0 0.707106781187 0" class="collision" />
                <geom type="mesh" mesh="canonical_Lower_Arm_Motor" pos="0 0 0.05" class="collision" />
              </body>
              <geom type="mesh" mesh="canonical_Upper_Arm_Sockets" pos="-0.0001 0.0651 -0.012" quat="0.5 0.5 -0.5 -0.5" material="white" class="visual" />
              <geom type="mesh" mesh="canonical_Upper_Arm_Carbon" pos="-0.0001 0.0651 -0.012" quat="0.5 0.5 -0.5 -0.5" material="carbon" class="visual" />
              <geom type="mesh" mesh="canonical_Upper_Arm_Motor" pos="0 0.05 0" material="motor" class="visual" />
              <geom type="mesh" mesh="canonical_Upper_Arm" pos="-0.0001 0.0651 -0.012" quat="0.5 0.5 -0.5 -0.5" class="collision" />
              <geom type="mesh" mesh="canonical_Upper_Arm_Motor" pos="0 0.05 0" class="collision" />
            </body>
            <geom type="mesh" mesh="canonical_Rotation_Pitch" material="white" class="visual" />
            <geom type="mesh" mesh="canonical_Rotation_Pitch_Motor" material="motor" class="visual" />
            <geom type="mesh" mesh="canonical_Rotation_Pitch" class="collision" />
            <geom type="mesh" mesh="canonical_Rotation_Pitch_Motor" class="collision" />
          </body>
          <geom type="mesh" mesh="canonical_Base" material="white" class="visual" />
          <geom type="mesh" mesh="canonical_Base_Motor" material="motor" class="visual" />
          <geom type="mesh" mesh="canonical_Base" class="collision" />
          <geom type="mesh" mesh="canonical_Base_Motor" class="collision" />
        </body>
        <body name="top_base_link" pos="0 0 0.35">
          <inertial pos="0 0 0" mass="0.2542" diaginertia="0.0045 0.005 0.0045" />
          <body name="head_pan_link" pos="-0.103 0 0.323">
            <inertial pos="0 0 0" mass="0.2556" diaginertia="0.0129 0.0095 0.0184" />
            <joint name="head_pan_joint" type="hinge" axis="0 0 1" range="-3.2 3.2" class="sts3215" />
            <body name="head_tilt_link" pos="0.001 0.002 0.09815" quat="1.79489651492e-09 0 0 1">
              <inertial mass="0.0937210745284" pos="0.0175112640785 0.00256485036332 0.0236605848549" fullinertia="7.21965386748e-05 2.26317092184e-05 7.3013184687e-05 7.82947630635e-08 -5.84401505052e-06 1.22910767739e-09" />
              <joint name="head_tilt_joint" type="hinge" axis="0 1 0" range="-0.76 1.45" class="sts3215" />
              <body name="head_camera_link" pos="0.025 0 0.03">
                <body name="head_camera_rgb_frame" pos="0 0 0">
                  <body name="head_camera_rgb_optical_frame" pos="0 0 0" quat="0.5 -0.5 0.5 -0.5">
                    <site name="head_camera_rgb_optical_frame" type="box" size="0.01 0.01 0.01" rgba="1 0 0 0.3" />
                    <camera name="head_realsense_rgb" pos="0 0 0" quat="0 1 0 0" fovy="42" />
                  </body>
                </body>
                <body name="head_camera_depth_frame" pos="0 0 0">
                  <body name="head_camera_depth_optical_frame" pos="0 0 0" quat="0.5 -0.5 0.5 -0.5">
                    <site name="head_camera_depth_optical_frame" type="box" size="0.01 0.01 0.01" rgba="0 1 0 0.0" />
                    <camera name="head_realsense_depth" pos="0 0 0" quat="0 1 0 0" fovy="40" />
                  </body>
                </body>
              </body>
              <geom type="mesh" mesh="canonical_tophead5" pos="0.16265 -0.006 -1.16815" material="white" class="visual" />
              <geom type="mesh" mesh="canonical_tophead6" pos="0.16265 -0.006 -1.16815" material="motor" class="visual" />
              <geom name="head_tilt_link_collision_0" class="collision" type="box" size="0.0225 0.0495 0.025" pos="0.0100999914987 0.0026003243049 0.014" quat="0.999999999996 0 0 2.65538468987e-06" />
            </body>
            <geom type="mesh" mesh="canonical_tophead1" pos="-0.335 -0.005 -0.923" material="white" class="visual" />
            <geom type="mesh" mesh="canonical_tophead4" pos="1.17 -0.009 0.262" euler="3.14 -1.57 3.14" material="motor" class="visual" />
            <geom name="head_pan_link_collision_0" class="collision" type="box" size="0.0275 0.025 0.02" pos="0.0135000000003 -2.37496286505e-07 0.093" quat="0.999999999999 0 0 1.32679489668e-06" />
          </body>
          <geom type="mesh" mesh="urdf_mesh_046" pos="-0.44 -0.005 -0.6" euler="0 0 0" material="white" class="visual" />
          <geom type="mesh" mesh="canonical_topbase2" pos="-0.298 0.006 -0.715" euler="0 0 3.14" material="motor" class="visual" />
          <geom name="top_base_link_collision_0" class="collision" type="box" size="0.0752 0.06 0.16745" pos="-0.104399999336 -0.000250277034774 0.23595" quat="0.999999999999 0 0 1.32679489668e-06" />
        </body>
      </body>
      <site name="lidar_site" pos="0.18 0 0.08" size="0.02" rgba="0 1 0 0.5" />
      <body name="front_left_wheel" pos="0.174975 0.301927 -0.316497" zaxis="0 1 0">
        <joint name="front_left_wheel_joint" class="wheel" />
        <inertial pos="0 0 0" mass="0.38" diaginertia="0.00032 0.00032 0.00048" />
        <geom type="cylinder" size="0.05 0.002" pos="0 0 -0.0235" material="wheel_plate" class="visual" />
        <geom type="cylinder" size="0.05 0.002" pos="0 0 0.0235" material="wheel_plate" class="visual" />
        <geom type="cylinder" size="0.024 0.0255" material="wheel_plate" class="visual" />
        <body name="front_left_roller_00" pos="0.0555 0 0" zaxis="0 0.707107 0.707107">
          <joint name="front_left_roller_00_joint" class="mecanum_roller" />
          <geom class="mecanum_roller" />
        </body>
        <body name="front_left_roller_01" pos="0.048064 0.02775 0" zaxis="-0.353553 0.612372 0.707107">
          <joint name="front_left_roller_01_joint" class="mecanum_roller" />
          <geom class="mecanum_roller" />
        </body>
        <body name="front_left_roller_02" pos="0.02775 0.048064 0" zaxis="-0.612372 0.353553 0.707107">
          <joint name="front_left_roller_02_joint" class="mecanum_roller" />
          <geom class="mecanum_roller" />
        </body>
        <body name="front_left_roller_03" pos="0 0.0555 0" zaxis="-0.707107 0 0.707107">
          <joint name="front_left_roller_03_joint" class="mecanum_roller" />
          <geom class="mecanum_roller" />
        </body>
        <body name="front_left_roller_04" pos="-0.02775 0.048064 0" zaxis="-0.612372 -0.353553 0.707107">
          <joint name="front_left_roller_04_joint" class="mecanum_roller" />
          <geom class="mecanum_roller" />
        </body>
        <body name="front_left_roller_05" pos="-0.048064 0.02775 0" zaxis="-0.353553 -0.612372 0.707107">
          <joint name="front_left_roller_05_joint" class="mecanum_roller" />
          <geom class="mecanum_roller" />
        </body>
        <body name="front_left_roller_06" pos="-0.0555 0 0" zaxis="0 -0.707107 0.707107">
          <joint name="front_left_roller_06_joint" class="mecanum_roller" />
          <geom class="mecanum_roller" />
        </body>
        <body name="front_left_roller_07" pos="-0.048064 -0.02775 0" zaxis="0.353553 -0.612372 0.707107">
          <joint name="front_left_roller_07_joint" class="mecanum_roller" />
          <geom class="mecanum_roller" />
        </body>
        <body name="front_left_roller_08" pos="-0.02775 -0.048064 0" zaxis="0.612372 -0.353553 0.707107">
          <joint name="front_left_roller_08_joint" class="mecanum_roller" />
          <geom class="mecanum_roller" />
        </body>
        <body name="front_left_roller_09" pos="0 -0.0555 0" zaxis="0.707107 0 0.707107">
          <joint name="front_left_roller_09_joint" class="mecanum_roller" />
          <geom class="mecanum_roller" />
        </body>
        <body name="front_left_roller_10" pos="0.02775 -0.048064 0" zaxis="0.612372 0.353553 0.707107">
          <joint name="front_left_roller_10_joint" class="mecanum_roller" />
          <geom class="mecanum_roller" />
        </body>
        <body name="front_left_roller_11" pos="0.048064 -0.02775 0" zaxis="0.353553 0.612372 0.707107">
          <joint name="front_left_roller_11_joint" class="mecanum_roller" />
          <geom class="mecanum_roller" />
        </body>
      </body>
      <body name="front_right_wheel" pos="0.174975 -0.301873 -0.316497" zaxis="0 1 0">
        <joint name="front_right_wheel_joint" class="wheel" />
        <inertial pos="0 0 0" mass="0.38" diaginertia="0.00032 0.00032 0.00048" />
        <geom type="cylinder" size="0.05 0.002" pos="0 0 -0.0235" material="wheel_plate" class="visual" />
        <geom type="cylinder" size="0.05 0.002" pos="0 0 0.0235" material="wheel_plate" class="visual" />
        <geom type="cylinder" size="0.024 0.0255" material="wheel_plate" class="visual" />
        <body name="front_right_roller_00" pos="0.0555 0 0" zaxis="0 0.707107 -0.707107">
          <joint name="front_right_roller_00_joint" class="mecanum_roller" />
          <geom class="mecanum_roller" />
        </body>
        <body name="front_right_roller_01" pos="0.048064 0.02775 0" zaxis="-0.353553 0.612372 -0.707107">
          <joint name="front_right_roller_01_joint" class="mecanum_roller" />
          <geom class="mecanum_roller" />
        </body>
        <body name="front_right_roller_02" pos="0.02775 0.048064 0" zaxis="-0.612372 0.353553 -0.707107">
          <joint name="front_right_roller_02_joint" class="mecanum_roller" />
          <geom class="mecanum_roller" />
        </body>
        <body name="front_right_roller_03" pos="0 0.0555 0" zaxis="-0.707107 0 -0.707107">
          <joint name="front_right_roller_03_joint" class="mecanum_roller" />
          <geom class="mecanum_roller" />
        </body>
        <body name="front_right_roller_04" pos="-0.02775 0.048064 0" zaxis="-0.612372 -0.353553 -0.707107">
          <joint name="front_right_roller_04_joint" class="mecanum_roller" />
          <geom class="mecanum_roller" />
        </body>
        <body name="front_right_roller_05" pos="-0.048064 0.02775 0" zaxis="-0.353553 -0.612372 -0.707107">
          <joint name="front_right_roller_05_joint" class="mecanum_roller" />
          <geom class="mecanum_roller" />
        </body>
        <body name="front_right_roller_06" pos="-0.0555 0 0" zaxis="0 -0.707107 -0.707107">
          <joint name="front_right_roller_06_joint" class="mecanum_roller" />
          <geom class="mecanum_roller" />
        </body>
        <body name="front_right_roller_07" pos="-0.048064 -0.02775 0" zaxis="0.353553 -0.612372 -0.707107">
          <joint name="front_right_roller_07_joint" class="mecanum_roller" />
          <geom class="mecanum_roller" />
        </body>
        <body name="front_right_roller_08" pos="-0.02775 -0.048064 0" zaxis="0.612372 -0.353553 -0.707107">
          <joint name="front_right_roller_08_joint" class="mecanum_roller" />
          <geom class="mecanum_roller" />
        </body>
        <body name="front_right_roller_09" pos="0 -0.0555 0" zaxis="0.707107 0 -0.707107">
          <joint name="front_right_roller_09_joint" class="mecanum_roller" />
          <geom class="mecanum_roller" />
        </body>
        <body name="front_right_roller_10" pos="0.02775 -0.048064 0" zaxis="0.612372 0.353553 -0.707107">
          <joint name="front_right_roller_10_joint" class="mecanum_roller" />
          <geom class="mecanum_roller" />
        </body>
        <body name="front_right_roller_11" pos="0.048064 -0.02775 0" zaxis="0.353553 0.612372 -0.707107">
          <joint name="front_right_roller_11_joint" class="mecanum_roller" />
          <geom class="mecanum_roller" />
        </body>
      </body>
      <body name="rear_left_wheel" pos="-0.175025 0.301927 -0.316497" zaxis="0 1 0">
        <joint name="rear_left_wheel_joint" class="wheel" />
        <inertial pos="0 0 0" mass="0.38" diaginertia="0.00032 0.00032 0.00048" />
        <geom type="cylinder" size="0.05 0.002" pos="0 0 -0.0235" material="wheel_plate" class="visual" />
        <geom type="cylinder" size="0.05 0.002" pos="0 0 0.0235" material="wheel_plate" class="visual" />
        <geom type="cylinder" size="0.024 0.0255" material="wheel_plate" class="visual" />
        <body name="rear_left_roller_00" pos="0.0555 0 0" zaxis="0 0.707107 -0.707107">
          <joint name="rear_left_roller_00_joint" class="mecanum_roller" />
          <geom class="mecanum_roller" />
        </body>
        <body name="rear_left_roller_01" pos="0.048064 0.02775 0" zaxis="-0.353553 0.612372 -0.707107">
          <joint name="rear_left_roller_01_joint" class="mecanum_roller" />
          <geom class="mecanum_roller" />
        </body>
        <body name="rear_left_roller_02" pos="0.02775 0.048064 0" zaxis="-0.612372 0.353553 -0.707107">
          <joint name="rear_left_roller_02_joint" class="mecanum_roller" />
          <geom class="mecanum_roller" />
        </body>
        <body name="rear_left_roller_03" pos="0 0.0555 0" zaxis="-0.707107 0 -0.707107">
          <joint name="rear_left_roller_03_joint" class="mecanum_roller" />
          <geom class="mecanum_roller" />
        </body>
        <body name="rear_left_roller_04" pos="-0.02775 0.048064 0" zaxis="-0.612372 -0.353553 -0.707107">
          <joint name="rear_left_roller_04_joint" class="mecanum_roller" />
          <geom class="mecanum_roller" />
        </body>
        <body name="rear_left_roller_05" pos="-0.048064 0.02775 0" zaxis="-0.353553 -0.612372 -0.707107">
          <joint name="rear_left_roller_05_joint" class="mecanum_roller" />
          <geom class="mecanum_roller" />
        </body>
        <body name="rear_left_roller_06" pos="-0.0555 0 0" zaxis="0 -0.707107 -0.707107">
          <joint name="rear_left_roller_06_joint" class="mecanum_roller" />
          <geom class="mecanum_roller" />
        </body>
        <body name="rear_left_roller_07" pos="-0.048064 -0.02775 0" zaxis="0.353553 -0.612372 -0.707107">
          <joint name="rear_left_roller_07_joint" class="mecanum_roller" />
          <geom class="mecanum_roller" />
        </body>
        <body name="rear_left_roller_08" pos="-0.02775 -0.048064 0" zaxis="0.612372 -0.353553 -0.707107">
          <joint name="rear_left_roller_08_joint" class="mecanum_roller" />
          <geom class="mecanum_roller" />
        </body>
        <body name="rear_left_roller_09" pos="0 -0.0555 0" zaxis="0.707107 0 -0.707107">
          <joint name="rear_left_roller_09_joint" class="mecanum_roller" />
          <geom class="mecanum_roller" />
        </body>
        <body name="rear_left_roller_10" pos="0.02775 -0.048064 0" zaxis="0.612372 0.353553 -0.707107">
          <joint name="rear_left_roller_10_joint" class="mecanum_roller" />
          <geom class="mecanum_roller" />
        </body>
        <body name="rear_left_roller_11" pos="0.048064 -0.02775 0" zaxis="0.353553 0.612372 -0.707107">
          <joint name="rear_left_roller_11_joint" class="mecanum_roller" />
          <geom class="mecanum_roller" />
        </body>
      </body>
      <body name="rear_right_wheel" pos="-0.175025 -0.301873 -0.316497" zaxis="0 1 0">
        <joint name="rear_right_wheel_joint" class="wheel" />
        <inertial pos="0 0 0" mass="0.38" diaginertia="0.00032 0.00032 0.00048" />
        <geom type="cylinder" size="0.05 0.002" pos="0 0 -0.0235" material="wheel_plate" class="visual" />
        <geom type="cylinder" size="0.05 0.002" pos="0 0 0.0235" material="wheel_plate" class="visual" />
        <geom type="cylinder" size="0.024 0.0255" material="wheel_plate" class="visual" />
        <body name="rear_right_roller_00" pos="0.0555 0 0" zaxis="0 0.707107 0.707107">
          <joint name="rear_right_roller_00_joint" class="mecanum_roller" />
          <geom class="mecanum_roller" />
        </body>
        <body name="rear_right_roller_01" pos="0.048064 0.02775 0" zaxis="-0.353553 0.612372 0.707107">
          <joint name="rear_right_roller_01_joint" class="mecanum_roller" />
          <geom class="mecanum_roller" />
        </body>
        <body name="rear_right_roller_02" pos="0.02775 0.048064 0" zaxis="-0.612372 0.353553 0.707107">
          <joint name="rear_right_roller_02_joint" class="mecanum_roller" />
          <geom class="mecanum_roller" />
        </body>
        <body name="rear_right_roller_03" pos="0 0.0555 0" zaxis="-0.707107 0 0.707107">
          <joint name="rear_right_roller_03_joint" class="mecanum_roller" />
          <geom class="mecanum_roller" />
        </body>
        <body name="rear_right_roller_04" pos="-0.02775 0.048064 0" zaxis="-0.612372 -0.353553 0.707107">
          <joint name="rear_right_roller_04_joint" class="mecanum_roller" />
          <geom class="mecanum_roller" />
        </body>
        <body name="rear_right_roller_05" pos="-0.048064 0.02775 0" zaxis="-0.353553 -0.612372 0.707107">
          <joint name="rear_right_roller_05_joint" class="mecanum_roller" />
          <geom class="mecanum_roller" />
        </body>
        <body name="rear_right_roller_06" pos="-0.0555 0 0" zaxis="0 -0.707107 0.707107">
          <joint name="rear_right_roller_06_joint" class="mecanum_roller" />
          <geom class="mecanum_roller" />
        </body>
        <body name="rear_right_roller_07" pos="-0.048064 -0.02775 0" zaxis="0.353553 -0.612372 0.707107">
          <joint name="rear_right_roller_07_joint" class="mecanum_roller" />
          <geom class="mecanum_roller" />
        </body>
        <body name="rear_right_roller_08" pos="-0.02775 -0.048064 0" zaxis="0.612372 -0.353553 0.707107">
          <joint name="rear_right_roller_08_joint" class="mecanum_roller" />
          <geom class="mecanum_roller" />
        </body>
        <body name="rear_right_roller_09" pos="0 -0.0555 0" zaxis="0.707107 0 0.707107">
          <joint name="rear_right_roller_09_joint" class="mecanum_roller" />
          <geom class="mecanum_roller" />
        </body>
        <body name="rear_right_roller_10" pos="0.02775 -0.048064 0" zaxis="0.612372 0.353553 0.707107">
          <joint name="rear_right_roller_10_joint" class="mecanum_roller" />
          <geom class="mecanum_roller" />
        </body>
        <body name="rear_right_roller_11" pos="0.048064 -0.02775 0" zaxis="0.353553 0.612372 0.707107">
          <joint name="rear_right_roller_11_joint" class="mecanum_roller" />
          <geom class="mecanum_roller" />
        </body>
      </body>
      <geom type="box" pos="-2.45499754308e-05 2.68365050107e-05 -0.175996987286" size="0.0975 0.0825 0.0875" density="0" name="battery_visual" class="visual" rgba="0.08 0.12 0.18 1" />
      <geom type="box" pos="-2.45499754308e-05 2.68365050107e-05 -0.175996987286" size="0.0975 0.0825 0.0875" density="0" name="battery_collision" class="collision" />
    </body>
  </worldbody>
  <contact>
    <exclude body1="Base" body2="Rotation_Pitch" />
    <exclude body1="Rotation_Pitch" body2="Upper_Arm" />
    <exclude body1="Upper_Arm" body2="Lower_Arm" />
    <exclude body1="Lower_Arm" body2="Wrist_Pitch_Roll" />
    <exclude body1="Wrist_Pitch_Roll" body2="Fixed_Jaw" />
    <exclude body1="Moving_Jaw" body2="Fixed_Jaw" />
    <exclude body1="Rotation_Pitch" body2="Lower_Arm" />
    <exclude body1="Rotation_Pitch" body2="Wrist_Pitch_Roll" />
    <exclude body1="Upper_Arm" body2="Wrist_Pitch_Roll" />
    <exclude body1="Upper_Arm" body2="Base" />
    <exclude body1="Moving_Jaw" body2="Wrist_Pitch_Roll" />
    <exclude body1="Base_2" body2="Rotation_Pitch_2" />
    <exclude body1="Rotation_Pitch_2" body2="Upper_Arm_2" />
    <exclude body1="Upper_Arm_2" body2="Lower_Arm_2" />
    <exclude body1="Lower_Arm_2" body2="Wrist_Pitch_Roll_2" />
    <exclude body1="Wrist_Pitch_Roll_2" body2="Fixed_Jaw_2" />
    <exclude body1="Moving_Jaw_2" body2="Fixed_Jaw_2" />
    <exclude body1="Rotation_Pitch_2" body2="Lower_Arm_2" />
    <exclude body1="Rotation_Pitch_2" body2="Wrist_Pitch_Roll_2" />
    <exclude body1="Upper_Arm_2" body2="Wrist_Pitch_Roll_2" />
    <exclude body1="Upper_Arm_2" body2="Base_2" />
    <exclude body1="Moving_Jaw_2" body2="Wrist_Pitch_Roll_2" />
    <exclude body1="Base" body2="Base_2" />
    <exclude body1="chassis" body2="Base_2" />
  </contact>
  <actuator>
    <dcmotor class="pg42_drive" name="rear_left_drive" joint="rear_left_wheel_joint" />
    <dcmotor class="pg42_drive" name="rear_right_drive" joint="rear_right_wheel_joint" />
    <dcmotor class="pg42_drive" name="front_left_drive" joint="front_left_wheel_joint" />
    <dcmotor class="pg42_drive" name="front_right_drive" joint="front_right_wheel_joint" />
    <position class="sts3215" name="right_shoulder_yaw_joint" joint="right_shoulder_yaw_joint" ctrlrange="-2.16 2.16" />
    <position class="sts3250" name="right_shoulder_pitch_joint" joint="right_shoulder_pitch_joint" ctrlrange="-0.22 3.37" />
    <position class="sts3250" name="right_elbow_pitch_joint" joint="right_elbow_pitch_joint" ctrlrange="-0.22 3.14" />
    <position class="sts3215" name="right_wrist_pitch_joint" joint="right_wrist_pitch_joint" ctrlrange="-1.65806 1.65806" />
    <position class="sts3215" name="right_wrist_roll_joint" joint="right_wrist_roll_joint" ctrlrange="-2.74385 2.84121" />
    <position class="sts3215" name="right_gripper_joint" joint="right_gripper_joint" ctrlrange="-0.37453 1.74533" />
    <position class="sts3215" name="left_shoulder_yaw_joint" joint="left_shoulder_yaw_joint" ctrlrange="-2.16 2.16" />
    <position class="sts3250" name="left_shoulder_pitch_joint" joint="left_shoulder_pitch_joint" ctrlrange="-0.22 3.37" />
    <position class="sts3250" name="left_elbow_pitch_joint" joint="left_elbow_pitch_joint" ctrlrange="-0.22 3.14" />
    <position class="sts3215" name="left_wrist_pitch_joint" joint="left_wrist_pitch_joint" ctrlrange="-1.65806 1.65806" />
    <position class="sts3215" name="left_wrist_roll_joint" joint="left_wrist_roll_joint" ctrlrange="-2.74385 2.84121" />
    <position class="sts3215" name="left_gripper_joint" joint="left_gripper_joint" ctrlrange="-0.37453 1.74533" />
    <position class="sts3215" name="head_pan" joint="head_pan_joint" ctrlrange="-3.2 3.2" />
    <position class="sts3215" name="head_tilt" joint="head_tilt_joint" ctrlrange="-0.76 1.45" />
  </actuator>
</mujoco>
