asm17-moving-agent/cleany/ros2_ws/src/cleany_description/urdf/cleany_freecad_kinematic.urdf

<?xml version='1.0' encoding='utf-8'?>
<robot name="cleany_freecad_delta_preview">
  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
  <link name="base_link">
    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
  </link>
  <link name="cad_right_shoulder_yaw">
    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
  </link>
  <joint name="cad_delta_right_shoulder_yaw" type="continuous">
    <parent link="base_link" />
    <child link="cad_right_shoulder_yaw" />
    <origin xyz="0.12 -0.196204398797 0.394000000404" rpy="0 0 0" />
    <axis xyz="0 0 1" />
  </joint>
  <link name="cad_right_shoulder_pitch">
    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
  </link>
  <joint name="cad_delta_right_shoulder_pitch" type="continuous">
    <parent link="cad_right_shoulder_yaw" />
    <child link="cad_right_shoulder_pitch" />
    <origin xyz="-0.0163 -0.0306 0.0561" rpy="0 0 0" />
    <axis xyz="1 -0 -0" />
  </joint>
  <link name="cad_right_elbow_pitch">
    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
  </link>
  <joint name="cad_delta_right_elbow_pitch" type="continuous">
    <parent link="cad_right_shoulder_pitch" />
    <child link="cad_right_elbow_pitch" />
    <origin xyz="-2.77555756156e-17 0.162520883198 0.028283695386" rpy="0 0 0" />
    <axis xyz="1 -0 -0" />
  </joint>
  <link name="cad_right_wrist_pitch">
    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
  </link>
  <joint name="cad_delta_right_wrist_pitch" type="continuous">
    <parent link="cad_right_elbow_pitch" />
    <child link="cad_right_wrist_pitch" />
    <origin xyz="0.0001 -0.1849 0.0052" rpy="0 0 0" />
    <axis xyz="1 -0 -0" />
  </joint>
  <link name="cad_right_wrist_roll">
    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
  </link>
  <joint name="cad_delta_right_wrist_roll" type="continuous">
    <parent link="cad_right_wrist_pitch" />
    <child link="cad_right_wrist_roll" />
    <origin xyz="0.0177272065666 -0.05965 0" rpy="0 0 0" />
    <axis xyz="0 1 0" />
  </joint>
  <link name="cad_left_shoulder_yaw">
    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
  </link>
  <joint name="cad_delta_left_shoulder_yaw" type="continuous">
    <parent link="base_link" />
    <child link="cad_left_shoulder_yaw" />
    <origin xyz="0.12 0.196204398797 0.394000000404" rpy="0 0 0" />
    <axis xyz="0 0 1" />
  </joint>
  <link name="cad_left_shoulder_pitch">
    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
  </link>
  <joint name="cad_delta_left_shoulder_pitch" type="continuous">
    <parent link="cad_left_shoulder_yaw" />
    <child link="cad_left_shoulder_pitch" />
    <origin xyz="0.0163 0.0306 0.0561" rpy="0 0 0" />
    <axis xyz="1 -0 -0" />
  </joint>
  <link name="cad_left_elbow_pitch">
    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
  </link>
  <joint name="cad_delta_left_elbow_pitch" type="continuous">
    <parent link="cad_left_shoulder_pitch" />
    <child link="cad_left_elbow_pitch" />
    <origin xyz="-2.77555756156e-17 -0.162520883198 0.028283695386" rpy="0 0 0" />
    <axis xyz="1 -0 -0" />
  </joint>
  <link name="cad_left_wrist_pitch">
    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
  </link>
  <joint name="cad_delta_left_wrist_pitch" type="continuous">
    <parent link="cad_left_elbow_pitch" />
    <child link="cad_left_wrist_pitch" />
    <origin xyz="-0.0001 0.1849 0.0052" rpy="0 0 0" />
    <axis xyz="1 -0 -0" />
  </joint>
  <link name="cad_left_wrist_roll">
    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
  </link>
  <joint name="cad_delta_left_wrist_roll" type="continuous">
    <parent link="cad_left_wrist_pitch" />
    <child link="cad_left_wrist_roll" />
    <origin xyz="-0.0177272065666 0.05965 0" rpy="0 0 0" />
    <axis xyz="0 1 0" />
  </joint>
  <link name="cad_head_pan">
    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
  </link>
  <joint name="cad_delta_head_pan" type="continuous">
    <parent link="base_link" />
    <child link="cad_head_pan" />
    <origin xyz="0.0874177404373 -7.4623620002e-06 0.679611523562" rpy="0 0 0" />
    <axis xyz="0 0 1" />
  </joint>
  <link name="cad_head_tilt">
    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
  </link>
  <joint name="cad_delta_head_tilt" type="continuous">
    <parent link="cad_head_pan" />
    <child link="cad_head_tilt" />
    <origin xyz="1.00000000006e-05 -0.0173 0.025275" rpy="0 0 0" />
    <axis xyz="0 1 0" />
  </joint>
  <link name="cad_front_right_wheel">
    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
  </link>
  <joint name="cad_delta_front_right_wheel" type="continuous">
    <parent link="base_link" />
    <child link="cad_front_right_wheel" />
    <origin xyz="0.174999362289 -0.301900803502 -0.3164999925" rpy="0 0 0" />
    <axis xyz="3.67320510259e-06 0.999999999993 7.3382039216e-09" />
  </joint>
  <link name="cad_front_left_wheel">
    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
  </link>
  <joint name="cad_delta_front_left_wheel" type="continuous">
    <parent link="base_link" />
    <child link="cad_front_left_wheel" />
    <origin xyz="0.175001580171 0.301899196494 -0.316499988069" rpy="0 0 0" />
    <axis xyz="3.67320510259e-06 0.999999999993 7.3382039216e-09" />
  </joint>
  <link name="cad_rear_right_wheel">
    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
  </link>
  <joint name="cad_delta_rear_right_wheel" type="continuous">
    <parent link="base_link" />
    <child link="cad_rear_right_wheel" />
    <origin xyz="-0.175000637708 -0.301899517881 -0.316500011931" rpy="0 0 0" />
    <axis xyz="3.67320510259e-06 0.999999999993 7.3382039216e-09" />
  </joint>
  <link name="cad_rear_left_wheel">
    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
  </link>
  <joint name="cad_delta_rear_left_wheel" type="continuous">
    <parent link="base_link" />
    <child link="cad_rear_left_wheel" />
    <origin xyz="-0.174998419827 0.301900482115 -0.3165000075" rpy="0 0 0" />
    <axis xyz="3.67320510259e-06 0.999999999993 7.3382039216e-09" />
  </joint>
  <link name="cad_right_gripper_cam">
    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
  </link>
  <joint name="cad_delta_right_gripper_cam" type="continuous">
    <parent link="cad_right_wrist_roll" />
    <child link="cad_right_gripper_cam" />
    <origin xyz="1.38777878078e-17 -0.0464665820841 0.000875" rpy="0 0 0" />
    <axis xyz="0 0 1" />
  </joint>
  <link name="cad_right_gripper_internal_L">
    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
  </link>
  <joint name="cad_delta_right_gripper_internal_L" type="continuous">
    <parent link="cad_right_wrist_roll" />
    <child link="cad_right_gripper_internal_L" />
    <origin xyz="-0.0325 -0.0645089838486 0.000875" rpy="0 0 0" />
    <axis xyz="0 0 1" />
  </joint>
  <link name="cad_right_gripper_external_L">
    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
  </link>
  <joint name="cad_delta_right_gripper_external_L" type="continuous">
    <parent link="cad_right_wrist_roll" />
    <child link="cad_right_gripper_external_L" />
    <origin xyz="-0.044 -0.0645089838486 0.000875" rpy="0 0 0" />
    <axis xyz="0 0 1" />
  </joint>
  <link name="cad_right_gripper_driving_L">
    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
  </link>
  <joint name="cad_delta_right_gripper_driving_L" type="continuous">
    <parent link="cad_right_gripper_cam" />
    <child link="cad_right_gripper_driving_L" />
    <origin xyz="-0.0104142469388 0.00354167484358 0" rpy="0 0 0" />
    <axis xyz="0 0 1" />
  </joint>
  <link name="cad_right_gripper_distal_L">
    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
  </link>
  <joint name="cad_delta_right_gripper_distal_L" type="continuous">
    <parent link="cad_right_gripper_internal_L" />
    <child link="cad_right_gripper_distal_L" />
    <origin xyz="0.02 -0.0346410161514 0" rpy="0 0 0" />
    <axis xyz="0 0 1" />
  </joint>
  <link name="cad_right_gripper_internal_R">
    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
  </link>
  <joint name="cad_delta_right_gripper_internal_R" type="continuous">
    <parent link="cad_right_wrist_roll" />
    <child link="cad_right_gripper_internal_R" />
    <origin xyz="0.0325 -0.0645089838486 0.000875" rpy="0 0 0" />
    <axis xyz="0 0 1" />
  </joint>
  <link name="cad_right_gripper_external_R">
    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
  </link>
  <joint name="cad_delta_right_gripper_external_R" type="continuous">
    <parent link="cad_right_wrist_roll" />
    <child link="cad_right_gripper_external_R" />
    <origin xyz="0.044 -0.0645089838486 0.000875" rpy="0 0 0" />
    <axis xyz="0 0 1" />
  </joint>
  <link name="cad_right_gripper_driving_R">
    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
  </link>
  <joint name="cad_delta_right_gripper_driving_R" type="continuous">
    <parent link="cad_right_gripper_cam" />
    <child link="cad_right_gripper_driving_R" />
    <origin xyz="0.0104930704133 -0.00330082918391 0" rpy="0 0 0" />
    <axis xyz="0 0 1" />
  </joint>
  <link name="cad_right_gripper_distal_R">
    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
  </link>
  <joint name="cad_delta_right_gripper_distal_R" type="continuous">
    <parent link="cad_right_gripper_internal_R" />
    <child link="cad_right_gripper_distal_R" />
    <origin xyz="-0.02 -0.0346410161514 0" rpy="0 0 0" />
    <axis xyz="0 0 1" />
  </joint>
  <link name="cad_left_gripper_cam">
    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
  </link>
  <joint name="cad_delta_left_gripper_cam" type="continuous">
    <parent link="cad_left_wrist_roll" />
    <child link="cad_left_gripper_cam" />
    <origin xyz="1.38777878078e-17 0.0464665820841 0.000875" rpy="0 0 0" />
    <axis xyz="0 0 1" />
  </joint>
  <link name="cad_left_gripper_internal_L">
    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
  </link>
  <joint name="cad_delta_left_gripper_internal_L" type="continuous">
    <parent link="cad_left_wrist_roll" />
    <child link="cad_left_gripper_internal_L" />
    <origin xyz="0.0325 0.0645089838486 0.000875" rpy="0 0 0" />
    <axis xyz="0 0 1" />
  </joint>
  <link name="cad_left_gripper_external_L">
    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
  </link>
  <joint name="cad_delta_left_gripper_external_L" type="continuous">
    <parent link="cad_left_wrist_roll" />
    <child link="cad_left_gripper_external_L" />
    <origin xyz="0.044 0.0645089838486 0.000875" rpy="0 0 0" />
    <axis xyz="0 0 1" />
  </joint>
  <link name="cad_left_gripper_driving_L">
    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
  </link>
  <joint name="cad_delta_left_gripper_driving_L" type="continuous">
    <parent link="cad_left_gripper_cam" />
    <child link="cad_left_gripper_driving_L" />
    <origin xyz="0.0104142469388 -0.00354167484358 0" rpy="0 0 0" />
    <axis xyz="0 0 1" />
  </joint>
  <link name="cad_left_gripper_distal_L">
    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
  </link>
  <joint name="cad_delta_left_gripper_distal_L" type="continuous">
    <parent link="cad_left_gripper_internal_L" />
    <child link="cad_left_gripper_distal_L" />
    <origin xyz="-0.02 0.0346410161514 0" rpy="0 0 0" />
    <axis xyz="0 0 1" />
  </joint>
  <link name="cad_left_gripper_internal_R">
    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
  </link>
  <joint name="cad_delta_left_gripper_internal_R" type="continuous">
    <parent link="cad_left_wrist_roll" />
    <child link="cad_left_gripper_internal_R" />
    <origin xyz="-0.0325 0.0645089838486 0.000875" rpy="0 0 0" />
    <axis xyz="0 0 1" />
  </joint>
  <link name="cad_left_gripper_external_R">
    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
  </link>
  <joint name="cad_delta_left_gripper_external_R" type="continuous">
    <parent link="cad_left_wrist_roll" />
    <child link="cad_left_gripper_external_R" />
    <origin xyz="-0.044 0.0645089838486 0.000875" rpy="0 0 0" />
    <axis xyz="0 0 1" />
  </joint>
  <link name="cad_left_gripper_driving_R">
    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
  </link>
  <joint name="cad_delta_left_gripper_driving_R" type="continuous">
    <parent link="cad_left_gripper_cam" />
    <child link="cad_left_gripper_driving_R" />
    <origin xyz="-0.0104930704133 0.00330082918391 0" rpy="0 0 0" />
    <axis xyz="0 0 1" />
  </joint>
  <link name="cad_left_gripper_distal_R">
    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
  </link>
  <joint name="cad_delta_left_gripper_distal_R" type="continuous">
    <parent link="cad_left_gripper_internal_R" />
    <child link="cad_left_gripper_distal_R" />
    <origin xyz="0.02 0.0346410161514 0" rpy="0 0 0" />
    <axis xyz="0 0 1" />
  </joint>
  <link name="cad_right_gripper_tip_L">
    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
  </link>
  <joint name="cad_fixed_right_gripper_tip_L" type="fixed">
    <parent link="cad_right_gripper_distal_L" />
    <child link="cad_right_gripper_tip_L" />
    <origin xyz="-0.00225 -0.00825 -0.000875" rpy="0 0 0" />
  </joint>
  <link name="cad_right_gripper_tip_R">
    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
  </link>
  <joint name="cad_fixed_right_gripper_tip_R" type="fixed">
    <parent link="cad_right_gripper_distal_R" />
    <child link="cad_right_gripper_tip_R" />
    <origin xyz="0.00225 -0.00825 -0.000875" rpy="0 0 0" />
  </joint>
  <link name="cad_left_gripper_tip_L">
    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
  </link>
  <joint name="cad_fixed_left_gripper_tip_L" type="fixed">
    <parent link="cad_left_gripper_distal_L" />
    <child link="cad_left_gripper_tip_L" />
    <origin xyz="0.00225 0.00825 -0.000875" rpy="0 0 0" />
  </joint>
  <link name="cad_left_gripper_tip_R">
    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
  </link>
  <joint name="cad_fixed_left_gripper_tip_R" type="fixed">
    <parent link="cad_left_gripper_distal_R" />
    <child link="cad_left_gripper_tip_R" />
    <origin xyz="-0.00225 0.00825 -0.000875" rpy="0 0 0" />
  </joint>
</robot>
