asm17-moving-agent/cleany/esp32/pcb/motor_controller.kicad_pcb

## KiCad design esp32/pcb/motor_controller.kicad_pcb (2026-09-08)

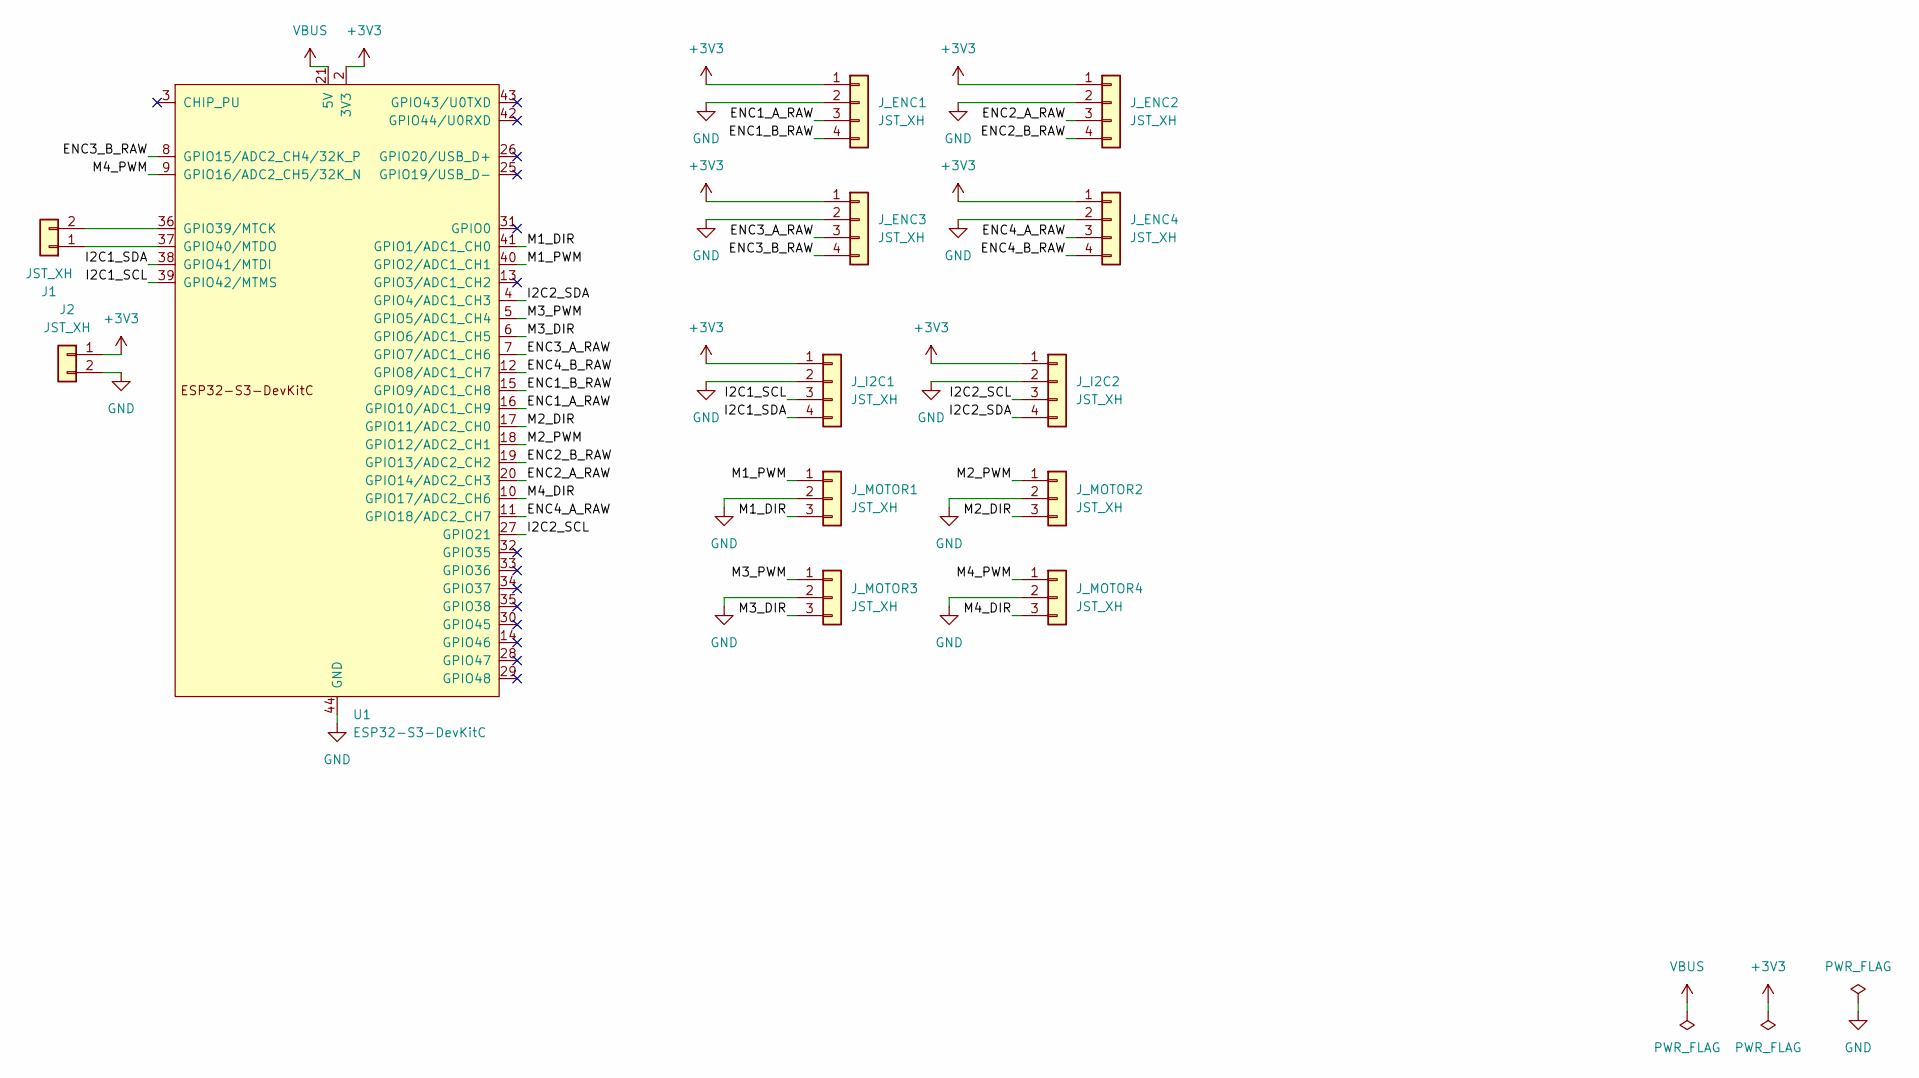
[picture p100: schematic motor_controller.kicad_sch]

Parts:
J1, J2: JST_XH; JST_XH_S2B-XH-A_1x02_P2.50mm_Horizontal
J_ENC1, J_ENC2, J_ENC3, J_ENC4: JST_XH; JST_XH_S4B-XH-A_1x04_P2.50mm_Horizontal
J_I2C1, J_I2C2: JST_XH; JST_XH_S4B-XH-A_1x04_P2.50mm_Horizontal
J_MOTOR1, J_MOTOR2, J_MOTOR3, J_MOTOR4: JST_XH; JST_XH_S3B-XH-A_1x03_P2.50mm_Horizontal
U1: ESP32-S3-DevKitC

Connections:
+3V3: J2.1, J_ENC1.1, J_ENC2.1, J_ENC3.1, J_ENC4.1, J_I2C1.1, J_I2C2.1, U1.1 (3V3), U1.2 (3V3)
/ENC1_A_RAW: J_ENC1.3, U1.16 (GPIO10/ADC1_CH9)
/ENC1_B_RAW: J_ENC1.4, U1.15 (GPIO9/ADC1_CH8)
/ENC2_A_RAW: J_ENC2.3, U1.20 (GPIO14/ADC2_CH3)
/ENC2_B_RAW: J_ENC2.4, U1.19 (GPIO13/ADC2_CH2)
/ENC3_A_RAW: J_ENC3.3, U1.7 (GPIO7/ADC1_CH6)
/ENC3_B_RAW: J_ENC3.4, U1.8 (GPIO15/ADC2_CH4/32K_P)
/ENC4_A_RAW: J_ENC4.3, U1.11 (GPIO18/ADC2_CH7)
/ENC4_B_RAW: J_ENC4.4, U1.12 (GPIO8/ADC1_CH7)
/I2C1_SCL: J_I2C1.3, U1.39 (GPIO42/MTMS)
/I2C1_SDA: J_I2C1.4, U1.38 (GPIO41/MTDI)
/I2C2_SCL: J_I2C2.3, U1.27 (GPIO21)
/I2C2_SDA: J_I2C2.4, U1.4 (GPIO4/ADC1_CH3)
/M1_DIR: J_MOTOR1.3, U1.41 (GPIO1/ADC1_CH0)
/M1_PWM: J_MOTOR1.1, U1.40 (GPIO2/ADC1_CH1)
/M2_DIR: J_MOTOR2.3, U1.17 (GPIO11/ADC2_CH0)
/M2_PWM: J_MOTOR2.1, U1.18 (GPIO12/ADC2_CH1)
/M3_DIR: J_MOTOR3.3, U1.6 (GPIO6/ADC1_CH5)
/M3_PWM: J_MOTOR3.1, U1.5 (GPIO5/ADC1_CH4)
/M4_DIR: J_MOTOR4.3, U1.10 (GPIO17/ADC2_CH6)
/M4_PWM: J_MOTOR4.1, U1.9 (GPIO16/ADC2_CH5/32K_N)
GND: J2.2, J_ENC1.2, J_ENC2.2, J_ENC3.2, J_ENC4.2, J_I2C1.2, J_I2C2.2, J_MOTOR1.2, J_MOTOR2.2, J_MOTOR3.2, J_MOTOR4.2, U1.22 (GND), U1.23 (GND), U1.24 (GND), U1.44 (GND)
unnamed: J1.1, U1.37 (GPIO40/MTDO)
unnamed: J1.2, U1.36 (GPIO39/MTCK)
VBUS: U1.21 (5V)

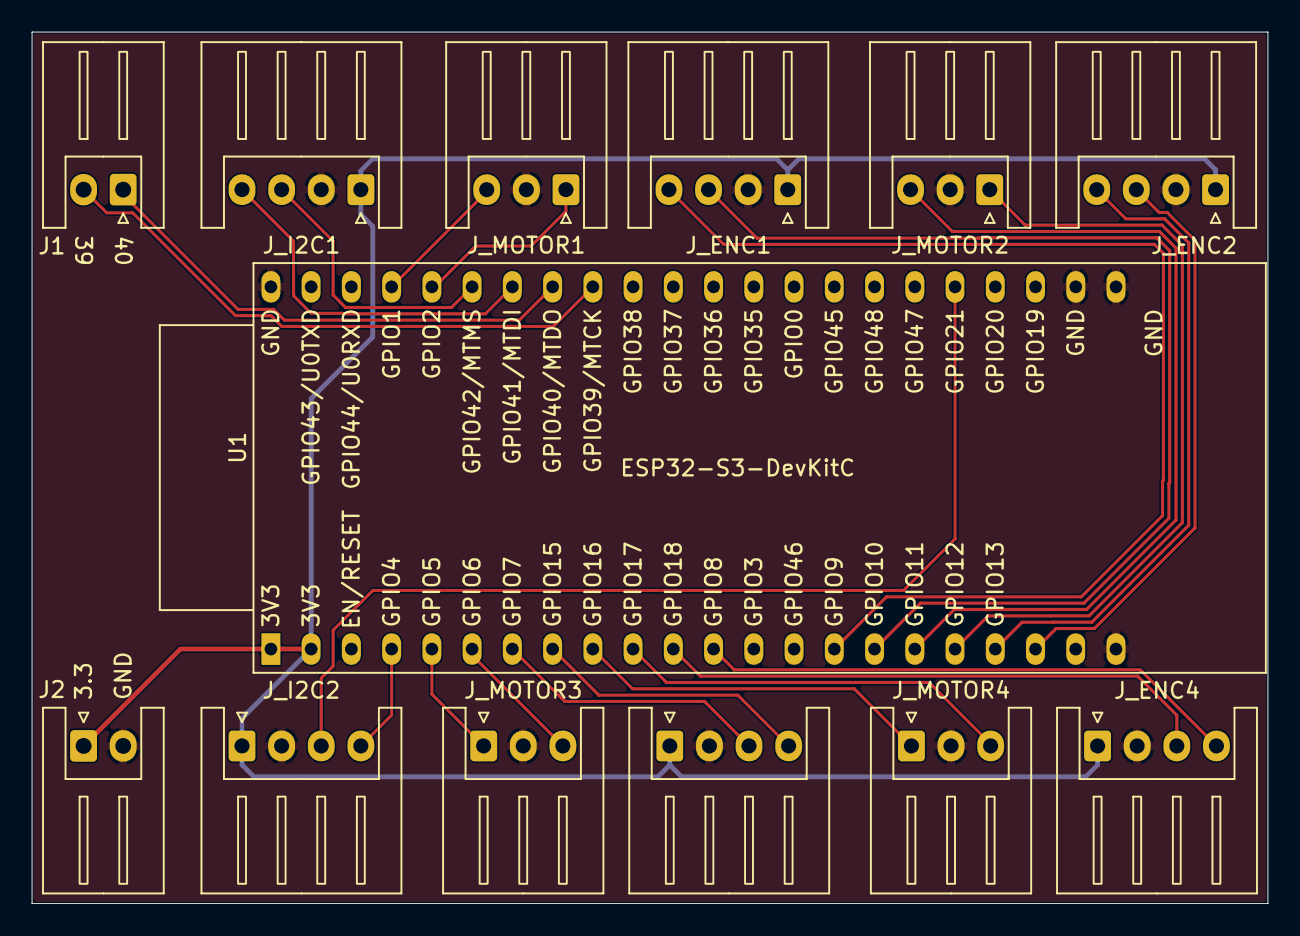
[picture p101: board motor_controller.kicad_pcb from above]

Board: 2 copper layers, 78.0 x 55.0 mm, 13 parts (0 on the bottom side), 24 nets.
