asm17-moving-agent/cleany/ros2_ws/src/cleany_dev_monitor/config/monitor.yaml

cleany_dev_monitor:
  ros__parameters:
    host: 127.0.0.1
    port: 8768
    runtime_namespace: ""
    runtime_debug_topic: ""
    runtime_events_topic: ""
    runtime_result_topic: ""
    rosout_topic: /rosout
    clock_topic: /clock
    manipulation_events_topic: mock/manipulation/execution_events
    map_frame: map
    base_frame: base_link
    map_topic: /map
    slam_submaps_topic: /submap_list
    slam_trajectory_topic: /trajectory_node_list
    slam_constraints_topic: /constraint_list
    slam_matched_points_topic: /scan_matched_points2
    slam_submap_query_service: /submap_query
    slam_submap_limit: 64
    slam_texture_pixel_limit: 262144
    slam_texture_cache_bytes: 16777216
    slam_marker_point_limit: 4096
    slam_query_timeout_s: 2.0
    slam_adjustment_m: 0.05
    slam_adjustment_rad: 0.02
    path_topic: /plan
    local_costmap_topic: /local_costmap/costmap
    global_costmap_topic: /global_costmap/costmap
    velocity_topics: [/nav2/cmd_vel, /safety_2d/cmd_vel, /cmd_vel]
    odometry_topic: /wheel/odom
    ground_truth_topic: /ground_truth/odom
    amcl_pose_topic: /amcl_pose
    pan_state_topic: /head_pan/state
    reactive_guard_topic: /reactive_guard/state
    voxel_guard_topic: /body_guard_3d/state
    collision_state_topic: /collision_monitor_state
    coverage_topic: /head_pan/coverage
    nav2_bt_trace_topic: /navigation/bt_trace
    nav2_bt_topic: /behavior_tree_log
    controller_evaluation_topic: /evaluation
    scan_topic: /scan
    depth_points_topic: /camera/head/depth/obstacle_points
    risk_points_topic: /body_guard_3d/risk_voxels
    footprint_topic: /local_costmap/published_footprint
    stop_polygon_topic: /safety/stop_zone
    slow_polygon_topic: /safety/slow_zone
    local_path_topic: /local_plan
    obstacle_memory_topic: /obstacle_memory/grid
    lidar_memory_topic: /obstacle_memory/lidar
    depth_memory_topic: /obstacle_memory/depth
    navigation_freshness_s: 0.75
    stationary_speed_mps: 0.005
    creep_speed_mps: 0.03
    navigation_point_limit: 512
    run_label: ""
    source_revision: ""
    requested_rtf: 0.0
    max_grid_cells: 524288
    bt_event_repeat_interval_s: 1.0
    max_selected_topics: 16
    camera_max_streams: 2
    camera_fps: 5.0
    state_directory: ~/.local/state/cleany/dev-monitor
    session_limit_bytes: 104857600
    total_limit_bytes: 1073741824
    resource_interval_s: 1.0
    resource_process_limit: 20
    resource_history_limit: 300
