asm17-moving-agent/cleany/ros2_ws/src/cleany_skill_executor/config/grasp_selection.yaml

grasp_selection_server:
  ros__parameters:
    action_name: grasp/select_reachable
    joint_state_topic: joint_states
    planning_frame: base_link
    joint_state_max_age_sec: 0.5
    ik_timeout_sec: 0.15
    state_validity_timeout_sec: 1.0
    planning_timeout_sec: 4.0
    planning_attempts: 1
    velocity_scaling: 0.1
    acceleration_scaling: 0.1
    maximum_candidates: 12
    action_timeout_sec: 120.0
    pregrasp_offset_m: 0.08
