asm17-moving-agent/cleany/ros2_ws/src/cleany_logger/cleany_logger/observer.py

"""ROS reader. Subscriptions, TF lookups and the allowlisted read-only SubmapQuery."""

import json
import math
import struct
import os
import time
from collections import deque

import rclpy
from rclpy.callback_groups import MutuallyExclusiveCallbackGroup
from rclpy.serialization import serialize_message
from rclpy.action import (
    get_action_client_names_and_types_by_node,
    get_action_names_and_types,
    get_action_server_names_and_types_by_node,
)
from rclpy.clock import Clock, ClockType
from rclpy.node import Node
from rclpy.qos import (
    DurabilityPolicy,
    QoSCompatibility,
    QoSProfile,
    ReliabilityPolicy,
    qos_check_compatible,
)
from rclpy.time import Time
from rosidl_runtime_py.utilities import get_message
from tf2_ros import Buffer, TransformException, TransformListener

from .observation import ObservationBuffer, grid_origin, preview, transform_point, yaw
from .routes import routes, resolved, SCHEMA, source_roles
from .navigation import NavigationObserver, cloud_points, transform_xyz, vector
from .manipulation import ManipulationObserver


IMAGE_TYPES = {"sensor_msgs/msg/Image", "sensor_msgs/msg/CompressedImage"}

class NoSlam:
    topics = set()
    def __init__(self, node): pass
    def tick(self): pass
    def reset(self): pass
    def close(self): pass


class ObservationNode(Node):
    """Bounded ROS observations shared by headless logging and live display.

    Reads configured sensor and runtime topics, TF and graph metadata. Adapters
    can add camera previews or read-only SLAM queries without entering the logger.
    """
    def __init__(self, *, node_name="cleany_observer", hub_factory=ObservationBuffer,
                 slam_factory=None, record=True, extra_defaults=None, **kwargs):
        super().__init__(node_name, **kwargs)
        self.recording_enabled = record
        defaults = {
            "resource_interval_s": 1.0,
            "resource_process_limit": 20,
            "resource_history_limit": 300,
            "host": "127.0.0.1",
            "port": 8768,
            "state_directory": "~/.local/state/cleany/recordings",
            "runtime_namespace": "",
            "runtime_debug_topic": "",
            "runtime_events_topic": "",
            "runtime_result_topic": "",
            "rosout_topic": "/rosout",
            "clock_topic": "/clock",
            "manipulation_events_topic": "mock/manipulation/execution_events",
            "manipulation_observation_mode": "mission",
            "manipulation_execution_limit": 20,
            "manipulation_interval_limit": 64,
            "map_frame": "map",
            "base_frame": "base_link",
            "map_topic": "/map",
            "slam_submaps_topic": "/submap_list",
            "slam_trajectory_topic": "/trajectory_node_list",
            "slam_constraints_topic": "/constraint_list",
            "slam_matched_points_topic": "/scan_matched_points2",
            "slam_submap_query_service": "/submap_query",
            "slam_submap_limit": 64,
            "slam_texture_pixel_limit": 262144,
            "slam_texture_cache_bytes": 16777216,
            "slam_marker_point_limit": 4096,
            "slam_query_timeout_s": 2.0,
            "slam_adjustment_m": .05,
            "slam_adjustment_rad": .02,
            "path_topic": "/plan",
            "local_costmap_topic": "/local_costmap/costmap",
            "global_costmap_topic": "/global_costmap/costmap",
            "velocity_topics": ["/nav2/cmd_vel", "/safety_2d/cmd_vel", "/cmd_vel"],
            "odometry_topic": "/wheel/odom",
            "ground_truth_topic": "/ground_truth/odom",
            "amcl_pose_topic": "/amcl_pose",
            "pan_state_topic": "/head_pan/state",
            "reactive_guard_topic": "/reactive_guard/state",
            "voxel_guard_topic": "/body_guard_3d/state",
            "collision_state_topic": "/collision_monitor_state",
            "coverage_topic": "/head_pan/coverage",
            "nav2_bt_topic": "/behavior_tree_log",
            "nav2_bt_trace_topic": "/navigation/bt_trace",
            "controller_evaluation_topic": "/evaluation",
            "scan_topic": "/scan",
            "depth_points_topic": "/camera/head/depth/obstacle_points",
            "risk_points_topic": "/body_guard_3d/risk_voxels",
            "footprint_topic": "/local_costmap/published_footprint",
            "stop_polygon_topic": "/safety/stop_zone",
            "slow_polygon_topic": "/safety/slow_zone",
            "local_path_topic": "/local_plan",
            "obstacle_memory_topic": "/obstacle_memory/grid",
            "lidar_memory_topic": "/obstacle_memory/lidar",
            "depth_memory_topic": "/obstacle_memory/depth",
            "navigation_freshness_s": .75,
            "stationary_speed_mps": .005,
            "creep_speed_mps": .03,
            "navigation_point_limit": 512,
            "run_label": "",
            "source_revision": "",
            "requested_rtf": 0.,
            "max_grid_cells": 524288,
            "bt_event_repeat_interval_s": 1.0,
            "max_selected_topics": 16,
            "camera_max_streams": 2,
            "camera_fps": 5.0,
            "session_limit_bytes": 104857600,
            "total_limit_bytes": 1073741824,
        }
        defaults.update(extra_defaults or {})
        for key, value in defaults.items():
            self.declare_parameter(key, value)
        self.config = {key: self.get_parameter(key).value for key in defaults}
        if self.config['manipulation_observation_mode'] not in ('mission', 'server'):
            raise ValueError('manipulation_observation_mode must be mission or server')
        if (not 16 <= self.config["navigation_point_limit"] <= 2048
                or not 0 < self.config["navigation_freshness_s"] <= 5
                or not .1 <= self.config["bt_event_repeat_interval_s"] <= 10
                or not 0 <= self.config["stationary_speed_mps"] < self.config["creep_speed_mps"]):
            raise ValueError("Invalid navigation observation limits")
        if (not 1 <= self.config['slam_submap_limit'] <= 128
                or not 1 <= self.config['slam_texture_pixel_limit'] <= 524288
                or not 1048576 <= self.config['slam_texture_cache_bytes'] <= 67108864
                or not 2 <= self.config['slam_marker_point_limit'] <= 8192
                or not .25 <= self.config['slam_query_timeout_s'] <= 10
                or not .001 <= self.config['slam_adjustment_m'] <= 10
                or not .001 <= self.config['slam_adjustment_rad'] <= math.pi):
            raise ValueError('Invalid SLAM observation limits')
        self.config.update(resolved(self.config))
        self.base_config = dict(self.config)
        self.source_settings = {}
        self.topic_revision = 0
        self.navigation = NavigationObserver(self.config["velocity_topics"],
            self.config["navigation_freshness_s"], self.config["stationary_speed_mps"],
            self.config["creep_speed_mps"], self.config["map_frame"])
        self.navigation_keys = {self.config[key+"_topic"]: key for key in (
            "odometry", "ground_truth", "amcl_pose", "reactive_guard",
            "voxel_guard", "coverage", "nav2_bt", "controller_evaluation",
            "scan", "depth_points", "risk_points", "footprint", "stop_polygon", "slow_polygon")}
        self.navigation_keys.update({self.config["pan_state_topic"]: "pan",
                                     self.config["collision_state_topic"]: "collision"})
        self.navigation_previous = {}
        self.manipulation = ManipulationObserver(self.config["manipulation_execution_limit"],
                                                self.config["manipulation_interval_limit"])
        self.bt_event_received = {}
        self.bt_event_repeated = {}
        self.runtime_data = {}
        self.runtime_received = 0.
        if not 1 <= self.config["max_selected_topics"] <= 64:
            raise ValueError("max_selected_topics must be 1..64")
        if not 1 <= self.config["max_grid_cells"] <= 1048576:
            raise ValueError("max_grid_cells must be 1..1048576")
        if (
            not 1 <= self.config["camera_max_streams"] <= 4
            or not 1 <= self.config["camera_fps"] <= 10
        ):
            raise ValueError("Camera limits: streams 1..4, fps 1..10")
        self.hub = hub_factory()
        if not record:
            self.hub.recording.configure({**self.hub.recording.settings, "active": False})
        self.hub.cameras.limit = self.config["camera_max_streams"]
        self.hub.cameras.fps = self.config["camera_fps"]
        self.buffer = Buffer()
        self.listener = TransformListener(self.buffer, self)
        self.config, self.fixed, self.layers, self.navigation_keys = routes(self.config)
        self.manipulation_events = self.config['manipulation_events_topic']
        self.hub.source_roles = source_roles(self.config)
        self.hub.source_categories = {topic: SCHEMA[key]['group'] for key, value in resolved(self.config).items() for topic in (value if isinstance(value, list) else [value])}
        self.slam_factory = slam_factory or NoSlam
        self.slam = self.slam_factory(self)
        self.subs, self.rates, self.last_ui, self.errors = {}, {}, {}, {}
        self.last_clock = None
        self.last_clock_changed = time.monotonic()
        self.runtime_boot = None
        self.runtime_seq = None
        self.hub.put(
            "config",
            "monitor",
            {
                **self.config,
                "domain": os.environ.get("ROS_DOMAIN_ID", "0"),
                "namespace": self.get_namespace(),
                "read_only": True,
            },
        )
        steady = Clock(clock_type=ClockType.STEADY_TIME)
        self.create_timer(.25, lambda: self.slam.tick(), clock=steady)
        self.create_timer(1.0, self.discover, clock=steady)
        self.create_timer(0.1, self.pose, clock=steady)
        self.create_timer(0.2, self.navigation_tick, clock=steady)

    def apply_sources(self):
        if not self.recording_enabled:
            return
        sources = self.hub.recording.view()['settings']['sources']
        if sources == self.source_settings:
            return
        self.source_settings = dict(sources)
        if resolved({**self.base_config, **sources}) == resolved(self.config):
            return
        self.last_clock = None
        self.last_clock_changed = time.monotonic()
        self.topic_revision += 1
        self.config, self.fixed, self.layers, self.navigation_keys = routes({**self.base_config, **sources})
        self.manipulation_events = self.config['manipulation_events_topic']
        for subscription, _ in self.subs.values():
            self.destroy_subscription(subscription)
        self.subs.clear()
        self.rates.clear()
        self.last_ui.clear()
        self.errors.clear()
        self.runtime_data, self.runtime_received = {}, 0.
        self.runtime_boot, self.runtime_seq = None, None
        self.manipulation = ManipulationObserver(self.config['manipulation_execution_limit'],
                                                self.config['manipulation_interval_limit'])
        self.navigation_previous.clear()
        self.bt_event_received.clear()
        self.bt_event_repeated.clear()
        self.navigation = NavigationObserver(self.config['velocity_topics'], self.config['navigation_freshness_s'], self.config['stationary_speed_mps'], self.config['creep_speed_mps'], self.config['map_frame'])
        self.slam.close()
        self.slam = self.slam_factory(self)
        self.hub.reset_sources(self.config, self.topic_revision)
        self.hub.put('event', 'observation_sources', {'kind': 'observation_sources_changed', 'topic_revision': self.topic_revision}, critical=True)

    def camera_preview_supported(self, topic: str) -> bool:
        """Allow display adapters to report preview support without owning recording."""
        return True

    def discover(self):
        self.apply_sources()
        graph = {
            "topics": [],
            "nodes": [],
            "actions": [],
            "services": self.get_service_names_and_types(),
        }
        topics = dict(self.get_topic_names_and_types())
        selected = self.hub.selections()
        self.hub.recording.discover(topics)
        revision = self.hub.recording.revision
        if revision != getattr(self, 'raw_recording_revision', None):
            # Re-request every publisher's retained sample for a fresh session,
            # including /tf_static even when another observer keeps it selected.
            for name in self.hub.recording.topics():
                if name in self.subs and self.subs[name][1][2]:
                    self.destroy_subscription(self.subs.pop(name)[0])
            self.raw_recording_revision = revision
        wanted = self.fixed | selected | self.hub.cameras.selected() | self.hub.recording.topics()
        # Action status/feedback are read-only public topics, not goal/result services.
        wanted.update(
            sorted(
                name
                for name in topics
                if "/_action/" in name and name.endswith(("/status", "/feedback"))
            )[:32]
        )
        for name in list(self.subs):
            if name not in wanted:
                self.destroy_subscription(self.subs.pop(name)[0])
                self.rates.pop(name, None)
                self.errors.pop(name, None)
                self.last_ui.pop(name, None)
                self.hub.forget("sample", name)
                if name in self.navigation_keys:
                    self.hub.forget("navigation", self.navigation_keys[name])
        now = time.monotonic()
        for name, types in topics.items():
            pubs = self.get_publishers_info_by_topic(name)
            subscriptions = self.get_subscriptions_info_by_topic(name)
            endpoints = lambda items: [
                {
                    "node": i.node_namespace.rstrip("/") + "/" + i.node_name,
                    "type": i.topic_type,
                    "qos": {
                        "reliability": i.qos_profile.reliability.name,
                        "durability": i.qos_profile.durability.name,
                        "history": i.qos_profile.history.name,
                        "depth": i.qos_profile.depth,
                    },
                }
                for i in items
            ]
            if name in wanted and pubs:
                reliable = all(
                    i.qos_profile.reliability == ReliabilityPolicy.RELIABLE
                    for i in pubs
                )
                latched = all(
                    i.qos_profile.durability == DurabilityPolicy.TRANSIENT_LOCAL
                    for i in pubs
                )
                qos = QoSProfile(
                    depth=1
                    if any(t in IMAGE_TYPES for t in types)
                    else (2048 if name.endswith("runtime_events")
                          else 100 if name == self.manipulation_events else 5),
                    reliability=ReliabilityPolicy.RELIABLE
                    if reliable
                    else ReliabilityPolicy.BEST_EFFORT,
                    durability=DurabilityPolicy.TRANSIENT_LOCAL
                    if latched
                    else DurabilityPolicy.VOLATILE,
                )
                signature = (tuple(types), reliable, latched)
                if name in self.subs and self.subs[name][1] != signature:
                    self.destroy_subscription(self.subs.pop(name)[0])
                if name not in self.subs:
                    try:
                        if len(types) != 1:
                            raise ValueError("Multiple message types on one topic")
                        for endpoint in pubs:
                            compatibility, reason = qos_check_compatible(
                                endpoint.qos_profile, qos
                            )
                            if compatibility == QoSCompatibility.ERROR:
                                raise ValueError("QoS mismatch: " + reason)
                        cls = get_message(types[0])
                        sub = self.create_subscription(
                            cls,
                            name,
                            lambda msg, topic=name: self.receive(topic, msg),
                            qos,
                            # A queued retired handle must not strand the service callback group.
                            callback_group=MutuallyExclusiveCallbackGroup() if self.recording_enabled else None,
                        )
                        self.subs[name] = (sub, signature)
                        self.errors.pop(name, None)
                    except (
                        ImportError,
                        AttributeError,
                        ValueError,
                        RuntimeError,
                    ) as exc:
                        self.errors[name] = f"{type(exc).__name__}: {exc}"
            times = self.rates.get(name, ())
            recent = [t for t in times if now - t <= 5]
            hz = (
                (len(recent) - 1) / (recent[-1] - recent[0])
                if len(recent) > 1
                else None
            )
            state = (
                "no_publisher"
                if not pubs
                else "error"
                if name in self.errors
                else "unmeasured"
                if name not in self.subs
                else "no_messages"
                if not times
                else "stale"
                if now - times[-1] > 3
                else "receiving"
            )
            graph["topics"].append(
                {
                    "name": name,
                    "types": types,
                    "camera_supported": self.camera_preview_supported(name),
                    "publishers": endpoints(pubs),
                    "subscribers": endpoints(subscriptions),
                    "state": state,
                    "error": self.errors.get(name),
                    "received_hz": hz,
                    "age": now - times[-1] if times else None,
                    "selected": name in selected,
                    "fixed": name in self.fixed,
                }
            )
        for name, namespace in self.get_node_names_and_namespaces():
            try:
                graph["nodes"].append(
                    {
                        "name": namespace.rstrip("/") + "/" + name,
                        "action_clients": get_action_client_names_and_types_by_node(
                            self, name, namespace
                        ),
                        "action_servers": get_action_server_names_and_types_by_node(
                            self, name, namespace
                        ),
                    }
                )
            except RuntimeError as exc:
                graph.setdefault("discovery_errors", []).append(
                    {"node": name, "reason": str(exc)}
                )
        graph["actions"] = get_action_names_and_types(self)
        graph["missing_fixed_topics"] = sorted(self.fixed - topics.keys())
        self.hub.put("graph", "ros", graph)

    def runtime_booted(self, boot_id):
        if self.runtime_boot == boot_id:
            return
        self.hub.put(
            "event",
            "connection",
            {"kind": "runtime_boot", "boot_id": boot_id, "previous_boot": self.runtime_boot},
            critical=True,
        )
        self.runtime_boot, self.runtime_seq = boot_id, None

    def receive(self, topic, message):
        now = time.monotonic()
        self.rates.setdefault(topic, deque(maxlen=1000)).append(now)
        stamp = getattr(getattr(message, "header", None), "stamp", None)
        ros_time = stamp.sec + stamp.nanosec / 1e9 if stamp else None
        try:
            ticket = self.hub.recording.reserve(topic) if self.recording_enabled else None
            if ticket:
                message_type = self.subs[topic][1][0][0]
                signature = self.subs[topic][1]
                self.hub.recording.offer(ticket, topic, message_type, serialize_message(message), ros_time,
                                         timestamp_ns=self.get_clock().now().nanoseconds,
                                         reliable=signature[1], latched=signature[2])
            if hasattr(message, "encoding") or (
                hasattr(message, "format") and hasattr(message, "data")
            ):
                self.hub.cameras.receive(topic, message)
            if topic in self.slam.topics:
                if now-self.last_ui.get(topic, 0) >= .5:
                    self.last_ui[topic] = now
                    self.slam.receive(topic, message, ros_time)
            elif topic == self.config["runtime_debug_topic"]:
                if message.schema_version != 1 or len(message.snapshot_json) > 1048576:
                    raise ValueError("Unsupported/oversized Runtime debug snapshot")
                data = json.loads(message.snapshot_json)
                self.runtime_data, self.runtime_received = data, now
                self.runtime_booted(message.boot_id)
                self.hub.put("runtime", topic, data, ros_time=ros_time)
            elif topic == self.config["runtime_events_topic"]:
                self.runtime_booted(message.boot_id)
                if message.sequence != (self.runtime_seq or 0) + 1:
                    self.hub.put(
                        "event",
                        "gap",
                        {
                            "kind": "runtime_sequence_gap",
                            "expected": (self.runtime_seq or 0) + 1,
                            "received": message.sequence,
                        },
                        critical=True,
                    )
                self.runtime_seq = message.sequence
                event_data = json.loads(message.data_json)
                if event_data.get("module") == "navigation":
                    self.navigation.note(message.kind, event_data, time.time())
                if (message.kind == "action_result" and event_data.get("module") == "navigation"
                        and self.navigation.active
                        and event_data.get("operation_id") == self.navigation.active["operation_id"]):
                    self.navigation.finish(event_data.get("status", "UNKNOWN"), time.time())
                self.hub.put(
                    "event",
                    topic,
                    {
                        "boot_id": message.boot_id,
                        "sequence": message.sequence,
                        "mission_id": message.mission_id,
                        "task_id": message.task_id,
                        "execution_id": message.execution_id,
                        "kind": message.kind,
                        "data": event_data,
                    },
                    critical=True,
                    ros_time=ros_time,
                )
            elif topic == self.manipulation_events:
                record = preview(message)
                self.hub.put(
                    "event",
                    topic,
                    {"kind": "manipulation_record", **record},
                    critical=True,
                    ros_time=ros_time,
                )
                received_at = time.time()
                if self.manipulation.ingest(record, received_at,
                        heartbeat=self.config['manipulation_observation_mode'] == 'server'):
                    self.hub.put("manipulation", "executions",
                                 {**self.manipulation.snapshot(), "topic": topic},
                                 ros_time=ros_time, received_at=received_at)
            elif topic == self.config["runtime_result_topic"]:
                self.hub.put(
                    "result", topic, preview(message), critical=True, ros_time=ros_time
                )
            elif topic == self.config["rosout_topic"]:
                self.hub.put(
                    "log",
                    topic,
                    preview(message),
                    critical=True,
                    ros_time=message.stamp.sec + message.stamp.nanosec / 1e9,
                )
            elif topic == self.config["clock_topic"]:
                value = message.clock.sec + message.clock.nanosec / 1e9
                if self.last_clock is not None and value < self.last_clock:
                    self.slam.reset()
                    self.hub.put(
                        "event",
                        "clock",
                        {"kind": "clock_rewind", "from": self.last_clock, "to": value},
                        critical=True,
                    )
                if value != self.last_clock:
                    self.last_clock_changed = now
                self.last_clock = value
                if now - self.last_ui.get(topic, 0) >= 0.1:
                    self.hub.put(
                        "clock",
                        topic,
                        {"time": value, "unchanged_for": now - self.last_clock_changed},
                    )
                    self.last_ui[topic] = now
            elif topic == self.config["nav2_bt_trace_topic"]:
                if len(message.data.encode()) > 262144:
                    raise ValueError("BT snapshot exceeds observation limit")
                data = json.loads(message.data)
                if data.get("schema") != 1 or not isinstance(data.get("nodes"), list) or len(data["nodes"]) > 256:
                    raise ValueError("Unsupported BT snapshot")
                self.hub.put("nav2_bt_tree", topic, data, ros_time=ros_time)
            elif topic == self.config["nav2_bt_topic"]:
                self.navigation_receive(topic, message, ros_time)
            elif self.navigation_keys.get(topic) in ("pan", "reactive_guard", "voxel_guard", "coverage", "collision"):
                # Detect every decision change before applying the state display cadence.
                publish_state = now - self.last_ui.get(topic, 0) >= 0.1
                self.navigation_receive(topic, message, ros_time, publish_state=publish_state)
                if publish_state:
                    self.last_ui[topic] = now
            elif now - self.last_ui.get(topic, 0) >= (0.5 if topic in self.navigation_keys and self.navigation_keys[topic] in ("scan", "depth_points", "risk_points", "controller_evaluation") else 0.1):
                self.last_ui[topic] = now
                if topic in self.layers:
                    self.layer(topic, message, ros_time)
                else:
                    self.hub.put("sample", topic, preview(message), ros_time=ros_time)
                    if topic in self.config["velocity_topics"]:
                        self.navigation.ingest("cmd:"+topic, {"velocity": vector(message)}, time.time(), now, ros_time)
                    elif topic in self.navigation_keys:
                        self.navigation_receive(topic, message, ros_time)
        except (TypeError, AttributeError, ValueError, OverflowError) as exc:
            self.errors[topic] = f"Decode/transform: {exc}"
        else:
            self.errors.pop(topic, None)

    def transform(self, frame, stamp=None):
        target = self.config["map_frame"]
        if not frame:
            raise ValueError("Empty frame_id")
        if frame == target:
            return [0.0, 0.0, 0.0]
        tf = self.buffer.lookup_transform(
            target, frame, Time.from_msg(stamp) if stamp else Time()
        )
        return [
            tf.transform.translation.x,
            tf.transform.translation.y,
            yaw(tf.transform.rotation),
        ]

    def layer(self, topic, message, ros_time):
        kind = self.layers[topic]
        try:
            transform = self.transform(message.header.frame_id, message.header.stamp)
            if kind in ("path", "local_path"):
                points = []
                for pose in message.poses[:4096]:
                    tf = self.transform(
                        pose.header.frame_id or message.header.frame_id,
                        pose.header.stamp
                        if pose.header.frame_id
                        else message.header.stamp,
                    )
                    points.append(
                        transform_point(pose.pose.position.x, pose.pose.position.y, tf)
                    )
                data = {"points": points, "truncated": len(message.poses) > 4096}
            else:
                info = message.info
                cells = info.width * info.height
                if cells > self.config["max_grid_cells"]:
                    raise ValueError(
                        f"Grid too large: {cells} cells; limit {self.config['max_grid_cells']}"
                    )
                if len(message.data) != cells:
                    raise ValueError("Grid dimensions mismatch")
                data = {
                    "width": info.width,
                    "height": info.height,
                    "resolution": info.resolution,
                    "origin": grid_origin(
                        [
                            info.origin.position.x,
                            info.origin.position.y,
                            yaw(info.origin.orientation),
                        ],
                        transform,
                    ),
                    "cells": list(message.data),
                }
            self.hub.put(
                "layer",
                kind,
                {
                    **data,
                    "frame": self.config["map_frame"],
                    "source_frame": message.header.frame_id,
                    "valid": True,
                    "topic": topic,
                },
                ros_time=ros_time,
            )

        except (TransformException, ValueError, TypeError, AttributeError, RuntimeError) as exc:
            self.hub.put("layer", kind, {"valid": False, "reason": str(exc), "topic": topic}, ros_time=ros_time)

    def navigation_receive(self, topic, message, ros_time, *, publish_state=True):
        key = self.navigation_keys[topic]
        data = {"topic": topic, "valid": True}
        try:
            if key in ("pan", "reactive_guard", "voxel_guard", "coverage"):
                if len(message.data) > 32768:
                    raise ValueError("Navigation diagnostic too large")
                parsed = json.loads(message.data)
                if not isinstance(parsed, dict):
                    raise ValueError("Expected diagnostic object")
                data.update(preview(parsed))
                decision = data.get("decision", data.get("reason"))
                if decision != self.navigation_previous.get(key):
                    change = {"source": key, "decision": decision, "motion_authority": data.get("motion_authority")}
                    self.navigation.note("navigation_decision", change, time.time())
                    self.hub.put("event", topic, {"kind": "navigation_decision", "data": change}, critical=True, ros_time=ros_time)
                    self.navigation_previous[key] = decision
            elif key == "collision":
                data.update(preview(message))
                action = getattr(message, "action_type", None)
                for name in ("STOP", "SLOWDOWN", "APPROACH"):
                    if action is not None and action == getattr(message, name, object()):
                        data["decision"] = f"{name}:{getattr(message, 'polygon_name', '')}"
                if data.get("decision") != self.navigation_previous.get(key):
                    change = {"source": key, "decision": data.get("decision", "NO_INTERVENTION")}
                    self.navigation.note("navigation_decision", change, time.time())
                    self.hub.put("event", topic, {"kind": "navigation_decision", "data": change}, critical=True, ros_time=ros_time)
                    self.navigation_previous[key] = data.get("decision")
            elif key in ("odometry", "ground_truth", "amcl_pose"):
                pose = message.pose.pose
                data.update(pose=[pose.position.x, pose.position.y, yaw(pose.orientation)],
                            covariance=preview(list(message.pose.covariance)), source_frame=message.header.frame_id)
                if key != "amcl_pose":
                    data["velocity"] = vector(message)
                    data["child_frame"] = message.child_frame_id
                    if message.child_frame_id != self.config["base_frame"]:
                        raise ValueError("Measured velocity frame differs from configured base_frame")
                try:
                    tf = self.transform(message.header.frame_id, message.header.stamp)
                    data["map_pose"] = [*transform_point(pose.position.x, pose.position.y, tf), yaw(pose.orientation)+tf[2]]
                except TransformException:
                    data["map_pose"] = None
                if not all(math.isfinite(v) for v in data["pose"]):
                    raise ValueError("Non-finite pose")
            elif key == "nav2_bt":
                changes = [dict(node=c.node_name, previous=c.previous_status, status=c.current_status,
                                timestamp=c.timestamp.sec+c.timestamp.nanosec/1e9)
                           for c in message.event_log[:256]]
                self.navigation.bt(changes)
                data.update(changes=changes, truncated=len(message.event_log)>256)
                for change in changes:
                    pair = (change["node"], change["status"])
                    now = time.monotonic()
                    important = change["status"] == "FAILURE" or any(name in change["node"] for name in ("ComputePath", "FollowPath", "Wait"))
                    if important or now-self.bt_event_received.get(pair, 0) >= self.config["bt_event_repeat_interval_s"]:
                        self.hub.put("event", topic, {"kind": "nav2_bt", "data": {
                            **change, "coalesced_repeats": self.bt_event_repeated.pop(pair, 0)}}, critical=True, ros_time=ros_time)
                        self.bt_event_received[pair] = now
                        if important:
                            self.navigation.note("nav2_bt", change, time.time())
                    else:
                        self.bt_event_repeated[pair] = self.bt_event_repeated.get(pair, 0)+1
                self.bt_event_received = dict(list(self.bt_event_received.items())[-512:])
                self.bt_event_repeated = dict(list(self.bt_event_repeated.items())[-512:])
            elif key == "controller_evaluation":
                best = message.best_index
                count = len(message.twists)
                indices = list(range(min(count, 20)))
                if best < count and best not in indices:
                    indices[-1:] = [best]
                trajectories = []
                for index in indices:
                    item = message.twists[index]
                    scores = [dict(name=s.name, raw=s.raw_score, scale=s.scale) for s in item.scores[:20]]
                    trajectories.append(dict(index=index, total=item.total, selected=index==best,
                        velocity=[item.traj.velocity.x, item.traj.velocity.y, item.traj.velocity.theta],
                        points=[[p.x,p.y,p.theta] for p in item.traj.poses[:100]], scores=scores))
                data.update(trajectories=preview(trajectories, budget=12000), count=count, best_index=best,
                            sampled=count>20, source_frame=message.header.frame_id)
                try:
                    data["transform"] = self.transform(message.header.frame_id, message.header.stamp)
                except TransformException:
                    data["transform"] = None
            else:
                limit = self.config["navigation_point_limit"]
                if key == "scan":
                    count = len(message.ranges)
                    stride = max(1, math.ceil(count/limit))
                    points = [[r*math.cos(message.angle_min+i*message.angle_increment),
                               r*math.sin(message.angle_min+i*message.angle_increment), 0.]
                              for i in range(0, count, stride)
                              if math.isfinite(r := message.ranges[i]) and message.range_min <= r <= message.range_max]
                elif key in ("depth_points", "risk_points"):
                    points, count = cloud_points(message, limit)
                else:
                    count = len(message.polygon.points)
                    points = [[p.x,p.y,p.z] for p in message.polygon.points[:limit]
                              if all(math.isfinite(v) for v in (p.x,p.y,p.z))]
                frame = message.header.frame_id
                if not frame:
                    raise ValueError("Empty sensor frame")
                if frame != self.config["map_frame"]:
                    tf = self.buffer.lookup_transform(self.config["map_frame"], frame, Time.from_msg(message.header.stamp)).transform
                    points = transform_xyz(points, [tf.translation.x,tf.translation.y,tf.translation.z],
                                           [tf.rotation.x,tf.rotation.y,tf.rotation.z,tf.rotation.w])
                data.update(points=points,
                            source_count=count, sampled=count>limit, frame=self.config["map_frame"])
            if ros_time is not None:
                data["stamp_age_s"] = self.get_clock().now().nanoseconds/1e9-ros_time
            self.navigation.ingest(key, data, time.time(), time.monotonic(), ros_time)
        except (TransformException, ValueError, TypeError, AttributeError, struct.error) as exc:
            self.navigation.observations.pop(key, None)
            data = {"topic": topic, "valid": False, "reason": str(exc)}
        data["topic"] = topic
        if publish_state:
            self.hub.put("navigation", key, data, ros_time=ros_time)

    def navigation_tick(self):
        wall, monotonic = time.time(), time.monotonic()
        robot = self.hub.latest_data("pose", "robot")
        summary, events = self.navigation.snapshot(wall, monotonic, self.last_clock,
            robot.get("pose") if robot.get("valid") else None, self.runtime_data,
            monotonic-self.runtime_received <= 3., self.get_clock().now().nanoseconds/1e9)
        self.hub.put("navigation", "summary", summary)
        for event in events:
            self.hub.put("event", "navigation", event, critical=True, ros_time=self.last_clock)

    def pose(self):
        try:
            pose = self.transform(self.config["base_frame"])
            tf = self.buffer.lookup_transform(
                self.config["map_frame"], self.config["base_frame"], Time()
            )
            age = self.get_clock().now().nanoseconds / 1e9 - (
                tf.header.stamp.sec + tf.header.stamp.nanosec / 1e9
            )
            self.hub.put(
                "pose",
                "robot",
                {
                    "valid": abs(age) <= 2,
                    "pose": pose,
                    "age": age,
                    "reason": "" if abs(age) <= 2 else "TF stale or future",
                    "frame": self.config["map_frame"],
                },
            )
        except (
            TransformException,
            ValueError,
            TypeError,
            AttributeError,
            RuntimeError,
        ) as exc:
            self.hub.put("pose", "robot", {"valid": False, "reason": str(exc)})

    def destroy_node(self):
        self.slam.close()
        return super().destroy_node()
