asm17-moving-agent/cleany/ros2_ws/src/cleany_skill_executor/cleany_skill_executor/sorting_coordinator.py

"""Sensor-driven pick and place with configurable semantic sorting rules."""
from __future__ import annotations

from dataclasses import dataclass
from copy import deepcopy
import json
import math
from pathlib import Path
import time
from uuid import uuid4

from ament_index_python.packages import get_package_share_directory
from cleany_interfaces.srv import ObserveWristTarget, VerifyPlacement
from cleany_skill_executor.core.cartesian import validate_pose_endpoint
from cleany_skill_executor.seeded_cartesian import CartesianPlanningError
from cleany_skill_executor.collision_geometry_cache import candidate_bounding_radius
from rcl_interfaces.srv import SetParameters
from rclpy.parameter import Parameter
from geometry_msgs.msg import Pose
from moveit_msgs.msg import CollisionObject, PlanningScene, JointConstraint, RobotTrajectory
from moveit_msgs.srv import ApplyPlanningScene
import numpy as np
import rclpy
from rclpy.qos import DurabilityPolicy, QoSProfile
from rclpy.serialization import serialize_message
from rclpy.time import Time
from sensor_msgs.msg import JointState
from shape_msgs.msg import SolidPrimitive
from std_msgs.msg import String

from cleany_mujoco_sim.sorting_scene import load_bins, load_shelf_boxes
from cleany_skill_executor.core.rgbd_projection import CameraProjection, rotation_matrix_from_quaternion
from cleany_skill_executor.core.grasp_selection import REQUIRED_JOINT_NAMES
from cleany_skill_executor.core.nearest_object import ObjectAttempt
from cleany_skill_executor.core.sorting import (
    Category, execute_sort, load_sorting_policy,
)
from cleany_skill_executor.core.reobservation import reobservation_centers
from cleany_skill_executor.moveit_adapter import (
    MoveItAdapterConfig, MoveItGraspAdapter,
)
from cleany_skill_executor.nearest_pregrasp_coordinator import (
    LiftRedetectionError, NearestPregraspCoordinator,
)


@dataclass
class SortTarget:
    attempt: object
    selected: object


@dataclass
class HeldObject:
    target: SortTarget
    selected: object
    offset_in_tcp: np.ndarray


class WristTargetNotDetected(RuntimeError):
    def __init__(self, message: str, stamp_ns: int):
        super().__init__(message)
        self.stamp_ns = stamp_ns


def held_bounding_radius(node, held: HeldObject) -> float:
    cache = (node._geometry_cache
             if getattr(node, '_geometry_subscription', None) is not None else None)
    return candidate_bounding_radius(held.selected.selected_candidate, cache)


def rotation(pose: Pose) -> np.ndarray:
    q = pose.orientation
    return rotation_matrix_from_quaternion(q.x, q.y, q.z, q.w)


def object_in_destination(obj, destination) -> bool:
    if destination is None:
        return False
    center, size = obj.obb_pose.position, obj.obb_size
    half_extent = np.abs(rotation(obj.obb_pose)) @ np.array((size.x,size.y,size.z))/2
    return (destination.contains((center.x,center.y,center.z))
            and all(abs(value-destination.center_xy[i])+half_extent[i]
                    < destination.outside_size[i]/2-destination.wall
                    for i,value in enumerate((center.x,center.y))))


class SortingCoordinator(NearestPregraspCoordinator):
    def __init__(self):
        super().__init__()
        skill = Path(get_package_share_directory('cleany_skill_executor'))
        sim = Path(get_package_share_directory('cleany_mujoco_sim'))
        self.declare_parameter('sorting_policy', str(
            skill / 'config' / 'table_sorting_policy.yaml'))
        self.declare_parameter('sorting_bins_config', str(
            sim / 'config' / 'robot_top_bins.yaml'))
        self.declare_parameter('sorting_maximum_objects', 12)
        self.declare_parameter('sorting_empty_confirmations', 2)
        self._placement_verification_enabled = self.declare_parameter(
            'sorting_verify_placement', True).value
        self._geometry_association_lift = self.declare_parameter(
            'sorting_geometry_association_lift', False).value
        self.declare_parameter('sorting_exit_on_finish', True)
        self.declare_parameter('sorting_test_only_label', '')
        self._wrist_enabled = self.declare_parameter('sorting_use_wrist_camera', False).value
        self.declare_parameter('sorting_wrist_check_attempts', 1)
        self.declare_parameter('sorting_wrist_contact_confirmation_sec', 0.3)
        self.declare_parameter('sorting_gripper_feedback_max_age_sec', 0.5)
        self._adaptive_camera_rate = self.declare_parameter(
            'sorting_adaptive_head_rate', False).value
        self.declare_parameter('sorting_approach_acceleration_scaling', 1.0)
        self.declare_parameter('sorting_return_gripper_position_rad', -0.30)
        self.declare_parameter('sorting_carry_wrist_tolerances_deg', [2., 5., 10., 20., 30.])
        self.declare_parameter('sorting_carry_cartesian_rotation_limit_deg', 30.)
        self._carry_wrist_reference = {}
        self._carry_wrist_tolerance = 0.
        steps = self.get_parameter('sorting_carry_wrist_tolerances_deg').value
        if (not steps or any(not math.isfinite(x) or x <= 0 or x > 90 for x in steps)
                or any(a >= b for a, b in zip(steps, steps[1:]))):
            raise ValueError('Carry wrist tolerances must increase within (0, 90] degrees')
        rotation_limit = float(self.get_parameter('sorting_carry_cartesian_rotation_limit_deg').value)
        if not math.isfinite(rotation_limit) or not 0 < rotation_limit <= 90:
            raise ValueError('Carry Cartesian rotation limit must be within (0, 90] degrees')
        self._wrist_client = self.create_client(ObserveWristTarget, '/perception/observe_wrist_target')
        self._camera_client = self.create_client(SetParameters, '/sorting_cameras/set_parameters')
        self._wrist_reference = None
        self.declare_parameter('sorting_release_ik_attempts', 16)
        self.declare_parameter('sorting_release_ik_iterations', 80)
        self.declare_parameter('sorting_head_reference_refresh_age_sec', 0.0)
        self._return_detection = None
        self.declare_parameter('sorting_verification_timeout_sec', 10.0)
        self.declare_parameter('sorting_artifact_directory', '')
        self.declare_parameter('sorting_reobserve_after_lift', True)
        self.declare_parameter('sorting_reobserve_margin_px', 24.0)
        self.declare_parameter('sorting_reobserve_geometry_padding_m', 0.01)
        self.declare_parameter('sorting_reobserve_max_translation_m', 0.20)
        self.declare_parameter('sorting_reobserve_max_lowering_m', 0.10)
        self.declare_parameter('sorting_reobserve_height_clearance_m', 0.02)
        self.declare_parameter('sorting_held_association_tolerance_m', 0.03)
        self.declare_parameter('sorting_payload_velocity_scaling', 0.01)
        self.declare_parameter('sorting_payload_acceleration_scaling', 0.01)
        self.declare_parameter('sorting_return_velocity_scaling', 0.12)
        self.declare_parameter('sorting_return_acceleration_scaling', 0.15)
        self.declare_parameter(
            'sorting_required_categories', ['trash', 'lost_item'])
        self._require_category_coverage = self.declare_parameter('sorting_require_category_coverage', False).value
        # This executable is currently simulation-only. The inspection and
        # motion ports remain sensor-based; the outcome verifier is an oracle.
        if not self.get_parameter('use_sim_time').value:
            raise RuntimeError('Sorting execution is simulation-only')
        if self.get_parameter('plan_only').value:
            raise RuntimeError('Sorting requires execution, not plan_only')
        self._policy = load_sorting_policy(
            self.get_parameter('sorting_policy').value)
        self._bins = {b.name: b for b in load_bins(
            self.get_parameter('sorting_bins_config').value)}
        self._fixed_release_wrist = {}
        self._fixed_release_cache = {}
        self._fixed_release_points = {}
        self._fixed_release_hold_tolerance = math.radians(float(self.declare_parameter(
            'sorting_fixed_release_wrist_tolerance_deg', .5).value))
        if not 0 < self._fixed_release_hold_tolerance <= math.radians(2.):
            raise ValueError('Fixed release tracking tolerance must be within (0, 2] degrees')
        for name, bin_ in self._bins.items():
            point = np.asarray(self.declare_parameter(
                f'sorting_fixed_release_{name}_m',
                [bin_.center_xy[0], bin_.center_xy[1], bin_.top_z+.22]).value, dtype=float)
            if point.shape != (3,) or not np.isfinite(point).all():
                raise ValueError(f'Invalid fixed release point for {name}')
            self._fixed_release_points[name] = point
        for name in (self._policy.trash_destination,
                     self._policy.lost_item_destination):
            if name not in self._bins:
                raise ValueError(f'Policy destination has no bin: {name}')
        self._verification = self.create_client(
            VerifyPlacement, '/sorting/verify_placement')
        self._apply_scene = self.create_client(
            ApplyPlanningScene, '/apply_planning_scene')
        self._transport_adapter = MoveItGraspAdapter(
            self, config=MoveItAdapterConfig(preserve_scene_attachments=True,
                fk_timeout_sec=float(self.get_parameter('tcp_fk_timeout_sec').value),
                state_validity_timeout_sec=float(self.get_parameter('tcp_fk_timeout_sec').value),
                ik_response_margin_sec=float(self.get_parameter('tcp_fk_timeout_sec').value)),
            spin_once=lambda t: rclpy.spin_once(self, timeout_sec=t))
        self._transport_description_subscription = self.create_subscription(
            String, '/robot_description',
            lambda message: self._transport_adapter.set_robot_description(message.data),
            QoSProfile(depth=1, durability=DurabilityPolicy.TRANSIENT_LOCAL))
        self._status = self.create_publisher(
            String, '/sorting/status', QoSProfile(
                depth=1, durability=DurabilityPolicy.TRANSIENT_LOCAL))
        self._completed = []
        self._current = {}
        self._release_stamp_ns = 0
        self._home = {}
        self._held_object: HeldObject | None = None
        directory = str(self.get_parameter('sorting_artifact_directory').value)
        self._artifact_directory = None
        self._artifact_sequence = 0
        if directory:
            path = Path(directory).expanduser()
            if not path.is_absolute():
                raise ValueError('Sorting artifact directory must be absolute')
            self._artifact_directory = path / f'run-{uuid4().hex}'
            self._artifact_directory.mkdir(parents=True)
            self.get_logger().info(f'Pipeline artifacts: {self._artifact_directory}')

    def _record_pipeline_message(self, stage: str, message: object) -> None:
        if self._artifact_directory is None:
            return
        self._artifact_sequence += 1
        path = self._artifact_directory / f'{self._artifact_sequence:03d}_{stage}.cdr'
        path.write_bytes(serialize_message(message))

    def _attempts(self, detections):
        attempts = super()._attempts(detections)
        label = self.get_parameter('sorting_test_only_label').value
        # Diagnostic isolation never changes the normal empty-workspace gate:
        # other visible objects remain unresolved, so this cannot report clean.
        return tuple(a for a in attempts if not label or a.label == label)

    def _execution_goal(self, arm, joint_state, label):
        goal = super()._execution_goal(arm, joint_state, label)
        if f'{arm}_gripper_joint' in joint_state.name:
            expected = {name for name in REQUIRED_JOINT_NAMES if name.startswith(f'{arm}_')}
            if arm not in ('left', 'right') or set(joint_state.name) != expected or self._held_object is not None:
                raise ValueError('Combined pregrasp requires only the selected empty arm and gripper')
            # One collision-checked six-joint path, dispatched by MoveIt to
            # disjoint arm/gripper controllers. No concurrent blind open command.
            group = 'return_close' if label.startswith('return from ') else 'pregrasp_open'
            goal.request.group_name = f'{arm}_{group}'
        if label.startswith('return from '):
            # Empty-hand return still has actuator torque/damping limits.
            # Keep coordinated jaw closing and all collision/tracking checks.
            for attribute, parameter in (
                ('max_velocity_scaling_factor', 'sorting_return_velocity_scaling'),
                ('max_acceleration_scaling_factor', 'sorting_return_acceleration_scaling'),
            ):
                value = float(self.get_parameter(parameter).value)
                if not math.isfinite(value) or not 0. < value <= 1.:
                    raise ValueError('Return motion scaling must be finite and in (0, 1]')
                setattr(goal.request, attribute, min(getattr(goal.request, attribute), value))
        if self._held_object is not None:
            for attribute, parameter in (
                ('max_velocity_scaling_factor', 'sorting_payload_velocity_scaling'),
                ('max_acceleration_scaling_factor', 'sorting_payload_acceleration_scaling'),
            ):
                value = float(self.get_parameter(parameter).value)
                if not math.isfinite(value) or not 0. < value <= 1.:
                    raise ValueError('Payload motion scaling must be finite and in (0, 1]')
                setattr(goal.request, attribute, min(getattr(goal.request, attribute), value))
        if getattr(self, '_carry_wrist_reference', {}) and self._held_object is not None:
            for name, reference in self._carry_wrist_reference.items():
                goal.request.path_constraints.joint_constraints.append(JointConstraint(
                    joint_name=name, position=reference,
                    tolerance_above=self._carry_wrist_tolerance,
                    tolerance_below=self._carry_wrist_tolerance, weight=1.))
        if getattr(self, '_fixed_release_wrist', {}) and self._held_object is not None:
            goal.request.path_constraints.joint_constraints = [JointConstraint(
                joint_name=name, position=value, tolerance_above=self._fixed_release_hold_tolerance,
                tolerance_below=self._fixed_release_hold_tolerance, weight=1.)
                for name, value in self._fixed_release_wrist.items()]
        return goal


    def _validate_cartesian_plan(self, arm, trajectory, start, target, label, **kwargs):
        if getattr(self, '_carry_wrist_reference', {}) and self._held_object is not None:
            names = trajectory.joint_trajectory.joint_names
            for name, reference in self._carry_wrist_reference.items():
                if name not in names:
                    raise RuntimeError('Carry trajectory missing wrist joint')
                index = names.index(name)
                for point in trajectory.joint_trajectory.points:
                    if (len(point.positions) != len(names)
                            or not math.isfinite(point.positions[index])
                            or abs(point.positions[index]-reference) > self._carry_wrist_tolerance+1e-6):
                        raise RuntimeError(f'{label}: carry wrist bound exceeded before execution')
        return super()._validate_cartesian_plan(arm, trajectory, start, target, label, **kwargs)

    def _joint_corridor_goal(self, arm, joints, start, target, label, velocity_scaling):
        goal = super()._joint_corridor_goal(arm, joints, start, target, label, velocity_scaling)
        if label == 'refreshed grasp approach':
            value = float(self.get_parameter('sorting_approach_acceleration_scaling').value)
            if not math.isfinite(value) or not 0 < value <= 1:
                raise ValueError('Approach acceleration scaling must be in (0,1]')
            goal.request.max_acceleration_scaling_factor = value
        return goal


    def _execute_linear(self, arm, target, label, **kwargs):
        if getattr(self, '_carry_wrist_reference', {}) and self._held_object is not None:
            # The base execution path calls our plan-only override. Never catch
            # execution/controller/guard failures to relax a wrist constraint.
            return super()._execute_linear(arm, target, label, **kwargs)
        if (getattr(self, '_direct_vertical_lift', False)
                and label == 'vertical grasp lift' and kwargs.get('joint_target') is None):
            self._transport_adapter.set_current_state(self._feedback_state())
            solution = self._transport_adapter.solve_position_ik(
                arm, tuple(self._pose_position(target)), None)
            if solution is None:
                raise RuntimeError('No IK for direct vertical lift')
            joints = JointState(name=list(solution.names), position=list(solution.positions))
            actual = self._tcp_pose(arm, joints)
            validate_pose_endpoint(self._cartesian_pose(actual), self._cartesian_pose(target),
                float(self.get_parameter('lin_position_tolerance_m').value),
                math.radians(float(self.get_parameter('corridor_orientation_tolerance_deg').value)))
            # Explicit position corridor for the five-axis arm; retain full
            # seeded interpolation, FK, collision and angular-drift checks.
            target = actual
            kwargs['joint_target'] = joints
        return super()._execute_linear(arm, target, label, **kwargs)

    def _plan_linear_motion(self, arm: str, target: Pose, label: str, **kwargs) -> RobotTrajectory:
        if not getattr(self, '_carry_wrist_reference', {}) or self._held_object is None:
            return super()._plan_linear_motion(arm, target, label, **kwargs)
        self._wait_arm_stationary(arm)
        start = self._tcp_pose(arm)
        position = np.array(self._pose_position(target))
        failures = []
        for degrees in self.get_parameter('sorting_carry_wrist_tolerances_deg').value:
            tolerance = math.radians(degrees)
            if tolerance+1e-9 < self._carry_wrist_tolerance:
                continue
            self._transport_adapter.set_current_state(self._feedback_state())
            solution = self._transport_adapter.solve_held_region_ik(
                arm, position-1e-4, position+1e-4, np.zeros(3),
                attempts=int(self.get_parameter('sorting_release_ik_attempts').value),
                iterations=int(self.get_parameter('sorting_release_ik_iterations').value),
                joint_bounds={name: (value-tolerance, value+tolerance)
                              for name, value in self._carry_wrist_reference.items()})
            if solution is None:
                reason = 'no bounded endpoint IK'
            else:
                joints = JointState(name=list(solution.names), position=list(solution.positions))
                actual = self._tcp_pose(arm, joints)
                try:
                    # A fixed wrist can change the TCP world orientation as
                    # shoulder/elbow move. Do not reuse the empty-arm pregrasp
                    # orientation as a mandatory carry endpoint. Bound the new
                    # rotation, then validate the whole FK corridor below.
                    orientation_reference = deepcopy(start)
                    orientation_reference.position = deepcopy(target.position)
                    validate_pose_endpoint(
                        self._cartesian_pose(actual), self._cartesian_pose(orientation_reference),
                        float(self.get_parameter('lin_position_tolerance_m').value),
                        math.radians(float(self.get_parameter('sorting_carry_cartesian_rotation_limit_deg').value)))
                except ValueError as error:
                    reason = str(error)
                else:
                    self._carry_wrist_tolerance = tolerance
                    options = dict(kwargs, joint_target=joints)
                    try:
                        trajectory = super()._plan_linear_motion(arm, actual, label, **options)
                    except CartesianPlanningError as error:
                        reason = str(error)
                    else:
                        self.get_logger().info(
                            f'Carry Cartesian plan verified: {label} wrist=+/-{degrees:.1f}deg')
                        return trajectory
            failures.append(f'{degrees:.1f}deg: {reason}')
            self.get_logger().info(f'Carry Cartesian replan: {label} {failures[-1]}')
        raise CartesianPlanningError(f'{label}: no bounded carry path; ' + '; '.join(failures))


    def _plan_grasps(self, inspected, attempt):
        self._record_pipeline_message('inspection', inspected)
        result = super()._plan_grasps(inspected, attempt)
        if result is not None:
            self._record_pipeline_message('grasps', result)
        return result

    def _select_reachable(self, candidates, attempt, *, required_arm=''):
        result = super()._select_reachable(
            candidates, attempt, required_arm=required_arm)
        if result is not None:
            self._record_pipeline_message('selection', result)
        return result

    def _stage(self, stage, *, error: str | None = None):
        if stage in ('complete', 'complete_unverified'):
            self._current['placement_verified'] = stage == 'complete'
        payload = dict(stage=stage, **self._current, completed=self._completed)
        if error is not None:
            payload['error'] = error
        if self._artifact_directory is not None:
            with (self._artifact_directory / 'stages.jsonl').open('a') as stream:
                stream.write(json.dumps(dict(wall_time=time.time(), **payload))+'\n')
        self._status.publish(String(data=json.dumps(payload)))
        self.get_logger().info(f'SORTING {json.dumps(payload)}')

    def run(self):
        self._stage('starting')
        self._wait_for_pipeline()
        verify_placement = getattr(self, '_placement_verification_enabled', True)
        if verify_placement and not self._verification.wait_for_service(timeout_sec=10.0):
            raise RuntimeError('Placement verification port is unavailable')
        self._register_bins()
        if self._wrist_enabled:
            if not self._wrist_client.wait_for_service(timeout_sec=10):
                raise RuntimeError('Wrist observation service unavailable')
            self._switch_camera('head')
        self._home = {arm: self._arm_joint_state(arm)
                      for arm in ('left', 'right')}
        self._stage('search')
        maximum = int(self.get_parameter('sorting_maximum_objects').value)
        empty_confirmations = 0
        minimum_total_placements = 0
        for _ in range(maximum):
            detected = self._next_sorting_detection()
            self._record_pipeline_message('detections', detected)
            choices = self._attempts(detected.detections.detections)
            inspections = {}
            def inspect(attempt):
                if attempt.object_id not in inspections:
                    inspections[attempt.object_id] = self._inspect_selected(
                        detected.detections.snapshot_id, attempt)
                return inspections[attempt.object_id]
            work_count = len(detected.detections.detections)
            prepared = None
            unresolved = len(detected.detections.detections) - len(choices)
            for attempt in choices:
                decision = self._policy.classify_model(
                    attempt.label, attempt.confidence,
                    attempt.sorting_category, attempt.sorting_reason)
                self._current = dict(label=attempt.label,
                                     distance_m=attempt.distance_m,
                                     category=decision.category.value,
                                     destination=decision.destination,
                                     reason=decision.reason)
                if decision.category == Category.REVIEW:
                    unresolved += 1
                    self._stage('review')
                    continue
                inspected = inspect(attempt)
                if inspected is None:
                    unresolved += 1
                    continue
                center = inspected.objects.objects[0].obb_pose.position
                # Already placed items are not picked again, even if a camera
                # still sees them. This uses the perceived position, not GT.
                destination = self._bins.get(decision.destination)
                if object_in_destination(inspected.objects.objects[0],destination):
                    work_count -= 1
                    continue
                unresolved += 1
                planned = self._plan_grasps(inspected, attempt)
                if planned is None:
                    self._stage('no_grasp')
                    continue
                # Symmetric shoulder bases: target base_link Y determines the
                # nearer arm. Exhaust its candidates before trying the other arm.
                # Destination does not constrain picking; transport is still
                # checked separately by the collision-aware motion planner.
                arms = ('left', 'right') if center.y >= 0 else ('right', 'left')
                selected = None
                for arm in arms:
                    selected = self._select_reachable(
                        planned.candidates, attempt, required_arm=arm)
                    if selected is not None:
                        break
                if selected is None:
                    self._stage('unreachable')
                    continue
                prepared = SortTarget(attempt, selected)
                break
            minimum_total_placements = max(
                minimum_total_placements, len(self._completed)+work_count)
            if prepared is None:
                if unresolved:
                    raise RuntimeError(f'Work area is not clear: {unresolved} unresolved objects')
                if len(self._completed) < minimum_total_placements:
                    raise RuntimeError('Previously observed work objects are missing without verified placement')
                empty_confirmations += 1
                self._stage('empty_confirmation')
                if empty_confirmations >= int(self.get_parameter('sorting_empty_confirmations').value):
                    break
                continue
            empty_confirmations = 0
            if verify_placement:
                execute_sort(prepared, decision, self, self._stage)
            else:
                execute_sort(prepared, decision, self, self._stage, verify_placement=False)
            self._completed.append(dict(self._current))
        else:
            raise RuntimeError('Sorting action/search budget exhausted before clear-workspace confirmation')
        required = (set(self.get_parameter('sorting_required_categories').value)
                    if getattr(self, '_require_category_coverage', False) else set())
        categories = {item['category'] for item in self._completed}
        if not required <= categories:
            self._stage('incomplete')
            raise RuntimeError(
                'Required sorting paths not verified: '
                + ', '.join(sorted(required - categories)))
        self._stage('mission_complete' if verify_placement else 'mission_complete_unverified')

    def _execute_pregrasp(self, selected, attempt) -> None:
        arm = selected.selected_arm
        expected = {name for name in REQUIRED_JOINT_NAMES
                    if name.startswith(f'{arm}_') and 'gripper' not in name}
        joints = selected.pregrasp_joint_state
        opening = float(self.get_parameter('gripper_open_position_rad').value)
        if (arm not in ('left', 'right') or len(joints.name) != 5 or set(joints.name) != expected
                or len(joints.position) != 5 or not all(math.isfinite(q) for q in joints.position)
                or not math.isfinite(opening)):
            raise ValueError('Invalid selected-arm pregrasp/open target')
        combined = deepcopy(selected)
        combined.pregrasp_joint_state.name.append(f'{arm}_gripper_joint')
        combined.pregrasp_joint_state.position.append(opening)
        combined.pregrasp_joint_state.velocity = []
        combined.pregrasp_joint_state.effort = []
        # Preserve source selection and the five-joint grasp/retreat targets.
        # Base implementation registers the OBB, forbids target contacts, and
        # requires feedback convergence for ALL six joints before returning.
        self.get_logger().info(f'Pregrasp with simultaneous {arm} gripper opening')
        super()._execute_pregrasp(combined, attempt)

    def pick(self, target: SortTarget) -> HeldObject:
        self._held_object = None
        self._fixed_release_wrist = {}
        self._lift_completion_stamp_ns = None
        self._execute_pregrasp(target.selected, target.attempt)
        # The selected gripper opened along the pregrasp trajectory; do not
        # issue another timed opening after arrival.
        if getattr(self, '_wrist_enabled', False):
            selected, attempt = target.selected, target.attempt
            self._wait_arm_stationary(selected.selected_arm)
            selected, attempt = self._ensure_fresh_head_before_wrist(selected, attempt)
            if selected is not target.selected:
                target = SortTarget(attempt, selected)
            self._switch_camera(selected.selected_arm)
            self._wrist_reference = self._observe_wrist(selected, ObserveWristTarget.Request.HANDOFF)
            # Preserve the original head 3D estimate. RGB consistency is not new depth.
            self._execution_scene.allow_contacts_for(selected.selected_arm)
        else:
            if getattr(self, '_geometry_association_lift', False):
                selected, attempt = self._refresh_selected_grasp(
                    target.selected, target.attempt, match_label=False)
            else:
                selected, attempt = self._refresh_selected_grasp(target.selected, target.attempt)
        self._execute_grasp_and_lift(selected, attempt)
        if self._held_object is None:
            raise RuntimeError('No settled grasp attachment reference')
        self._held_object.target = target
        return self._held_object

    def _execute_grasp_and_lift(self, selected, attempt) -> None:
        # Keep the selected wrist active, but refresh head RGB-D throughout approach
        # and closure so attachment does not start with an idle-rate sensor.
        boost = getattr(self, '_wrist_enabled', False)
        if boost:
            self._set_head_depth_boost(True)
        try:
            super()._execute_grasp_and_lift(selected, attempt)
        except Exception:
            if boost:
                try:
                    self._set_head_depth_boost(False)
                except Exception as error:
                    self.get_logger().error(f'Could not restore head depth rate: {error}')
            raise
        else:
            if boost:
                self._set_head_depth_boost(False)

    def _set_head_depth_boost(self, enabled: bool) -> None:
        if not self._camera_client.wait_for_service(timeout_sec=3.):
            raise RuntimeError('Camera rate control service unavailable for depth refresh')
        request = SetParameters.Request(parameters=[
            Parameter('head_depth_boost', value=enabled).to_parameter_msg()])
        response = self._future(self._camera_client.call_async(request), 3., 'head depth refresh')
        if len(response.results) != 1 or not response.results[0].successful:
            raise RuntimeError('Head depth refresh request rejected')
        self.get_logger().info(f'Head depth boost={enabled}; wrist camera selection unchanged')

    def _ensure_fresh_head_before_wrist(self, selected, attempt):
        maximum = float(self.get_parameter('sorting_head_reference_refresh_age_sec').value)
        if not math.isfinite(maximum) or not 0 <= maximum <= 30.0:
            raise ValueError('Head reference refresh age must be in [0, 30] seconds')
        if maximum == 0.0:
            return selected, attempt
        def age(selection):
            stamp = selection.selected_candidate.header.stamp
            captured = stamp.sec*10**9 + stamp.nanosec
            now = self.get_clock().now().nanoseconds
            if captured <= 0 or captured > now:
                raise RuntimeError('Invalid head reference timestamp before wrist handoff')
            return (now-captured)/1e9
        if age(selected) <= maximum:
            return selected, attempt
        self.get_logger().info('Refreshing aged head reference before wrist handoff')
        self._switch_camera('head')
        refreshed, fresh_attempt = self._refresh_selected_grasp(selected, attempt)
        if age(refreshed) > maximum:
            raise RuntimeError('Refreshed head observation expired during replanning')
        previous = self._policy.classify_model(attempt.label, attempt.confidence,
            attempt.sorting_category, attempt.sorting_reason)
        current = self._policy.classify_model(fresh_attempt.label, fresh_attempt.confidence,
            fresh_attempt.sorting_category, fresh_attempt.sorting_reason)
        if (current.category == Category.REVIEW or current.category != previous.category
                or current.destination != previous.destination):
            raise RuntimeError('Object classification changed during head reference refresh')
        return refreshed, fresh_attempt

    def _on_lift_motion_complete(self) -> None:
        self._lift_completion_stamp_ns = self.get_clock().now().nanoseconds

    def _on_grasp_contact(self, selected, attempt) -> None:
        # The actual settled TCP, not the requested grasp endpoint, defines the
        # same rigid attachment assumption that MoveIt will use immediately next.
        tcp = self._tcp_pose(selected.selected_arm)
        object_center = (
            selected.selected_candidate.target_object.obb_pose.position)
        if getattr(self, '_wrist_enabled', False):
            self._contact_tcp_quaternion = deepcopy(tcp.orientation)
        offset = rotation(tcp).T @ (
            np.array((object_center.x, object_center.y, object_center.z))
            - np.array(self._pose_position(tcp)))
        self._held_object = HeldObject(SortTarget(attempt, selected), selected, offset)
        joints = self._arm_joint_state(selected.selected_arm)
        self._carry_wrist_reference = {
            name: float(value) for name, value in zip(joints.name, joints.position, strict=True)
            if name == f'{selected.selected_arm}_wrist_roll_joint'}
        if len(self._carry_wrist_reference) != 1:
            raise RuntimeError('Missing wrist roll feedback at grasp contact')
        self._carry_wrist_tolerance = math.radians(
            self.get_parameter('sorting_carry_wrist_tolerances_deg').value[0])

    def _verify_lift_height(self, attempt, *, minimum_center_z_m=None):
        if getattr(self, '_wrist_enabled', False):
            held = self._held_object
            if held is None:
                raise RuntimeError('Missing held geometry for wrist check')
            self._require_held_contact(held)
            tcp = self._tcp_pose(held.selected.selected_arm)
            predicted = np.array(self._pose_position(tcp)) + rotation(tcp) @ held.offset_in_tcp
            if minimum_center_z_m is not None and predicted[2] < minimum_center_z_m:
                raise RuntimeError(
                    'Kinematic lift clearance below required height: '
                    f'predicted_center_z={predicted[2]:.4f}m '
                    f'required_center_z={minimum_center_z_m:.4f}m')
            return self._verify_wrist_or_contact(held)
        verify = (self._verify_head_redetection if getattr(self, '_geometry_association_lift', False)
                  else super()._verify_lift_height)
        try:
            inspected = verify(
                attempt, minimum_center_z_m=minimum_center_z_m)
        except LiftRedetectionError:
            if not self.get_parameter('sorting_reobserve_after_lift').value:
                raise
            self._reobserve_held_object(minimum_center_z_m)
            # Exactly one physical recovery move; no recursive motion/retries.
            inspected = verify(
                attempt, minimum_center_z_m=minimum_center_z_m)
        held = self._held_object
        if inspected is None or held is None:
            raise RuntimeError('Sorting requires observed lift and attachment reference')
        self._record_pipeline_message('lift_inspection', inspected)
        frame = held.selected.selected_candidate.header.frame_id
        header = inspected.objects.header
        if header.frame_id != frame:
            raise RuntimeError('Held-object observation frame differs from attachment')
        tcp = self._tcp_pose(held.selected.selected_arm)
        predicted = np.array(self._pose_position(tcp)) + rotation(tcp) @ held.offset_in_tcp
        observed = inspected.objects.objects[0].obb_pose.position
        tolerance = float(self.get_parameter('sorting_held_association_tolerance_m').value)
        if not math.isfinite(tolerance) or tolerance <= 0.:
            raise ValueError('Held-object association tolerance must be finite and positive')
        error = np.linalg.norm(predicted - np.array((observed.x, observed.y, observed.z)))
        if not math.isfinite(error) or error > tolerance:
            raise RuntimeError(f'Observed lifted object does not match held geometry: {error:.4f}m')
        return inspected

    def _verify_head_redetection(self, attempt, *, minimum_center_z_m=None):
        """Associate a new YOLOE mask by measured 3D position, not Gemini wording."""
        held = self._held_object
        if held is None:
            raise RuntimeError('No attachment reference for head RGB-D reobservation')
        minimum = float(self.get_parameter('lift_min_center_z_m').value)
        if minimum_center_z_m is not None:
            minimum = max(minimum, float(minimum_center_z_m))
        tolerance = float(self.get_parameter('sorting_held_association_tolerance_m').value)
        if not math.isfinite(minimum) or not math.isfinite(tolerance) or tolerance <= 0:
            raise ValueError('Invalid lift height or association tolerance')
        arm = held.selected.selected_arm
        tcp = self._tcp_pose(arm)
        predicted = np.array(self._pose_position(tcp)) + rotation(tcp) @ held.offset_in_tcp
        detected = self._detect_objects()
        matches = []
        for item in detected.detections.detections:
            if not item.distance_valid:
                continue
            candidate = ObjectAttempt(
                object_id=int(item.object_id), label=item.label,
                confidence=float(item.confidence), distance_m=float(item.distance_m))
            inspected = self._inspect_selected(detected.detections.snapshot_id, candidate)
            if inspected is None:
                continue
            center = inspected.objects.objects[0].obb_pose.position
            position = np.array((center.x, center.y, center.z))
            error = float(np.linalg.norm(predicted - position))
            if math.isfinite(error) and error <= tolerance:
                matches.append((inspected, error))
        if not matches:
            raise LiftRedetectionError(
                f'Head RGB-D could not associate lifted {attempt.label} with the gripper')
        if len(matches) != 1:
            raise RuntimeError('Head RGB-D found multiple objects at the held-object position')
        inspected, error = matches[0]
        center_z = float(inspected.objects.objects[0].obb_pose.position.z)
        self.get_logger().info(
            f'Head RGB-D lift verification: source={attempt.label} '
            f'observed={inspected.objects.objects[0].label} '
            f'center_z={center_z:.3f}m association_error={error:.3f}m')
        if not math.isfinite(center_z) or center_z < minimum:
            raise RuntimeError(
                f'{attempt.label} was not retained after lift: '
                f'center_z={center_z:.3f}m minimum={minimum:.3f}m')
        return inspected


    def _held_center_joints(self, held: HeldObject, center: np.ndarray,
                            tolerance_m: float) -> JointState | None:
        arm = held.selected.selected_arm
        pose = self._tcp_pose(arm)
        self._transport_adapter.set_current_state(self._feedback_state())
        solution = None
        for _ in range(5):
            target = center - rotation(pose) @ held.offset_in_tcp
            solution = self._transport_adapter.solve_position_ik(
                arm, tuple(float(v) for v in target), solution)
            if solution is None:
                self.get_logger().info(f'Held-center IK unavailable: target={target.tolist()}')
                return None
            joints = JointState(name=list(solution.names), position=list(solution.positions))
            pose = self._tcp_pose(arm, joints)
            predicted = np.array(self._pose_position(pose)) + rotation(pose) @ held.offset_in_tcp
            if np.linalg.norm(predicted-center) < tolerance_m:
                valid = self._transport_adapter.state_is_valid(arm, solution)
                if not valid:
                    self.get_logger().info('Held-center IK rejected by collision check')
                return joints if valid else None
        self.get_logger().info(
            f'Held-center fixed-point IK did not converge: error_m={np.linalg.norm(predicted-center):.5f}')
        return None

    def _require_held_contact(self, held: HeldObject) -> None:
        if not self._gripper_contact_stalled(
                held.selected.selected_arm,
                float(self.get_parameter('gripper_open_position_rad').value),
                self._candidate_close_position(held.selected.selected_candidate)):
            raise RuntimeError('Held-object reobservation lost settled gripper contact')

    def _confirm_held_contact(self, held: HeldObject) -> None:
        """Require consecutive post-request motor feedback while the arm is held."""
        duration = float(self.get_parameter('sorting_wrist_contact_confirmation_sec').value)
        timeout = float(self.get_parameter('gripper_contact_feedback_timeout_sec').value)
        maximum_age = float(self.get_parameter('sorting_gripper_feedback_max_age_sec').value)
        if (not all(math.isfinite(v) and v > 0 for v in (duration, timeout, maximum_age))
                or duration > timeout):
            raise ValueError('Invalid held-contact confirmation timing')
        joint = f'{held.selected.selected_arm}_gripper_joint'
        previous = self.get_clock().now().nanoseconds
        first = None
        samples = 0
        deadline = time.monotonic() + timeout
        while time.monotonic() < deadline:
            rclpy.spin_once(self, timeout_sec=0.05)
            stamp = self._gripper_feedback_stamps.get(joint, 0)
            if stamp <= previous:
                continue
            now = self.get_clock().now().nanoseconds
            # /joint_states and /clock have separate subscriptions. A joint
            # update can arrive first; leave it uncounted until the clock catches
            # up. A stopped clock or persistently future stamp still times out.
            if stamp > now:
                continue
            if (now - stamp) / 1e9 > maximum_age:
                raise RuntimeError('Held-gripper feedback is stale')
            if first is not None and (stamp - previous) / 1e9 > maximum_age:
                raise RuntimeError('Held-gripper feedback continuity was lost')
            self._require_held_contact(held)
            previous = stamp
            first = stamp if first is None else first
            samples += 1
            if samples >= 3 and (stamp - first) / 1e9 >= duration:
                return
        raise RuntimeError('No fresh sustained held-gripper feedback before timeout')

    def _verify_wrist_or_contact(self, held: HeldObject):
        attempts = int(self.get_parameter('sorting_wrist_check_attempts').value)
        if not 1 <= attempts <= 5:
            raise ValueError('Wrist check attempts must be within [1, 5]')
        after_stamp_ns = None
        for attempt in range(1, attempts + 1):
            self._confirm_held_contact(held)
            try:
                result = self._observe_wrist(
                    held.selected, ObserveWristTarget.Request.CHECK, held=True,
                    after_stamp_ns=after_stamp_ns)
            except WristTargetNotDetected as error:
                self._confirm_held_contact(held)
                after_stamp_ns = error.stamp_ns
                self.get_logger().warning(
                    f'Wrist target not detected ({attempt}/{attempts}); '
                    f'fresh gripper contact remains stable: {error}')
            else:
                self._confirm_held_contact(held)
                self.get_logger().info('Wrist RGB + gripper contact consistent after lift; '
                                       'height is kinematic, not an independent depth measurement')
                return result
        self.get_logger().warning(
            f'Continuing after {attempts} fresh wrist misses with sustained gripper feedback; '
            'visual grasp confirmation unavailable, lift height remains kinematic')
        return None

    def _reobserve_held_object(self, minimum_center_z_m: float | None) -> None:
        held, info = self._held_object, self._camera_info
        if held is None or info is None:
            raise RuntimeError('Reobservation needs camera calibration and settled attachment')
        self._require_held_contact(held)
        arm = held.selected.selected_arm
        self._wait_arm_stationary(arm)
        transform = self._tf_buffer.lookup_transform(
            held.selected.selected_candidate.header.frame_id,
            info.header.frame_id, Time()).transform
        q, t = transform.rotation, transform.translation
        camera = CameraProjection(
            float(info.k[0]), float(info.k[4]), float(info.k[2]), float(info.k[5]),
            (t.x, t.y, t.z), tuple(rotation_matrix_from_quaternion(q.x, q.y, q.z, q.w).flat))
        tcp = self._tcp_pose(arm)
        center = np.array(self._pose_position(tcp)) + rotation(tcp) @ held.offset_in_tcp
        padding = float(self.get_parameter('sorting_reobserve_geometry_padding_m').value)
        if not math.isfinite(padding) or padding < 0.:
            raise ValueError('Reobservation padding must be finite and nonnegative')
        radius = held_bounding_radius(self, held) + padding
        minimum = max(float(self.get_parameter('lift_min_center_z_m').value),
                      minimum_center_z_m if minimum_center_z_m is not None else -math.inf)
        centers = reobservation_centers(
            camera, info.width, info.height, center, radius,
            minimum_z_m=minimum,
            margin_px=float(self.get_parameter('sorting_reobserve_margin_px').value),
            maximum_translation_m=float(self.get_parameter('sorting_reobserve_max_translation_m').value),
            maximum_lowering_m=float(self.get_parameter('sorting_reobserve_max_lowering_m').value),
            height_clearance_m=float(self.get_parameter('sorting_reobserve_height_clearance_m').value))
        self.get_logger().info(
            f'Held reobservation: predicted_center={center.tolist()} radius={radius:.4f}m '
            f'frustum_candidates={[c.tolist() for c in centers]}')
        if bool(self.get_parameter('require_sensor_scene').value):
            self._wait_for_sensor_scene(float(self.get_parameter('attachment_scene_timeout_sec').value))
        for candidate in centers:
            joints = self._held_center_joints(held, candidate, 0.005)
            if joints is None:
                self.get_logger().info(f'Reobservation IK rejected: {candidate.tolist()}')
                continue
            self._move_to(arm, joints, 'held-object camera reobservation')
            self._verify_feedback(joints)
            self._hold('lift_hold_sec')
            self._require_held_contact(held)
            return
        raise RuntimeError('No collision-valid held-object reobservation pose in camera frustum')

    def _feedback_state(self):
        state = JointState()
        state.name = list(REQUIRED_JOINT_NAMES)
        state.position = [self._joint_positions[n] for n in state.name]
        return state


    def _fixed_release_ik(self, arm, point, offset, wrist):
        """Reuse only an exactly matching pose, with fresh FK and scene validation."""
        key = (arm, tuple(point), tuple(offset), tuple(sorted(wrist.items())))
        self._transport_adapter.set_current_state(self._feedback_state())
        solution = self._fixed_release_cache.get(key)
        if solution is not None:
            joints = JointState(name=list(solution.names), position=list(solution.positions))
            pose = self._tcp_pose(arm, joints)
            center = np.array(self._pose_position(pose))+rotation(pose)@offset
            values = dict(zip(solution.names, solution.positions, strict=True))
            if (np.max(np.abs(center-point)) <= .001
                    and all(values.get(name) == value for name, value in wrist.items())
                    and self._transport_adapter.state_is_valid(arm, solution)):
                self.get_logger().info('Reusing fixed release IK after fresh FK/collision checks')
                return solution
            self._fixed_release_cache.pop(key)
        solution = self._transport_adapter.solve_held_region_ik(
            arm, point-.0005, point+.0005, offset, fixed_joints=wrist,
            attempts=int(self.get_parameter('sorting_release_ik_attempts').value),
            iterations=int(self.get_parameter('sorting_release_ik_iterations').value))
        if solution is not None:
            if len(self._fixed_release_cache) >= 64:
                self._fixed_release_cache.pop(next(iter(self._fixed_release_cache)))
            self._fixed_release_cache[key] = solution
        return solution

    def _transport_fixed_release(self, held, destination):
        arm = held.selected.selected_arm
        point = self._fixed_release_points[destination]
        # Classification already selected the destination before pick. Hold the
        # post-lift wrist and plan directly to that bin, with no shared waypoint.
        self._wait_arm_stationary(arm)
        self._require_held_contact(held)
        feedback = self._arm_joint_state(arm)
        actual = dict(zip(feedback.name, feedback.position, strict=True))
        self._fixed_release_wrist = {name: actual[name] for name in self._carry_wrist_reference}
        drop = self._fixed_release_ik(arm, point, held.offset_in_tcp, self._fixed_release_wrist)
        if drop is None:
            raise RuntimeError(f'Direct fixed release unreachable with post-lift wrist: {arm}/{destination}')
        self.get_logger().info(f'Fixed release: {destination} object_center={point.tolist()} wrist held')
        joints = JointState(name=list(drop.names), position=list(drop.positions))
        self._move_to(arm, joints, f'transport to {destination}')
        self._verify_feedback(joints)
        self._require_held_contact(held)

    def transport(self, held: HeldObject, destination: str):
        self._require_held_contact(held)
        # TODO(bin-opening-fit): check that the held object's bounding sphere
        # fits the bin opening before transport. Planned for later development.
        self._transport_fixed_release(held, destination)

    def release(self, held: HeldObject, destination: str):
        arm = held.selected.selected_arm
        pose = self._tcp_pose(arm)
        center = (np.array(self._pose_position(pose))
                  + rotation(pose) @ held.offset_in_tcp)
        if not np.isfinite(center).all():
            raise RuntimeError('Release object center must be finite')
        if getattr(self, '_fixed_release_wrist', {}):
            if np.max(np.abs(center-self._fixed_release_points[destination])) > .01:
                raise RuntimeError('Fixed release object center has not reached its destination')
            state = self._arm_joint_state(arm)
            feedback = dict(zip(state.name, state.position, strict=True))
            if any(name not in feedback or not math.isfinite(feedback[name])
                   or abs(feedback[name]-value) > self._fixed_release_hold_tolerance+1e-6
                   for name, value in self._fixed_release_wrist.items()):
                raise RuntimeError('Fixed release wrist feedback is outside hold tolerance')
        # TODO(bin-opening-fit): before opening, check that the object is inside
        # the bin opening and above its rim. Planned for later development.
        self._open_gripper(arm)
        self._release_stamp_ns = self.get_clock().now().nanoseconds
        self._hold('grasp_settle_sec')
        self._execution_scene.restore()
        self._held_object = None
        self._carry_wrist_reference = {}
        self._fixed_release_wrist = {}
        if getattr(self, '_wrist_enabled', False) and self._wrist_reference is not None:
            candidate=held.selected.selected_candidate
            request=ObserveWristTarget.Request(operation=ObserveWristTarget.Request.CLEAR,
                arm=arm,reference_id=self._wrist_reference.reference_id,
                source_snapshot_id=candidate.snapshot_id,source_object_id=candidate.target_object.object_id)
            response=self._future(self._wrist_client.call_async(request),3.,'clear wrist reference')
            if not response.success:
                raise RuntimeError(f'Could not clear wrist reference: {response.message}')
            self._wrist_reference=None

    def _next_sorting_detection(self):
        if getattr(self, '_adaptive_camera_rate', False):
            self._set_head_high_rate(True)
        pending = getattr(self, '_return_detection', None)
        self._return_detection = None
        try:
            if pending is None:
                return self._detect_objects()
            self.get_logger().info('Using scene detection requested during return')
            return self._finish_object_detection(pending)
        finally:
            if getattr(self, '_adaptive_camera_rate', False):
                self._set_head_high_rate(False)

    def retreat(self, held: HeldObject, destination: str):
        arm = held.selected.selected_arm
        if self._held_object is not None:
            raise RuntimeError('Cannot close the returning gripper before release completes')
        joints = deepcopy(self._home[arm])
        closing = float(self.get_parameter('sorting_return_gripper_position_rad').value)
        if not math.isfinite(closing):
            raise ValueError('Return gripper position must be finite')
        joints.name.append(f'{arm}_gripper_joint')
        joints.position.append(closing)
        joints.velocity, joints.effort = [], []
        if self._wrist_enabled:
            self._switch_camera('head')
        # InspectScene waits for a new RGB-D frame after accepting the goal.
        # Inference proceeds in the perception node while this node executes return.
        self._return_detection = self._begin_object_detection()
        self.get_logger().info('Next scene detection submitted before return motion')
        self.get_logger().info(f'Return with simultaneous {arm} gripper closing')
        try:
            self._move_to(arm, joints, f'return from {destination}')
            self._verify_feedback(joints)
        except Exception:
            self._return_detection[0].cancel_goal_async()
            self._return_detection = None
            raise

    def _switch_camera(self, camera: str):
        if not self._camera_client.wait_for_service(timeout_sec=3):
            raise RuntimeError('Camera rate control service unavailable')
        request = SetParameters.Request(parameters=[Parameter('active_camera', value=camera).to_parameter_msg()])
        response = self._future(self._camera_client.call_async(request), 3., 'camera source/rate change')
        if len(response.results)!=1 or not response.results[0].successful:
            raise RuntimeError('Camera source/rate change rejected')
        self.get_logger().info(f'Active inspection camera={camera}; head runs at configured background rate during wrist use')
        if camera == 'head':
            self._set_head_high_rate(True)

    def _set_head_high_rate(self, enabled: bool) -> None:
        if not getattr(self, '_adaptive_camera_rate', False):
            return
        request = SetParameters.Request(parameters=[
            Parameter('head_high_rate', value=enabled).to_parameter_msg()])
        response = self._future(self._camera_client.call_async(request), 3.,
                                'head camera rate change')
        if len(response.results) != 1 or not response.results[0].successful:
            raise RuntimeError('Head camera rate change rejected')

    def _observe_wrist(self, selected, operation, *, held=False, after_stamp_ns=None):
        candidate = selected.selected_candidate
        obj = candidate.target_object
        request = ObserveWristTarget.Request(operation=operation, arm=selected.selected_arm,
            source_snapshot_id=candidate.snapshot_id, source_object_id=obj.object_id,
            label=obj.label, source_confidence=obj.confidence,
            reference_id=self._wrist_reference.reference_id if self._wrist_reference else '',
            size=deepcopy(obj.obb_size), after_stamp_ns=self.get_clock().now().nanoseconds)
        if operation == ObserveWristTarget.Request.CHECK:
            completed = getattr(self, '_lift_completion_stamp_ns', None)
            if completed is None or not 0 < completed <= request.after_stamp_ns:
                raise RuntimeError('Missing or invalid lift completion freshness barrier')
            # Results captured during the existing stabilization hold are valid
            # post-lift evidence. Do not force another full frame after the hold.
            request.after_stamp_ns = max(completed, after_stamp_ns or 0)
        request.expected_pose.header=deepcopy(candidate.header)
        request.expected_pose.pose=deepcopy(obj.obb_pose)
        if held:
            tcp = self._tcp_pose(selected.selected_arm)
            center = np.array(self._pose_position(tcp))+rotation(tcp)@self._held_object.offset_in_tcp
            request.expected_pose.pose.position.x, request.expected_pose.pose.position.y, request.expected_pose.pose.position.z = map(float,center)
            from cleany_skill_executor.core.wrist_pose import carried_orientation
            request.expected_pose.pose.orientation = carried_orientation(
                self._contact_tcp_quaternion, tcp.orientation, obj.obb_pose.orientation)
        self._record_pipeline_message('wrist_request', request)
        started = time.monotonic()
        response = self._future(self._wrist_client.call_async(request), 30., 'wrist RGB verification')
        self.get_logger().info(f'WRIST RPC operation={operation} elapsed_sec={time.monotonic()-started:.3f} '
                               f'after_ns={request.after_stamp_ns}')
        self._record_pipeline_message('wrist_response', response)
        missing = (not response.success and response.status == response.NOT_DETECTED
                   and operation == ObserveWristTarget.Request.CHECK)
        if not missing and (not response.success or response.status != response.OK):
            raise RuntimeError(f'Wrist RGB verification failed: {response.message}')
        stamp=response.header.stamp.sec*10**9+response.header.stamp.nanosec
        if (response.source_snapshot_id != candidate.snapshot_id
                or response.source_object_id != obj.object_id
                or response.header.frame_id != f'{selected.selected_arm}_wrist_rgb_optical_frame'
                or not request.after_stamp_ns < stamp <= self.get_clock().now().nanoseconds
                or not response.reference_id
                or (operation==ObserveWristTarget.Request.CHECK and
                    response.reference_id != request.reference_id)):
            raise RuntimeError('Wrist response source/frame/timestamp mismatch')
        if missing:
            raise WristTargetNotDetected(response.message, stamp)
        return response

    def verify_placement(self, target: SortTarget, destination: str) -> bool:
        request = VerifyPlacement.Request(
            label=target.attempt.label, destination_id=destination,
            after_stamp_ns=self._release_stamp_ns)
        deadline = time.monotonic() + self.get_parameter(
            'sorting_verification_timeout_sec').value
        while time.monotonic() < deadline:
            response = self._future(self._verification.call_async(request),
                                    2.0, 'placement verification')
            if response.success:
                self.get_logger().info(response.message)
                return True
            rclpy.spin_once(self, timeout_sec=0.1)
        return False

    def _register_bins(self):
        # Known collection-station calibration only. Desk and item geometry
        # still comes from the depth sensor, never from the MuJoCo scene.
        scene = PlanningScene(is_diff=True)
        scene.robot_state.is_diff = True
        for bin_ in self._bins.values():
            item = CollisionObject(id=bin_.name, operation=CollisionObject.ADD)
            item.header.frame_id = 'base_link'
            for _, size, center in bin_.boxes():
                item.primitives.append(SolidPrimitive(
                    type=SolidPrimitive.BOX, dimensions=list(size)))
                pose = Pose()
                pose.position.x, pose.position.y, pose.position.z = center
                pose.orientation.w = 1.0
                item.primitive_poses.append(pose)
            scene.world.collision_objects.append(item)
        for name, size, center in load_shelf_boxes(
                self.get_parameter('sorting_bins_config').value):
            item = CollisionObject(id=name, operation=CollisionObject.ADD)
            item.header.frame_id = 'base_link'
            item.primitives.append(SolidPrimitive(type=SolidPrimitive.BOX, dimensions=list(size)))
            pose = Pose()
            pose.position.x, pose.position.y, pose.position.z = center
            pose.orientation.w = 1.0
            item.primitive_poses.append(pose)
            scene.world.collision_objects.append(item)
        if not self._apply_scene.wait_for_service(timeout_sec=5.0):
            raise RuntimeError('Planning scene is unavailable')
        request = ApplyPlanningScene.Request(scene=scene)
        response = self._future(
            self._apply_scene.call_async(request),
            5.0, 'bin collision scene')
        if not response.success:
            raise RuntimeError('Could not register collection bins')


def main(args=None):
    rclpy.init(args=args)
    node = SortingCoordinator()
    failed = False
    try:
        node.run()
        if not node.get_parameter('sorting_exit_on_finish').value:
            rclpy.spin(node)
    except KeyboardInterrupt:
        pass
    except Exception as error:
        failed = True
        node._stage('failed', error=str(error))
        node.get_logger().fatal(f'SORTING FAILED: {error}')
        try:
            if not node.get_parameter('sorting_exit_on_finish').value:
                rclpy.spin(node)
        except KeyboardInterrupt:
            pass
    finally:
        node.destroy_node()
        if rclpy.ok():
            rclpy.shutdown()
    if failed:
        raise SystemExit(1)
