asm17-moving-agent/cleany/ros2_ws/src/cleany_gazebo_sim/config/odometry_error_ideal.yaml

simulated_odometry_error:
  ros__parameters:
    input_topic: wheel/odom_raw
    output_topic: wheel/odom
    forward_scale: 1.0
    lateral_scale: 1.0
    rotation_scale: 1.0
    forward_noise_stddev_per_sqrt_m: 0.0
    lateral_noise_stddev_per_sqrt_m: 0.0
    rotation_noise_stddev_per_sqrt_rad: 0.0
    yaw_bias_walk_stddev_per_sqrt_m: 0.0
    max_abs_yaw_bias_rad_per_m: 0.0
    yaw_drift_rad_per_forward_m: 0.0
    slip_events_per_second: 0.0
    slip_duration_min_sec: 0.0
    slip_duration_max_sec: 0.0
    slip_gain_min: 1.0
    slip_gain_max: 1.0
    random_seed: 42
