asm17-moving-agent/cleany/(commit log)

2026-07-16 feat(sim): publish aligned depth and camera intrinsics
    Render a 32FC1 depth image from the RGB camera (pixel-aligned with
    image_raw, like the RealSense depth-aligned-to-color stream) and publish
    pinhole CameraInfo derived from the MuJoCo camera fovy, so downstream
    perception can deproject detections to 3D.
2026-07-16 feat(perception): add YOLO instance segmentation masks
    Switch default weights to yolo11n-seg and carry per-detection full-frame
    boolean masks (retina_masks, image-resolution) on Detection. Masks stay
    node-internal for the upcoming depth fusion stage; visualization goes
    through the annotated overlay. Plain detect weights keep working with
    mask=None.
2026-07-16 fix(sim,perception): apply code-review findings
    - Mark no-hit depth pixels as +inf instead of the finite far-clip value
    (REP 118), so depth fusion never deprojects the background as a surface.
    - Render depth by toggling depth mode on the one renderer instead of a
    second Renderer (drops the extra GL context and update_scene call).
    - Build CameraInfo once and restamp it instead of rebuilding per frame.
    - Force detection masks to bool before overlay indexing in annotate.
    - Gitignore MUJOCO_LOG.TXT emitted by depth-render tests.
    - Sync models/README.md with the yolo11n-seg default; document the macOS
    depth-precision limitation (no ARB_clip_control).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
2026-07-27 feat(sim): unify Cleany robot description across simulators
    [Base.stl, Base.stl.convex.stl, Base_Motor.stl, Base_Motor.stl.convex.stl, Fixed_Jaw.stl, Fixed_Jaw.stl.convex.stl, Fixed_Jaw_Motor.stl, Fixed_Jaw_Motor.stl.convex.stl]
2026-07-28 docs(interfaces): define mobile base velocity contract
2026-07-28 feat(sim): validate chassis velocity commands
2026-07-28 feat(sim): add mecanum inverse kinematics
2026-07-28 feat(sim): wire cmd_vel into MuJoCo node
2026-07-28 feat(sim): control MuJoCo wheels with PID
2026-07-31 chore: remove docker development environment
    각자 개발환경에서 Native로 진행하기 때문에, 별도 Docker 컨테이너를
    유지보수 할 필요가 없다 판단하여 제거.
2026-08-04 feat(sim): checkpoint Harmonic sensor profile
    [cleany_mecanum_prototype.sdf]
2026-08-04 test(gazebo): validate rendering sensor runtime
    [cleany_mecanum_prototype.sdf]
2026-08-05 feat(gazebo): add IMU sensor bridge
    [cleany_mecanum_harmonic.sdf, cleany_mecanum_prototype.sdf]
2026-08-05 fix(gazebo): run Fortress sensors with OGRE2
    [cleany_mecanum_prototype.sdf]
2026-08-06 feat(gazebo): publish static sensor frames
2026-08-06 test(gazebo): validate navigation sensors at runtime
2026-08-10 feat(moveit): add left and right arm planning configuration
    [joint_limits.yaml]
2026-08-10 test(moveit): add per-arm mock planning smoke tests
    [cleany_mock.urdf.xacro, mock_ros2_controllers.yaml]
2026-08-10 refactor(description): separate ros2 control robot description
    [cleany_control.urdf.xacro, cleany_geometry.xacro, cleany_mock.urdf.xacro]
2026-08-10 feat(handeye): add calibration data models and transform utilities
2026-08-10 feat(mujoco): add left and right arm ros2 control backend
    [cleany.xml, cleany_control.urdf.xacro, cleany_mujoco_ros2_control.xacro, handeye_ros2_controllers.yaml]
2026-08-10 feat(handeye): synchronize joint feedback and compute FK
2026-08-10 test(mujoco): verify per-arm MoveIt trajectory execution
2026-08-10 feat(mujoco): publish wrist camera data for hand-eye calibration
    [cleany_control.urdf.xacro, cleany_mujoco_ros2_control.xacro]
2026-08-10 feat(mujoco): add fixed-base hand-eye calibration scene
    [handeye_scene.yaml]
2026-08-11 feat(handeye): record synchronized calibration samples
2026-08-11 feat(handeye): orchestrate a single calibration pose
2026-08-11 build: add hand-eye calibration workflow targets
2026-08-11 feat(handeye): retain and validate calibration attempts
2026-08-11 feat(handeye): run calibration pose manifests with recovery
2026-08-19 feat(grasping): generate ranked grasp candidates
    [cleany.urdf.xacro, cleany.xml, cleany_control.urdf.xacro, cleany_mujoco_ros2_control.xacro, dual_arm.xacro, head_camera.xacro]
2026-08-19 feat(mujoco): add RGB-D grasp execution scenes
    [handeye_ros2_controllers.yaml]
2026-08-20 fix(grasp): harden frame and scene safety contracts
    [grasp_selection.yaml, grasp_selection_node.py, planning_scene.py]
2026-08-20 feat(description): add camera and grasp TCP frames
    [cleany.xml, cleany_geometry.xacro, dual_arm.xacro, head_camera.xacro]
2026-08-20 feat(sim): add RGB-D pick-demo scene and sensor bridge
    지정된 테이블 치수와 고정 상자·캔을 포함한 반복 가능한 pick-demo 장면을 추가한다.
    EGL 단일 draw renderer로 정렬된 640x480 RGB·미터 단위 depth·CameraInfo를 발행하고, base_link 기준 객체 OBB ground truth를 평가 전용 토픽으로 제공한다.
    별도 RGB-D 노드와 launch, ROS 인터페이스 의존성, 실행 문서 및 장면·렌더링·토픽 계약 테스트를 함께 추가한다.
2026-08-20 feat(gazebo): add selectable sensor profiles
    [cleany_mecanum_harmonic.sdf, cleany_mecanum_prototype.sdf]
2026-08-20 test(gazebo): cover sensor profile workloads
2026-08-20 feat(gazebo): add multi-height lidar profiles
    [cleany_mecanum_harmonic.sdf, cleany_mecanum_prototype.sdf]
2026-08-20 feat(gazebo): add repeatable ground-truth route
2026-08-20 fix(gazebo): reconcile sensor and SLAM profiles
2026-08-20 fix(gazebo): hold arms in folded standby pose
    [cleany_mecanum_harmonic.sdf, cleany_mecanum_prototype.sdf]
2026-08-20 feat(gazebo): complete multi-height SLAM evaluation
    Add isolated LiDAR bridge profiles, strict loop-closure overrides, the repeatable study-cafe route, and RViz marker visualization. Remove the unused Husarion office submodule and integration.
2026-08-20 feat(gazebo): parameterize lidar mount profiles
    [cleany_mecanum_fortress.sdf, cleany_mecanum_harmonic.sdf]
2026-08-24 fix(mujoco): support 3.12 joint type enums
2026-08-24 fix(gazebo): support Fortress odometry fallback
    [cleany_mecanum_fortress.sdf]
2026-08-25 refactor(gazebo): remove Jazzy support
    [cleany_mecanum_harmonic.sdf]
2026-08-31 feat(motor-controller): add PCB and hardware test project
    [motor_controller.kicad_pcb, motor_controller.kicad_sch]
2026-09-02 refactor(motor-controller): organize PCB design files
    [motor_controller.kicad_pcb, motor_controller.kicad_sch]
2026-09-02 feat(motor-controller): add mecanum control POC
2026-09-09 feat(motor-controller): add closed-loop wheel control and calibration
2026-09-09 feat(motor-controller): add binary Jetson serial protocol
2026-09-12 fix(motor-controller): prevent PI reverse windup
    [wheel_velocity_controller.hpp, wheel_velocity_controller_test.cpp]
2026-09-17 docs(lidar): add noise calibration brief
2026-09-17 feat(gazebo): add LiDAR noise profiles
2026-09-17 fix(gazebo): stabilize study cafe route turns
    [study_cafe_route.yaml]
2026-09-17 fix(gazebo): support Harmonic sensor plugin namespace
2026-09-17 Revert "refactor(gazebo): remove Jazzy support"
    This reverts commit 108056a85015685142840ea0bc36530928450b64.
    [cleany_mecanum_harmonic.sdf]
2026-09-17 feat(odometry): add simulated wheel odometry pipeline
2026-09-17 fix(gazebo): stabilize joint-state bridges across worlds
    [cleany_mecanum_fortress.sdf, cleany_mecanum_harmonic.sdf]
2026-09-17 feat(odometry): add configurable synthetic increment errors
    [odometry_error_ideal.yaml, odometry_error_level1.yaml, odometry_error_level2.yaml, odometry_error_stress.yaml]
2026-09-17 feat(slam): automate lidar noise comparison
2026-09-17 feat(slam): automate four-level wheel odometry evaluation
2026-09-17 feat(slam): add 30 cm lidar comparison workflow
2026-09-17 fix(rviz): use height-independent LiDAR display name
2026-09-17 feat(navigation): checkpoint CAD geometry and costmap safety evaluation
    [035armbase_step__êäèë4.stl, cleany.urdf.xacro, cleany.xml, cleany_geometry.xacro, dual_arm.xacro, fl_upright.stl, fr_upright.stl, front_inner_lower_cross_rail.stl]
2026-09-17 feat(gazebo): preserve measured 30cm LiDAR evaluation map
2026-09-17 test(handeye): remeasure single-pose evidence for CAD model
2026-09-28 feat(telemetry): relay ROS odometry over WebSocket at 5Hz
2026-09-28 feat(telemetry): relay optional odometry yaw
2026-09-28 docs(telemetry): describe optional yaw in workspace guide
2026-09-28 feat(description): align MoveIt and MuJoCo with CAD chassis
2026-09-28 refactor(esp32): organize firmware tests and PCB assets
    [motor_controller.kicad_pcb, motor_controller.kicad_sch]
2026-09-30 feat(base): integrate pinned Humble micro-ROS build and wheel interfaces
2026-09-30 feat(motor): add bounded native USB stream transport and mode contract
2026-09-30 fix(build): regenerate micro-ROS CMake cache on target switches
2026-09-30 feat(motor): integrate native USB micro-ROS with independent safe control
2026-09-30 feat(base): add safe Humble driver and device-free odometry integration
    [base_hardware.yaml]
2026-09-30 refactor(motor): retain only micro-ROS and motor control runtime
2026-09-30 refactor(gazebo): delegate navigation to the common runtime
    SCRUM-425: retain simulator adapters and compatibility imports, separate measured pan TF, and reuse common navigation profiles in evaluation. Add a CAD saved-map goal regression for the full safety pipeline.
2026-10-01 refactor(base): replace session handshake with ENABLE/STOP
    [main.cpp, wheel_command_gate.hpp]
2026-10-01 feat(sim): integrate MuJoCo study-cafe perception and sorting
    Consolidate the validated simulation changes on main while preserving the resolved model, perception and navigation integration. Exclude KB and the manipulation Action server implementation.
    [cleany.xml, cleany_control.urdf.xacro, cleany_geometry.xacro, cleany_mujoco_ros2_control.xacro, handeye_ros2_controllers.yaml, head_camera.xacro, physical_properties.xacro, plugins.xml]
2026-10-01 feat(base): configure lifted-wheel hardware limits
    [base_hardware.yaml]
2026-10-01 feat(base): add wheel plots and diagnostics presets
2026-10-01 feat(motor): apply calibrated per-wheel PI and feedforward
2026-10-02 fix(navigation): filter depth surface noise around parked arms
    SCRUM-425: add a configurable 1 mm self-filter margin. A recorded Gazebo lateral pan produced 69 arm surface points 0.015-0.146 mm outside the CAD bounds; replay removes these while retaining external observations. Verify both depth encodings on Humble and Jazzy.
2026-10-02 fix(gazebo): support Fortress CAD and Humble route evaluation
2026-10-02 fix(gazebo): match head camera projection to D435 field of view
2026-10-02 fix(sim): optimize MuJoCo rendering and recover wrist detection misses
    [cleany.xml, cleany_control.urdf.xacro, cleany_geometry.xacro, cleany_mujoco_ros2_control.xacro, physical_properties.xacro, study_cafe_ros2_controllers.yaml]
2026-10-02 fix(navigation): exclude floor from depth marking and tilt camera 20 degrees
2026-10-02 fix(sim): remove unused code and support MuJoCo camera API variants
2026-10-02 fix(description): stabilize base inertia parity across MuJoCo versions
    [physical_properties.xacro]
2026-10-02 fix(gazebo): bound feedback rates and avoid sensor GPU readback stalls
2026-10-02 feat(description): adopt canonical CAD frame robot model
2026-10-02 feat(gazebo): add full facility with CAD robot and ROLY furniture
2026-10-02 fix(gazebo): preserve body-fixed mecanum friction frames in SDF
2026-10-02 fix(gazebo): pull study cafe chairs 10 cm toward desks
2026-10-03 fix(vision): externalize license identity and document runtime limits
    [sorting_coordinator.py]
2026-10-03 feat(navigation): restore holonomic motion with camera tracking and armless Gazebo model
2026-10-03 fix(navigation): replan immediately and resume from fresh camera depth
2026-10-03 fix(integration): align facility launch and validation with current runtimes
2026-10-04 fix(sim): stabilize wheel velocity and RGB-D runtime contracts
2026-10-04 refactor(runtime): remove unused code paths
    - drop the synchronous mission prototype (manager/models/ports/states,
    mocks/components) and its test; MissionRuntime is the only caller-facing
    FSM, so the READMEs now describe that one
    - remove gazebo world helpers with no caller and ROLY chair parts whose
    output was discarded; generated worlds are byte-identical
    - remove unreferenced constants, imports, unreachable branches and
    write-only state in navigation, base driver, telemetry and the monitor
2026-10-04 refactor(navigation): share repeated geometry and transport helpers
    - depth clearance builds both clouds with point_cloud.xyz_cloud
    - BodyBox.corners, transforms.stamp, localization_jumped and
    rectified_intrinsics replace per-node copies
    - planner footprint pose check and holonomic direction candidates are
    each defined once
2026-10-04 refactor(sim,base): share robot launch nodes and collapse repeated state
    - Fortress and Harmonic launches take the command guard, odometry chain
    and sensor TF nodes from launch_helpers.robot_nodes; the launch contract
    test now evaluates the descriptions instead of matching source text
    - sdf physics overrides, mecanum body displacement, mock MCU disarm and
    the driver's feedback receipt time each have a single definition
2026-10-08 perf(navigation): reduce depth filtering and obstacle projection cost
2026-10-08 fix(navigation): calibrate ideal simulation localization and tighten arrival
2026-10-08 fix(handeye): certify convex clearance and stabilize camera fixture
2026-10-08 docs: record initial parallel capacity evidence and remaining scenarios
2026-10-08 docs: update repeated capacity evidence and full survey scheduling
2026-10-08 docs: record verified parallel capacity boundary under unchanged deadlines
2026-10-08 feat(navigation): search continuous-footprint body heading grid
2026-10-08 test(navigation): exercise off-grid endpoint heading connectors
2026-10-08 fix(navigation): distinguish continuous path progress on scoring plateaus
2026-10-08 docs(validation): distinguish reactive authority and scoring plateau evidence
2026-10-09 fix(odometry): support measured simulation yaw calibration
2026-10-09 refactor: 데이터와 빌드 출력을 외부 경로로 분리
2026-10-09 chore: 과거 검증 자료와 실험 도구를 외부 보관소로 이관
2026-10-09 fix: 검사 로그도 외부 빌드 경로에 보관
2026-10-09 docs: 외부 데이터 이관 후 빌드와 Gazebo 검증 기록
2026-10-13 refactor: Gazebo 레거시 호환 계층과 실험 실행 코드 분리
2026-10-13 test: 실행 계약과 무관한 소스 문자열 검사 정리
2026-10-13 docs: 레거시 정리 브랜치 검증과 독립 fixture 기록
2026-10-13 refactor: Gazebo Fortress 단일화 및 gazebo_profile 도구 정리
2026-10-13 refactor: 검증 코드와 개발 도구를 역할별로 재배치
    Move runtime validation and support modules into tests, and package facility generators with cleany_gazebo_sim. Update installation, dependencies, Make targets and documentation.
    Fix immutable micro-ROS clone handling at the component root and reject protected ancestors in ROS build cleanup, with regression coverage.
2026-10-13 refactor(esp32): micro-ROS 준비 도구와 테스트를 펌웨어에 배치
2026-10-13 docs: 문서를 작업별 가이드와 코드 계약으로 재구성
2026-10-13 docs: 설정 안내 중복 제거와 odometry 관측 조건 보완
2026-10-13 docs: 문서 경계가 정리된 KB revision 반영
2026-10-13 docs: robot interface scaffold의 역할과 위치 복원
2026-10-13 docs: 실행과 연동 문서를 Mermaid 도식 중심으로 개선
2026-10-13 docs: 패키지 계약을 조건과 동작 중심 개조식으로 축약
2026-10-13 docs: 실행 가이드와 하드웨어 안내를 간결한 개조식으로 정리
2026-10-13 docs: 패키지 계약을 짧은 설명과 규격·조건 표로 정리
2026-10-13 docs: 사용 가이드를 짧은 문단과 단계·비교 표로 개선
2026-10-13 docs: Mermaid 흐름도를 보완하고 가운뎃점 나열을 제거
2026-10-13 build: MuJoCo 의존성을 공식 rosdep 키로 전환
2026-10-13 docs: ROS 노드별 인터페이스 표와 중앙 색인 추가
2026-10-13 fix: runtime-integration 리베이스 후 문서 경로와 의존성 안내 보완
2026-10-13 refactor: 루트 테스트와 검증 실행 도구의 책임 분리
2026-10-13 feat(calibration): add guarded wheel and odometry evaluation
    Apply ground-loaded wheel gains, asymmetric command slew, and effective mecanum separation. Add shared motion guards, LiDAR/manual evaluation, wheel tracking diagnostics, configuration baselines, and portable usage documentation.
    Validation: 92 tooling/showcase pytest tests; 77 base pytest tests; make test-motor-core; make test-base; make firmware-build; shellcheck and CLI help checks.
2026-10-13 style: 도구 코드 가독성 개선과 실행 의도 주석 추가
2026-10-13 feat(manipulation): add standalone Mock and MuJoCo Action servers
    Execute one approved object collection with feedback, cancellation modes,
    execution lookup, durable records and interruption recovery. Add the native
    BehaviorTree.CPP worker, target tracking and individual placement verification.
    Keep current simulation camera and wrist recovery behavior, with Action-only
    payload fit checks and guarded feedback waits. Document the server contracts,
    execution commands and the remaining Mission Manager integration boundary.
2026-10-13 fix(manipulation): ignore identical joint feedback deliveries
2026-10-14 feat(calibration): add calibrated one-way evaluation plot generator
    Plot surge, sway, and rotation results from the recorded one-way evaluation summary with LiDAR yaw correction.
    Validation: Python syntax check passed. Plot execution requires numpy, matplotlib, and the referenced evaluation JSON, which are absent from the current environment.
2026-10-14 docs: tighten tool comments and use concise English
    Replace useful Korean annotations with verified English contracts, remove obvious narration, and document the safety probe interfaces. Preserve the existing worktree-only spacing change.
    Validation: 53 tool tests passed; Python AST and shell non-comment content match the pre-edit baseline.
2026-10-14 feat(imu): add dual-core MPU6050 calibration diagnostic
    Add fixed-range sample decoding, online gyro bias and covariance estimation, independent validation, and failure gates with device-free C++ tests.
    Add a standalone ESP32-S3 diagnostic with nonblocking cross-core queues, USB JSON results, authoritative configuration, and guarded build/upload targets.
    Validation: eight C++ test executables and the ESP32-S3 PlatformIO build passed. Acceptance limits remain unreviewed by default.
2026-10-14 feat(imu): add bench capture tooling and serial reset protection
    Add bounded USB JSON capture, fresh-run nonce correlation, atomic report saving, and atomic POSIX DTR/RTS updates that preserve the ESP32-S3 timebase.
    Add capture/configuration regression tests, Make capture/test targets, and diagnostic usage and bench measurement documentation.
    Validation: eight C++ executables, 29 calibration Python tests, and eight setup regression tests passed. Six measurement-only bench acquisitions completed; retained results survived two serial reconnects.
2026-10-15 refactor: 검증 도구와 base 설정 정리 및 CI 복구
2026-10-15 refactor(gazebo): Harmonic 지원 제거와 Fortress 실행 단일화
2026-10-16 feat(logger): decouple recording from dashboard and add CLI
    대시보드의 녹화 기능을 독립 cleany_logger 노드로 분리합니다.
    ROS 메시지 원문은 rosbag2, 가공 데이터와 조회 index는 SQLite에 저장합니다.
    CLI에서 녹화 시작과 정지, 상태 조회와 토픽 설정을 지원합니다.
    대시보드 종료 후에도 같은 세션을 기록하도록 저장 수명을 분리합니다.
    Refs: SCRUM-486
2026-10-20 docs: ROS 토픽 액션 서비스 통합 목록 추가
2026-10-20 fix(ci): runtime 의존성의 pytest 플러그인 자동 로드 차단
2026-10-20 fix(ci): MuJoCo 공통 배치 동기화와 실패 상세 출력
2026-10-20 feat(description): reflect physical head mount and calibrated camera frames
2026-10-20 docs: record calibration model validation and baseline failure
2026-10-20 fix(description): keep Jetson mount consistent across simulators
2026-10-20 docs: record simulator mount regression checks
2026-10-21 fix(odometry): correct ICP Jacobians and detect bounded pose cycles
2026-10-21 feat(odometry): replay saved scans with calibrated SE2 guesses
    Verify 87 stored registrations at 30% minimum inliers: retain all 79 previously valid matches, recover four nonconvergent and three low-inlier matches, and preserve one rejection. Full evaluation suite: 267 passed.
2026-10-21 feat(odometry): checkpoint guarded all-axis physical validation
    Add config-driven wheel-only and P-response evaluation, calibrated laser/base guesses, axis gains, readiness/cleanup guards and regression tests. Expose ICP convergence settings and preserve snapshots and raw scans.
    Validation: 267 tests passed; dry-run confirms 90 planned legs. Physical run 20261021_163717 completed 45 round trips and 90 legs, with all 135 ICP registrations valid (133 strict-step, 2 bounded-cycle). STOP/disable and owned-process cleanup verified.
2026-10-21 test(odometry): assert expected motion gains
2026-10-21 feat(imu): add MCU boot calibration and ROS gyro relay
2026-10-21 feat(description): apply Jetson v8 wrist camera mounts
2026-10-21 docs: record wrist mount validation evidence
2026-10-21 fix(simulation): align wrist cameras with v8 mounts
2026-10-21 test(base): serialize synthetic IMU callbacks for stable timing
2026-10-21 test(monitor): remove resource sampler timing from camera assertions
2026-10-23 feat(skill-executor): report arm controller availability to the Supervisor
    Availability only: whether the base may drive with the current arm state stays
    with the manipulation outcome (safe_to_drive) checked by the Mission Runtime.
2026-10-23 feat(supervisor): align supervision with the Mission Runtime
    Move policy into the package config, match Nav2 lifecycle nodes with the Runtime,
    drop arm travel posture (Runtime safe_to_drive owns it) and the JSONL event file
    (cleany_logger records events), retry stop dispatch within the stop deadline,
    add the supervision launch, end-to-end tests against mission_runtime and package
    docs following the current documentation rules.
2026-10-29 feat(jetson): add physical control foundation and isolated validation
    Add Feetech state/control, calibrated profiles and camera interfaces with
    read-only defaults, stop handling and portable PTY controller coverage.
    Connect physical MoveIt profiles to PR64's guarded SolidFCL detector;
    leave batch planning, TCP replay and collection policies for later PRs.
    Share native install paths and source verification, and keep generated
    guide HTML and historical runtime reports outside Git.
    Validation: seven packages built in an isolated install; 429 Python tests
    passed (three optional LeRobot modules skipped), 155 native/model/MoveIt
    cases and 21 PTY controller cases passed. Current-main and PR64 merg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
2026-10-29 chore(jetson): narrow foundation scope and consolidate control tests
    Defer TCP calibration helpers and optional LeRobot commissioning tools.
    Parameterize arm torque regressions and reuse the generated control profile.
    Scope isolated build/test targets and documentation to the remaining foundation.
    Validation: fresh six-package build; 163 tests passed with no skips.
2026-10-30 perf(manipulation): reuse measured FK for unchanged joint state
2026-10-30 feat(display): add Jetson ROS face kiosk
2026-11-01 fix(mapping): prepare external driver dependencies and CI UI build
2026-11-02 test(tof): wait for received sensor and lease before desk goals
2026-11-02 fix(ci): pin dependencies to the Jetson baseline
2026-11-04 feat(description): add FreeCAD assembly and kinematic previews
2026-11-04 fix(description): share CAD meshes and clean superseded exports
2026-11-04 feat(description): isolate CAD reference topics for Jetson deployment
2026-11-04 fix(bringup): align CAD LiDAR position with confirmed robot front
2026-11-05 Record perception merge validation on Jetson
2026-11-05 feat(description): refine FreeCAD collision and wrist camera geometry
    Use the measured wrist camera depth on both arms and refine the CAD link ownership. Prepare optimized MoveIt collision geometry that preserves the gripper contact surfaces and aperture.
    Add isolated MoveIt and OctoMap inspection, cuRobo cache validation, and Jetson verification evidence.
2026-11-05 feat(camera): initialize DECXIN orientation on Jetson USB connect
2026-11-11 docs: record CAD and calibration PR verification
2026-11-11 test: align gripper execution with current calibration
2026-11-11 fix: restore evidence compatibility and calibrated gripper tests
